fairecasoimeme/Zlinky_TIC/ZLinky/SDK_2_6_4_JN5189DK6/boards/jn5189dk6/demo_apps/hello_world/readme.txt

Overview
========
The Hello World demo application provides a sanity check for the new SDK build environments and board bring up. The Hello
World demo prints the "Hello World" string to the terminal using the SDK UART drivers. The purpose of this demo is to
show how to use the UART, and to provide a simple project for debugging and further development.

Toolchain supported
===================
- IAR embedded Workbench  8.50.6
- MCUXpresso  11.3.0

Hardware requirements
=====================
- Mini USB cable
- OM15076-3 Carrier Board
- JN518x Module plugged on the Carrier Board
- Personal Computer

Board settings
==============
No special settings are required.

Prepare the Demo
================
1.  Connect a mini USB cable between the PC host and the USB port (J15) on the board.
2.  Open a serial terminal with the following settings:
    - 115200 baud rate
    - 8 data bits
    - No parity
    - One stop bit
    - No flow control
3.  Download the program to the target board.
4.  Reset the SoC and run the project.

Running the demo
================
The following lines are printed to the serial terminal when the demo program is executed.
~~~~~~~~~~~~~~~~~~~~~~~~~~~~~~~~~~~~~~~~
hello world.
~~~~~~~~~~~~~~~~~~~~~~~~~~~~~~~~~~~~~~~~

Customization options
=====================
