fairecasoimeme/Zlinky_TIC/ZLinky/SDK_2_6_4_JN5189DK6/boards/jn5189dk6/demo_apps/led_blinky/readme.txt

Overview
========
The LED Blinky demo application provides a sanity check for the new SDK build environments and board bring up. The LED Blinky demo 
uses the systick interrupt to realize the function of timing delay. The example takes turns to shine the LED. The purpose of this 
demo is to provide a simple project for debugging and further development.

Toolchain supported
===================
- IAR embedded Workbench  8.50.6
- MCUXpresso  11.3.0

Hardware requirements
=====================
- Mini USB cable
- OM15076-3 Carrier Board
- OM15082-2 Board plugged on the Carrier Board
- JN518x Module plugged on the Carrier Board
- Personal Computer

Board settings
==============
No special settings are required.

Prepare the Demo
================
1.  Connect a mini USB cable between the PC host and the USB port (J15) on the board.
2.  Open a serial terminal with the following settings:
    - 115200 baud rate
    - 8 data bits
    - No parity
    - One stop bit
    - No flow control
3.  Plug the OM15082-2 Expansion Board onto the Carrier Board.
4.  Download the program to the target board.
5.  Either press the reset button on your board or launch the debugger in your IDE to begin running the demo.

Running the demo
================
When the demo program is executed, the LED DS3 will start flashing.

Customization options
=====================
