fairecasoimeme/Zlinky_TIC/ZLinky/SDK_2_6_4_JN5189DK6/boards/jn5189dk6/driver_examples/cic_irb/readme.txt

Overview
========

The IRB Example project is a demonstration program that uses the Infra-Red Blaster (IRB) peripheral software.
It performs a sequence of sending packets.

Toolchain supported
===================
- IAR embedded Workbench  8.50.6
- MCUXpresso  11.3.0

Hardware requirements
=====================
- Mini USB cable
- OM15076-3 Carrier Board
- JN518x Module plugged on the Carrier Board
- Personal Computer

Board settings
==============
No special settings are required.

Prepare the Demo
================
1.  Connect a mini USB cable between the PC host and the USB port (J15) on the board.
2.  Open a serial terminal with the following settings:
    - 115200 baud rate
    - 8 data bits
    - No parity
    - One stop bit
    - No flow control
3.  Download the program to the target board.
4.  Reset the SoC and run the project.

Running the demo
================
The log below shows example output of the IRB example in the terminal window:
~~~~~~~~~~~~~~~~~~~~~~~~~~~~~~~~~~~~~~~~
IR Blaster example
Sending 10 RC-5 packets...
Packet 1
Packet 2
Packet 3
Packet 4
Packet 5
Packet 6
Packet 7
Packet 8
Packet 9
Packet 10
Bye.
~~~~~~~~~~~~~~~~~~~~~~~~~~~~~~~~~~~~~~~~

Customization options
=====================
