fairecasoimeme/Zlinky_TIC/ZLinky/SDK_2_6_4_JN5189DK6/boards/jn5189dk6/driver_examples/flash/readme.txt

Overview
========
The Flash Example project is to demonstrate usage of the Flash driver.
In this example, we test the flash features: Initialization, erase and programming

Toolchain supported
===================
- IAR embedded Workbench  8.50.6
- MCUXpresso  11.3.0

Hardware requirements
=====================
- Mini USB cable
- OM15076-3 Carrier Board
- JN518x Module plugged on the Carrier Board
- Personal Computer

Board settings
==============
No special settings are required.

Prepare the Demo
================
1.  Connect a mini USB cable between the PC host and the USB port (J15) on the board.
2.  Open a serial terminal with the following settings:
    - 115200 baud rate
    - 8 data bits
    - No parity
    - One stop bit
    - No flow control
3.  Download the program to the target board.
4.  Either press the reset button on your board or launch the debugger in your IDE to begin running the demo.

Running the demo
================
The log below shows example output of the flash_demo driver example in the terminal window:
~~~~~~~~~~~~~~~~~~~~~~~~~~~~~~~~~~~
Internal Flash Test
Flash initialised
Flash erased
Programming 128 words
Flash programmed 128 words
512 bytes verified successfully via direct flash read
512 bytes verified successfully via API flash read
~~~~~~~~~~~~~~~~~~~~~~~~~~~~~~~~~~~

Customization options
=====================
