fairecasoimeme/Zlinky_TIC/ZLinky/SDK_2_6_4_JN5189DK6/boards/jn5189dk6/driver_examples/rtc/readme.txt

Overview
========
The RTC project is a simple demonstration program of the SDK RTC driver. It sets up the RTC
hardware block to trigger an alarm after a user specified time period. The test will set the current
date and time to a predefined value. The alarm will be set with reference to this predefined date
and time.

Toolchain supported
===================
- IAR embedded Workbench  8.50.6
- MCUXpresso  11.3.0

Hardware requirements
=====================
- Mini USB cable
- OM15076-3 Carrier Board
- JN518x Module plugged on the Carrier Board
- Personal Computer

Board settings
==============
No special settings are required.

Prepare the Demo
================
1.  Connect a mini USB cable between the PC host and the USB port (J15) on the board.
2.  Open a serial terminal with the following settings:
    - 115200 baud rate
    - 8 data bits
    - No parity
    - One stop bit
    - No flow control
3.  Download the program to the target board.
4.  Either press the reset button on your board or launch the debugger in your IDE to begin running the demo.

Running the demo
================
The log below shows example output of the RTC driver demo in the terminal window:
~~~~~~~~~~~~~~~~~~~~~~~~~~~~~~~~~~~
RTC example: set up time to wake up an alarm
Current datetime: 2014-12-25 19: 0: 0
Please input the number of second to wait for alarm
The second must be positive value
Alarm will occur at: 2014-12-25 19: 0:40

 Alarm occurs !!!! Current datetime: 2014-12-25 19: 0:41
Please input the number of second to wait for alarm
The second must be positive value

~~~~~~~~~~~~~~~~~~~~~~~~~~~~~~~~~~~

Customization options
=====================
