fairecasoimeme/Zlinky_TIC/ZLinky/SDK_2_6_4_JN5189DK6/boards/jn5189dk6/rtos_examples/freertos_event/readme.txt

Overview
========
This document explains the freertos_event example. It shows how task waits for an event (defined set
of bits in event group). This event can be set by any other process or interrupt in the system.

The example application creates three tasks. Two write tasks write_task_1 and write_task_2
continuously setting event bit 0 and bit 1.

Read_task is waiting for any event bit and printing actual state on console. Event bits are
automatically cleared after read task is entered.

Three possible states can occurre:
Both bits are set.z
Bit B0 is set.
Bit B1 is set.

Toolchain supported
===================
- IAR embedded Workbench  8.50.6
- MCUXpresso  11.3.0

Hardware requirements
=====================
- Mini USB cable
- OM15076-3 Carrier Board
- JN518x Module plugged on the Carrier Board
- Personal Computer

Board settings
==============
No special settings are required.

Prepare the Demo
================
1.  Connect a mini USB cable between the PC host and the USB port (J15) on the board.
2.  Open a serial terminal with the following settings:
    - 115200 baud rate
    - 8 data bits
    - No parity
    - One stop bit
    - No flow control
3.  Download the program to the target board.
4.  Reset the SoC and run the project.

Running the demo
================
After the board is flashed the Tera Term will start printing the state of event bits.

Example output:
Bit B1 is set.
Bit B0 is set.
Bit B1 is set.
Bit B0 is set.
Bit B1 is set

Customization options
=====================
