fairecasoimeme/Zlinky_TIC/ZLinky/SDK_2_6_4_JN5189DK6/boards/jn5189dk6/rtos_examples/freertos_generic/readme.txt

Overview
========

This document explains the freertos_generic example. It is based on code FreeRTOS documentation from
http://www.freertos.org/Hardware-independent-RTOS-example.html. It shows combination of several
tasks with queue, software timer, tick hook and semaphore.

The example application creates three tasks. The prvQueueSendTask periodically sending data to
xQueue queue. The prvQueueReceiveTask is waiting for incoming message and counting number of
received messages. Task prvEventSemaphoreTask is waiting for xEventSemaphore semaphore given from
vApplicationTickHook. Tick hook give semaphore every 500 ms.

Other hook types used for RTOS and resource statistics are also demonstrated in example:
* vApplicationIdleHook
* vApplicationStackOverflowHook
* vApplicationMallocFailedHook

Toolchain supported
===================
- IAR embedded Workbench  8.50.6
- MCUXpresso  11.3.0

Hardware requirements
=====================
- Mini USB cable
- OM15076-3 Carrier Board
- JN518x Module plugged on the Carrier Board
- Personal Computer

Board settings
==============
No special settings are required.

Prepare the Demo
================
1.  Connect a mini USB cable between the PC host and the USB port (J15) on the board.
2.  Open a serial terminal with the following settings:
    - 115200 baud rate
    - 8 data bits
    - No parity
    - One stop bit
    - No flow control
3.  Download the program to the target board.
4.  Reset the SoC and run the project.

Running the demo
================
After the board is flashed the Tera Term will start periodically printing the state of generic example.

Example output:
Event task is running.
Receive message counter: 1.
Receive message counter: 2.
Receive message counter: 3.
Receive message counter: 4.
Receive message counter: 5.
Receive message counter: 6.
Receive message counter: 7.
Receive message counter: 8.
Receive message counter: 9.
Receive message counter: 10.
Receive message counter: 11.
Receive message counter: 12.
Event task is running.
Receive message counter: 13.
Receive message counter: 14.
...

Customization options
=====================
