fairecasoimeme/Zlinky_TIC/ZLinky/SDK_2_6_4_JN5189DK6/boards/jn5189dk6/rtos_examples/freertos_hello/readme.txt

Overview
========
The Hello World project is a simple demonstration program that uses the SDK UART driver in
combination with FreeRTOS. The purpose of this demo is to show how to use the debug console and to
provide a simple project for debugging and further development.

The example application creates one task called hello_task. This task print "Hello world." message
via debug console utility and suspend itself.

Toolchain supported
===================
- IAR embedded Workbench  8.50.6
- MCUXpresso  11.3.0

Hardware requirements
=====================
- Mini USB cable
- OM15076-3 Carrier Board
- JN518x Module plugged on the Carrier Board
- Personal Computer

Board settings
==============
No special settings are required.

Prepare the Demo
================
1.  Connect a mini USB cable between the PC host and the USB port (J15) on the board.
2.  Open a serial terminal with the following settings:
    - 115200 baud rate
    - 8 data bits
    - No parity
    - One stop bit
    - No flow control
3.  Download the program to the target board.
4.  Reset the SoC and run the project.

Running the demo
================
After the board is flashed the Tera Term will print "Hello world" message on terminal.

Example output:
Hello world.

Customization options
=====================
