fairecasoimeme/Zlinky_TIC/ZLinky/SDK_2_6_4_JN5189DK6/boards/jn5189dk6/rtos_examples/freertos_queue/readme.txt

Overview
========

This document explains the freertos_queue example. This example introduce simple logging mechanism
based on message passing.

Example could be divided in two parts. First part is logger. It contain three tasks:
log_add().....Add new message into the log. Call xQueueSend function to pass new message into
              message queue.
log_init()....Initialize logger (create logging task and message queue log_queue).
log_task()....Task responsible for printing of log output.

Second part is application of this simple logging mechanism. Each of two tasks write_task_1 and
write_task_2 print 5 messages into log.

Toolchain supported
===================
- IAR embedded Workbench  8.50.6
- MCUXpresso  11.3.0

Hardware requirements
=====================
- Mini USB cable
- OM15076-3 Carrier Board
- JN518x Module plugged on the Carrier Board
- Personal Computer

Board settings
==============
No special settings are required.

Prepare the Demo
================
1.  Connect a mini USB cable between the PC host and the USB port (J15) on the board.
2.  Open a serial terminal with the following settings:
    - 115200 baud rate
    - 8 data bits
    - No parity
    - One stop bit
    - No flow control
3.  Download the program to the target board.
4.  Reset the SoC and run the project.

Running the demo
================
After the board is flashed the Tera Term will show debug console output.

Example output:
Log 0: Task1 Message 0
Log 1: Task2 Message 0
Log 2: Task1 Message 1
Log 3: Task2 Message 1
Log 4: Task1 Message 2
Log 5: Task2 Message 2
Log 6: Task1 Message 3
Log 7: Task2 Message 3
Log 8: Task1 Message 4
Log 9: Task2 Message 4

Customization options
=====================
