fairecasoimeme/Zlinky_TIC/ZLinky/SDK_2_6_4_JN5189DK6/boards/jn5189dk6/driver_examples/usart/hardware_flow_control/readme.txt

Overview
========
The usart_hardware_flow_control example project demonstrates the usage
of the hardware flow control function. This example sends data to itself(loopback),
and hardware flow control is enabled in the example. The CTS(clear-to-send)
pin is for transmiter to check if receiver is ready, if the CTS pin is asserted,
transmiter starts to send data. The RTS(request-to-send) pin is for receiver
to inform the transmiter if receiver is ready to receive data. So, please connect
RTS to CTS pin directly.

Toolchain supported
===================
- IAR embedded Workbench  8.50.6
- MCUXpresso  11.3.0

Hardware requirements
=====================
- Mini USB cable
- OM15076-3 Carrier Board
- JN518x Module plugged on the Carrier Board
- Personal Computer
- USB-TTL interface module

Board settings
==============
USART hardware flow control on one board.
The USART sends data to itself(loopback), and hardware flow control function is
enabled on this example. So please make sure the correct connection for example.
~~~~~~~~~~~~~~~~~~~~~~~~~~~~~~~~~~~~~~~~~~~~~~~~~~~~~~~~~~~~~~~~~~~~~~~~~~~~~~~~~~~~~~~~~
Pin Name    Board Location    connect to     Pin Name    Board Location
USART_TX    J3   Pin 10       ----------     USART_RX    J3   pin 9
USART_CTS   J3   Pin 14       ----------     USART_RTS   J3   Pin 13
~~~~~~~~~~~~~~~~~~~~~~~~~~~~~~~~~~~~~~~~~~~~~~~~~~~~~~~~~~~~~~~~~~~~~~~~~~~~~~~~~~~~~~~~~

Prepare the Demo
================
1.  Connect a mini USB cable between the PC host and the USB port (J15) on the board.
2.  Connect Dupont Lines between USB-TTL interface module and the board, the line connections are:
USB-TTL RXD connects to CN1-5, USB-TTL TXD connects to CN1-6.
3.  Open a serial terminal to USB-TTL port with the following settings:
    - 115200 baud rate
    - 8 data bits
    - No parity
    - One stop bit
    - No flow control
4.  Download the program to the target board.
5.  Reset the SoC and run the project.

Running the demo
================
The following lines are printed to the serial terminal when the demo program is executed.

~~~~~~~~~~~~~~~~~~~~~~~~~~~~~~~~~~~~~~~~
This is USART hardware flow control example on one board.
This example will send data to itself and will use hardware flow control to avoid the overflow.
Please make sure you make the correct line connection. Basically, the connection is:
      USART_TX    --     USART_RX
      USART_RTS   --     USART_CTS
Data matched! Transfer successfully.
~~~~~~~~~~~~~~~~~~~~~~~~~~~~~~~~~~~~~~~~
Customization options
=====================
