fairecasoimeme/Zlinky_TIC/ZLinky/SDK_2_6_4_JN5189DK6/boards/jn5189dk6/driver_examples/ctimer/simple_match_interrupt/readme.txt

Overview
========
The Simple Match Interrupt project is to demonstrate usage of the SDK CTimer driver with interrupt callback functions
In this example the upon match and IO pin connected to the LED is toggled and the timer is reset, so it would generate a square wave.
With an interrupt callback the match value is changed frequently in such a way that the frequency of the output square wave is increased gradually.

Toolchain supported
===================
- IAR embedded Workbench  8.50.6
- MCUXpresso  11.3.0

Hardware requirements
=====================
- Mini USB cable
- OM15076-3 Carrier Board
- JN518x Module plugged on the Carrier Board
- Personal Computer

Board settings
==============
No special settings are required.

Prepare the Demo
================
1.  Connect a mini USB cable between the PC host and the USB port (J15) on the board.
2.  Open a serial terminal with the following settings:
    - 115200 baud rate
    - 8 data bits
    - No parity
    - One stop bit
    - No flow control
3.  Download the program to the target board.
4.  Either press the reset button on your board or launch the debugger in your IDE to begin running the demo.

Running the demo
================
The log below shows example output of the CTimer simple match demo using interrupts in the terminal window:
~~~~~~~~~~~~~~~~~~~~~~~~~~~~~~~~~~~
CTimer match example to toggle the output.
This example uses interrupt to change the match period.
~~~~~~~~~~~~~~~~~~~~~~~~~~~~~~~~~~~

Customization options
=====================
