fairecasoimeme/Zlinky_TIC/ZLinky/SDK_2_6_4_JN5189DK6/boards/jn5189dk6/driver_examples/gpio/led_output/readme.txt

Overview
========
The GPIO Example project is a demonstration program that uses the KSDK software to manipulate the general-purpose
outputs. The example use LEDs and buttons to demonstrates GPIO API for port and pin manipulation (init, set,
clear, and toggle).

Toolchain supported
===================
- IAR embedded Workbench  8.50.6
- MCUXpresso  11.3.0

Hardware requirements
=====================
- Mini USB cable
- OM15076-3 Carrier Board
- JN518x Module plugged on the Carrier Board
- Personal Computer

Board settings
==============
No special settings are required.

Prepare the Demo
================
1.  Connect a mini USB cable between the PC host and the USB port (J15) on the board.
2.  Open a serial terminal with the following settings:
    - 115200 baud rate
    - 8 data bits
    - No parity
    - One stop bit
    - No flow control
3.  Download the program to the target board.
4.  Either press the reset button on your board or launch the debugger in your IDE to begin running the demo.

Running the demo
================
The following lines are printed to the serial terminal when the demo program is executed.
Depending on the BP1 button you press the value is changing.

~~~~~~~~~~~~~~~~~~~~~~~~~~~~~~~~~~~~~~~~
 GPIO Driver example

 The LED is taking turns to shine.

 Standard port read: 257ffb

 Masked port read: 250000

 Port state: 257ff9

 Port state: 217ff1

 Port state: 25fff9

 Port state: 217ff1
 ...
~~~~~~~~~~~~~~~~~~~~~~~~~~~~~~~~~~~~~~~~
When press BP1 on OM15076-3 Carrier Board, the LED DS3 will start flashing

Customization options
=====================
