fairecasoimeme/Zlinky_TIC/ZLinky/SDK_2_6_4_JN5189DK6/boards/jn5189dk6/driver_examples/i2c/dma_transfer/readme.txt

Overview
========
The i2c_dma example shows how to use I2C driver in DMA way:

In this example , one i2c instance used as I2C master and another i2c instance used as I2C slave .
1. I2C master send data to I2C slave with DMA . (I2C Slave using interrupt to receive the data)
2. I2C master read data from I2C slave with DMA . (I2C Slave using interrupt to send the data)

Toolchain supported
===================
- IAR embedded Workbench  8.50.6
- MCUXpresso  11.3.0

Hardware requirements
=====================
- Mini USB cable
- OM15076-3 Carrier Board
- JN518x Module plugged on the Carrier Board
- Personal Computer

Board settings
==============
To make i2c example work, connections needed to be as follows:

        I2C              connected to     I2C0
SCL     PIO_6(J3 pin13)        -->        PIO_10(J3 pin17)
SDA     PIO_7(J3 pin14)        -->        PIO_11(J3 pin18)

Prepare the Demo
================
1.  Connect a mini USB cable between the PC host and the USB port (J15) on the board.
2.  Open a serial terminal with the following settings:
   - 115200 baud rate
   - 8 data bits
   - No parity
   - One stop bit
   - No flow control
3. Download the program to the target board.
4. Either press the reset button on your board or launch the debugger in your IDE to begin running
   the demo.

Running the demo
================
The following message shows in the terminal if the example runs successfully.

~~~~~~~~~~~~~~~~~~~~~~~~~~~~
I2C example -- MasterDMA_SlaveInterrupt.
Master will send data :
0x 0  0x 1  0x 2  0x 3  0x 4  0x 5  0x 6  0x 7
0x 8  0x 9  0x a  0x b  0x c  0x d  0x e  0x f
0x10  0x11  0x12  0x13  0x14  0x15  0x16  0x17
0x18  0x19  0x1a  0x1b  0x1c  0x1d  0x1e  0x1f

Slave received data :
0x 0  0x 1  0x 2  0x 3  0x 4  0x 5  0x 6  0x 7
0x 8  0x 9  0x a  0x b  0x c  0x d  0x e  0x f
0x10  0x11  0x12  0x13  0x14  0x15  0x16  0x17
0x18  0x19  0x1a  0x1b  0x1c  0x1d  0x1e  0x1f

This time , slave will send data: :
0xff  0xfe  0xfd  0xfc  0xfb  0xfa  0xf9  0xf8
0xf7  0xf6  0xf5  0xf4  0xf3  0xf2  0xf1  0xf0
0xef  0xee  0xed  0xec  0xeb  0xea  0xe9  0xe8
0xe7  0xe6  0xe5  0xe4  0xe3  0xe2  0xe1  0xe0

Master received data :
0xff  0xfe  0xfd  0xfc  0xfb  0xfa  0xf9  0xf8
0xf7  0xf6  0xf5  0xf4  0xf3  0xf2  0xf1  0xf0
0xef  0xee  0xed  0xec  0xeb  0xea  0xe9  0xe8
0xe7  0xe6  0xe5  0xe4  0xe3  0xe2  0xe1  0xe0

End of I2C example .
~~~~~~~~~~~~~~~~~~~~~~~~~~~~

Customization options
=====================
