fairecasoimeme/Zlinky_TIC/ZLinky/SDK_2_6_4_JN5189DK6/boards/jn5189dk6/driver_examples/usart/interrupt_transfer/readme.txt

Overview
========
The usart_interrupt_transfer example shows how to use usart driver in interrupt way:

In this example, one usart instance connect to PC through usart, the board will
send back all characters that PC send to the board.

Note: The example echo every 8 characters, so input 8 characters every time.

Toolchain supported
===================
- MCUXpresso  11.3.0
- IAR embedded Workbench  8.50.6

Hardware requirements
=====================
- Mini USB cable
- OM15076-3 Carrier Board
- JN518x Module plugged on the Carrier Board
- Personal Computer

Board settings
==============
No special settings are required.

Prepare the Demo
================
1.  Connect a mini USB cable between the PC host and the USB port (J15) on the board.
2.  Open a serial terminal with the following settings:
    - 115200 baud rate
    - 8 data bits
    - No parity
    - One stop bit
    - No flow control
3.  Download the program to the target board.
4.  Reset the SoC and run the project.

Running the demo
================
The following lines are printed to the serial terminal when the demo program is executed.
~~~~~~~~~~~~~~~~~~~~~~~~~~~~~~~~~~~~~~~~
Usart interrupt example
Board receives 8 characters then sends them out
Now please input:
~~~~~~~~~~~~~~~~~~~~~~~~~~~~~~~~~~~~~~~~
When you input 8 characters, system will echo it by UART and them would be seen on the terminal.

Customization options
=====================
