fairecasoimeme/Zlinky_TIC/ZLinky/SDK_2_6_4_JN5189DK6/boards/jn5189dk6/wireless_examples/zigbee/zigbee_coordinator/readme.txt

Overview
========
This application represents the "Zigbee coordinator" of the Zigbee Stack Demo Applications.

Toolchain supported
===================
- MCUXpresso IDE

Hardware requirements
=====================
- Mini/micro USB cable
- DK6 board
- Personal Computer

Board settings
==============
No special board setting.

Prepare the Demo
================
1.  Connect a mini/micro USB cable between the PC host and the OpenSDA USB port on the board.
2.  Download the program to the target board.
3.  Press the reset button, then any other switch button on your board to begin running the demo.

Running the demo
================
