fairecasoimeme/Zlinky_TIC/Doc/Images/back_linky_triphase.jpg

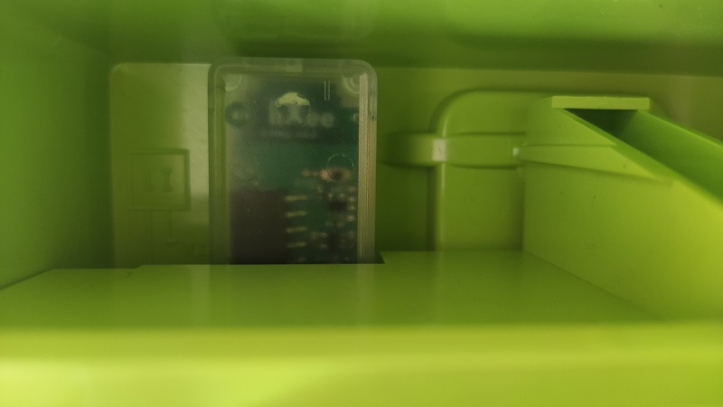
Doc/Images/back_linky_triphase.jpg
