fairecasoimeme/Zlinky_TIC/Doc/Images/front_linky_triphase.jpg

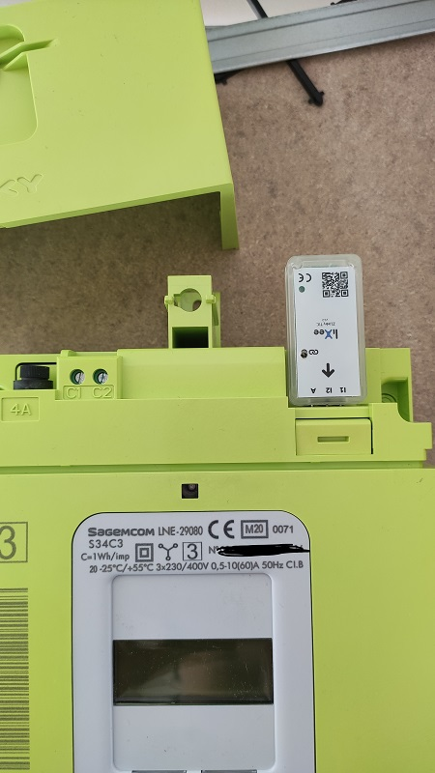
Doc/Images/front_linky_triphase.jpg
