fairecasoimeme/Zlinky_TIC/Doc/Images/manuel_LED_cycle_error.png

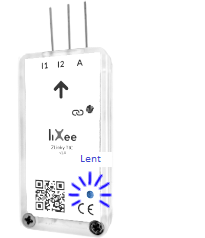
Doc/Images/manuel_LED_cycle_error.png
