fairecasoimeme/Zlinky_TIC/Doc/Images/manuel_LED_No_JOIN.png

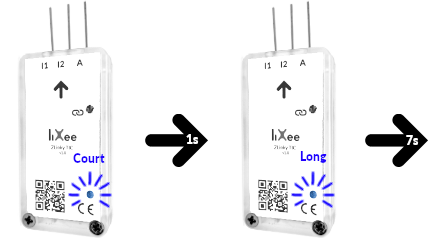
Doc/Images/manuel_LED_No_JOIN.png
