fairecasoimeme/Zlinky_TIC/Doc/Images/update_ZLinky_TIC_3.jpg

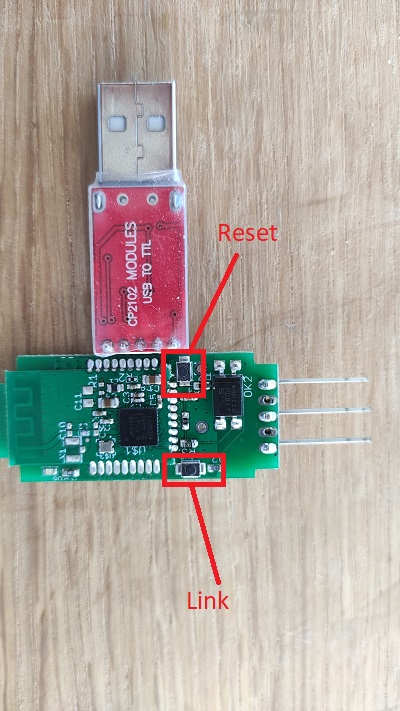
Doc/Images/update_ZLinky_TIC_3.jpg
