fairecasoimeme/Zlinky_TIC/Doc/Images/installation_ZLinky_TIC.png

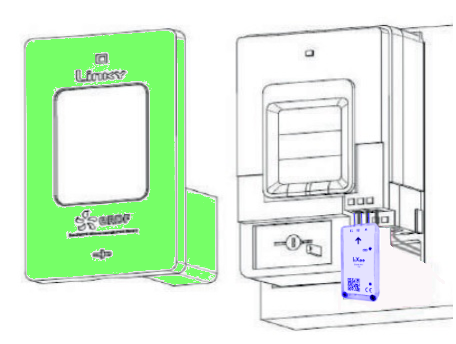
Doc/Images/installation_ZLinky_TIC.png
