fairecasoimeme/Zlinky_TIC/(threads)

Thread 13 (2021-09-28):

Cluster 0x0004 and 0x0005 reported

pipiche38, 2021-09-28:
Is there any particular reason why Group and Scene clusters are available ? ( At least they are reported via a EndPoint descriptor request )

fairecasoimeme, 2021-09-28:
No reason, I will filter and cancel this cluster

pipiche38, 2021-10-31:
Still reported on lateste firmware

fairecasoimeme, 2021-11-02:
Not on the new firmware in release section

Type: 0x8043 (Simple Descriptor Response)
  SQN: 0x88
  Status: 0x00
  Short Address: 0x0F7E
  Length: 22
  EndPoint: 0x01
  Profile ID: 0x0104 (ZigBee HA)
  Device ID: 0x0053 (Unknown)
  Input Cluster Count: 6
    Cluster 0:  Cluster ID: 0x0000 (General: Basic)
    Cluster 1:  Cluster ID: 0x0003 (General: Identify)
    Cluster 2:  Cluster ID: 0x0702 (Smart Energy: Metering)
    Cluster 3:  Cluster ID: 0x0B04 (Unknown)
    Cluster 4:  Cluster ID: 0x0B01 (Unknown)
    Cluster 5:  Cluster ID: 0xFF66 (Unknown)
  Output Cluster Count: 1
    Cluster 0:  Cluster ID: 0x0019 (General: OTA)

Closed 2021-11-02.

Thread 14 (2021-11-01):

ZLinky is not issuing a Device Annoucement after a Power Off/On

pipiche38, 2021-11-01:
As stated in the Title when power Off/On of the ZLinky there is no device annoucement !

fairecasoimeme, 2021-11-02:
This is normal on new firmware mode router because this function is only for device with zigbee 3.0.

[JN-UG-3114.pdf](https://www.google.com/url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)

Page 20

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

Normally ZLinky can't do a power off/on because it is alimented by general counter. Unlike devices, ZLinky should not be moved. If counter is down coordinator is down too. For me, rejoin on power off/on is not useful.

If really, there is a need, we have to implement on button push but I don't know if it's possible yet

pipiche38, 2021-11-02:
this deviate from the ZB3.0 devices I have seen so far like Legrand-Netatmo

fairecasoimeme, 2021-11-02:
To my knowledge they are the only ones who do. But why not. I wonder what is the use

pipiche38, 2021-11-02:
Up to now, ZLinky is the first router not issuing a Device Annoucement after a Power Off/On

fairecasoimeme, 2021-11-02:
however for tuya routers like the QS-Zigbee-C0, this is the case.

pipiche38, 2021-11-02:
I would not use Tuya as a reference. but as it is documented I have close the issue

fairecasoimeme, 2021-11-02:
unfortunately, we cannot say either that Legrand is uncompromising on the standard. the real question is to know what is the usefulness of this function.

to force a DEVICE ANNOUNCE with a REJOIN, we can use the leave function of the coordinator (E_SL_MSG_LEAVE_REQUEST)

pipiche38, 2021-11-02:
For me the feature is very simple, it will allow to know that the router has been out of the network a while, since we get a Device Annoucement when powered on.
As you stated it is expected that the ZLinky is always on. However during the test, if I'm recall correctly we have seen the ZLinky having Device Annoucement (when it was configured as a End Device )

Closed 2021-11-02.

Thread 16 (2021-11-04):

intégration à HA

chpego, 2021-11-04:
Bonjour,

Qu'avez-vous besoin pour effectuer l'intégration dans HA ?
Je possède la solution, avec une clé ConBee II , je vois bien le ZLinky_TIC dans la carte réseau des appareils zigbe, mais deconz n'arrive pas à l'appairer.

Je pense qu'il faudrait ajouter l'appareil dans la liste "supportés" https://github.com/dresden-elektronik/deconz-rest-plugin/wiki/Request-Device-Support , non ?

max5962, 2021-11-05:
Avec la Zigate, j'arrive à l'appareiller avec ZHA ( sur home assistant )  et j'ai ça comme sensor :

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

Pour être franc, je sais pas trop quoi en faire.
J'ai vu que ça se comportait comme un routeur d'après ZHA, donc même si pour le moment c'est pas fonctionnel ça fiabilise mon réseau :)

chpego, 2021-11-06:
Ouverture d'une demande de support ici https://github.com/dresden-elektronik/deconz-rest-plugin/issues/5459

capi92, 2021-11-06:
L’intégration au réseau zigbee ne fonctionne pas non plus sous zigbee2mqtt..

fairecasoimeme, 2021-11-06:
There is a guy who work on this: http://twitter.com/ralmn45.
@ralmn

ralmn, 2021-11-06:
Pour Zigbee2MQTT j'ai fait une 1ere version : https://gist.github.com/ralmn/02de46e193bf111062f15be07d3e9bd2 J'attends un peu avant de la proposer pour quelle soit intégré officiellement. Le temps d'y rajouter plus d'info si besoin.

I do a first version of zigbee2mqtt integration  : https://gist.github.com/ralmn/02de46e193bf111062f15be07d3e9bd2
I'm waiting before proposing it to be officially integrated. Time to add more info if needed.

Rodka08, 2021-11-21:
> Ouverture d'une demande de support ici [dresden-elektronik/deconz-rest-plugin#5459](https://github.com/dresden-elektronik/deconz-rest-plugin/issues/5459)

Bonsoir @chpego, je suis votre demande de support et je suis novice, je possède la même solution que vous et j’ai vu que vous avez réussi à modifier le general.xml mais je ne parvient pas à l’envoyer sur la clé Conbee 2 via le vnc deconz sur ha… ? Avez-vous une solution à me proposer ?

Je constate également que le firmware de la clé ne nous permet pas d’intégrer le zlinky dans ha si j’ai bien compris? 😅

En vous remerciant d’avance et en vous souhaitant une bonne soirée.

chpego, 2021-11-21:
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

Oui, j'ai pu intégrer le fichier general.xml.
En fait, j'ai créé le fichier et l'ai déposer dans le partage samba de HA. Ensuite, il suffit de se connecter en tant que root sous SSH , et de faire une copie du fichier entre le répertoire du partage samba et le répertoire où tourne le docker deconz (**/mnt/data/supervisor/addons/data/core_deconz**).

En l'état non, on ne peut pas l'intégrer dans la version de deconz, mais ça devrait venir, sinon j'invite @AdrienBigot à nous paratger les dernières informations ;)

AdrienBigot, 2021-11-21:
Salut,

J'ai reussi à intégrer dans HomeAssistant une certaine partie grace à l'utilisation des DDF. Mais pour cela il faut être dans une des dernières version de deCONZ.
Pour le moment on ne peut pas tout faire via les DDF et cette feature est en version beta donc elle se désactive à chaque redémarrage de deCONZ.
Je n'ai pour le moment par exemple pas pu intégrer le Cluster spécifique LiXee qui contient certains attributs comme : l'option tarifaire, les horaires HP/HC, l'avertissement de dépassement de puissance souscrite etc ....

Aussi, le binding fait via les DDF n'est pas généric car il y a plusieurs combinaisons possibles d'abonnements et type d'installation. Par exemple je suis sur un compteur monophasé avec un abonnement base (sans HP/HC) et une puissance de 6kVA.
Chez moi la récupération de la valeur de l'index compteur se fait via le cluster 0x0702 sur l'attribut 0x0000 mais pour une personne avec un abonnement Heure pleines /  heures creuses il faudra interroger les attributs 0x0100 et 0x0102.

Ce n'est qu'un exemple et à ce titre @Smanar m'a averti qu'il faudrait au final toucher au code plutôt que de passer par les DDF :

> And we will have a problem too, the device is easy to make it working, it s zigbee compliant. But according to the contract or the mode (historical/standard), bind and report will not be the same.
IDK if tis will be possible without touching the c++ code.

@ suivre ici : https://github.com/dresden-elektronik/deconz-rest-plugin/issues/5459

Voici une capture d'un test sur le dashboard Home Assistant.

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

chpego, 2021-12-22:
On progresse, je viens d'ajouter, via le travail d'@AdrienBigot , une partie des informations du compteur ... voir [ici](https://github.com/dresden-elektronik/deconz-rest-plugin/issues/5459#issuecomment-999224084)

AdrienBigot, 2021-12-22:
Par contre, il faut préciser que rien n'est magique pour le moment. Il faut modifier le fichier general.xml à la mano dans le container et ajouter le fichier DDF également soit en le deposant soit via l'interface GUI.
Pour le fichier general.xml il n'est question que de quelques jours le temps que la PR soit validée mais pour le fichier DDF il faudrait que les mainteneurs de l'intégration offrent la possibilité de déposer le fichier directement via l'interface de configuration de l'intégration deCONZ.
Etant donné qu'ils viennent de mettre à jour l'intégration avec la dernière version de deCONZ, je pense que c'est dans les cartons. Je vais voir si on peut ouvrir une feature request à ce sujet .

AdrienBigot, 2021-12-22:
Ha et bien voilà : https://github.com/home-assistant/addons/issues/2272

Il faudrait rajouter un petit :+1:  pour reveiller cette feature request s'il vous plaît :)

chpego, 2021-12-22:
C'est fait 👍

AdrienBigot, 2021-12-23:
BOn et bien ticket fermé car ce n'est pas une issue.
La feature request a été ouverte ici et nécessite un petit pouce :+1:    svp  :-D   : https://community.home-assistant.io/t/deconz-support-management-of-ddf-files-through-ha-config/370331

Merci

WatermelonFox, 2022-04-01:
Bonjour à tous,
Je suis carrément néophyte avec HA et deconz (conbee2), vous utilisez deconz dans un container docker (https://github.com/deconz-community/deconz-docker) ?
J'ai du mal à comprendre où faire les ajustements mano pour réussir à appairer ma ZLinky_TIC à deconz pour ensuite l'intégrer dans HA 😨
Una âme généreuse voudrait-elle bien donner de son temps pour expliquer comment jouer avec tout ça?

Smanar, 2022-04-01:
Ici tu as quelqu'un qui cherchait le repertoire ou installer le DDF avec HA https://github.com/dresden-elektronik/deconz-rest-plugin/issues/5459#issuecomment-1019496135

Par contre, pour le moment il y a plusieurs DDF, pour le mode standard/historique, normal ou HP/HC, production ou pas, triphasé ou pas

Un autre source d'infos https://forum.phoscon.de/t/lixee-zlinky-tic-ddf-file/1164

WatermelonFox, 2022-04-06:
J'ai installé le DDF dans mon dossier devices/generic et il semble bien être utilisé/reconnu par deCONZ car il est visible dans deCONZ en novnc cependant il n'est pas reconnu dans l'interface "phoscon app", j'ai tenté de le ré-appairer plusieurs fois et de redémarrer la clef, le conteneur, etc mais rien ne semble y faire, est-ce qu'il me manque quelque chose?
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

WatermelonFox, 2022-04-06:
Merci pour la réponse rapide encore une fois!
C'était visiblement déjà au bon endroit, j'ai enregistré depuis le noVNC et la date de modification de mon fichier a bien été rafraichi.
Je l'ai passé au status "Gold" comme indiqué puis ai effectué un "Hot reload" et là ça a bien changé mon node à un "Power 16"!
Merci pour ton assistance ❤️

Smanar, 2022-04-06:
De rien, et il y a un post pour cet appareil sur le forum de phoscon si tu t'ennuis ^^.
On est en retard sur les autres projets zigbee, la on va rajouter le compteur pour la production et on fignole le HP/HC.

mverove, 2022-04-20:
Bonjour,

Est-ce qu'il est possible d'uploader le fichier .ddf depuis l'interface VNC ? Sur Raspberry, il faut brancher un clavier et un écran pour accéder à la console... pas simple.

Autre question: ma version de deconz est la 6.12.0 dans mon instance HomeAssistant.
Est-ce que vous savez s'il prévu d'intégrer la reconnaissance "automatique" du zlinky dans une prochaine version de deconz ?

D'avance, merci !

Smanar, 2022-04-20:
Tu veux dire SSH ? De mon coté je n'utilise ni clavier, ni écran, que ce soit pour le SSH, le VNC ou le mode desktop.
Alors oui en theorie c'est possible, il y en a qui l'ont deja fait https://github.com/dresden-elektronik/deconz-rest-plugin/issues/5459#issuecomment-1019501674
Mais bizarrement les repertoires changent d'un utilisateur a l'autre et la je n'y connais rien en docker pour aider. Si tu sais comment creer/editer un fichier, pas de soucis pour toi.

>Est-ce que vous savez s'il prévu d'intégrer la reconnaissance "automatique" du zlinky dans une prochaine version de deconz ?

Mince j'ai encore oublié, je les met en PR de suite, mais par contre, il y en a plusieurs, du coup il sont desactivés et ce sera a toi d'activer celui dont tu as besoin, via le VNC (editeur) ou le SSH (editeur de texte), en fonction du contrat, du mode, ect ...

mverove, 2022-04-20:
J'ai accès en ssh à mon instance HA mais dans la version que j'ai (la seule à l'époque documentée pour rasp), on a accès directement au container, pas au système "hôte".
Je pense que c'est pour cette raison que plusieurs personnes ont des répertoires différents (s'ils accèdent à l'hôte, dans le volume monté par le container docker suivant où il est monté depuis l'hôte, etc...).

Il faudrait que je puisse, depuis le container, me connecter au système mais quand je fais un ssh vers l'IP de l'hôte depuis le container:
```
[core-ssh share]$ ssh homeassistant@172.30.32.1
homeassistant@172.30.32.1: Permission denied (publickey,keyboard-interactive).
[core-ssh share]$
```
> Mince j'ai encore oublié, je les met en PR de suite, mais par contre, il y en a plusieurs, du coup il sont desactivés et ce sera a toi d'activer celui dont tu as besoin, via le VNC (editeur) ou le SSH (editeur de texte), en fonction du contrat, du mode, ect ...

Pas de souci, je choisirai celui qui correspond à mon contrat. Au passage, je veux bien le lien vers ta PR. Merci !

Smanar, 2022-04-20:
Le PR https://github.com/dresden-elektronik/deconz-rest-plugin/pull/5969
Mais seul les 2 "base" sont fonctionnels nativement, pour le HP/HC il fonctionne aussi, mais la personne a utilisé une astuce qui va changer a la prochaine stable, l'avantage c'est que du coup pour le moment le support est natif sur HA.
Pour le triphasé/production on attend que HA incorpore la future stable de deconz pour les tests.

Désolé du hors sujet, mais si tu réussis a t'en sortir avec HA et le SSH, j'ai lancé une bouteille a la mer ici https://forum.phoscon.de/t/how-to-add-edit-a-ddf-on-ha-using-text-editor/1839

mverove, 2022-05-06:
Bonjour à tou.te.s,

Merci @Smanar , grâce à ton post et la réponse apportée, j'ai réussi à pousser le fichier DDF [zlinky_tic_historique_mono_base.json](https://github.com/dresden-elektronik/deconz-rest-plugin/pull/5969/files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) sur le host de mon instance HA (Raspberry).

Je peux voir mon Zlinky dans Deconz:
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
J'ai fait un clic droit pour faire un _edit DDF_:
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
Puis ouvert le fichier .json que je venais de pousser:
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
Je n'ai pas trouvé comment on enregistrer pour prise en compte.

Ensuite, j'ai redémarré mon mondule Deconz au travers de mon HA GUI mais je me retrouve toujours avec:
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

Est-que j'ai oublié quelque chose ?

Smanar, 2022-05-06:
Oui ^^. Les fichiers DDFs pour cet appareils sont desactivés pour le moment. Le status est en "Draft".
Il te faut passer le fichier DDF en "Gold", soit via l'editeur de DDF soit avec un simple editeur de texte

`"status": "Draft",` a passer en `"status": "Gold",`

En le passant en gold, quelque soit tes réglages il se sera obligatoirement choisit, donc deconz va la reconnaitre directement au prochain demarrage ou apres le "hot relaod".

Le nom du node va passer de 0xXXXX a quelque chose de plus concret, et si tu fais "edit DDF" tu vas revoir ton fichier.

Dans la barre de titre tu vas retrouver le chemin et le nom du fichier.

mverove, 2022-05-06:
Pas de souci !!
Merci pour ton retour ! En suivant ta procédure, ça fonctionne !!!

Nickel !! Merci beaucoup.

Pour info, après avoir redémarré le module:
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
Reconnu via Phoscon:
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
Mis en dashboard (faut que je l'améliore ;-)):
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
Encore merci !!!

StephanGR, 2022-05-22:
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

Aurais-tu la possibilité de me partager ton fichier de conf ?

Merci

AdrienBigot, 2022-06-10:
Salut,

Juste pour être sûr, quand tu dis que tu te connectes en SSH, c'est à quoi que tu te connectes ? A ton raspbery qui possèdes le dongle raspbee II ? A ton HomeAssitant ?

Une question peut être bête mais on sait jamais , le dossier .local est un dossier caché. Un simple 'ls' ne suffit pas tu fais bien un 'ls -a' ?

Ton problème est peut être aussi lié au fait que que tu ne cherches pas au bon endroit. Le dossier .local se trouve dans le home directory de l'utilisateur avec lequel tourne deconz.
Chez moi deconz tourne avec l'utilisateur pi, et non pas en root. Donc le chemin est :
```shell
pi@raspi-garage:~/.local/share/dresden-elektronik/deCONZ $ pwd
/home/pi/.local/share/dresden-elektronik/deCONZ`

Smanar, 2022-06-10:
Si tu es sous HA, ca peut t'aider https://forum.phoscon.de/t/how-to-add-edit-a-ddf-on-home-assistant-using-text-editor/1839

tatawi, 2022-06-10:
Je me connecte via le terminal web du module complémentaire ssh & terminal.
Je faisais bien un ls -a .
Par contre effectivement , je ne me connecte pas pour le coup avec le bon compte.

Je vais regarder ça.
Pour le moment en tout cas, zha a reconnu le zlinky après un redémarrage donc j'ai bien les éléments qui remontent.
Mes capteurs avec deconz et zlinky avec zha. Ça va sûrement devenir ma solution en attendant que ce soit intégré et reconnu par phoscon.

Merci pour l'aide

Téléchargez Outlook pour iOS<https://aka.ms/o0ukef>
________________________________
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

tatawi, 2022-06-11:
Bonjour,

Je me connecte à Home Assistant (avec root). A la connexion j'ai un message : "Welcome to the Home Assistant command line".

Comment peux-tu savoir avec quel utilisateur tourne deConz ? j'ai essayer de me connecter en ssh avec l'utilisateur pi également mais je ne connais pas le mot de passe pour me connecter.

AdrienBigot, 2022-06-11:
Ce que je t'expliquais pour le user deconz, c'était dans le cas où tu te connectais à ton raspberry en SSH.
Avec HA, deconz est dans un container docker la procédure pour y accéder se fait via le lien que ta donné @Smanar un peu plus haut.

tatawi, 2022-06-12:
Bonjour,

J'ai bien avancé, merci pour votre aide ! En faite je ne me connectais au bon élément, en me connectant sur le port 22222, je vois bien les bons éléments et j'ai pu créer mon fichier DDF (je n'ai pas trouvé d'éditeur de texte mais j'ai pu créer le fichier avec un printf et en collant le contenu du fichier).
J'ai chargé le fichié via deCONZ, fait un hot releaod et le nom a bien changé. Je vois également le fichier dans phoscon.

Mon capteur "alarm 39" n'est par contre pas remonté dans HA, je vais attendre un peu pour voir.

Est-ce que vous savez si on peut mettre à jour le firmware du zlinky via l'integration deConz ?

Smanar, 2022-06-12:
>mais j'ai pu créer le fichier avec un printf et en collant le contenu du fichier

Alors la, ca m’intéresse ta manip ^^, pour la rajouter sur le tuto, en general les gens font avec nano (pas forcement present) ou cat

>Mon capteur "alarm 39" n'est par contre pas remonté dans HA, je vais attendre un peu pour voir.

Oui si il est present dans l'API, il va remonter, surement un soucis de synchro

>Est-ce que vous savez si on peut mettre à jour le firmware du zlinky via l'integration deConz ?

Bonne question, d'apres la page d’accueil ca depend des versions, regardes si tu as le cluster OTA pour ton appareil dans deconz, (le deuxieme rond en haut a droite dans le node, ca va deplier la liste)
Si oui tu vas trouver ton bonheur dans Panel / OTAU update.

tatawi, 2022-06-13:
Merci pour les infos.
Pour creer le fichier DDF, j'ai juste créé un fichier vide
>touch zlinky.json
puis :
>printf 'CONTENU DU FICHIER'

Bianf76, 2023-04-21:
Hello à tous, je ressors de terre ce thread concernant le module. Je pense avoir effectué toutes les manips et maj du DDF (j'ai d'ailleurs testé plusieurs pour essayer de regler mon souci). Coté Deonz je pense être bon, le modul remonte bien :
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

Mais Coté HA, j'ai cette erreure dans le log:
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

Et pour tout vous dire, je seche. @mverove tu n'as pas rencontré ce souci ?

Smanar, 2023-04-21:
Ca se serait plutot un probleme coté HA.

Pour info, je sais pas quelle methode tu as utilisé mais il vaut mieux creer un nouveau DDF dans le dossier `/data/.local/share/dresden-elektronik/deCONZ/devices/` plutot que de bidouiller l install deconz.

Je vais demander au dev HA si il voit ce que c'est ou si tu peux direct faire une demande sur leur github

Bianf76, 2023-04-21:
Concernant la méthode, j'ai récupéré la config que tu as publié sur le forum deconz, copié dans un fichier renommer en .json. Copier ce fichier dans le container comme vu ci-dessous :
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
J'ai testé 2 DDF pour verifier.
PS : je suis néophyte, je découvre ;o). Pour la demande sur leur github, preneur des infos.

Bianf76, 2023-04-21:
Concernant la méthode, j'ai récupéré la config que tu as publié sur le forum deconz, copieé dans un fichier renommer en .json. Copier ce fichier dans le container comme vu ci-dessous :
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
J'ai testé 2 DDF pour verifier.
PS : je suis néophyte, je découvre ;o)

Smanar, 2023-04-22:
Alors le probleme viendrait que tu aurais un ZHAalarm mais sans le champs state/alarm.
Je pense qu'il y a un loupé sur le DDF.
HA fonctionne a partir de docker, et perso je ne peux pas t'aider la dessus non plus. Si tu n'utilises pas le docker de deconz mais le docker du plugin deconz venant de HA, tu as la longue methode ici https://forum.phoscon.de/t/how-to-add-edit-a-ddf-on-home-assistant-using-text-editor/1839
Et pour faire court le DDF est a mettre dans `/data/.local/share/dresden-elektronik/deCONZ/devices/` tu fais une copie de celui que tu veux dans ce dossier, et tu le passes en "Gold".

Bianf76, 2023-04-24:
Hello Smanar,
Merci pour ta réponse. Au final j'ai tout refait et réinstallé une version HA différente qui intègre ZHA. Au final c'est beaucoup plus simple.

AnnoyingTechnology, 2023-11-29:
Bonjour,

Merci pour le travail fait sur ce capteur.
J'ai ajouté le DDF à la main dans /opt/deconz/devices/lixee/, HA a trouvé 3 entities :
* Puissance instantanée en VA
* Consummation cumulée en kWh
* Une alerte que j'imagine être le dépasse de puissance souscrite d'après une autre issue.

**Est-il possible d'obtenir la puissance instantanée en Watt ?**
J'ai pas mal de puissance réactive, donc les VA sont faussés et je serais très intéressé d'avoir des W à la place ou en plus des VA.

Merci pour votre aide.

Smanar, 2023-11-29:
Je pense pas, je viens de vérifier https://github.com/fairecasoimeme/Zlinky_TIC et je ne vois que de la puissance apparente. Mais normallement par defaut le linky ne fait que la puissance apparente (contrairement aux anciens compteurs).

Par contre la différence ne devrait pas etre énorme, je dirais max 0.8, Je dis peut etre une connerie mais meme si tu vas payer la puissance active, on s'en fout un peu car ce qui va compter ici c'est le compteur d'energie, pas de puissance.

AnnoyingTechnology, 2023-11-29:
Merci du retour.
On est d'accord, économiquement je m'en fou.
Par contre pour regarder ce que je consomme, avoir une valeur quelque part entre x1.2 et x1.5 ne permet pas de se faire une idée.

J'essaie d'écrire un sensor virtuel qui utilise les kWh cumulé reporté pour faire une moyenne de puissance instantanée à la minute. Si j'y arrive ça fera le job modulo un petit délais d'une minute.

AnnoyingTechnology, 2023-11-30:
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

Regarder le VA qui oscille à 450W alors que la maison consomme 100W réel est vraiment trop loin du compte. J'ai fait un sensor qui utilise les kWh et leur évolution sur les 2 dernières minutes, ça fait le job.

jgirard78540, 2024-01-13:
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

Bonjour à tous,

ça fonctionne parfaitement pour moi mais en revanche à chaque redémarrage du module (coupure électrique ou mise à jour de home assistant) je dois refaire la manip.
Avez vous ce problème ?

Smanar, 2024-01-13:
Ha le soucis avec les DDF ? ou il te faut changer un status ?
C'est le fonctionnement de HA, c'est le principe des dockers. Il te faut utiliser un repertoire persistent https://forum.phoscon.de/t/how-to-add-edit-a-ddf-on-home-assistant-using-text-editor/1839

Avec ce systeme tu peux creer un DDF qui restera persistent, mais la manip est loin d'etre simple.

Et je suis même pas sur que deconz ne va pas prendre un DDF en "draft"  a la place de celui que tu vas mettre en "gold".

Smanar, 2024-01-13:
Pas besoin de le supprimer. Surtout si il n'est pas reconnu, sinon il sera juste mit a jour.
Il te faut mettre le DDF dont tu as besoin dans `/data/.local/share/dresden-elektronik/deCONZ/devices/` le passer en gold et redemarrer deconz.
Et re-inclure l'appareil si pas deja reconnu.

Thread 18 (2021-11-07):

Intégration zha

max5962, 2021-11-07:
Hello,

Plus un ticket de demande qu'un vrai bug. Mais c'est essentiel pour l'utilisation.
Qui s'occupe de l'intégration via ZHA de zlinky ?
Merci

fairecasoimeme, 2021-11-07:
Bonjour,
Pour le moment personne à ma connaissance, je n'ai pas eu le temps de vraiment regarder comment faire la requête auprès des dev ZHA.
J'imagine qu'il n'y a pas grand chose à faire mais peut-être que cela requiert un zha-quirks.
J'essaie de regarder dans la semaine ...

fairecasoimeme, 2021-11-08:
Bonjour,
Je pense que c'est plus sur ZHA qui faut faire la demande. Zigpy est capable de gérer l'appareil je pense. C'est plus l'intégration vers HA qui faut faire

pdecat, 2021-11-08:
Cela semble s'intégrer nativement dans ZHA:

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

Mais il y a comme un problème d'unité ou de virgule.

pdecat, 2021-11-08:
J'utilise effectivement une passerelle [zzh](https://electrolama.com/projects/zig-a-zig-ah/) avec [firmware Z-Stack](https://github.com/Koenkk/Z-Stack-firmware/tree/master/coordinator/Z-Stack_3.x.0/bin) supportée par [zigpy-znp](https://github.com/zigpy/zigpy-znp), et il s'agit d'une version de développement de Home Assistant mise à jour le 31 octobre.

MichaelBitard, 2021-11-11:
J'ai la même chose que @pdecat avec une zigate

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

J'imagine qu'il doit manquer quelques informations :)

Le fait que le module apparaisse comme "Router" semble indiquer qu'il faudra probablement un zha_quirks pour mieux le configurer non ?

max5962, 2021-11-11:
@MichaelBitard  tu es sous quel version de hass ?
vraiment étonné de ne pas voir les mêmes fonctionnalités :S j'espère pas une version casé du zlinky :/

MichaelBitard, 2021-11-11:
La dernière à jour normalement:
- core-2021.11.2
- supervisor-2021.10.8

Il est où le panel "informations zigbee" ?

max5962, 2021-11-11:
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
Just ici :)

MichaelBitard, 2021-11-11:
Ha ok, en anglais c'est zigbee device signature :)

```json
{
  "node_descriptor": "NodeDescriptor(logical_type=<LogicalType.Router: 1>, complex_descriptor_available=0, user_descriptor_available=0, reserved=0, aps_flags=0, frequency_band=<FrequencyBand.Freq2400MHz: 8>, mac_capability_flags=<MACCapabilityFlags.AllocateAddress|RxOnWhenIdle|MainsPowered|FullFunctionDevice: 142>, manufacturer_code=4151, maximum_buffer_size=127, maximum_incoming_transfer_size=100, server_mask=11264, maximum_outgoing_transfer_size=100, descriptor_capability_field=<DescriptorCapability.NONE: 0>, *allocate_address=True, *is_alternate_pan_coordinator=False, *is_coordinator=False, *is_end_device=False, *is_full_function_device=True, *is_mains_powered=True, *is_receiver_on_when_idle=True, *is_router=True, *is_security_capable=False)",
  "endpoints": {
    "1": {
      "profile_id": 260,
      "device_type": "0x0053",
      "in_clusters": [
        "0x0000",
        "0x0003",
        "0x0702",
        "0x0b01",
        "0x0b04",
        "0xff66"
      ],
      "out_clusters": [
        "0x0019"
      ]
    },
    "242": {
      "profile_id": 41440,
      "device_type": "0x0061",
      "in_clusters": [
        "0x0021"
      ],
      "out_clusters": [
        "0x0021"
      ]
    }
  },
  "manufacturer": "LiXee",
  "model": "ZLinky_TIC",
  "class": "zigpy.device.Device"
}

```

max5962, 2021-11-11:
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

La mise à jour a permit de remonter plus d'informations. (étonnant car il est noté nul part dans le changelog un upgrade de la lib zigpy )

Plus qu'à corriger l'unité/virgule et vérifier qu'il y ai bien une évolution des métriques :)

pdecat, 2021-11-11:
Pour info, j'ai ouvert une issue pour l'ajout du quirk : https://github.com/zigpy/zha-device-handlers/issues/1146

N0ciple, 2021-11-16:
J'ai creusé un peu la question pour faire un quirk.
Il y a quelques subtilités sur comment remonter les infos qui ne fonctionnent pas encore.
La puissance par exemple: avec Zlinky c'est remonté sur le endpoint 1, Cluster 0x0B04, attribut 0x050F.
Si l'on regarde dans gérer les clusters, c'est l'attribut `apparent_power`.
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
Hors, celui qui est remonté par ZHA comme sensor, c'est `active_power`.
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
Ces deux valeurs proviennent du même cluster (0xB04, "ElectricalMeasurement") et il semblerait que ZHA ne permette qu'un sensor par cluster : https://github.com/zigpy/zha-device-handlers/issues/605#issuecomment-753713044
L'info n'est pas super récente. Je ne sais pas si c'est encore le cas. Si ça l'est, je pense qu'il faut écrire un quirks qui prend la valeur de "apparent_power" et la renvoie pour "active_power".

Pour ce qui est du voltage, je crois que le mode historique ne renvoit pas cette info, c'est seulement le mode standard. @fairecasoimeme pourra surement confirmer. Ayant mon linky en mode historique je ne peux pas tester.

Les info de courrant fonctionnent bien.

L'index de consommation fonctionne correctement mais il faut explicitement demander la valeur dans le menu "gérer les clusters" pour que ce soit mis à jour, je ne sais pas bien pourquoi mais je ne suis pas le seul dans ce cas : https://github.com/fairecasoimeme/Zlinky_TIC/issues/19#issue-1048835803
Je ne sais pas trop bien pourquoi c'est comme ça, à creuser...

J'ai commencé à faire le quirk et pour l'instant j'en suis là :
 ```python
from zigpy.quirks import CustomDevice
from zigpy.types import basic
from zhaquirks import Bus, LocalDataCluster
from zigpy.profiles import zha

from zhaquirks.const import (

    DEVICE_TYPE,
    ENDPOINTS,
    INPUT_CLUSTERS,
    MODELS_INFO,
    OUTPUT_CLUSTERS,
    PROFILE_ID,
)

from zigpy.zcl.clusters.general import (
    Basic,
    GreenPowerProxy,
    Identify,
    Ota,
)
from zigpy.zcl.clusters.smartenergy import Metering
from zigpy.zcl.clusters.homeautomation import (
    ElectricalMeasurement,
    MeterIdentification

)

LIXEE = "LiXee"

class ZLinkyTIC(CustomDevice):
    """ZLinky_TIC from LiXee"""
    signature = {
        MODELS_INFO: [(LIXEE, "ZLinky_TIC")],
        ENDPOINTS:{
            1: {
                PROFILE_ID: zha.PROFILE_ID,
                DEVICE_TYPE: zha.DeviceType.METER_INTERFACE,
                INPUT_CLUSTERS: [
                    Basic.cluster_id,
                    Identify.cluster_id,
                    Metering.cluster_id,
                    MeterIdentification.cluster_id,
                    ElectricalMeasurement.cluster_id,
                    0xff66, # Manufacturer Specific
                ],
                OUTPUT_CLUSTERS : [
                    Ota.cluster_id
                ]

            },
            242: {
                PROFILE_ID: 41440,
                DEVICE_TYPE: 0x0061,
                INPUT_CLUSTERS: [
                    GreenPowerProxy.cluster_id
                ],
                OUTPUT_CLUSTERS: [
                    GreenPowerProxy.cluster_id
                ]
        
            }
        }
    }
    replacement= {}
```
Pour le endpoint 242, je n'ai rien trouvé dans zigpy pour le `PROFILE_ID` et `DEVICE_TYPE`, donc j'ai hardcodé les valeurs.

Il faut maintenant remplir le dictionnaire `replacement`. Il faudra probablement créer un cluster `ElectricalMeasurement` custom pour faire ce que je décrivais plus haut (renvoyer la valeur de `apparent_power` pour `active_power`, entre autres, mais je ne sais pas encore bien comment faire ça.

N0ciple, 2021-11-17:
Je crois que développer un quirk n'est pas ce qu'il faudrait faire (ou en tout cas pas la seule chose à faire).
Le problème vient du fait que ZHA n'a pas de sensor pour `apparent_power` mais en a un pour `active_power` (pour la partie power en tout cas). Visiblement c'est pas bien compliqué de rajouter un sensor pour un nouvel attribut. cf https://github.com/home-assistant/core/blob/5ae311b111cdd316de7b4e1af2410a757587bc9f/homeassistant/components/zha/sensor.py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 (et également les classes du dessous `ElectricalMeasurementRMSCurrent`, etc...)
 Il faut juste spécifier correctement les attributs du cluster. L'unité Volt-Ampères existe déjà dans Home Asisstant, ça ne devrait pas être bloquant.

Je crois que quelque chose comme ça devrait être suffisant :
```python
@MULTI_MATCH(channel_names=CHANNEL_ELECTRICAL_MEASUREMENT)
class ElectricalMeasurementApparentPower(ElectricalMeasurement, id_suffix="apparent_power"): # pas sûr pour le id_suffix
    """Apparent Power measurement."""

    SENSOR_ATTR = "apparent_power"
    _device_class = DEVICE_CLASS_POWER
    _unit = POWER_VOLT_AMPERE
    _div_mul_prefix = "ac_power"

    @property
    def should_poll(self) -> bool:
        """Poll indirectly by ElectricalMeasurementSensor."""
        return False
```

Cependant ça va bloquer. En effet, les devices de la classe `power` ne supportent (pas encore) les Volt-Ampères comme unité : https://github.com/home-assistant/core/issues/57236

On peut toujours dire qu'il s'agit de Watt en changeant `POWER_VOLT_AMPERE` par `POWER_WATT`. Puisqu'un Watt est homogène à une puissance et un Volt-Ampère aussi. Physiquement ce n'est pas faux mais c'est pas la bonne unité en pratique. (Pour les histoire d'homogénéité, voir [ici](https://fr.wikipedia.org/wiki/Homog%C3%A9n%C3%A9it%C3%A9_(physique)) spécifiquement la section Principes généraux d'homogénéité)

Je crois qu'il faudra quand même faire un quirk pour définir les `ac_power_multiplier` et `ac_power_divisor` (0X0604 et 0X0605 du cluster ElectricalMeasurement). Sinon le sensor va multiplier par `None` et on aura pas de valeur exploitable.

N0ciple, 2021-11-17:
Bonne nouvelle, il suffit "juste" de rajouter un nouveau sensor comme je le disais dans mon dernier post et ça fonctionne (enfin presque) :
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

J'ai testé en éditant le fichier `homeassistant/components/zha/sensor.py`. Dans une installation Docker il est situé dans `/usr/src/homeassistant`. Si vous faites la manip, attention à bien importer `POWER_VOLT_AMPERE` dans le `from homeassistant.const import ...`
Pas de problèmes avec l'unité en Volt-Ampères finalement. Il  reste cependant le problème de l'actualisation. Tout comme l'indexe de consommation, il faut explicitement demander via l'interface "gérer les clusters" la valeur du champ pour qu'il soit mis à jour.
Peut-être est-ce lié à cette isssue https://github.com/fairecasoimeme/Zlinky_TIC/issues/24 ?

N0ciple, 2021-11-17:
J'ai fait la PR qui est ici : https://github.com/home-assistant/core/pull/59857

pdecat, 2021-11-17:
> Il reste cependant le problème de l'actualisation. Tout comme l'indexe de consommation, il faut explicitement demander via l'interface "gérer les clusters" la valeur du champ pour qu'il soit mis à jour.

La réponse semble avoir été apportée dans la PR: https://github.com/home-assistant/core/pull/59857#discussion_r751705878

N0ciple, 2021-11-18:
> > Il reste cependant le problème de l'actualisation. Tout comme l'indexe de consommation, il faut explicitement demander via l'interface "gérer les clusters" la valeur du champ pour qu'il soit mis à jour.
>
> La réponse semble avoir été apportée dans la PR: [home-assistant/core#59857 (comment)](https://github.com/home-assistant/core/pull/59857#discussion_r751705878)

Oui effectivement je n'avais pas vu qu'il fallait rajouter l'attribut à cet endroit également !
Malheureusement ce n'était pas le seul soucis qui bloquait l'actualisation 😕. J'ai testé en faisant la correction en local et l'actualisation ne se fait toujours pas. Le problème ne vient peut-être pas de ZHA 🤔. Un autre indice qui va dans ce sens, c'est que l'indexe de consommation `est déjà intégré dans ZHA [ici](https://github.com/home-assistant/core/blob/6175f1b6f3f441e3d0708ba3b61dbfdc6ce7e86f/homeassistant/components/zha/sensor.py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) (et également la partie reporting [ici](https://github.com/home-assistant/core/blob/6175f1b6f3f441e3d0708ba3b61dbfdc6ce7e86f/homeassistant/components/zha/core/channels/smartenergy.py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)). L'actualisation fonctionne sur d'autres appareils Zigbee, mais pas pour le Zlinky_TIC.
Je corrigerai la PR en ajoutant la partie reporting et aussi les test qui sont manquants pour que la PR soit acceptée.
Il restera le quirk pour convertir les Wh en KWh pour l'indexe de consommation, mais ça, ça ne devrait pas être trop compliqué :crossed_fingers:

N0ciple, 2021-11-19:
La Pull Request sur ZHA est mergée 🥳 !
Ici le lien de la pull request pour le quirk : https://github.com/zigpy/zha-device-handlers/pull/1161
Le quirk sert juste à convertir les Wh en kWh pour pourvoir l'intégrer dans la partie Energie de home assistant.

Malheureusement, l'actualisation de l'indexe de consommation ne fonctionne pas. Cependant j'avais dit une bétise. J'ai une autre prise en zigbee qui rapport l'indexe et effectivement celui ci ne semple pas s'actualiser tout seul. Il doit falloir creuser du côté ZHA pour ça.

ralmn, 2021-11-19:
Non je suis obligé (comme pour pas mal de valeur) de lire la valeur périodiquement. Comme indiqué en #24 il faudra attendre une nouvelle version du firmware

max5962, 2021-11-19:
Hello,

Donc si je résume l'état des lieux :
- soucis d'unité : corrigé via un Quirk merci @N0ciple !
- soucis de valeur qui ne se met pas à jour (update à faire ou attendre la version du firmware qui corrige ça )
- soucis des autres sensors qui ne remontent pas : corrigé via le Quirk.

J'ai tout bon ? ;)

D'autres choses avant d'avoir d'avoir une intégration au petits ognons ?

N0ciple, 2021-11-19:
@max5962 C'est presque ça. Pour ce qui est du troisième point, ce n'est pas via un quirk mais via une modification directement dans l’intégration zha.

Pour info les sensors dispo dans zha (avant la PR) étaient rms_voltage, rms_current, active_power et current_summ_delivered (index de consommation). active_power n'est pas dispo sur ZLinky_TIC, c'est pour ça que j'ai rajouté le sensor apparent_power lui fonctionne. (Il y a une petite difference physique entre les deux, apparent_power, c'est la grandeur en Volt-Ampères que l'on peut voir sur son linky quand on appuie sur les bouttons et qui correspond à la puissance apparente soutirée).

Si on résume les sensors dispo, ça nous fait : voltage, courrant, puissance apparente et indexe de consommation. Ça me semlble être les sensors plus pertinent. A savoir: le voltage n'est disponnible que sur les Linky en mode standard, pas en mode historique.

Les autres sensors (comme au pif : l'option tarifaire et la puissance souscrite) ne sont pas rapportés dans ZHA. Pour les rajoutés il faudrait faire une autre modification. Et pour le coup, pas sûr que ça soit accepté puisque ça ne servirait que pour le Zlinky_TIC.

Voilà, j'espères que c'est plus clair :ok_hand:

pdecat, 2021-11-20:
@N0ciple `apparent_power` remonte parfaitement et se met à jour tout seul, merci !
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

pdecat, 2021-11-20:
La correction de l'unité Wh en kWh fonctionne aussi parfaitement et la mise à jour se fait toute seule également.

À noter, je vois ceci dans les logs :

```
2021-11-20 10:30:10 WARNING (Recorder) [homeassistant.components.sensor.recorder] sensor.lixee_zlinky_tic_electrical_measurement_apparent_power has unknown unit VA
2
```

max5962, 2021-11-20:
> * u ZLinky_TIC soit dispo (pour la partie actualisation automatique)

Une nouvelle version est disponible ou vous avez modifié votre instance locale ?

pdecat, 2021-11-20:
> Une nouvelle version est disponible ou vous avez modifié votre instance locale ?

Il s'agit d'un environnement de développement local.

N0ciple, 2021-11-21:
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
Oui effectivement, l'unité Volt-Ampère existe mais je crois qu'elle n'a pas été ajouté comme une unité de puissance, ce qui explique le warning. Mais ça n'empêche pas le bon fonctionnement je crois. La documentation ne donne que les Watts comme unité de puissance : https://developers.home-assistant.io/docs/core/entity/sensor/

@pdecat avec la modif du quirk en local, même l'index de conso en kWh est bien updaté automatiquement ? Pour ma part je croyais que c'était le cas mais en fait c'était juste mis à jour au redémarrage de HA ou en requêtant la valeur à la main.

seblang, 2021-11-26:
Bonjour
j'ai acheté un module ZLinky_TIC que j'ai recu recemment mais je n'arrive pas a avoir  la conso !
Il a été reconnu comme le votre dans le module zigbee de HA mais après je n'ai pas vraiment compris comment vous avez pu avoir la conso instantannée!
dsl je suis pas un psecialiste....une petite explication ou tuto serait cool
merci d'avance a vous

N0ciple, 2021-11-26:
Bonjour @seblang,

Toutes les personnes ici (moi y compris) qui ont des infos que vous n'avez pas ont modifié les fichiers en local à la main pour avoir de nouvelles fonctionnalités.

La bonne nouvelle c'est que nous avons fait en sorte que ces modifications soient intégrées dans home assistant. Cependant, depuis que ces modifications ont été intégrées dans le code de home assistant, il n'y a pas eu de mise à jour de publiées.

Si tout va bien, dans la prochaine version de home assistant (2021.12.0 j'imagine), la puissance apparente soutirée sera disponible. Il y a également un quirk qui permettra entre autre de faire la conversion Wh vers kWh pour l'indexe de consommation; Cependant, je ne suis pas sûr que ce quirk sera intégré dans la prochaine version de home assistant, il faudra peut-être attendre encore un peu.

Et pour finir, l'indexe de consommation ne se met pas à jour tout seul. Je crois que ça sera réglé dans le prochain firmware sur ZLinky_TIC. Mais là encore, il faudra attendre encore peu qu'il soit publié.

pdecat, 2021-11-28:
> @pdecat avec la modif du quirk en local, même l'index de conso en kWh est bien updaté automatiquement ? Pour ma part je croyais que c'était le cas mais en fait c'était juste mis à jour au redémarrage de HA ou en requêtant la valeur à la main.

La mise à jour automatique fonctionnait bien au début presque toute la journée du 20 novembre, puis ça s'est arrêté, et ça a re-fonctionné pendant ~4 heures le 21 et ~2 heures le 23 :
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

Le début de chacune de ces périodes semble correspondre aux redémarrages de mon instance HA.

seblang, 2021-11-28:
Hello merci pour ce retour et surtout pour le boulot que vous avez fait.

Possible de partager les modifications à faire manuellement (et ou) en attendant l. Éventuelle mise à jour de Ha et du quirk?

Autre question j'ai cru comprendre qu'il faut être que le linky soit en standard et non en historie.... Du coup faut demander à enedis le changement.

Bon dimanche à tous
Seb

ElieDeloumeau, 2021-12-09:
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

Même problème ici, ça vient du firmware ou de zha ?

seblang, 2021-12-11:
@N0ciple

La version 2021.12.0 vient de sortir pouvez vous me confirmer si la modification et le quirk y sont intégré.
Cordialement
Sébastien

N0ciple, 2021-12-12:
Bonjour @seblang,

Désolé de ne pas vous avoir répondu sur les modifications à faire, je pensais que la nouvelle version de home assistant arriverait bien plus tôt !

La version 2021.12.0 intègre bien le nouveau sensor pour la puissance apparente, et le quirk qui corrige l'unité de l'index de consommation (en tout cas pour ce qui est du tarif "base"). Ce dernier est maintenant bien en **k**Wh.

Le seul souci qui reste est le fait que l'index de consommation ne s'actualise pas tout seul. Il me semble que le problème est connu et qu'il faut attendre un nouveau firmware de @fairecasoimeme.

Pour info, le sensor `electrical_measurement` qui rapporte la puissance consommée en W n'est pas disponible bien que le sensor existe, il rapportera donc toujours `-32768`. Le compteur Linky ne donne pas cette information (puissance active) mais la puissance apparente (qui elle est maintenant disponible). Vous pouvez donc le désactiver dans l'interface 👌.

Le sensor `electrical_measurement_rms_voltage` devrait fonctionner si vous avez un Linky en mode standard. S'il est en mode historique, cette information n'est pas remontée (et ça affichera `65535` en continu. Mon Linky est en mode historique donc je n'ai pas pu tester. Si vous constatez un problème d'unités, n'hésitez pas à le signaler, on pourra toujours modifier le quirk pour corriger l'unité.

seblang, 2021-12-12:
TKT pas grave l'essentiel c'est que ca avance.
Je vais tester la semaine prochaine, encore une petite question sur ce que
le Zlinky récupère!
Des valeurs ci-dessous lesquel peut-on récupérer exactement?

Synthèse développeur
FonctionsCLUSTERAttribut
Standard : EAIT (Production) 0x0702 0x0001
Histo : PTEC 0x0702 0x0020
Histo :
- HCHC
- BASE
- EJPHN
- BBRHCJB
Standard :
- EASF01 0x0702 0x0100
Histo :
- HCHP
- EJPHPM
- BBRHPJB
Standard :
- EASF02 0x0702 0x0102
Histo :
- BBRHCJW
Standard :
- EASF03 0x0702 0x0104
Histo :
- BBRHPJW
Standard :
- EASF04 0x0702 0x0106
Histo :
- BBRHCJR
Standard :
- EASF05 0x0702 0x0108
Histo :
- BBRHPJR
Standard :
- EASF06 0x0702 0x010A
Standard : EASF07 0x0702 0x010C
Standard : EASF08 0x0702 0x010E
Standard : EASF09 0x0702 0x0110
Standard : EASF10 0x0702 0x0112
Standard : PRM 0x0702 0x0307
Histo :
- ADC0
Standard :
- ADSC 0x0702 0x0308
Standard: VTIC 0x0B01 0x000A
Histo :
- ISOUSC
Standard :
- PREF 0x0B01 0x000D
Standard: PCOUP 0x0B01 0x000E
Histo:
- IINST
- IINST1 (Triphasé)
Standard :
- IRMS1 0x0B04 0x0508
Histo:
- IINST2 (Triphasé)
Standard :
- IRMS2 (Triphasé) 0x0B04 0x0908
Histo:
- IINST3 (Triphasé)
Standard :
- IRMS3 (Triphasé) 0x0B04 0x0A08
Histo:
- IMAX
- IMAX1(Triphasé) 0x0B04 0x050A
Histo:
- IMAX2(Triphasé) 0x0B04 0x090A
Histo:
- IMAX3(Triphasé) 0x0B04 0x0A0A
Histo:
- PMAX(Triphasé)
Standard :
- SMAXN
- SMAXN1(Triphasé) 0x0B04 0x050D
Histo:
- PAPP
Standard :
- SINSTS
- SINSTS1(Triphasé) 0x0B04 0x050F
Standard : SINSTS2(Triphasé) 0x0B04 0x090F
Standard : SINSTS3(Triphasé) 0x0B04 0x0A0F
Standard : ERQ1 (Production) 0x0B04 0x0305
Standard : ERQ2 (Production) 0x0B04 0x050E
Standard : ERQ3 (Production) 0x0B04 0x090E
Standard : ERQ4 (Production) 0x0B04 0x0A0E
Standard : URMS1(Mono / Triphasé) 0x0B04 0x0505
Standard : URMS2(Triphasé) 0x0B04 0x0905
Standard : URMS3(Triphasé) 0x0B04 0x0A05
Standard : UMOY1(Mono / Triphasé) 0x0B04 0x0511
Standard : UMOY2(Triphasé) 0x0B04 0x0911
Standard : UMOY3(Triphasé) 0x0B04 0x0A11
Standard : CCASN 0x0B04 0x050B
Standard : CCASN-1 0x0B04 0x090B
Histo :
- OPTARIF
Standard :
- NGTF 0xFF66 0x0000
Histo : DEMAIN 0xFF66 0x0001
Histo : HHPHC 0xFF66 0x0002
Histo : PPOT 0xFF66 0x0003
Histo : PEJP 0xFF66 0x0004
Histo : ADPS 0xFF66 0x0005
Histo : ADIR1 (Triphasé) 0xFF66 0x0006
Histo : ADIR2 (Triphasé) 0xFF66 0x0007
Histo : ADIR3 (Triphasé) 0xFF66 0x0008
Standard : LTARF 0xFF66 0x0200
Standard : NTARF 0xFF66 0x0201
Standard : DATE 0xFF66 0x0202
Standard : EASD01 0xFF66 0x0203
Standard : EASD02 0xFF66 0x0204
Standard : EASD03 0xFF66 0x0205
Standard : EASD04 0xFF66 0x0206
Standard : SINSTI (Production) 0xFF66 0x0207
Standard : SMAXIN (Production) 0xFF66 0x0208
Standard : SMAXIN-1 (Production) 0xFF66 0x0209
Standard : CCAIN (Production) 0xFF66 0x0210
Standard : CCAIN-1 (Production) 0xFF66 0x0211
Standard :
- SMAXN-1 (Monophasé)
- SMAXN1-1 (Triphasé) 0xFF66 0x0212
Standard : SMAXN1-1 (Triphasé) 0xFF66 0x0212
Standard : SMAXN2-1 (Triphasé) 0xFF66 0x0213
Standard : SMAXN3-1 (Triphasé) 0xFF66 0x0214
Standard : MSG1 0xFF66 0x0215
Standard : MSG2 0xFF66 0x0216
Standard : STGE 0xFF66 0x0217
Standard : DPM1 0xFF66 0x0218
Standard : FPM1 0xFF66 0x0219
Standard : DPM2 0xFF66 0x0220
Standard : FPM2 0xFF66 0x0221
Standard : DPM3 0xFF66 0x0222
Standard : FPM3 0xFF66 0x0223
Standard : RELAIS 0xFF66 0x0224
Standard : NJOURF 0xFF66 0x0225
Standard : NJOURF+1 0xFF66 0x0226
Standard : PJOURF+1 0xFF66 0x0227
Standard : PPOINTE1 0xFF66 0x0228

Le dim. 12 déc. 2021 à 10:54, Robin Dupont ***@***.***> a
écrit :

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

seblang, 2021-12-20:
Bonjour

Est ce que les informations du cluster 0xFF66 sont remonté dans zha ?
Dans z2m ces informations ne
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

Thread 19 (2021-11-09):

Comment distinguer le mode standard du mode historique ?

pdecat, 2021-11-09:
Bonjour,

j'ai un doute sur le mode actuel de mon compteur Linky.

Existe t-il un cluster qui permet de déterminer cela à coup sûr ?

Le seul attribut que je vois se rafraîchir toutes les 10 à 15 secondes est `rms_current` (0x0508) sur le cluster `ElectricalMeasurement` (0x0b04):

Il semble correspondre directement à l'entité `electrical_measurement rms_current`:

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

L'attribut `current_summ_delivered` (id: 0x0000) du cluster `Metering` (0x0702) semble correspondre à l'entité `smartenergy_metering summation_delivered` qui ne bouge que lorsque je consulte la valeur explicitement via l'interface permettant d'interroger les clusters :

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

Les attributs correspondant à `electrical_measurement` et `electrical_measurement rms_voltage` ne bougent jamais :

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

Note: il n'y a que quatre entités importantes du point de vue de HA :

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

SilentT19, 2021-11-11:
Le seul moyen c'est d'appuyer sur le bouton du compteur jusqu'à arriver sur "MODE TIC"

SilentT19, 2021-11-11:
Après quand on lis : https://www.enedis.fr/media/2035/download page : 24-25/38

6.2.3.14.
Registre de statuts

État de la sortie télé-information
0 = mode historique
1 = mode standard
bits 17

fairecasoimeme, 2021-11-11:
Bonjour,
quel abonnement as-tu ? Base ou HCHP ou autres ?
le compteur renvoi un index en Wh. Pour avoir une consommation, il faut que le graphe soit en mode variation, c'est à dire faire une soustraction entre l'index recu et le dernier reçu
Fred

pdecat, 2021-11-11:
> quel abonnement as-tu ? Base ou HCHP ou autres ?

J'ai un abonnement de base.

fairecasoimeme, 2021-11-11:
Si tu interroges le cluster 0xFF66 attribut 0x0000, il te sort quoi ?

pdecat, 2021-11-11:
ZHA / Home Assistant ne me permet pas d'interroger ce cluster :

```
Nov 11 18:08:07 poulpy hass[1489]: 2021-11-11 18:08:07 DEBUG (MainThread) [homeassistant.components.zha.api] Read attribute for: cluster_id: [65382] cluster_type: [in] endpoint_id: [1] attribute: [0] manufacturer: [4151] response: [None] failure: [{0: <Status.UNSUPPORTED_ATTRIBUTE: 134>}],
```

Je vais tenter de développer le quirk.

pdecat, 2021-11-11:
J'ai ouvert une issue déjà: https://github.com/zigpy/zha-device-handlers/issues/1146

pdecat, 2021-11-20:
J'ai ouvert sur une PR sur le quirk implémenté par @N0ciple pour pouvoir interroger l'attribut 0x0000 du cluster 0xFF66 avec ZHA: https://github.com/zigpy/zha-device-handlers/pull/1165

Par contre, quand je l'interroge, j'ai une erreur:
```
Nov 20 13:07:22 myhost hass[1551]: 2021-11-20 13:07:22 DEBUG (MainThread) [zigpy_znp.api] Sending request: AF.DataRequestExt.Req(DstAddrModeAddress=AddrModeAddress(mode=<AddrMode.NWK: 2>, address=0xE837), DstEndpoint=1, DstPanId=0x0000, SrcEndpoint=1, ClusterId=65382, TSN=249, Options=<TransmitOptions.SUPPRESS_ROUTE_DISC_NETWORK|ACK_REQUEST: 48>, Radius=30, Data=b'\x04\x37\x10\xF9\x00\x00\x00')
Nov 20 13:07:22 myhost hass[1551]: 2021-11-20 13:07:22 DEBUG (MainThread) [zigpy_znp.api] Received command: AF.DataRequestExt.Rsp(Status=<Status.SUCCESS: 0>)
Nov 20 13:07:24 myhost hass[1551]: 2021-11-20 13:07:24 DEBUG (MainThread) [zigpy_znp.api] Received command: AF.IncomingMsg.Callback(GroupId=0x0000, ClusterId=1024, SrcAddr=0xF785, SrcEndpoint=1, DstEndpoint=1, WasBroadcast=<Bool.false: 0>, LQI=66, SecurityUse=<Bool.false: 0>, TimeStamp=3167755, TSN=0, Data=b'\x18\xB1\x0A\x00\x00\x21\x32\x59', MacSrcAddr=0x25B3, MsgResultRadius=28)
Nov 20 13:07:24 myhost hass[1551]: 2021-11-20 13:07:24 DEBUG (MainThread) [zigpy.zcl] [0xf785:1:0x0400] ZCL deserialize: <ZCLHeader frame_control=<FrameControl frame_type=GLOBAL_COMMAND manufacturer_specific=False is_reply=True disable_default_response=True> manufacturer=None tsn=177 command_id=Command.Report_Attributes>
Nov 20 13:07:24 myhost hass[1551]: 2021-11-20 13:07:24 DEBUG (MainThread) [zigpy.zcl] [0xf785:1:0x0400] ZCL request 0x000a: [[Attribute(attrid=0, value=<TypeValue type=uint16_t, value=22834>)]]
Nov 20 13:07:24 myhost hass[1551]: 2021-11-20 13:07:24 DEBUG (MainThread) [zigpy.zcl] [0xf785:1:0x0400] Attribute report received: measured_value=22834
Nov 20 13:07:24 myhost hass[1551]: 2021-11-20 13:07:24 DEBUG (MainThread) [zigpy_znp.api] Received command: AF.DataConfirm.Callback(Status=<Status.SUCCESS: 0>, Endpoint=1, TSN=249)
Nov 20 13:07:24 myhost hass[1551]: 2021-11-20 13:07:24 DEBUG (MainThread) [zigpy_znp.api] Received command: AF.IncomingMsg.Callback(GroupId=0x0000, ClusterId=65382, SrcAddr=0xE837, SrcEndpoint=1, DstEndpoint=1, WasBroadcast=<Bool.false: 0>, LQI=90, SecurityUse=<Bool.false: 0>, TimeStamp=3169625, TSN=0, Data=b'\x1C\x37\x10\xF9\x01\x00\x00\x86', MacSrcAddr=0x2FD0, MsgResultRadius=28)
Nov 20 13:07:24 myhost hass[1551]: 2021-11-20 13:07:24 DEBUG (MainThread) [zigpy.zcl] [0xe837:1:0xff66] ZCL deserialize: <ZCLHeader frame_control=<FrameControl frame_type=GLOBAL_COMMAND manufacturer_specific=True is_reply=True disable_default_response=True> manufacturer=4151 tsn=249 command_id=Command.Read_Attributes_rsp>
Nov 20 13:07:24 myhost hass[1551]: 2021-11-20 13:07:24 DEBUG (MainThread) [homeassistant.components.zha.api] Read attribute for: cluster_id: [65382] cluster_type: [in] endpoint_id: [1] attribute: [0] manufacturer: [4151] response: [None] failure: [{0: <Status.UNSUPPORTED_ATTRIBUTE: 134>}],
```

Je creuse...

pdecat, 2021-11-20:
> Le seul moyen c'est d'appuyer sur le bouton du compteur jusqu'à arriver sur "MODE TIC"

Je suis enfin allé vérifier, je suis en mode "historique". J'ai fait ma demande pour passer en mode "standard".

N0ciple, 2021-11-21:
Le quirk permet de requêter l'info via "gérer les clusters" mais malheureusement pas de faire un sensor, c'est bien ça ?

pdecat, 2021-12-31:
Je suis enfin passé en mode TIC Standard :tada:

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

Cela m'a nécessité plusieurs allez-retours entre le service client de mon fournisseur (EDF en l'occurrence) et celui d'Enedis à qui appartient le compteur Linky, alors voici la procédure à suivre pour y parvenir :

1. Contactez votre fournisseur d'énergie (EDF dans mon cas)
2. Demandez leur un changement de type `F185` _Modification du dispositif de comptage sans impact sur la formule tarifaire d'acheminement_ (c'est le service technique Enedis qui m'a fourni l'information)
3. Si votre fournisseur vous dit qu'il faut demander à Enedis, insistez. Enedis ne veut pas faire le changement si la demande ne vient pas du fournisseur. Il est possible que votre fournisseur vous dise que cela a un coût (~31€ dans mon cas mais je ne l'ai pas encore vu passé)
4. Une fois la demande faite par votre fournisseur à Enedis, vous pouvez contacter Enedis pour en avoir la confirmation.
5. Le changement a été effectif au bout d'une dizaine de jours je dirais (mon ZLinky_TIC perdant systématiquement la connexion au bout de quelques heures après insertion dans le port TIC, je ne suis pas allé vérifié tous les jours physiquement...)

ElieDeloumeau, 2022-01-03:
Chez Mint, voici la procédure qui a fonctionné pour moi :

1. Contactez Mint sur cette page https://www.mint-energie.com/Pages/Contact/contact.aspx en demandant de modifier le mode TIC de votre compteur en "Standard"
2. Attendez qu'ils ne répondent pas (2/3 jours) 🤦‍♂️
3. Tweetez "@mint_eco Bonjour, pouvez-vous traiter ma demande n°XXXXX SVP ?" et attendez qu'ils répondent (ils vont répondre, c'est mieux pour leur image)
4. Donnez votre référence client en DM à @mint_eco
5. Le changement sera effectif sous 24 heures

fairecasoimeme, 2022-02-04:
Fixed with v4

<html><body>
<!--StartFragment--><h3 dir="auto">Linky Mode ( From V4)</h3>
<h3 dir="auto"><a id="user-content-values" class="anchor" aria-hidden="true" href="https://github.com/fairecasoimeme/Zlinky_TIC#values"><svg class="octicon octicon-link" viewBox="0 0 16 16" version="1.1" width="16" height="16" aria-hidden="true"></svg></a></h3><h3 dir="auto">values</h3>

Cluster | Attribut | Value
-- | -- | --
0xFF66 | 0x0300 | 0 - Mode historique monophasé 1 - Mode standard monophasé  2 - Mode historique triphasé 3 - Mode standard triphasé 5 - Mode standard monophasé producteur 7 - Mode standard triphasé producteur

<h3 dir="auto"><a id="user-content-bit-values" class="anchor" aria-hidden="true" href="https://github.com/fairecasoimeme/Zlinky_TIC#bit-values"><svg class="octicon octicon-link" viewBox="0 0 16 16" version="1.1" width="16" height="16" aria-hidden="true"></svg></a></h3><h3 dir="auto">bit values</h3>
<p dir="auto">bit 0 - Mode historique / standard<br>
bit 1 - Triphasé / Monophasé<br>
bit 2 - Production / non production</p><!--EndFragment-->
</body>
</html>[](https://github.com/fairecasoimeme/Zlinky_TIC#values)[](https://github.com/fairecasoimeme/Zlinky_TIC#bit-values)Linky Mode ( From V4)
values
Cluster 	Attribut 	Value
0xFF66 	0x0300 	0 - Mode historique monophasé
1 - Mode standard monophasé
2 - Mode historique triphasé
3 - Mode standard triphasé
5 - Mode standard monophasé producteur
7 - Mode standard triphasé producteur
bit values

bit 0 - Mode historique / standard
bit 1 - Triphasé / Monophasé
bit 2 - Production / non production

Closed 2022-02-04.

Thread 20 (2021-11-11):

Cluster 0x0702 , Attribut 0x0000 - Data Type used in not standard

pipiche38, 2021-11-11:
Data Type used in 0x23 while it must be 0x25
![Uploading Screenshot 2021-11-11 at 21.51.52.png…]()

pipiche38, 2021-11-11:
ZLinky:

`ZiGate-V2: (ZiGate-V2) Decode8100 - idx: 32 Read Attribute Response: [342b:01] ClusterID: 0702 MsgSQN: 74, i_sqn: 40, AttributeID: 0000 Status: 00 Type: 23 Size: 0004 ClusterData: >00000000<`

Un Device autre ( Tuya Plug)
Decode8102 - Receiving a message from unknown device: [c0a1:01] ClusterID: 0702 AttributeID: 0000 Status: 00 Type: 25 Size: 0006 ClusterData: >000000000039<

fairecasoimeme, 2021-11-16:
Fixed for the future version

fairecasoimeme, 2022-01-04:
fixed on new v3 release

Closed 2022-01-04.

Thread 21 (2021-11-12):

CORRECTION IN DOCUMENTATION UMOY2 x2

djsyl, 2021-11-12:
UMOY2 | 0xB04 | 0x0911 | RP | Triphasé | Uint16 | 3 car | V | Tension moy. ph. 2 | 0
UMOY2 | 0xB04 | 0x0A11 | RP | Triphasé | Uint16 | 3 car | V | Tension moy. ph. 3

VS

UMOY2 | 0xB04 | 0x0911 | RP | Triphasé | Uint16 | 3 car | V | Tension moy. ph. 2 | 0
UMOY3 | 0xB04 | 0x0A11 | RP | Triphasé | Uint16 | 3 car | V | Tension moy. ph. 3

Have a fun

fairecasoimeme, 2021-11-13:
Thanks,
Fixed

Closed 2021-11-13.

Thread 31 (2021-12-11):

Zlinky clignote 7 fois et ne semble pas relever de données

nlhomme, 2021-12-11:
Bonjour,

J'ai reçu hier mon Zlinky.
A peine branché, il ne met à clignoter non pas 2 ou 4 fois comme indiqué dans la doc mais... 7/8 fois:
https://user-images.githubusercontent.com/9362475/145674006-50615484-9a8b-4505-8056-e2d147fb5871.mp4

Cela n'a pas empêché sa liaison avec Home Assistant (en version 2021.11.5 + ZiGate 3.1e):
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

Ceci dit je vois qu'aucune donnée n'a été relevée depuis la nuit dernière (mon relevé est en mode historique) et que quand je suis allé voir ce matin mon compteur Linky, j'ai constaté que la LED était complètement éteinte.

Du coup je ne comprends pas ce que je rate...
Il faut savoir que:
* Actuellement le relevé à la seconde de mon compteur est désactivé (seul le relevé horaire l'est).
* Sur le site d'Enedis, on ne peut qu'activer le relevé horaire, pas à la seconde, est-ce que je dois contacter mon fournisseur pour ça ?

nlhomme, 2021-12-11:
Pour compléter mon message précédent, j'ai cru comprendre au gré des issues que j'ai pu parcourir ces derniers jour que la mise à jour de décembre de Home Assistant allait améliorer significativement la prise en charge du Zlinky, est-ce bien cela?

N0ciple, 2021-12-12:
Bonjour @nlhomme

Avec home assistant 2021.12.0 vous aurez accès à la puissance apparente soutirée, et l'unité de l'indexe de consommation sera corrigé (avant on avait des Wh rapportés dans home assistant comme des kWh, ça ne sera plus le cas), mais il manque encore son actualisation automatique. Plus de détails dans mon message [ici](https://github.com/fairecasoimeme/Zlinky_TIC/issues/18#issuecomment-991866807).

Ce que vous décrivez s'apparente plus (du moins je crois) à des problèmes de connexions. Ça m'arrive également de retrouver mon ZLinky éteint, je dois le débrancher et rebrancher pour qu'il reparte. Dans les modifications que j'ai faite qui sont dans la version 2021.12.0 il n'y a rien qui touche à la connexion en soi.

nlhomme, 2021-12-13:
J'avoue à avoir du mal à comprendre, quand je débranche et rebranche le Zlinky je vois qu'il s'intègre très bien au maillage du réseau Zigbee, puis quelques heures plus tard il ne répond plus, je dois le débrancher et rebrancher pour que ça reparte.

Mais alors que veut dire les 7 clignotements qu'on voit dans la vidéo? J'ai eu ça quand je l'ai branché pour la première fois à peine sortie de l'enveloppe?

Et est-ce que je dois demander impérativement à mon fournisseur d'électricité ou Enedis d'activer le relevé de consommation à la seconde de mon compteur?

nlhomme, 2021-12-13:
Et non seulement il ne répond plus mais quand je retourne au compteur la led est totalement éteinte, comme dans cette issue
:https://github.com/fairecasoimeme/Zlinky_TIC/issues/26

fairecasoimeme, 2021-12-14:
Bonjour,
Les clignotements signifient qu'il n'arrive pas à décoder votre linky comme indiquer dans le README.
Pouvez-vous me contacter par mail pour échange standard ? contact[at]lixee.fr

nlhomme, 2021-12-14:
Bonjour,

J'ai également testé sur le compteur Linky d'un ami et j'obtiens le même résultat.
Je pense donc que l'échange est la meilleure chose à faire.

Merci, je vous contacte de suite.

L'homme

fairecasoimeme, 2021-12-15:
Bonjour,

Pouvez-vous retourner votre module à l'adresse suivante :

Frédéric DUBOIS
19 avenue du 8 Mai
66300 LLUPIA
FRANCE

Dès réception je procèderai à l'échange standard.

Cordialement,
Fred

Le 13.12.2021 19:00, Nicolas Lhomme a écrit :

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

Links:
------
[1] https://github.com/fairecasoimeme/Zlinky_TIC/issues/26
[2]
https://github.com/fairecasoimeme/Zlinky_TIC/issues/31#issuecomment-992730186
[3]
https://github.com/notifications/unsubscribe-auth/AFJZWNSMCQD55D3NWYS7AJLUQYYFPANCNFSM5J24LW7Q
[4]
https://apps.apple.com/app/apple-store/id1477376905?ct=notification-email&amp;mt=8&amp;pt=524675
[5]
https://play.google.com/store/apps/details?id=com.github.android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

nlhomme, 2021-12-15:
Bonjour,

Merci pour votre retour, je vous ai fait une réponse par mail à contact[at]lixee.fr.

Je propose qu'en parallèle de notre échange par mail de laisser cette issue ouverte le temps du changement de Zlinky pour confirmer que tout est rentré dans l'ordre.

Bonne journée

fairecasoimeme, 2021-12-15:
Bonjour,
Désolé mais je n'ai pas reçu de mail. Pouvez-vous renvoyer votre mail à contact@lixee.fr et/ou contact@zigate.fr

nlhomme, 2021-12-15:
Bonjour, je viens de vous renvoyer un mail aux deux adresses.

Si vous ne le recevez pas, je vous invite à contacter votre fournisseur de messagerie, je l'ai envoyé à partir d'une adresse icloud

Bonne fin de journée

nlhomme, 2021-12-15:
Au pire si vous n'avez toujours rien dans la soirée dites-le-moi, je vous renverrai le mail depuis un autre fournisseur de messagerie

nlhomme, 2022-01-15:
Bonjour,

Je viens d'installer le nouveau Zlinky.
La led est enfin fixe et s'intègre au réseau Zigbee, j'attends que les premières données arrivent pour clore définitivement l'issue

nlhomme, 2022-01-16:
Le nouveau Zlinky semble bien fonctionner correctement.

Il y a des problèmes de remontées de données mais je vois que c'est en traitement dans la #18.

Je me permets dans ce cas de clore l'issue, merci pour votre assistance!

Closed 2022-01-16.

Thread 32 (2021-12-14):

Detect Linky mode

vk496, 2021-12-14:
Hello,

Most of the attributes exposed by Zlinky allow us to detect which kind of configuration is currently active (if we have 0/MAX values in Production, we assume is not enabled). However, instead of trying to read multiple attributes in order to discard possibilities, it would be more comfortable to expose directly that values somewhere (maybe liXee cluster?)

vk496, 2022-01-04:
This can be deduced from STGE attribute, so there is no need to do it from the firmware. However, I'm not sure if is possible to deduce the phase (single or three) and if is producer too

fairecasoimeme, 2022-01-04:
Yep,
you can deduce the phase or producer mode with asked the right label index and if the value is 0, the mode is not OK

for example:
historique / triphase : --> PPOT
standard / triphase : --> SMAXN2
standard / producer:  --> SMAXIN

vk496, 2022-01-04:
Just checked. My current config is: standard and single phase (no producer):

PPOT: Never get a value
SMAXN2: Never get a value
SMAXIN: Never get a value

However, trying to read triphase label index of historique, I get a MAXint16 (65535). I don't see a clear way to deduce it, since a non readed value doesn't mean it doesn't exist (network delay for example)

vk496, 2022-01-10:
@fairecasoimeme any idea to how to detect the standard/historique?

I thought using `STGE` would be perfectly fine, but it seems that is only available in standard mode following the Enedis specification (even if it reports the mode????)

fairecasoimeme, 2022-01-10:
What is the final goal of this feature ?
if you get PPOT, you're in historic mode with 3 phases
if you get OPTARIF but not PPOT, you're in historic mode mono phase
if you get SMAXN2, you're in standard mode with 3 phases
if you get SMAXIN, you're in standard mode with product feature
if you get SMAXN but not SMAXN2, you're in standard mode with mono phase.

It's sure that is complicated.
If it's really important, I can add a new command in aim to give you the linky mode.

vk496, 2022-01-10:
My main problem to support Zlinky in Z2M is that I'm not reading the **labels** (PPOT, OPTARIF, etcl) but instead, clusters and attributes from a zigbee perspective.

That means, for example, a user in historique will have `OPTARIF`, but in standard he will have `NGTF`. Both come from the same place (`0xFF66/0x0000`) and in both cases they will always have a value.

For that reason I need to make sure that detecting the correct configuration of Linky works properly, since I will expose a set of labels based on that. If I expose just all of them without doing a filter, it cause a huge DB overload, since EVERY change of EVERY label is registered. Problems of that was already reported in Home Assistant

fairecasoimeme, 2022-01-10:
Fixed with next version

https://github.com/fairecasoimeme/Zlinky_TIC/blob/master/README.md#linky-mode--from-v4

fairecasoimeme, 2022-01-14:
I'll try to do this ASAP

Thread 33 (2021-12-14):

Firmware OTA

vk496, 2021-12-14:
Hello,

Since this repo already published a release with the OTA firmware, I would like to propose a homogeneous way to make future release (specially, the filename and the tag). That would allow us to implement effective OTA updates detection based on the current firmware of the zlinky and the last published in this repo.

Br,
Valentín

silversmarty, 2022-01-04:
Great idea ! I must admit I'm quite a noob and I have no idea in how to update my Zlinky_TIC to v3 that has just been released (despite the kind of tutorial that is mentionned in the readme, talking about ZiGate).
If any OTA feature can be added to this device, it would be awesome!

Thanks

fairecasoimeme, 2022-01-04:
The feature is available on ZLinky_TIC.
Please see with plugins to see how to proceed.

vk496, 2022-01-04:
Hello @fairecasoimeme

Currently I'm developing support of Zlinky in Z2M. I tried to use OTA and it seemed to worked correctly (FIleVersion in the firmware is reported as 3), but firmware version nor firmware date was updated. And the bug of Date is still present (https://github.com/fairecasoimeme/Zlinky_TIC/issues/38), so I assume that my zlinky still in the same status.

Could you verify that OTA issue is just on my side and not a firmware problem?

seblang, 2022-01-04:
@vk496
Thank you for the converter! it's working fine.
Can you explain us how to update the firmware by OTA?
I have the file ZLinky router v3.0.ota, but what should I do with it?
sorry it's new for me :-)

vk496, 2022-01-04:
In Z2M, you had to modify the code (URL of the index.json) and manually deploy a http server (I use python3 http.server) of the OTA repo of Z2M.

Anyway, I'm not sure if it worked properly, so I prefer to make sure is working before formally supporting OTA in the device.

seblang, 2022-01-05:
Ha somebordy done the update from Firmeware ?

what do you have in Z2M interface now?

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

fairecasoimeme, 2022-01-05:
Indeed, I think there is a problem. I see what is not ok.

vk496, 2022-01-06:
@fairecasoimeme I tried to wipe all firmware and put it in v1.0. Then I did a successful OTA update.

The device reports a `fileVersion` of 3, like in the OTA header file (so I'm not able to update anymore). But the rest of the device remains the same.

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

Flashing the firm manually over TTL, remains all exactly the same:

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

There is something wrong there

vk496, 2022-01-06:
When flashing manually, the last commits are working correctly, even if the device report old firmware version

fairecasoimeme, 2022-01-06:
After some tests, I think there is a problem with OTA and BIN files

fairecasoimeme, 2022-01-06:
Please reupload new Bin or OTA files and retest ?

vk496, 2022-01-06:
@fairecasoimeme I confirm that is working correctly. Z2M Frontend doesn't update the values, but a read report the last version (fileVersion 3, {"swBuildId":"4000-0003","dateCode":"20220104"}).

Just as reminder, Date is broken in this version: https://github.com/fairecasoimeme/Zlinky_TIC/issues/38#issuecomment-1006444101

Closed 2022-01-12.

Thread 34 (2021-12-20):

Need to power off/on LiXee_TIC to reset ADPS value after a consumption spike

AdrienBigot, 2021-12-20:
Hi,

By default ADPS (id 0x0005 in cluster 0xFF66) is set to 0 if we don't exceed the contrat limit value.
If we exceed the limit and then return to a normal situation, the ADPS value remains blocked at the last value above the limit.

Step to reproduce the problem :
1. I turn on many devices and ADPS value increase to 38A.
2. I turn off one device, the value change to 34A in a few seconds.
3. I turn off another device, the value change to 31A.
4. I turn off all unecessary devices, the value is stucked to the last 31A.
5. Unpluged and plug my Zlinky, my ADPS value is back to 0

It seems the zlinky_tic store this value in memory and never reset it when we return to a normal situation.

Adrien

fairecasoimeme, 2022-01-10:
sorry for delay.
ZLinky_TIC don't store any values. I think this is the linky which keep the last value.
So, I'll ask Enedis

fairecasoimeme, 2022-01-10:
Ok, I understand.
Indeed, ADPS is a command which appear only when there is an exceed value. In this case, the value is collected.
But when the power value is ok, ADPS doesn't exist anymore and the module don't update the value. I'll see how to change this.

fairecasoimeme, 2022-02-04:
fixed with v4

Closed 2022-02-04.

Thread 37 (2022-01-03):

Probleme d'appairage

bensaeba, 2022-01-03:
Bonjour à tous,

Je viens de faire l'acquisition de la Zlinky (depuis le temps que j'attendais un ERL me permettant de me connecter à ma TIC!! mon compteur étant en limite de propriété, il était assez compliqué de tirer un câble).
J'ai aussi reçu sous le sapin la zigateV2, la Zlinky est donc mon premier équipement zigbee (j'utilisais jusque-là le RFXcom).

Problème, je n'arrive pas à appairer le zlinky.
J'ai suivi les procédures décrites ici:
https://github.com/pipiche38/Domoticz-Zigate-Wiki/blob/master/fr-fr/Tuto_Appairage-objet.md
https://github.com/fairecasoimeme/Zlinky_TIC
https://bestofcpp.com/repo/fairecasoimeme-Zlinky_TIC

Je passe en mode appairage dans l'interface zigate  http://XXXXXX:9440/ (appairage permanent et avec l'assistant)
Quand je branche le zlinky la led bleue est allumée et fixe (pas de clignotement me disant qu'elle est en attente d'appairage - l'appareil clignote 2 fois toutes les 7 secondes). Est-ce normal?
J'ai quand même réinitialisé l'appareil (appuyer sur le bouton "link" pendant 10 secondes puis relâcher, la Led s'éteint puis se mettre à clignoter).

Étant donné que c'est la première fois que je fais un appairge sur zigate je me dis que je ne dois pas suivre la bonne procédure pour l'appairer, aussi quelle est la bonne méthode?
J'ai aussi envisagé la distance mais en testant sur un autre compteur proche quelques mètre j'arrive à la même conclusion…

ma config:
	• Raspeberry4
	• domoticz 2021.1
	• Plugin: 5.1.016
	• Firmware: 0320 (j'ai un message me disant qu'une mise à jour est disponible)

Est-ce qu'il vous faut d'autre information?

Bonne année à tous :)

Ben

fairecasoimeme, 2022-01-04:
problème en cours de traitement par mail

bensaeba, 2022-01-06:
Bonjour,

Sauf erreur de ma part je n'ai reçu aucun email.
Merci beaucoup

Ben

Closed 2022-01-04.

Thread 38 (2022-01-04):

Wrong Date type

vk496, 2022-01-04:
Hello,

The attribute date (0xFF66/0x0202) is a String limited to 10 chars for representing a custom Enedis date format (H**081225**_223518_)

However, the zlinky device only transmit 10 chars (H**081225**_223_). 3 chars are missing.

fairecasoimeme, 2022-01-04:
hello,
 fixed on new v3 release

vk496, 2022-01-06:
@fairecasoimeme in the v3 firmware the DATE is reported as weird number with nulls inside: 02\null061182025\null

fairecasoimeme, 2022-01-10:
fixed with next version

Closed 2022-01-04.

Thread 39 (2022-01-06):

Couleur du lendemain

chrisalex-dev, 2022-01-06:
bonjour,
j'ai ouvert sur vos conseil un incident chez Jeedom dont vous trouverez la réponse un peu lapidaire ci dessous :
https://github.com/fairecasoimeme/Zlinky_TIC/issues/36#issue-1092720411

fairecasoimeme, 2022-01-06:
Bonjour,
Apparemment, les tirets correspondent à une couleur du lendemain inconnue.
https://www.google.com/url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

La couleur du lendemain (donnée du groupe d’étiquette « DEMAIN ») est codée sur 4 caractères ASCII alphanumériques
selon la syntaxe suivante :
* « ---- » : couleur du lendemain non connue, (le caractère noté « - » correspond au caractère ASCII « tiret »),
* « BLEU » : le lendemain est jour BLEU,
* « BLAN » : le lendemain est jour BLANC,
* « ROUG » : le lendemain est jour ROUGE.

Il n'y a donc pas de dysfonctionnement du module. Pour le vérifier vous pouvez aussi connecter un module usb TTL en utilisant le connecteur de programmation RX et GND. Puis en ouvrant une console putty sur le port COM, vous pourrez observer ce que renvoi précisément le Linky. Mais si vous avez des tirets, c'est qu'il remonte la bonne valeur

chrisalex-dev, 2022-01-17:
bonjour,
vous aviez bien raison le module n'est pas en cause  car depuis la mise à jour du plug-in zigbee en 2022-01-11par Jeedom, la couleur du lendemain fonctionne bien désormais

HoM3r17, 2022-10-14:
>
Bonjour,
Utilises-tu le plugin officiel Jeedom ? Est-ce que cette donnée remonte a une intervalle particulière ?

Actuellement le Zlinky_Tic est installé depuis 12h et je n'ai aucune remontée dans les champs "Periode tarifaire en cours" et "Couleur du lendemain", tout le reste semble remonter normalement...

Closed 2022-01-06.

Thread 40 (2022-01-06):

Problem subscribe to attributes

vk496, 2022-01-06:
Hello,

When I try to subscribe to **UMOY1** (0x0B04/0x0511), I receive a error from the zigbee controller saying that is not reportable. Probable the same happens to **UMOY2** and **UMOY3**.

Also, when I try to subscribe to SINSTS (0xB04/0x050F) I get a SOFTWARE_FAILURE

fairecasoimeme, 2022-01-10:
fixed with next version for UMOY1, UMOY2, UMOY3

Could you tell me more with the SINSTS problem. Who give to you the SOFTWARE_FAILURE ?
What is the complete request ?

vk496, 2022-01-10:
the SOFTWARE_FAILURE that I receive is from Z2M (herdsman library). I will send you later the zigbee traces

vk496, 2022-01-11:
```
DI","daysNumberNextCalendar":1,"drawnVAMaxN1":3750,"linkquality":255,"message1":"PAS DE MESSAGE","message2":"","meterSerialNumber":"812061182025","powerThreshold":6,"rmsCurrent":2,"rmsVoltage":235,"siteId":"23276845056102","softwareRevision":2,"statusRegister":"003A0001","update":{"state":"idle"},"update_available":false}'
  zigbee-herdsman:deconz:frameParser DEVICE_STATE changed: 10101010 +5s
  zigbee-herdsman:deconz:driver networkstate: 2 apsDataConfirm: 0 apsDataIndication: 1 configChanged: 0 apsRequestFreeSlots: 1 +5s
  zigbee-herdsman:deconz:driver query aps data indication +4ms
  zigbee-herdsman:deconz:frameParser DEVICE_STATE changed: 10101010 +7ms
  zigbee-herdsman:deconz:driver networkstate: 2 apsDataConfirm: 0 apsDataIndication: 1 configChanged: 0 apsRequestFreeSlots: 1 +3ms
  zigbee-herdsman:deconz:driver DATA_INDICATION - sending read data request - SeqNr. 95 +3ms
  zigbee-herdsman:deconz:driver query aps data indication +1ms
  zigbee-herdsman:deconz:frameParser DATA_INDICATION RESPONSE - seqNr. 95 srcAddr: 0x6f21 destAddr: 0x0 profile id: 0x104 cluster id: 0xb04 lqi: 255 +7ms
  zigbee-herdsman:deconz:frameParser response payload: 24,142,10,5,5,33,236,0 +1ms
  zigbee-herdsman:controller:log Received 'zcl' data '{"frame":{"Header":{"frameControl":{"frameType":0,"manufacturerSpecific":false,"direction":1,"disableDefaultResponse":true,"reservedBits":0},"transactionSequenceNumber":142,"manufacturerCode":null,"commandIdentifier":10},"Payload":[{"attrId":1285,"dataType":33,"attrData":236}],"Command":{"ID":10,"name":"report","parameters":[{"name":"attrId","type":33},{"name":"dataType","type":32},{"name":"attrData","type":1000}]}},"address":28449,"endpoint":1,"linkquality":255,"groupID":null,"wasBroadcast":false,"destinationEndpoint":1}' +5s
Zigbee2MQTT:debug 2022-01-11 11:04:52: Received Zigbee message from 'zlinky', type 'attributeReport', cluster 'haElectricalMeasurement', data '{"rmsVoltage":236}' from endpoint 1 with groupID null
Zigbee2MQTT:info  2022-01-11 11:04:52: Configuring 'zlinky'
  zigbee-herdsman:controller:endpoint Bind zlinky/1 seMetering from '0x00212effff07a5cd/1' +5s
  zigbee-herdsman:deconz:driver networkstate: 2 apsDataConfirm: 0 apsDataIndication: 1 configChanged: 0 apsRequestFreeSlots: 1 +20ms
Zigbee2MQTT:info  2022-01-11 11:04:52: MQTT publish: topic 'zigbee2mqttDEV2/zlinky', payload '{"activeEnerfyOutD01":2519,"activeEnerfyOutD02":453,"activePower":456,"activePowerMax":1250,"activePowerPhB":804,"apparentPower":374,"availablePower":6,"averageRmsVoltageMeasPeriod":236,"currentDate":"02061182025","currentIndexTarif":1,"currentPrice":"SEMAINE","currentTarif":"SEM WE MERCREDI","daysNumberNextCalendar":1,"drawnVAMaxN1":3750,"linkquality":255,"message1":"PAS DE MESSAGE","message2":"","meterSerialNumber":"812061182025","powerThreshold":6,"rmsCurrent":2,"rmsVoltage":236,"siteId":"23276845056102","softwareRevision":2,"statusRegister":"003A0001","update":{"state":"idle"},"update_available":false}'
  zigbee-herdsman:deconz:driver DATA_REQUEST - destAddr: 0x6f21 EP:0 SeqNr. 97 request id: 28 +4ms
  zigbee-herdsman:deconz:driver DATA_INDICATION - sending read data request - SeqNr. 96 +0ms
  zigbee-herdsman:deconz:driver query aps data indication +1ms
  zigbee-herdsman:deconz:frameParser DATA_REQUEST RESPONSE - request id: 28 status: 0 +23ms
  zigbee-herdsman:deconz:driver networkstate: 2 apsDataConfirm: 0 apsDataIndication: 1 configChanged: 0 apsRequestFreeSlots: 1 +2ms
  zigbee-herdsman:deconz:driver DATA_INDICATION - sending read data request - SeqNr. 98 +2ms
  zigbee-herdsman:deconz:driver query aps data indication +1ms
  zigbee-herdsman:deconz:driver DATA_INDICATION - sending read data request - SeqNr. 99 +5ms
  zigbee-herdsman:deconz:frameParser DATA_INDICATION RESPONSE - seqNr. 96 srcAddr: 0x6f21 destAddr: 0x0 profile id: 0x104 cluster id: 0xff66 lqi: 255 +12ms
  zigbee-herdsman:deconz:frameParser response payload: 24,145,10,3,2,35,254,113,38,0 +0ms
  zigbee-herdsman:controller:log Received 'zcl' data '{"frame":{"Header":{"frameControl":{"frameType":0,"manufacturerSpecific":false,"direction":1,"disableDefaultResponse":true,"reservedBits":0},"transactionSequenceNumber":145,"manufacturerCode":null,"commandIdentifier":10},"Payload":[{"attrId":515,"dataType":35,"attrData":2519550}],"Command":{"ID":10,"name":"report","parameters":[{"name":"attrId","type":33},{"name":"dataType","type":32},{"name":"attrData","type":1000}]}},"address":28449,"endpoint":1,"linkquality":255,"groupID":null,"wasBroadcast":false,"destinationEndpoint":1}' +33ms
Zigbee2MQTT:debug 2022-01-11 11:04:52: Received Zigbee message from 'zlinky', type 'attributeReport', cluster 'liXeePrivate', data '{"activeEnerfyOutD01":2519550}' from endpoint 1 with groupID null
  zigbee-herdsman:deconz:driver networkstate: 2 apsDataConfirm: 0 apsDataIndication: 0 configChanged: 0 apsRequestFreeSlots: 1 +7ms
Zigbee2MQTT:info  2022-01-11 11:04:52: MQTT publish: topic 'zigbee2mqttDEV2/zlinky', payload '{"activeEnerfyOutD01":2519,"activeEnerfyOutD02":453,"activePower":456,"activePowerMax":1250,"activePowerPhB":804,"apparentPower":374,"availablePower":6,"averageRmsVoltageMeasPeriod":236,"currentDate":"02061182025","currentIndexTarif":1,"currentPrice":"SEMAINE","currentTarif":"SEM WE MERCREDI","daysNumberNextCalendar":1,"drawnVAMaxN1":3750,"linkquality":255,"message1":"PAS DE MESSAGE","message2":"","meterSerialNumber":"812061182025","powerThreshold":6,"rmsCurrent":2,"rmsVoltage":236,"siteId":"23276845056102","softwareRevision":2,"statusRegister":"003A0001","update":{"state":"idle"},"update_available":false}'
  zigbee-herdsman:deconz:frameParser DEVICE_STATE changed: 10100110 +9ms
  zigbee-herdsman:deconz:driver networkstate: 2 apsDataConfirm: 1 apsDataIndication: 0 configChanged: 0 apsRequestFreeSlots: 1 +5ms
  zigbee-herdsman:deconz:driver query aps data confirm +4ms
  zigbee-herdsman:deconz:frameParser DEVICE_STATE changed: 10101110 +8ms
  zigbee-herdsman:deconz:driver networkstate: 2 apsDataConfirm: 1 apsDataIndication: 1 configChanged: 0 apsRequestFreeSlots: 1 +4ms
  zigbee-herdsman:deconz:driver DATA_CONFIRM - sending data state request - SeqNr. 100 +2ms
  zigbee-herdsman:deconz:driver query aps data confirm +0ms
  zigbee-herdsman:deconz:frameParser DATA_CONFIRM RESPONSE - destAddr: 0x6f21 request id: 28 confirm status: 0 +4ms
  zigbee-herdsman:deconz:driver networkstate: 2 apsDataConfirm: 0 apsDataIndication: 1 configChanged: 0 apsRequestFreeSlots: 1 +2ms
  zigbee-herdsman:deconz:driver query aps data indication +0ms
  zigbee-herdsman:deconz:driver DATA_CONFIRM - sending data state request - SeqNr. 101 +3ms
  zigbee-herdsman:deconz:driver DATA_INDICATION - sending read data request - SeqNr. 102 +6ms
  zigbee-herdsman:deconz:frameParser DATA_INDICATION RESPONSE - seqNr. 102 srcAddr: 0x6f21 destAddr: 0x0 profile id: 0x0 cluster id: 0x8021 lqi: 255 +13ms
  zigbee-herdsman:deconz:frameParser response payload: 28,0 +0ms
  zigbee-herdsman:deconz:adapter resolve data request without a transSeq Nr. +5s
  zigbee-herdsman:deconz:driver networkstate: 2 apsDataConfirm: 0 apsDataIndication: 0 configChanged: 0 apsRequestFreeSlots: 1 +5ms
  zigbee-herdsman:deconz:adapter BIND RESPONSE - addr: 0x6f21 status: 0 +1ms
  zigbee-herdsman:controller:endpoint Bind zlinky/1 haMeterIdentification from '0x00212effff07a5cd/1' +64ms
  zigbee-herdsman:deconz:driver DATA_REQUEST - destAddr: 0x6f21 EP:0 SeqNr. 103 request id: 29 +10ms
  zigbee-herdsman:deconz:frameParser DATA_REQUEST RESPONSE - request id: 29 status: 0 +14ms
  zigbee-herdsman:deconz:driver networkstate: 2 apsDataConfirm: 0 apsDataIndication: 0 configChanged: 0 apsRequestFreeSlots: 1 +3ms
  zigbee-herdsman:deconz:frameParser DEVICE_STATE changed: 10100110 +13ms
  zigbee-herdsman:deconz:driver networkstate: 2 apsDataConfirm: 1 apsDataIndication: 0 configChanged: 0 apsRequestFreeSlots: 1 +13ms
  zigbee-herdsman:deconz:driver query aps data confirm +5ms
  zigbee-herdsman:deconz:driver DATA_CONFIRM - sending data state request - SeqNr. 104 +5ms
  zigbee-herdsman:deconz:frameParser DEVICE_STATE changed: 10101110 +12ms
  zigbee-herdsman:deconz:driver networkstate: 2 apsDataConfirm: 1 apsDataIndication: 1 configChanged: 0 apsRequestFreeSlots: 1 +2ms
  zigbee-herdsman:deconz:frameParser DATA_CONFIRM RESPONSE - destAddr: 0x6f21 request id: 29 confirm status: 0 +1ms
  zigbee-herdsman:deconz:driver networkstate: 2 apsDataConfirm: 0 apsDataIndication: 1 configChanged: 0 apsRequestFreeSlots: 1 +1ms
  zigbee-herdsman:deconz:driver query aps data indication +0ms
  zigbee-herdsman:deconz:driver DATA_INDICATION - sending read data request - SeqNr. 105 +2ms
  zigbee-herdsman:deconz:frameParser DATA_INDICATION RESPONSE - seqNr. 105 srcAddr: 0x6f21 destAddr: 0x0 profile id: 0x0 cluster id: 0x8021 lqi: 255 +4ms
  zigbee-herdsman:deconz:frameParser response payload: 29,0 +0ms
  zigbee-herdsman:deconz:adapter resolve data request without a transSeq Nr. +42ms
  zigbee-herdsman:deconz:driver networkstate: 2 apsDataConfirm: 0 apsDataIndication: 0 configChanged: 0 apsRequestFreeSlots: 1 +3ms
  zigbee-herdsman:deconz:adapter BIND RESPONSE - addr: 0x6f21 status: 0 +1ms
  zigbee-herdsman:controller:endpoint Bind zlinky/1 haElectricalMeasurement from 'zcontroller/1' +39ms
  zigbee-herdsman:deconz:driver DATA_REQUEST - destAddr: 0x6f21 EP:0 SeqNr. 106 request id: 30 +17ms
  zigbee-herdsman:deconz:frameParser DATA_REQUEST RESPONSE - request id: 30 status: 0 +20ms
  zigbee-herdsman:deconz:driver networkstate: 2 apsDataConfirm: 0 apsDataIndication: 0 configChanged: 0 apsRequestFreeSlots: 1 +2ms
  zigbee-herdsman:deconz:frameParser DEVICE_STATE changed: 10100110 +20ms
  zigbee-herdsman:deconz:driver networkstate: 2 apsDataConfirm: 1 apsDataIndication: 0 configChanged: 0 apsRequestFreeSlots: 1 +20ms
  zigbee-herdsman:deconz:driver query aps data confirm +2ms
  zigbee-herdsman:deconz:driver DATA_CONFIRM - sending data state request - SeqNr. 107 +5ms
  zigbee-herdsman:deconz:frameParser DEVICE_STATE changed: 10101110 +18ms
  zigbee-herdsman:deconz:driver networkstate: 2 apsDataConfirm: 1 apsDataIndication: 1 configChanged: 0 apsRequestFreeSlots: 1 +11ms
  zigbee-herdsman:deconz:frameParser DATA_CONFIRM RESPONSE - destAddr: 0x6f21 request id: 30 confirm status: 0 +1ms
  zigbee-herdsman:deconz:driver networkstate: 2 apsDataConfirm: 0 apsDataIndication: 1 configChanged: 0 apsRequestFreeSlots: 1 +1ms
  zigbee-herdsman:deconz:driver query aps data indication +1ms
  zigbee-herdsman:deconz:driver DATA_INDICATION - sending read data request - SeqNr. 108 +3ms
  zigbee-herdsman:deconz:frameParser DATA_INDICATION RESPONSE - seqNr. 108 srcAddr: 0x6f21 destAddr: 0x0 profile id: 0x0 cluster id: 0x8021 lqi: 255 +7ms
  zigbee-herdsman:deconz:frameParser response payload: 30,0 +1ms
  zigbee-herdsman:deconz:adapter resolve data request without a transSeq Nr. +66ms
  zigbee-herdsman:deconz:driver networkstate: 2 apsDataConfirm: 0 apsDataIndication: 0 configChanged: 0 apsRequestFreeSlots: 1 +4ms
  zigbee-herdsman:deconz:adapter BIND RESPONSE - addr: 0x6f21 status: 0 +1ms
  zigbee-herdsman:controller:endpoint Bind zlinky/1 liXeePrivate from '0x00212effff07a5cd/1' +71ms
  zigbee-herdsman:deconz:driver DATA_REQUEST - destAddr: 0x6f21 EP:0 SeqNr. 109 request id: 31 +10ms
  zigbee-herdsman:deconz:frameParser DATA_REQUEST RESPONSE - request id: 31 status: 0 +12ms
  zigbee-herdsman:deconz:driver networkstate: 2 apsDataConfirm: 0 apsDataIndication: 0 configChanged: 0 apsRequestFreeSlots: 1 +2ms
  zigbee-herdsman:deconz:frameParser DEVICE_STATE changed: 10100110 +19ms
  zigbee-herdsman:deconz:driver networkstate: 2 apsDataConfirm: 1 apsDataIndication: 0 configChanged: 0 apsRequestFreeSlots: 1 +19ms
  zigbee-herdsman:deconz:driver query aps data confirm +3ms
  zigbee-herdsman:deconz:driver DATA_CONFIRM - sending data state request - SeqNr. 110 +6ms
  zigbee-herdsman:deconz:frameParser DEVICE_STATE changed: 10101110 +20ms
  zigbee-herdsman:deconz:driver networkstate: 2 apsDataConfirm: 1 apsDataIndication: 1 configChanged: 0 apsRequestFreeSlots: 1 +11ms
  zigbee-herdsman:deconz:frameParser DATA_CONFIRM RESPONSE - destAddr: 0x6f21 request id: 31 confirm status: 0 +0ms
  zigbee-herdsman:deconz:driver networkstate: 2 apsDataConfirm: 0 apsDataIndication: 1 configChanged: 0 apsRequestFreeSlots: 1 +0ms
  zigbee-herdsman:deconz:driver query aps data indication +1ms
  zigbee-herdsman:deconz:driver DATA_INDICATION - sending read data request - SeqNr. 111 +3ms
  zigbee-herdsman:deconz:frameParser DATA_INDICATION RESPONSE - seqNr. 111 srcAddr: 0x6f21 destAddr: 0x0 profile id: 0x0 cluster id: 0x8021 lqi: 255 +6ms
  zigbee-herdsman:deconz:frameParser response payload: 31,0 +0ms
  zigbee-herdsman:deconz:adapter resolve data request without a transSeq Nr. +56ms
  zigbee-herdsman:deconz:driver networkstate: 2 apsDataConfirm: 0 apsDataIndication: 0 configChanged: 0 apsRequestFreeSlots: 1 +2ms
  zigbee-herdsman:deconz:adapter BIND RESPONSE - addr: 0x6f21 status: 0 +1ms
  zigbee-herdsman:controller:endpoint ConfigureReporting zlinky/1 seMetering([{"attribute":"currentSummDelivered","minimumReportInterval":0,"maximumReportInterval":3600,"reportableChange":1}], {"timeout":10000,"disableResponse":false,"disableRecovery":false,"disableDefaultResponse":true,"direction":0,"srcEndpoint":null,"reservedBits":0,"manufacturerCode":null,"transactionSequenceNumber":null,"writeUndiv":false}) +54ms
  zigbee-herdsman:deconz:adapter zclFrame.payload: +5ms
  zigbee-herdsman:deconz:adapter [
  zigbee-herdsman:deconz:adapter   {
  zigbee-herdsman:deconz:adapter     direction: 0,
  zigbee-herdsman:deconz:adapter     attrId: 0,
  zigbee-herdsman:deconz:adapter     dataType: 37,
  zigbee-herdsman:deconz:adapter     minRepIntval: 0,
  zigbee-herdsman:deconz:adapter     maxRepIntval: 3600,
  zigbee-herdsman:deconz:adapter     repChange: 1
  zigbee-herdsman:deconz:adapter   }
  zigbee-herdsman:deconz:adapter ] +1ms
  zigbee-herdsman:deconz:driver DATA_REQUEST - destAddr: 0x6f21 EP:1 SeqNr. 112 request id: 32 +8ms
  zigbee-herdsman:deconz:frameParser DATA_REQUEST RESPONSE - request id: 32 status: 0 +10ms
  zigbee-herdsman:deconz:driver networkstate: 2 apsDataConfirm: 0 apsDataIndication: 0 configChanged: 0 apsRequestFreeSlots: 1 +2ms
  zigbee-herdsman:deconz:frameParser DEVICE_STATE changed: 10100110 +11ms
  zigbee-herdsman:deconz:driver networkstate: 2 apsDataConfirm: 1 apsDataIndication: 0 configChanged: 0 apsRequestFreeSlots: 1 +11ms
  zigbee-herdsman:deconz:driver query aps data confirm +3ms
  zigbee-herdsman:deconz:driver DATA_CONFIRM - sending data state request - SeqNr. 113 +6ms
  zigbee-herdsman:deconz:frameParser DATA_CONFIRM RESPONSE - destAddr: 0x6f21 request id: 32 confirm status: 0 +11ms
  zigbee-herdsman:deconz:driver networkstate: 2 apsDataConfirm: 0 apsDataIndication: 0 configChanged: 0 apsRequestFreeSlots: 1 +2ms
  zigbee-herdsman:deconz:adapter sendZclFrameToEndpoint - message send with transSeq Nr.: 23 +25ms
  zigbee-herdsman:deconz:frameParser DEVICE_STATE changed: 10101010 +36ms
  zigbee-herdsman:deconz:driver networkstate: 2 apsDataConfirm: 0 apsDataIndication: 1 configChanged: 0 apsRequestFreeSlots: 1 +37ms
  zigbee-herdsman:deconz:driver query aps data indication +5ms
  zigbee-herdsman:deconz:driver DATA_INDICATION - sending read data request - SeqNr. 114 +2ms
  zigbee-herdsman:deconz:frameParser DATA_INDICATION RESPONSE - seqNr. 114 srcAddr: 0x6f21 destAddr: 0x0 profile id: 0x104 cluster id: 0x702 lqi: 255 +11ms
  zigbee-herdsman:deconz:frameParser response payload: 24,23,7,0 +0ms
  zigbee-herdsman:deconz:adapter resolve data request with transSeq Nr.: 23 +48ms
  zigbee-herdsman:controller:log Received 'zcl' data '{"frame":{"Header":{"frameControl":{"frameType":0,"manufacturerSpecific":false,"direction":1,"disableDefaultResponse":true,"reservedBits":0},"transactionSequenceNumber":23,"manufacturerCode":null,"commandIdentifier":7},"Payload":[{"status":0}],"Command":{"ID":7,"name":"configReportRsp","parameters":[{"name":"status","type":32},{"name":"direction","type":32,"conditions":[{"type":"minimumRemainingBufferBytes","value":3}]},{"name":"attrId","type":33,"conditions":[{"type":"minimumRemainingBufferBytes","value":2}]}]}},"address":28449,"endpoint":1,"linkquality":255,"groupID":null,"wasBroadcast":false,"destinationEndpoint":1}' +283ms
  zigbee-herdsman:deconz:driver networkstate: 2 apsDataConfirm: 0 apsDataIndication: 0 configChanged: 0 apsRequestFreeSlots: 1 +7ms
  zigbee-herdsman:deconz:adapter response received +4ms
  zigbee-herdsman:controller:endpoint ConfigureReporting zlinky/1 seMetering([{"attribute":"currentTier1SummDelivered","minimumReportInterval":0,"maximumReportInterval":3600,"reportableChange":1}], {"timeout":10000,"disableResponse":false,"disableRecovery":false,"disableDefaultResponse":true,"direction":0,"srcEndpoint":null,"reservedBits":0,"manufacturerCode":null,"transactionSequenceNumber":null,"writeUndiv":false}) +81ms
  zigbee-herdsman:deconz:adapter zclFrame.payload: +3ms
  zigbee-herdsman:deconz:adapter [
  zigbee-herdsman:deconz:adapter   {
  zigbee-herdsman:deconz:adapter     direction: 0,
  zigbee-herdsman:deconz:adapter     attrId: 256,
  zigbee-herdsman:deconz:adapter     dataType: 37,
  zigbee-herdsman:deconz:adapter     minRepIntval: 0,
  zigbee-herdsman:deconz:adapter     maxRepIntval: 3600,
  zigbee-herdsman:deconz:adapter     repChange: 1
  zigbee-herdsman:deconz:adapter   }
  zigbee-herdsman:deconz:adapter ] +1ms
  zigbee-herdsman:deconz:driver DATA_REQUEST - destAddr: 0x6f21 EP:1 SeqNr. 115 request id: 33 +5ms
  zigbee-herdsman:deconz:frameParser DATA_REQUEST RESPONSE - request id: 33 status: 0 +12ms
  zigbee-herdsman:deconz:driver networkstate: 2 apsDataConfirm: 0 apsDataIndication: 0 configChanged: 0 apsRequestFreeSlots: 1 +3ms
  zigbee-herdsman:deconz:frameParser DEVICE_STATE changed: 10100110 +9ms
  zigbee-herdsman:deconz:driver networkstate: 2 apsDataConfirm: 1 apsDataIndication: 0 configChanged: 0 apsRequestFreeSlots: 1 +9ms
  zigbee-herdsman:deconz:driver query aps data confirm +5ms
  zigbee-herdsman:deconz:driver DATA_CONFIRM - sending data state request - SeqNr. 116 +6ms
  zigbee-herdsman:deconz:frameParser DATA_CONFIRM RESPONSE - destAddr: 0x6f21 request id: 33 confirm status: 0 +13ms
  zigbee-herdsman:deconz:driver networkstate: 2 apsDataConfirm: 0 apsDataIndication: 0 configChanged: 0 apsRequestFreeSlots: 1 +2ms
  zigbee-herdsman:deconz:adapter sendZclFrameToEndpoint - message send with transSeq Nr.: 24 +26ms
  zigbee-herdsman:deconz:frameParser DEVICE_STATE changed: 10101010 +37ms
  zigbee-herdsman:deconz:driver networkstate: 2 apsDataConfirm: 0 apsDataIndication: 1 configChanged: 0 apsRequestFreeSlots: 1 +38ms
  zigbee-herdsman:deconz:driver query aps data indication +1ms
  zigbee-herdsman:deconz:driver DATA_INDICATION - sending read data request - SeqNr. 117 +6ms
  zigbee-herdsman:deconz:frameParser DATA_INDICATION RESPONSE - seqNr. 117 srcAddr: 0x6f21 destAddr: 0x0 profile id: 0x104 cluster id: 0x702 lqi: 255 +12ms
  zigbee-herdsman:deconz:frameParser response payload: 24,24,7,0 +0ms
  zigbee-herdsman:deconz:adapter resolve data request with transSeq Nr.: 24 +49ms
  zigbee-herdsman:controller:log Received 'zcl' data '{"frame":{"Header":{"frameControl":{"frameType":0,"manufacturerSpecific":false,"direction":1,"disableDefaultResponse":true,"reservedBits":0},"transactionSequenceNumber":24,"manufacturerCode":null,"commandIdentifier":7},"Payload":[{"status":0}],"Command":{"ID":7,"name":"configReportRsp","parameters":[{"name":"status","type":32},{"name":"direction","type":32,"conditions":[{"type":"minimumRemainingBufferBytes","value":3}]},{"name":"attrId","type":33,"conditions":[{"type":"minimumRemainingBufferBytes","value":2}]}]}},"address":28449,"endpoint":1,"linkquality":255,"groupID":null,"wasBroadcast":false,"destinationEndpoint":1}' +84ms
  zigbee-herdsman:deconz:driver networkstate: 2 apsDataConfirm: 0 apsDataIndication: 0 configChanged: 0 apsRequestFreeSlots: 1 +10ms
  zigbee-herdsman:deconz:adapter response received +7ms
  zigbee-herdsman:controller:endpoint ConfigureReporting zlinky/1 seMetering([{"attribute":"currentTier2SummDelivered","minimumReportInterval":0,"maximumReportInterval":3600,"reportableChange":1}], {"timeout":10000,"disableResponse":false,"disableRecovery":false,"disableDefaultResponse":true,"direction":0,"srcEndpoint":null,"reservedBits":0,"manufacturerCode":null,"transactionSequenceNumber":null,"writeUndiv":false}) +93ms
  zigbee-herdsman:deconz:adapter zclFrame.payload: +11ms
  zigbee-herdsman:deconz:adapter [
  zigbee-herdsman:deconz:adapter   {
  zigbee-herdsman:deconz:adapter     direction: 0,
  zigbee-herdsman:deconz:adapter     attrId: 258,
  zigbee-herdsman:deconz:adapter     dataType: 37,
  zigbee-herdsman:deconz:adapter     minRepIntval: 0,
  zigbee-herdsman:deconz:adapter     maxRepIntval: 3600,
  zigbee-herdsman:deconz:adapter     repChange: 1
  zigbee-herdsman:deconz:adapter   }
  zigbee-herdsman:deconz:adapter ] +0ms
  zigbee-herdsman:deconz:driver DATA_REQUEST - destAddr: 0x6f21 EP:1 SeqNr. 118 request id: 34 +16ms
  zigbee-herdsman:deconz:frameParser DATA_REQUEST RESPONSE - request id: 34 status: 0 +26ms
  zigbee-herdsman:deconz:driver networkstate: 2 apsDataConfirm: 0 apsDataIndication: 0 configChanged: 0 apsRequestFreeSlots: 1 +5ms
  zigbee-herdsman:deconz:frameParser DEVICE_STATE changed: 10100110 +9ms
  zigbee-herdsman:deconz:driver networkstate: 2 apsDataConfirm: 1 apsDataIndication: 0 configChanged: 0 apsRequestFreeSlots: 1 +8ms
  zigbee-herdsman:deconz:driver query aps data confirm +1ms
  zigbee-herdsman:deconz:driver DATA_CONFIRM - sending data state request - SeqNr. 119 +5ms
  zigbee-herdsman:deconz:frameParser DATA_CONFIRM RESPONSE - destAddr: 0x6f21 request id: 34 confirm status: 0 +8ms
  zigbee-herdsman:deconz:driver networkstate: 2 apsDataConfirm: 0 apsDataIndication: 0 configChanged: 0 apsRequestFreeSlots: 1 +2ms
  zigbee-herdsman:deconz:adapter sendZclFrameToEndpoint - message send with transSeq Nr.: 25 +24ms
  zigbee-herdsman:deconz:frameParser DEVICE_STATE changed: 10101010 +44ms
  zigbee-herdsman:deconz:driver networkstate: 2 apsDataConfirm: 0 apsDataIndication: 1 configChanged: 0 apsRequestFreeSlots: 1 +44ms
  zigbee-herdsman:deconz:driver query aps data indication +2ms
  zigbee-herdsman:deconz:driver DATA_INDICATION - sending read data request - SeqNr. 120 +6ms
  zigbee-herdsman:deconz:frameParser DATA_INDICATION RESPONSE - seqNr. 120 srcAddr: 0x6f21 destAddr: 0x0 profile id: 0x104 cluster id: 0x702 lqi: 255 +10ms
  zigbee-herdsman:deconz:frameParser response payload: 24,25,7,0 +0ms
  zigbee-herdsman:deconz:adapter resolve data request with transSeq Nr.: 25 +55ms
  zigbee-herdsman:controller:log Received 'zcl' data '{"frame":{"Header":{"frameControl":{"frameType":0,"manufacturerSpecific":false,"direction":1,"disableDefaultResponse":true,"reservedBits":0},"transactionSequenceNumber":25,"manufacturerCode":null,"commandIdentifier":7},"Payload":[{"status":0}],"Command":{"ID":7,"name":"configReportRsp","parameters":[{"name":"status","type":32},{"name":"direction","type":32,"conditions":[{"type":"minimumRemainingBufferBytes","value":3}]},{"name":"attrId","type":33,"conditions":[{"type":"minimumRemainingBufferBytes","value":2}]}]}},"address":28449,"endpoint":1,"linkquality":255,"groupID":null,"wasBroadcast":false,"destinationEndpoint":1}' +95ms
  zigbee-herdsman:deconz:driver networkstate: 2 apsDataConfirm: 0 apsDataIndication: 0 configChanged: 0 apsRequestFreeSlots: 1 +4ms
  zigbee-herdsman:deconz:adapter response received +2ms
  zigbee-herdsman:controller:endpoint ConfigureReporting zlinky/1 seMetering([{"attribute":"currentTier3SummDelivered","minimumReportInterval":0,"maximumReportInterval":3600,"reportableChange":1}], {"timeout":10000,"disableResponse":false,"disableRecovery":false,"disableDefaultResponse":true,"direction":0,"srcEndpoint":null,"reservedBits":0,"manufacturerCode":null,"transactionSequenceNumber":null,"writeUndiv":false}) +85ms
  zigbee-herdsman:deconz:adapter zclFrame.payload: +3ms
  zigbee-herdsman:deconz:adapter [
  zigbee-herdsman:deconz:adapter   {
  zigbee-herdsman:deconz:adapter     direction: 0,
  zigbee-herdsman:deconz:adapter     attrId: 260,
  zigbee-herdsman:deconz:adapter     dataType: 37,
  zigbee-herdsman:deconz:adapter     minRepIntval: 0,
  zigbee-herdsman:deconz:adapter     maxRepIntval: 3600,
  zigbee-herdsman:deconz:adapter     repChange: 1
  zigbee-herdsman:deconz:adapter   }
  zigbee-herdsman:deconz:adapter ] +0ms
  zigbee-herdsman:deconz:driver DATA_REQUEST - destAddr: 0x6f21 EP:1 SeqNr. 121 request id: 35 +5ms
  zigbee-herdsman:deconz:frameParser DATA_REQUEST RESPONSE - request id: 35 status: 0 +10ms
  zigbee-herdsman:deconz:driver networkstate: 2 apsDataConfirm: 0 apsDataIndication: 0 configChanged: 0 apsRequestFreeSlots: 1 +3ms
  zigbee-herdsman:deconz:frameParser DEVICE_STATE changed: 10100110 +9ms
  zigbee-herdsman:deconz:driver networkstate: 2 apsDataConfirm: 1 apsDataIndication: 0 configChanged: 0 apsRequestFreeSlots: 1 +9ms
  zigbee-herdsman:deconz:driver query aps data confirm +5ms
  zigbee-herdsman:deconz:driver DATA_CONFIRM - sending data state request - SeqNr. 122 +6ms
  zigbee-herdsman:deconz:frameParser DATA_CONFIRM RESPONSE - destAddr: 0x6f21 request id: 35 confirm status: 0 +13ms
  zigbee-herdsman:deconz:driver networkstate: 2 apsDataConfirm: 0 apsDataIndication: 0 configChanged: 0 apsRequestFreeSlots: 1 +2ms
  zigbee-herdsman:deconz:adapter sendZclFrameToEndpoint - message send with transSeq Nr.: 26 +27ms
  zigbee-herdsman:deconz:frameParser DEVICE_STATE changed: 10101010 +40ms
  zigbee-herdsman:deconz:driver networkstate: 2 apsDataConfirm: 0 apsDataIndication: 1 configChanged: 0 apsRequestFreeSlots: 1 +40ms
  zigbee-herdsman:deconz:driver query aps data indication +2ms
  zigbee-herdsman:deconz:driver DATA_INDICATION - sending read data request - SeqNr. 123 +3ms
  zigbee-herdsman:deconz:frameParser DATA_INDICATION RESPONSE - seqNr. 123 srcAddr: 0x6f21 destAddr: 0x0 profile id: 0x104 cluster id: 0x702 lqi: 255 +9ms
  zigbee-herdsman:deconz:frameParser response payload: 24,26,7,0 +0ms
  zigbee-herdsman:deconz:adapter resolve data request with transSeq Nr.: 26 +50ms
  zigbee-herdsman:controller:log Received 'zcl' data '{"frame":{"Header":{"frameControl":{"frameType":0,"manufacturerSpecific":false,"direction":1,"disableDefaultResponse":true,"reservedBits":0},"transactionSequenceNumber":26,"manufacturerCode":null,"commandIdentifier":7},"Payload":[{"status":0}],"Command":{"ID":7,"name":"configReportRsp","parameters":[{"name":"status","type":32},{"name":"direction","type":32,"conditions":[{"type":"minimumRemainingBufferBytes","value":3}]},{"name":"attrId","type":33,"conditions":[{"type":"minimumRemainingBufferBytes","value":2}]}]}},"address":28449,"endpoint":1,"linkquality":255,"groupID":null,"wasBroadcast":false,"destinationEndpoint":1}' +84ms
  zigbee-herdsman:deconz:driver networkstate: 2 apsDataConfirm: 0 apsDataIndication: 0 configChanged: 0 apsRequestFreeSlots: 1 +10ms
  zigbee-herdsman:deconz:adapter response received +7ms
  zigbee-herdsman:controller:endpoint ConfigureReporting zlinky/1 seMetering([{"attribute":"currentTier4SummDelivered","minimumReportInterval":0,"maximumReportInterval":3600,"reportableChange":1}], {"timeout":10000,"disableResponse":false,"disableRecovery":false,"disableDefaultResponse":true,"direction":0,"srcEndpoint":null,"reservedBits":0,"manufacturerCode":null,"transactionSequenceNumber":null,"writeUndiv":false}) +91ms
  zigbee-herdsman:deconz:adapter zclFrame.payload: +7ms
  zigbee-herdsman:deconz:adapter [
  zigbee-herdsman:deconz:adapter   {
  zigbee-herdsman:deconz:adapter     direction: 0,
  zigbee-herdsman:deconz:adapter     attrId: 262,
  zigbee-herdsman:deconz:adapter     dataType: 37,
  zigbee-herdsman:deconz:adapter     minRepIntval: 0,
  zigbee-herdsman:deconz:adapter     maxRepIntval: 3600,
  zigbee-herdsman:deconz:adapter     repChange: 1
  zigbee-herdsman:deconz:adapter   }
  zigbee-herdsman:deconz:adapter ] +0ms
  zigbee-herdsman:deconz:driver DATA_REQUEST - destAddr: 0x6f21 EP:1 SeqNr. 124 request id: 36 +11ms
  zigbee-herdsman:deconz:frameParser DATA_REQUEST RESPONSE - request id: 36 status: 0 +20ms
  zigbee-herdsman:deconz:driver networkstate: 2 apsDataConfirm: 0 apsDataIndication: 0 configChanged: 0 apsRequestFreeSlots: 1 +3ms
  zigbee-herdsman:deconz:frameParser DEVICE_STATE changed: 10100110 +11ms
  zigbee-herdsman:deconz:driver networkstate: 2 apsDataConfirm: 1 apsDataIndication: 0 configChanged: 0 apsRequestFreeSlots: 1 +11ms
  zigbee-herdsman:deconz:driver query aps data confirm +2ms
  zigbee-herdsman:deconz:driver DATA_CONFIRM - sending data state request - SeqNr. 125 +6ms
  zigbee-herdsman:deconz:frameParser DATA_CONFIRM RESPONSE - destAddr: 0x6f21 request id: 36 confirm status: 0 +10ms
  zigbee-herdsman:deconz:driver networkstate: 2 apsDataConfirm: 0 apsDataIndication: 0 configChanged: 0 apsRequestFreeSlots: 1 +2ms
  zigbee-herdsman:deconz:adapter sendZclFrameToEndpoint - message send with transSeq Nr.: 27 +25ms
  zigbee-herdsman:deconz:frameParser DEVICE_STATE changed: 10101010
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

Thread 41 (2022-01-09):

Partially working with Home Assistant

cedsib, 2022-01-09:
Hello,

I just installed my ZLinky_TIC to replace my Atome key.

When I look into HomeAssistant (ZHA, not mqtt), the value sensor.lixee_zlinky_tic_8585d205_electrical_measurement_apparent_power seems to work properly :

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

But :
-  I don't have HP/HC values,
- and the sensor for energy mesurement doesn't seem to send any value so my energy mesurement is flat.

What can I do to correct it ?

Thanks a lot !

ElieDeloumeau, 2022-01-10:
Hello, it's related to #18

Hedda, 2022-05-11:
FYI, there is also a related firmware issue causing issues for ZHA as discussed here -> https://github.com/fairecasoimeme/Zlinky_TIC/issues/46

There are more discussions on the ZHA side here (in English language only) -> https://github.com/zigpy/zha-device-handlers/issues/1146

Thread 42 (2022-01-12):

Arrêt de communication fréquente

seblang, 2022-01-12:
Bonjour,

Cela fait maintenant quelques temps que j'utilise le zlinky-tic et jusque là il marchait très bien.

Une utilisation avec z2m sous ha.

Seulement depuis une semaine il arrête d'émettre régulièrement. La led bleue reste fixe comme si tout allait bien avec le contrôleur mais celui ci ne reçoit plus d'informations et des interrogations dans la console dev retourne une erreur de non réponse.

Une déconnexion du module avec quelque minutes d'attente avant reconnexion resou le soucis mais pour une durée plus ou moins variable de renfonctionnement !

D'où vient le problème ?
Une solution ?

Crocmagnon, 2022-01-12:
J'ai également la même configuration et le même problème. J'attends avec impatience cette PR : https://github.com/Koenkk/zigbee-herdsman-converters/pull/3493

pdecat, 2022-01-14:
J'ai un problème similaire niveau commandes et attributs, mais ma LED s'éteint complètement par contre. :confused:

fairecasoimeme, 2022-01-20:
Pour le problème de coupures d'alimentation, nous avons avancé et une modification matérielle permet de limiter les problèmes.
contactez-moi par mail : contact[at]lixee.Fr

0r1g1ne, 2022-01-20:
Bonjour, j'ai le même problème. La led s'éteint, la communication s'interrompt. Je vous ai envoyé un mail à contact(at)lixee.fr. Merci d'avance.

guix77, 2022-01-22:
Comment faites-vous marcher le Z_Linky avec z2m sachant que la PR n'est pas mergée? Sauf si bien sûr vous utilisez la PR telle qu'elle.

Crocmagnon, 2022-01-23:
Je viens également d'avoir le problème de l'alimentation qui s'éteint. Je vous envoie un mail.

AdrienBigot, 2022-01-28:
Idem, de mon côté le module s'éteint régulièrement. Ca me rassure de voir que je ne suis pas le seul dans ce cas.

pdecat, 2022-02-04:
Les problèmes de communication sont résolus pour moi [avec la modification apportée par @fairecasoimeme à mon module ZLinky_TIC](https://github.com/fairecasoimeme/Zlinky_TIC/issues/48#issuecomment-1027767123).

Closed 2022-02-04.

Thread 44 (2022-01-14):

OTA seems not working

max5962, 2022-01-14:
Hello @fairecasoimeme ,

J'ai tenté une OTA via la commande :

service: zha.issue_zigbee_cluster_command
data:
  ieee: "XXXX"
  endpoint_id: 1
  cluster_type: out
  command_type: client
  cluster_id: 0x0019
  command: 0
  args:
    - 0
    - 100

Et j'ai depuis 1H ces logs :

```
2022-01-14 13:50:11 DEBUG (MainThread) [zigpy.zcl] [0xf9be:1:0x0019] OTA image version: 3, size: 239198. Update needed: True
2022-01-14 13:50:11 INFO (MainThread) [zigpy.zcl] [0xf9be:1:0x0019] Updating: LiXee ZLinky_TIC
2022-01-14 13:50:11 DEBUG (MainThread) [zigpy.zcl] [0xf9be:1:0x0019] ZCL deserialize: <ZCLHeader frame_control=<FrameControl frame_type=CLUSTER_COMMAND manufacturer_specific=False is_reply=False disable_default_response=False> manufacturer=None tsn=126 command_id=3>
2022-01-14 13:50:11 DEBUG (MainThread) [zigpy.zcl] [0xf9be:1:0x0019] ZCL request 0x0003: [0, 4151, 1, 3, 0, 48, None, None]
2022-01-14 13:50:11 DEBUG (MainThread) [zigpy.zcl] [0xf9be:1:0x0019] OTA image_block handler for 'LiXee ZLinky_TIC': field_control=0, manufacturer_id=4151, image_type=1, file_version=3, file_offset=0, max_data_size=48, request_node_addr=Noneblock_request_delay=None
2022-01-14 13:50:11 DEBUG (MainThread) [zigpy.zcl] [0xf9be:1:0x0019] OTA upgrade progress: 0.0
2022-01-14 13:50:11 DEBUG (MainThread) [zigpy.zcl] [0xf9be:1:0x0019] ZCL deserialize: <ZCLHeader frame_control=<FrameControl frame_type=CLUSTER_COMMAND manufacturer_specific=False is_reply=False disable_default_response=False> manufacturer=None tsn=127 command_id=3>
2022-01-14 13:50:11 DEBUG (MainThread) [zigpy.zcl] [0xf9be:1:0x0019] ZCL request 0x0003: [0, 4151, 1, 3, 40, 48, None, None]
2022-01-14 13:50:11 DEBUG (MainThread) [zigpy.zcl] [0xf9be:1:0x0019] OTA image_block handler for 'LiXee ZLinky_TIC': field_control=0, manufacturer_id=4151, image_type=1, file_version=3, file_offset=40, max_data_size=48, request_node_addr=Noneblock_request_delay=None
2022-01-14 13:50:11 DEBUG (MainThread) [zigpy.zcl] [0xf9be:1:0x0019] OTA upgrade progress: 0.0
```

Après deux heures, restarts, zlinky restart : non change
Encore et toujours ces mêmes lignes de logs :/
Une idée ?

pdecat, 2022-01-14:
Hello, le ZLinky répond toujours aux autres commandes et remonte ses attributs ?

Lors de ma première tentative, il avait progressé jusqu'à 3% puis a perdu la connexion (LED éteinte).

À ma seconde tentative après l'avoir débranché / rebranché, c'est passé (~30 minutes pour atteindre les 100%).

max5962, 2022-01-14:
Oui, cela fonctionne toujours :-)
D'ailleurs ma zigate est à 2 mètre  donc je pense que le LQI est au top ^^

max5962, 2022-01-14:
Yes ! J'ai mes valeurs qui remontent :)

J'ai tout essayé pour l'OTA :
 - redémarrer Hass
- redémarrer la zlinky (débrancher / rebrancher)
- supprimer / rejoindre le réseau ZigBee.
Je reste à 0.0 ....

J'ai téléchargé et mis dans le dossier comme conseillé par zigpy le fichier routeur V3.ota

max5962, 2022-01-17:
J'ai tenté la version 4 qui vient de sortir mais malheureusement pas mieux ...

``` 2022-01-17 14:34:10 DEBUG (MainThread) [zigpy.zcl] [0xf8e8:1:0x0019] ZCL request 0x0001: [0, 4151, 1, 1, None]
2022-01-17 14:34:10 DEBUG (MainThread) [zigpy.zcl] [0xf8e8:1:0x0019] OTA query_next_image handler for 'LiXee ZLinky_TIC': field_control=0, manufacture_id=4151, image_type=1, current_file_version=1, hardware_version=None
2022-01-17 14:34:10 DEBUG (MainThread) [zigpy.zcl] [0xf8e8:1:0x0019] OTA image version: 4, size: 239982. Update needed: True
2022-01-17 14:34:10 INFO (MainThread) [zigpy.zcl] [0xf8e8:1:0x0019] Updating: LiXee ZLinky_TIC
2022-01-17 14:34:10 ERROR (MainThread) [zigpy_zigate.api] Received unhandled response 0x8012
2022-01-17 14:34:10 ERROR (MainThread) [zigpy_zigate.api] Received unhandled response 0x8012
2022-01-17 14:34:10 ERROR (MainThread) [zigpy_zigate.api] Received unhandled response 0x8012
2022-01-17 14:34:10 DEBUG (MainThread) [zigpy.zcl] [0xf8e8:1:0x0019] ZCL deserialize: <ZCLHeader frame_control=<FrameControl frame_type=CLUSTER_COMMAND manufacturer_specific=False is_reply=False disable_default_response=False> manufacturer=None tsn=5 command_id=3>
2022-01-17 14:34:10 DEBUG (MainThread) [zigpy.zcl] [0xf8e8:1:0x0019] ZCL request 0x0003: [0, 4151, 1, 4, 0, 48, None, None]
2022-01-17 14:34:10 DEBUG (MainThread) [zigpy.zcl] [0xf8e8:1:0x0019] OTA image_block handler for 'LiXee ZLinky_TIC': field_control=0, manufacturer_id=4151, image_type=1, file_version=4, file_offset=0, max_data_size=48, request_node_addr=Noneblock_request_delay=None
2022-01-17 14:34:10 DEBUG (MainThread) [zigpy.zcl] [0xf8e8:1:0x0019] OTA upgrade progress: 0.0
2022-01-17 14:34:10 ERROR (MainThread) [zigpy_zigate.api] Received unhandled response 0x8012
2022-01-17 14:34:10 ERROR (MainThread) [zigpy_zigate.api] Received unhandled response 0x8012
2022-01-17 14:34:10 ERROR (MainThread) [zigpy_zigate.api] Received unhandled response 0x8012
2022-01-17 14:34:10 DEBUG (MainThread) [zigpy.zcl] [0xf8e8:1:0x0019] ZCL deserialize: <ZCLHeader frame_control=<FrameControl frame_type=CLUSTER_COMMAND manufacturer_specific=False is_reply=False disable_default_response=False> manufacturer=None tsn=6 command_id=3>
2022-01-17 14:34:10 DEBUG (MainThread) [zigpy.zcl] [0xf8e8:1:0x0019] ZCL request 0x0003: [0, 4151, 1, 4, 40, 48, None, None]
2022-01-17 14:34:10 DEBUG (MainThread) [zigpy.zcl] [0xf8e8:1:0x0019] OTA image_block handler for 'LiXee ZLinky_TIC': field_control=0, manufacturer_id=4151, image_type=1, file_version=4, file_offset=40, max_data_size=48, request_node_addr=Noneblock_request_delay=None
2022-01-17 14:34:10 DEBUG (MainThread) [zigpy.zcl] [0xf8e8:1:0x0019] OTA upgrade progress: 0.0
2022-01-17 14:34:10 ERROR (MainThread) [zigpy_zigate.api] Received unhandled response 0x8012
2022-01-17 14:34:10 ERROR (MainThread) [zigpy_zigate.api] Received unhandled response 0x8012
2022-01-17 14:34:11 ERROR (MainThread) [zigpy_zigate.api] Received unhandled response 0x8012
```

En tout cas, zigpy reconnait mon fichier, sait le lire car me dit clairement "je privilégie la V4 vs la V3", mais je sais pas pourquoi rien ne démarre :(

PS : je suis avec une zigate V1

max5962, 2022-01-17:
Bon j'en ai marre, je suis passé par un update manuel en physique  :
Après avoir lancé un "./DK6Programmer -s COM4 -P 115200 -Y -p .\ZLinky_router_v4.0.bin", j'ai eu ceci au bout de quelques secondes :

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

Malheureusement, après avoir TOUT remonté et rebranché :

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

Je sais plus quoi faire :(

fairecasoimeme, 2022-01-17:
Peux-tu re-télécharger le binaire ?
Peux tu interroger dans gérer les clusters, le cluster basic 0x0000 attribut 0x0001 et attribut 0x0006 ?

max5962, 2022-01-17:
Re-télecharger le binaire OTA :

```
 wget "https://github.com/fairecasoimeme/Zlinky_TIC/releases/download/v4.0/ZLinky_router_v4.0.ota"
--2022-01-17 20:08:57--  https://github.com/fairecasoimeme/Zlinky_TIC/releases/download/v4.0/ZLinky_router_v4.0.ota
Resolving github.com (github.com)... 140.82.121.4
Connecting to github.com (github.com)|140.82.121.4|:443... connected.
HTTP request sent, awaiting response... 302 Found
Location: https://objects.githubusercontent.com/github-production-release-asset-2e65be/406058893/f35de9c7-b77c-4c1a-a04f-5db932ee164a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 [following]
--2022-01-17 20:08:57--  https://objects.githubusercontent.com/github-production-release-asset-2e65be/406058893/f35de9c7-b77c-4c1a-a04f-5db932ee164a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
Resolving objects.githubusercontent.com (objects.githubusercontent.com)... 185.199.110.133, 185.199.111.133, 185.199.108.133, ...
Connecting to objects.githubusercontent.com (objects.githubusercontent.com)|185.199.110.133|:443... connected.
HTTP request sent, awaiting response... 200 OK
Length: 240046 (234K) [application/octet-stream]
Saving to: 'ZLinky_router_v4.0.ota'

ZLinky_router_v4.0.ota                               100%[===================================================================================================================>] 234.42K  --.-KB/s    in 0.04s

2022-01-17 20:08:58 (5.53 MB/s) - 'ZLinky_router_v4.0.ota' saved [240046/240046]

```

max5962, 2022-01-19:
@fairecasoimeme besoin de plus d'informations ?

kfran78, 2022-01-22:
existe il un tuto simple pour faire les MAJ via un PC, ou directement sur HA en OTA avec ZHA ?

kfran78, 2022-01-22:
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

Perso ayant reçu la clé aujourdhui et après Plug et config ZHA, le tout avec ma clé Conbee 2

J'ai mis dan smon fichier de config
zha:
  zigpy_config:
    ota:
      otau_directory: /config/zigpy_ota
      ikea_provider: false
      ledvance_provider: flase

#Pour le temps de la mise à jour
logger:
  default: info
  logs:
    homeassistant.components.zha: debug
    zigpy: debug

Créer le dossier /config/zigpy_ota et j'y ai mis le fichier V4.ota dedans.

J'ai re démarré, attendu 10mn au moins et sans rien lancé comme ligne de commande la mise à jour s'est faite toute seule :)

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

Constat dans les logs.

J'ai viré du fichier de config

logger:
  default: info
  logs:
    homeassistant.components.zha: debug
    zigpy: debug

et re démarré.

ça à l'air nickel

Peut être qua ta commande à doubler le processus et à fait bugger ...

cedsib, 2022-01-22:
Je confirme que ça a marché également :-)

Je colle le code ici avec la bonne indentation :

```
zha:
  zigpy_config:
    ota:
      ikea_provider: false                        # Auto update Trådfri devices
      ledvance_provider: false                    # Auto update LEDVANCE devices
      otau_directory: /config/zigpy_ota           # Utilize .ota files to update everything else
```

Par contre, question con : elle apporte quoi l'update. Il y a le changelog quelque part ?

max5962, 2022-01-22:
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

Je vais tenter en désactivant Ikea et ledvance mais j'ai un doute ^^

pdecat, 2022-01-22:
> Je vais tenter en désactivant Ikea et ledvance mais j'ai un doute ^^

J'ai les deux activés, ça ne vient pas de là...

pdecat, 2022-01-22:
As-tu tenté la réinitialisation en appuyant longtemps sur le bouton d'appairage ?

kfran78, 2022-01-23:
> 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
>
> Je vais tenter en désactivant Ikea et ledvance mais j'ai un doute ^^

As tu bien mis les lignes pour le debug dans le config yml comme j ai mis plus haut. A mettre le temps de la maj pour pouvoir suivre

pdecat, 2022-01-23:
@max5962 As-tu déjà vu l'OTA fonctionner pour d'autres appareils zigbee avec ta Zigate et ZHA ?

drlibre, 2022-01-23:
Pas de soucis pour flasher la v4.0 en OTA avec le firmware `.ota` dans un répertoire et la configuration ad-hoc dans le fichier de config Home Assistant (clé ConbeeII et intégration ZHA).
L'ajout des info de debug dans le log permet de suivre l'avancement de la mise à jour qui prend plusieurs minutes (compter une dizaine de minutes).

Suggestion d'amélioration pour la doc: indiquer le lien vers les firmware... ([Firmware](https://github.com/fairecasoimeme/Zlinky_TIC/releases))

max5962, 2022-01-23:
> @max5962 As-tu déjà vu l'OTA fonctionner pour d'autres appareils zigbee avec ta Zigate et ZHA ?

Je n'ai jamais fait attention à cela. Donc impossible à dire.
Peut être que le soucis viens de zigpy-zigate ?

max5962, 2022-01-23:
Ok

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

Yes of course :
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

Même si ça ne devrait pas influencer :)

fairecasoimeme, 2022-02-04:
works good on ZLinky firmware side

sebPomme, 2022-02-17:
@max5962 petite question, ton homeassistant est installé dans docker ?

max5962, 2022-02-17:
@sebPomme non plus maintenant. (DSM7 de Synology a coupé la maintenance des libraires USB non stockage)

sebPomme, 2022-02-17:
@max5962 ok merci

SylvainPer, 2022-02-18:
> @sebPomme non plus maintenant. (DSM7 de Synology a coupé la maintenance des libraires USB non stockage)

Il y a plusieurs solutions pour cela, j'utilise docker et indifféremment zigate/zzh (TI).
Il faut le driver qui correspond, par exemple, pour la zigate v2, il est présent, il suffit de le charger au startup (ftdio) : https://www.cachem.fr/synology-dsm-7-0-drivers-usb/

Pour la zigate v1, il faut du cp210x et pour les clés TI, ça fonctionne avec du ch341. Pour les ajouter : http://www.jadahl.com/

Closed 2022-02-04.

Thread 46 (2022-01-18):

Problem reading custom cluster 0xFF66

vk496, 2022-01-18:
Hello,

Some days ago my device stopped reading or reporting any attribute from custom cluster (`0xFF66`). I thought the problem come from the library where I was creating support for this device (Z2M, https://github.com/Koenkk/zigbee-herdsman-converters/pull/3493#issuecomment-1015546105) but the maintainer confirmed me that when I receive a `UNSUPPORTED_ATTRIBUTE`, it comes from the device itself. An example:

```Error: Read 0xfffffanfdadfadf/1 liXeePrivate(["currentTarif"], {"sendWhen":"immediate","timeout":10000,"disableResponse":false,"disableRecovery":false,"disableDefaultResponse":true,"direction":0,"srcEndpoint":null,"reservedBits":0,"manufacturerCode":4151,"transactionSequenceNumber":null,"writeUndiv":false}) failed (Status 'UNSUPPORTED_ATTRIBUTE')```

The firmware is v4. Already tried to reflash the device by serial.

Someone else have the same issue? Any way to debug what/why is happening?

Thanks in advance

drlibre, 2022-01-23:
Bonjour,
Problème aussi de lecture du cluster oxff66.
Utilisation du Zlinky avec ConbeeII et l'intégration ZHA.
Zlinky flashé en V4.0 via OTA (sans problème).
Pas d'accès au attributs du cluster oxff66 via "Gérer les Cluster".
Zlinky supprimé puis réappairé n'a pas résolu le problème...

kfran78, 2022-01-23:
On se parle de quelle entitée au final ? Suis aussi en V4 et même config hardware.

vk496, 2022-01-23:
@drlibre it was working to you before?

@kfran78 any attribute that come from `0xFF66` cluster

drlibre, 2022-01-23:
@vk496 No, it didn't work in V3.0. I've been told that it would in V4.0 but it seems not...

kfran78, 2022-01-24:
> @drlibre it was working to you before?
>
> @kfran78 any attribute that come from `0xFF66` cluster

Nope.

kikili, 2022-02-07:
I have the same issue with ZHA but only if I try to define the attributes in a quirk. If I don’t define those attributes then I can read them by issuing a read command directly. It means then I have to use zha.toolkit to get their value in HA as the list of attributes is not exposed

kikili, 2022-02-07:
I described my issue here, as I thought too it was an integration issue :

vk496, 2022-02-08:
In my case, it just happened from one day to other. I was not sure why it was not possible to read that attributes from 0xFF66 cluster.

At the beginning I thought it was something related with Z2M when I was developing the integration, but after @Koenkk confirmed me that this message comes from the device itself. So....

- I don't know why it happens
- Is not related with the platform used (@kikili confirm that in ZHA too)
- Is not clear how to reproduce it

However, @kikili you say that you are able to read them? what is the difference of setting up a quirk or not?

vk496, 2022-02-16:
@fairecasoimeme I found the problem for this.

https://github.com/Koenkk/zigbee2mqtt/issues/11431#issuecomment-1040450185

The device is not answering when the request is sent with `Manufacturer specific` flag in the ZCL header. I think Zigbee standard requires it for vendor specific clusters like 0xFF66.

Right now what I do in Z2M is forcing the requests without that header

kikili, 2022-02-16:
@vk496 Nice Job
@fairecasoimeme Will you release soon a new firmware correcting that issue or should we put that in quirks (for ZHA I mean as they already do the the job for MQTT)?

fairecasoimeme, 2022-02-17:
Hi, I have to verify and see the impact on all the plugins.
There is the same issue on ZHA ?
If you can fix with plugin, I think it's better for all plugins

kikili, 2022-02-17:
Well I’m pretty new with zha and not sure how I can override the fact it writes manufacturer specific flag in the quirk. Btw as it is supposed to be the spec. should it not be better to have it right at the source ?

Hedda, 2022-05-11:
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

FYI, this is still an issue for ZHA and according to the developers there it will need to be fixed by @fairecasoimeme in ZLinky_TIC firmware as per dicussions https://github.com/zigpy/zha-device-handlers/pull/1165 (which mention this as blocker) and https://github.com/zigpy/zha-device-handlers/issues/1146

Thread 48 (2022-01-19):

Utilisation d'une alimentation externe

pdecat, 2022-01-19:
Mon module ZLinky_TIC [arrêtant systématiquement de communiquer (et LED éteinte) au bout de quelques heures](https://github.com/fairecasoimeme/Zlinky_TIC/issues/42#issuecomment-1013297953) après avoir été branché, j'aimerais écarter la piste d'une alimentation trop faible due à la distance avec le reste de mon réseau Zigbee.

Est-il possible d'alimenter le module ZLinky_TIC avec une alimentation externe, au moins pour ces tests ?

PS: j'ai placé un routeur filaire (une [prise IKEA](https://zigbee.blakadder.com/Ikea_E1603.html)) juste au dessus du compteur et le ZLinky_TIC s'y connecte avec un LQI local de 255 entre les deux, mais cela ne change rien. Il essaie probablement de passer en direct pour obtenir un LQI total meilleur. La prise IKEA ne perd jamais la connexion elle.

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

fairecasoimeme, 2022-01-20:
Salut,
pour régler le problème des coupures systématiques, j'ai surement une solution matérielle. Peux-tu me contacter par mail ?
Fred

pdecat, 2022-02-02:
Hello @fairecasoimeme,

j'ai bien reçu le module ZLinky_TIC suite à ta modification, et je l'ai aussitôt branché. Pour le moment, tout est ok :crossed_fingers:

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

Le LQI semble plus élevé, peut-être dû à la nouvelle position dans laquelle j'ai mis l'antenne.

En quoi consistait la modification par curiosité ?

fairecasoimeme, 2022-02-02:
J'ai rajouté un condensateur et un superviseur de tension.

Fred

pdecat, 2022-02-02:
So far, so good. Merci :)

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

pdecat, 2022-02-04:
Je confirme que ça tout est ok désormais.

Closed 2022-02-04.

Thread 49 (2022-01-27):

Pairing problem

Baptiste-Leterrier, 2022-01-27:
Hello,

I have a problem adding the Zlinky to my Home Assistant

```
arch: aarch64
audio_input: null
audio_output: null
boot: true
image: ghcr.io/home-assistant/raspberrypi3-64-homeassistant
ip_address: 172.30.32.1
last_version: 2021.12.10
machine: raspberrypi3-64
port: 8123
ssl: false
update_available: true
version: 2021.12.9
version_latest: 2021.12.10
wait_boot: 600
watchdog: true
```

using ZHA (Zigbee Home Automation) and a zigate

I should mention that it worked on a previous version of HA OS and Zlinky firmware.

I recently upgraded the firmware to the last version (004) and flashed (reset) also.

I set ZHA in pairing mode and the zigate is 2m from the linky.

When I plug it the led blink a few time and then remain fix.

It is not found by ZHA. I then push on the pairing button for 10 second. The LED blinks like crazy for a few second then turn off, then on fixed. But still it is not detected. After that I cannot use the pairing button, it doesn't do anything until I physically unplug and plug back the Zlinky.

Did you have this issue before ?

Thanks

nlhomme, 2022-01-27:
Sounds like the hardware is faulty :(
@Baptiste-Leterrier and I upgraded our own zLinky in the same place with the same USB-TTL module (the red one).

Mine is working without any issue

Thread 51 (2022-02-08):

Zlinky neuf, clignote 8 fois, puis 9 fois, et recommence

T0ytoy, 2022-02-08:
Bonjour,

Je ne sais pas trop si une issue Github est le bon endroit pour poser la question, n'hésitez pas à me rediriger le cas échéant.
Ma Zlinky toute neuve se connecte sans soucis à Home Assistant, mais elle remonte toujours des valeurs aberrantes et qui ne changent jamais :

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

Connectée au compteur Linky, la ZLinky clignote 8 fois, puis quelques secondes fixe, puis 9 fois, puis fixe à nouveau et recommence. Si j'en crois la documentation, elle devrait soit clignoter 4 fois, soit être tout le temps allumer, donc je ne sais pas quoi en penser?

J'ai également tenté de la mettre à jour avec le firmware 4 : le flash se passe bien sur un rpi 3B+ avec la commande suivante :
`sudo ./DK6Programmer -s /dev/ttyUSB0 -P 115200 -Y -p ZLinky_router_v4.0.bin ZLinky_router_v4.0.bin`

mais l'affichage dans Home Assistant indique toujours une version 01... Y a-t-il un moyen de vérifier la version du firmware directement via l'utilitaire DK6Programmer par exemple ?
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

Est-ce un signe que l'appareil est défectueux, ou bien un problème de mon côté ? Pour info mon Linky est en mode historique, mais ça ne devrait pas poser de soucis.

EDIT : semble être semblable à l'issue #31 que je n'avais pas vu, je laisse mon issue ouverte et j'envoie en parralèle un mail à contact@lixee.fr, il est possible que ce soit un problème de matériel.

EDIT : un appel à l'attribue sw_build_id renvoie `4000-0004`, donc il semble que la maj du firmware se soit bien passé, au moins.

fairecasoimeme, 2022-02-09:
Bonjour,
Si le ZLinky_TIC ne cesse de clignoter c'est qu'il n'arrive pas à décoder les données du Linky.
Contactez-moi par mail pour un échange standard.
Fred

T0ytoy, 2022-02-09:
@fairecasoimeme mail envoyé hier soir à contact[AT]lixee.fr, merci d'avance ;)

fairecasoimeme, 2022-02-10:
Désolé mais je n'ai rien reçu. Essayez sur contact[at]zigate.fr

T0ytoy, 2022-02-10:
C'est renvoyé, merci ;)

fairecasoimeme, 2022-02-10:
cette fois-ci, bien reçu

T0ytoy, 2022-02-18:
Un A/R par la poste plus tard, le ZLinky fonctionne maintenant correctement et remonte des informations (testé sur 30 minutes pour le moment, sans soucis).
Merci !

dansch1973, 2022-03-13:
Bonjour,
J'ai le même problème. Mon Zlinky neuf, clignote 8 fois, puis 9 fois, et recommence
Cdt,

T0ytoy, 2022-03-13:
@dansch1973 problème réglé pour moi suite à un retour et réparation du zlinky. Il s'agissait à priori d'une diode mal soudée ou disfonctionnelle, je te recommande de contacter @fairecasoimeme ;)

Closed 2022-02-18.

Thread 52 (2022-02-11):

Flashing using CP2102 without 3,3V

capi92, 2022-02-11:
Bonjour,

Est-il possible de flasher en usb avec un CP2102 qui est 5V uniquement (i.e. pas de 3,3 V)?
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

Merci de votre aide.

Cdt

fairecasoimeme, 2022-02-11:
Non il faut du 3.3v pour flasher le ZLinky_TIC avec son port de prog

Closed 2022-02-11.

Thread 53 (2022-02-17):

Firmware version with USB TTL

sebPomme, 2022-02-17:
Salutations,
J'ai un soucis de version avec ma zigate et homeassistant.
Je suis passé de la version  v2, v3,et maintenant v4 [EDIT et v5 maintenant] (via USB TTL), mais Homeassitant indique : `Firmware: 0x00000001`.
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

Pourtant les cluster 0x0001 & 0x0006 m'indiquent que le firmware est bien à jour.
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

Une idée de comment arranger ça ?

Seb

pdecat, 2022-02-18:
Est-ce que ça aide de lancer une [recherche de mise à jour OTA](https://github.com/zigpy/zigpy/wiki/OTA-Device-Firmware-Updates#manually-initiating-ota-firmware-update) ?

```
service: zha.issue_zigbee_cluster_command
data:
  ieee: 00:00:00:00:00:00:00:00 # À mettre à jour
  endpoint_id: 1
  cluster_id: 25
  cluster_type: out
  command: 0
  command_type: client
  args:
    - 0
    - 100
```

sebPomme, 2022-02-18:
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

J'ai bien peur que mon installation ne me permette pas de faire de l'OTA pour le moment, j'ai déjà essayé mais les logs de progressions ne dépassent pas les 0.0% (je pense que le soucis provient du fait que mon installation soit dans docker, pure suppositions)

```
2022-02-17 19:18:23 DEBUG (SyncWorker_27) [zigpy.ota.provider] ImageKey(manufacturer_id=4151, image_type=1): /config/zigpy_ota/ZLinky_router_v5.0.ota, version: 5, hw_ver: (None, None), OTA string: OM15081-RTR-JN5189-0000000000000
2022-02-17 19:19:57 DEBUG (MainThread) [zigpy.zcl] [0x8361:1:0x0019] OTA query_next_image handler for 'LiXee ZLinky_TIC': field_control=0, manufacture_id=4151, image_type=1, current_file_version=1, hardware_version=None, model=ZLinky_TIC
2022-02-17 19:19:57 DEBUG (MainThread) [zigpy.zcl] [0x8361:1:0x0019] OTA image version: 5, size: 240478. Update needed: True
2022-02-17 19:19:57 DEBUG (MainThread) [zigpy.zcl] [0x8361:1:0x0019] OTA image_block handler for 'LiXee ZLinky_TIC': field_control=0, manufacturer_id=4151, image_type=1, file_version=5, file_offset=0, max_data_size=48, request_node_addr=Noneblock_request_delay=None
```

Donc je ne peux pas répondre à ta question

pdecat, 2022-02-18:
L'idée n'était pas de vraiment faire l'OTA via ce service, mais juste de lancer un check, et voir si ça rafraîchissait la valeur.

Mais dans la log, on voit qu'il y a bien un problème avec ce que retourne le ZLinky: `current_file_version=1`

sebPomme, 2022-02-18:
@pdecat autant pour moi. Les logs précédents date de quand mon zlinky était en v3.
J'ai fait le test et je peux confirmer qu'en v5 c'est toujours pareil:
```
2022-02-18 18:30:11 DEBUG (MainThread) [zigpy.zcl] [0x8361:1:0x0019] OTA query_next_image handler for 'LiXee ZLinky_TIC': field_control=0, manufacture_id=4151, image_type=1, current_file_version=1, hardware_version=None, model=ZLinky_TIC
2022-02-18 18:30:11 DEBUG (MainThread) [zigpy.zcl] [0x8361:1:0x0019] No OTA image is available
```

sdeluce, 2022-02-19:
Hola,
J'ai exactement le même problème, j'ai ouvert l'issue #50 sur le problème que je rencontre pour la mise à jour via le TTL quelque soit la version de firmware, en voyant cette issue, j'ai fait le test via l'OTA et j'ai exactement la même chose que @sebPomme.

```log
2022-02-19 15:37:28 DEBUG (MainThread) [zigpy.zcl] [0x4a33:1:0x0019] OTA query_next_image handler for 'LiXee ZLinky_TIC': field_control=0, manufacture_id=4151, image_type=1, current_file_version=1, hardware_version=None, model=ZLinky_TIC
[...]
2022-02-19 15:37:28 DEBUG (MainThread) [zigpy.zcl] [0x4a33:1:0x0019] OTA image version: 5, size: 240478. Update needed: True
2022-02-19 15:37:28 INFO (MainThread) [zigpy.zcl] [0x4a33:1:0x0019] Updating: LiXee ZLinky_TIC
[...]
2022-02-19 15:37:29 DEBUG (MainThread) [zigpy.zcl] [0x4a33:1:0x0019] OTA upgrade progress: 0.0
```

sebPomme, 2022-02-19:
@sdeluce j'aurais probablement du vérifier qu'une issue ne soit pas déjà ouverte, mes excuses. mes excuses pour ça.

En passant, petite aparté j'ai utilisé cette astuce https://github.com/fairecasoimeme/Zlinky_TIC/issues/18#issuecomment-1012368631 pour pouvoir mettre à jour la dernière information présente sur votre capture d'écran. Ça permet à d'indiquer à home-assistant d'aller questionner manuellement zlinky pour récupérer l'information (et ça permet de faire fonctionner les fonctionnalités `ENERGY` d'home-assistant).

---
Quelqu'un à des idées pour corriger le souci de version de firmware ?

sdeluce, 2022-03-15:
@sebPomme, merci pour l'astuce.
Pour le numéro de version, sur un autre module TIC commandé resemant, après mise à jour via OTA (car il n'y a pas de prise TTL sur ce dernier) le numéro de version affiché est bien celui de la version installée.

JeroLajHub, 2022-04-15:
Bonjour, je suis dans exactement la même situation avec un ZLinky de première génération acheté mi novembre 2021 et que j'ai initialisé seulement maintenant.

J'ai pu faire une mise à jour OTA directement en V5 avec TTL, après des tentatives par OTA infructueuses, et je suis maintenant dans la même situation que signalé dans cette conversation.

https://github.com/fairecasoimeme/Zlinky_TIC/issues/61#issue-1200434787

sebPomme, 2022-05-12:
Pour résumer.
Mise à jour via USB-TTL: fonctionnelle mais le numéro de version n'est pas mit à jour.
Mise à jour via OTA : Tout va bien

@fairecasoimeme il y a des chances pour que les deux firmware ne soient pas construit de la même façon ce qui expliquerait le problème ?

fairecasoimeme, 2022-05-13:
je vais faire des tests et je reviens vers vous

fairecasoimeme, 2022-05-13:
ma procédure :
J'ai flashé un ZLinky_tic en v4. Je l'ai appairé et demandé une requête au coordinateur pour récupérer la version (Cluster 0x0000 / propriété 0x0001). Il me retourne la valeur 4
J'ai ensuite téléchargé le firmware (v5 binaire) sur le github. J'ai flashé le firmware puis reappairé au coordinateur. J'ai relancé la requête pour récupérer la version et il me retourne bien 5

fairecasoimeme, 2022-05-13:
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
Je pense qu'il y a un problème de rafraichissement côté HA, si la requête pour demander la version fonctionne avec l'outil de cluster.

mospaeda, 2022-10-18:
Idem pour moi : Achat récent en version 9

ZLinky_TIC
par LiXee
Connecté via [Zigbee Coordinator]
Firmware: 0x00000001

From the cluster details it seems that it is different (in my case firmware 9 as I received last week)
reference from offcial doc : https://github.com/fairecasoimeme/Zlinky_TIC#clusters

Basic (Endpoint id: 1, Id: 0x0000, Type: in)
Valeur 9

sw_build_id (id: 0x4000)
4000-0009

date_code (id: 0x0006)
20220930

I don't know from where the value 0x00000001 is coming but it is probably not pointing to right register

sebPomme, 2023-05-10:
Je suis passé sous z2mqtt et je ne suis plus confronté au souci. Je ferme l'issue. Merci à tous

Closed 2023-05-10.

Thread 54 (2022-02-22):

unsupported device with Zigbee model 'ZLinky_TIC' and manufacturer name 'LiXee'

almostlunatic, 2022-02-22:
Hi,

Today, I received the long waited module for my Linky and pairing was successful. It appeared on Zigbee2MQTT (v.1.17.1-dev (zStack 12 20180815) (commit #084d6ba)) on my Domoticz v.2021.1 (build 14117) on an Intel NUC with Mint 20.3 as follows:

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

Clicking on it, no devices found:

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

On the Devices list with filtering, only one entry has appeared, and it's addition to the (I don't know why preseted) api_transort and includes the next info:

`{"dateCode": "20220117",
"description": "-", "friendly_name": "0x00158d0005d29a5e",
"hardwareVersion": 1, "ieeeAddr": "0x00158d0005d29a5e", "lastSeen":
1645537055443, "manufacturerID": 4151, "manufacturerName": "LiXee",
"model": "ZLinky_TIC\u0000", "modelID": "ZLinky_TIC\u0000",
"networkAddress": 47337, "powerSource": "Mains (single phase)",
"softwareBuildID": "4000-0004", "type": "Router", "vendor": "-"}`

When logging into Linux, the warnings for the Zegbee2MQTT are shown periodically:

`Zigbee2MQTT:warn  2022-02-22 14:42:49: Received message from unsupported device with Zigbee model 'ZLinky_TIC' and manufacturer name 'LiXee'`
`Zigbee2MQTT:warn  2022-02-22 14:42:49: Please see: https://www.zigbee2mqtt.io/how_tos/how_to_support_new_devices.html.`

All stacks are loaded successfully and are working:

`Zigbee2MQTT:info  2022-02-01 23:48:38: Logging to console and directory: '/opt/zigbee2mqtt/data/log/2022-02-01.23-48-31' filename: log.txt`
`Zigbee2MQTT:info  2022-02-01 23:48:39: Starting Zigbee2MQTT version 1.17.1-dev (commit #084d6ba)`
`Zigbee2MQTT:info  2022-02-01 23:48:39: Starting zigbee-herdsman (0.13.68)`
`Zigbee2MQTT:info  2022-02-01 23:48:45: zigbee-herdsman started`
`Zigbee2MQTT:info  2022-02-01 23:48:45: Coordinator firmware version: '{"meta":{"maintrel":3,"majorrel":2,"minorrel":6,"product":0,"revision":20180815,"transportrev":2},"type":"zStack12"}'`
`Zigbee2MQTT:info  2022-02-01 23:48:46: Currently 14 devices are joined:`

What could be a problem?

fairecasoimeme, 2022-02-22:
Hi,
Please see this :
https://gist.github.com/ralmn/02de46e193bf111062f15be07d3e9bd2

almostlunatic, 2022-02-22:
Thank you @fairecasoimeme !

I read from the first link:
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

Where could I get the file "lixee.js" and what shoul it continue?

almostlunatic, 2022-02-22:
Ok, but how about updating zigbee-herdsman to include your pull request? The mine is 0.13.68, the newest is 0.14.18.

antoinelibert, 2022-02-22:
ZLinky is supported natively by Z2M starting from version 1.23.x-DEV. Just upgrade Z2M to the latest 1.23.x series DEV version and you should have everything working right of the box.

almostlunatic, 2022-02-24:
Thank you vey much for your time and assistance!

What I did was
`git checkout HEAD -- npm-shrinkwrap.json`
`npm ci`

Among the results, I had many errors like:
`npm WARN EBADENGINE Unsupported engine {`
`npm WARN EBADENGINE   package: '@eslint/eslintrc@1.1.0',`
`npm WARN EBADENGINE   required: { node: '^12.22.0 || ^14.17.0 || >=16.0.0' },`
`npm WARN EBADENGINE   current: { node: 'v12.18.2', npm: '8.4.0' }`
`npm WARN EBADENGINE }`
`npm WARN EBADENGINE Unsupported engine {`
`npm WARN EBADENGINE   package: '@typescript-eslint/eslint-plugin@5.12.0',`
`npm WARN EBADENGINE   required: { node: '^12.22.0 || ^14.17.0 || >=16.0.0' },`
`npm WARN EBADENGINE   current: { node: 'v12.18.2', npm: '8.4.0' }`

And so 14 warnings. After it, I ran:
`nvm install 12.22.0`

Then I repeated `npn ci` and this time with no errors. So I decided to upgrade npm from 6.14.11 → 8.5.1:
`npm install -g npm`

And as result, I got no errors from ZLinky:

`Zigbee2MQTT:info  2022-02-24 20:57:37: MQTT publish: topic 'zigbee2mqtt/0x00158d0005d29a5e', payload '{"active_enerfy_out_d01":18870,"active_enerfy_out_d02":15257,"active_power":296,"active_power_max":1910,"active_power_ph_b":322,"apparent_power":278,"apparent_power_ph_b":65535,"available_power":9,"average_rms_voltage_meas_period":236,"current_date":"H220224205702","current_index_tarif":1,"current_price":"BASE","current_tarif":"BASE","current_tier10_summ_delivered":0,"current_tier3_summ_delivered":1941,"current_tier4_summ_delivered":2471,"current_tier5_summ_delivered":389,"current_tier6_summ_delivered":488,"current_tier7_summ_delivered":0,"current_tier8_summ_delivered":0,"current_tier9_summ_delivered":0,"drawn_v_a_max_n1":2010,"linkquality":42,"message1":"PAS DE MESSAGE","message2":"","meter_serial_number":"021775131322","power_threshold":9,"rms_current":1,"rms_current_ph_b":65535,"rms_current_ph_c":65535,"rms_voltage":235,"site_id":"24253690259961","software_revision":2,"status_register":"003A0001","update":{"state":"available"},"update_available":true}'
`

Now I don't have so many errors on Z2M output, only this one time after time:
`Zigbee2MQTT:error 2022-02-24 21:01:40: Failed to configure '0x00158d0005d29a5e', attempt 2 (Error: ConfigureReporting 0x00158d0005d29a5e/1 liXeePrivate([{"attribute":"activeEnerfyOutD01","minimumReportInterval":60,"maximumReportInterval":900,"reportableChange":100}], {"sendWhen":"immediate","timeout":10000,"disableResponse":false,"disableRecovery":false,"disableDefaultResponse":true,"direction":0,"srcEndpoint":null,"reservedBits":0,"manufacturerCode":null,"transactionSequenceNumber":null,"writeUndiv":false}) failed (Status 'SOFTWARE_FAILURE')
    at Endpoint.checkStatus (/opt/zigbee2mqtt/node_modules/zigbee-herdsman/src/controller/model/endpoint.ts:317:28)
    at Endpoint.configureReporting (/opt/zigbee2mqtt/node_modules/zigbee-herdsman/src/controller/model/endpoint.ts:694:22))`

I read from @fairecasoimeme links that it's necessary to replace poll interval in lixee.js from 120 to 60, was it wrong? There was 2 places to chenge it:
`const seconds = options && options.measurement_poll_interval ? options.measurement_poll_interval : 60;`

As a result, I have now one device appaired for the HW ZLinky_TIC:

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

But not any other attributes to be subscribed. What should I do next?

vk496, 2022-02-28:
Hello @almostlunatic

I'm the guy who spend my money and time to make a great support for this device (patching Z2M project, OTA, non-standard clusters of this device, etc). Currently all my changes are in DEV. I suggest you to wait for tomorrow and install the stable version 1.24.0

Your problem for SOFTWARE_FAILURE probably come from here: https://github.com/fairecasoimeme/Zlinky_TIC/issues/40

almostlunatic, 2022-02-28:
Thank you @vk496! I'm very grateful for your efforts, I hope that it will wotk out!

almostlunatic, 2022-03-04:
Hi @vk496,

I updated to v 1.24.0, but nothong has changed.

I still have only the Ling Quality on the devices list for ZLink_TIC:

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

And errors on Logs:

` 2022-03-04 15:25:42.037 Error: ZigbeeHW: 0x00158d0005d29a5e: can not process feature type "text"
2022-03-04 15:25:42.037 Error: ZigbeeHW: 0x00158d0005d29a5e: can not process feature type "text"
2022-03-04 15:25:42.037 Error: ZigbeeHW: 0x00158d0005d29a5e: can not process feature type "text"
2022-03-04 15:25:42.038 Error: ZigbeeHW: 0x00158d0005d29a5e: can not process numeric item "NTARF"
2022-03-04 15:25:42.038 Error: ZigbeeHW: 0x00158d0005d29a5e: can not process numeric item "VTIC"
2022-03-04 15:25:42.038 Error: ZigbeeHW: 0x00158d0005d29a5e: can not process feature type "text"
2022-03-04 15:25:42.038 Error: ZigbeeHW: 0x00158d0005d29a5e: can not process numeric item "EAST"
2022-03-04 15:25:42.038 Error: ZigbeeHW: 0x00158d0005d29a5e: can not process numeric item "EASF01"
2022-03-04 15:25:42.038 Error: ZigbeeHW: 0x00158d0005d29a5e: can not process numeric item "EASF02"
2022-03-04 15:25:42.038 Error: ZigbeeHW: 0x00158d0005d29a5e: can not process numeric item "EASF03"
2022-03-04 15:25:42.039 Error: ZigbeeHW: 0x00158d0005d29a5e: can not process numeric item "EASF04"
2022-03-04 15:25:42.040 Error: ZigbeeHW: 0x00158d0005d29a5e: can not process numeric item "EASF05"
2022-03-04 15:25:42.040 Error: ZigbeeHW: 0x00158d0005d29a5e: can not process numeric item "EASF06"
2022-03-04 15:25:42.040 Error: ZigbeeHW: 0x00158d0005d29a5e: can not process numeric item "EASF07"
2022-03-04 15:25:42.040 Error: ZigbeeHW: 0x00158d0005d29a5e: can not process numeric item "EASF08"
2022-03-04 15:25:42.040 Error: ZigbeeHW: 0x00158d0005d29a5e: can not process numeric item "EASF09"
2022-03-04 15:25:42.040 Error: ZigbeeHW: 0x00158d0005d29a5e: can not process numeric item "EASF10"
2022-03-04 15:25:42.040 Error: ZigbeeHW: 0x00158d0005d29a5e: can not process numeric item "EASD01"
2022-03-04 15:25:42.043 Error: ZigbeeHW: 0x00158d0005d29a5e: can not process numeric item "EASD02"
2022-03-04 15:25:42.043 Error: ZigbeeHW: 0x00158d0005d29a5e: can not process numeric item "EASD03"
2022-03-04 15:25:42.043 Error: ZigbeeHW: 0x00158d0005d29a5e: can not process numeric item "EASD04"
2022-03-04 15:25:42.044 Error: ZigbeeHW: 0x00158d0005d29a5e: can not process numeric item "IRMS1"
2022-03-04 15:25:42.044 Error: ZigbeeHW: 0x00158d0005d29a5e: can not process numeric item "URMS1"
2022-03-04 15:25:42.044 Error: ZigbeeHW: 0x00158d0005d29a5e: can not process numeric item "PREF"
2022-03-04 15:25:42.044 Error: ZigbeeHW: 0x00158d0005d29a5e: can not process feature type "text"
2022-03-04 15:25:42.044 Error: ZigbeeHW: 0x00158d0005d29a5e: can not process numeric item "PCOUP"
2022-03-04 15:25:42.044 Error: ZigbeeHW: 0x00158d0005d29a5e: can not process numeric item "CCASN"
2022-03-04 15:25:42.044 Error: ZigbeeHW: 0x00158d0005d29a5e: can not process numeric item "CCASN-1"
2022-03-04 15:25:42.044 Error: ZigbeeHW: 0x00158d0005d29a5e: can not process numeric item "UMOY1"
2022-03-04 15:25:42.044 Error: ZigbeeHW: 0x00158d0005d29a5e: can not process numeric item "SINSTS"
2022-03-04 15:25:42.044 Error: ZigbeeHW: 0x00158d0005d29a5e: can not process numeric item "SMAXN"
2022-03-04 15:25:42.045 Error: ZigbeeHW: 0x00158d0005d29a5e: can not process numeric item "SMAXN-1"
2022-03-04 15:25:42.045 Error: ZigbeeHW: 0x00158d0005d29a5e: can not process feature type "text"
2022-03-04 15:25:42.045 Error: ZigbeeHW: 0x00158d0005d29a5e: can not process feature type "text"
2022-03-04 15:25:42.048 Error: ZigbeeHW: 0x00158d0005d29a5e: can not process feature type "text"
2022-03-04 15:25:42.048 Error: ZigbeeHW: 0x00158d0005d29a5e: can not process numeric item "DPM1"
2022-03-04 15:25:42.048 Error: ZigbeeHW: 0x00158d0005d29a5e: can not process numeric item "FPM1"
2022-03-04 15:25:42.048 Error: ZigbeeHW: 0x00158d0005d29a5e: can not process numeric item "DPM2"
2022-03-04 15:25:42.048 Error: ZigbeeHW: 0x00158d0005d29a5e: can not process numeric item "FPM2"
2022-03-04 15:25:42.049 Error: ZigbeeHW: 0x00158d0005d29a5e: can not process numeric item "DPM3"
2022-03-04 15:25:42.049 Error: ZigbeeHW: 0x00158d0005d29a5e: can not process numeric item "FPM3"
2022-03-04 15:25:42.049 Error: ZigbeeHW: 0x00158d0005d29a5e: can not process numeric item "RELAIS"
2022-03-04 15:25:42.049 Error: ZigbeeHW: 0x00158d0005d29a5e: can not process numeric item "NJOURF"
2022-03-04 15:25:42.049 Error: ZigbeeHW: 0x00158d0005d29a5e: can not process numeric item "NJOURF+1"
2022-03-04 15:25:42.049 Error: ZigbeeHW: 0x00158d0005d29a5e: can not process feature type "text"
2022-03-04 15:25:42.049 Error: ZigbeeHW: 0x00158d0005d29a5e: can not process feature type "text" `

What shlud I do next?

vk496, 2022-03-04:
Did you removed the old external-converter?
Also, I suggest to manually set the device config (specific options) and restart Z2M to take effect, since auto detection is not fully implemented

almostlunatic, 2022-03-04:
I always restart Z2M after any change, but never manually set the device config... Can you, please, remember me, how to do it, and how to remove the old external-converter and having the new one? My head seems to blow up with everythin, because there are many other issues too to reslove...

vk496, 2022-03-04:
well, I don't know what exactly do you use, since I don't recognize that Z2M frontend. But basically, you had to undo https://github.com/fairecasoimeme/Zlinky_TIC/issues/54#issuecomment-1047929265

And set the specifc option in the tab near to other options like Binding, Reporting or Exposes

almostlunatic, 2022-03-04:
Ok, I stopped Z2M, renamed lixee.js to lixee.js.old, removed
`external_converters:`
`- converters/lixee.js`

from the configuration.yaml and restarted Z2M. But all is the same!

almostlunatic, 2022-03-04:
Zlincy TIC sends always correct data, but Z2M doesn't seem to recognize it.

`Zigbee2MQTT:info  2022-03-04 16:14:22: MQTT publish: topic 'zigbee2mqtt/0x00158d0005d29a5e', payload '{"active_enerfy_out_d01":18910,"active_enerfy_out_d02":15257,"active_power":164,"active_power_max":700,"active_power_ph_b":190,"apparent_power":221,"apparent_power_ph_b":65535,"available_power":9,"average_rms_voltage_meas_period":233,"current_date":"H220304161347","current_index_tarif":1,"current_price":"BASE","current_summ_delivered":34167,"current_tarif":"BASE","current_tier10_summ_delivered":0,"current_tier4_summ_delivered":2471,"current_tier5_summ_delivered":389,"current_tier6_summ_delivered":488,"current_tier7_summ_delivered":0,"current_tier8_summ_delivered":0,"current_tier9_summ_delivered":0,"drawn_v_a_max_n1":1580,"linkquality":44,"message1":"PAS DE MESSAGE","message2":"","meter_serial_number":"021775131322","power_threshold":9,"rms_current":1,"rms_current_ph_b":65535,"rms_current_ph_c":65535,"rms_voltage":234,"site_id":"24253690259961","software_revision":2,"status_register":"003A0001","update":{"state":"idle"},"update_available":false}'
`

vk496, 2022-03-04:
What I see there is a zlinky working correctly.... Maybe you just need to set your specific config

almostlunatic, 2022-03-04:
I don't know how to set the specific config :-(

antoinelibert, 2022-03-04:
I think there is some misunderstanding here. @almostlunatic seems to use Domoticz (not Home Assistant) with Z2M. While HomeAssistant+Z2M+ZLinky is fully compatible, I'm not sure it works with Domoticz+Z2M+ZLinky. My guess is that you need support for ZLinky for Domoticz too? You should ask on the Domoticz project.

antoinelibert, 2022-03-04:
Ok, I have looked around and it seems like Domoticz doesn't support ZLinky via Z2M yet. Someone else has the same issue: https://github.com/domoticz/domoticz/issues/5183.

almostlunatic, 2022-03-04:
Yes, thank you! That's cpuld be the problem, of course! There are some blogs that assure that ZLinky is supported for Domoticz with Zigate. I have one, so I will give it a try. And let you know. Thank you take my attention on it!

almostlunatic, 2022-03-07:
So, after installing ZiGate+, ZLinky started to add some properties to domoticz. Although, not everything and not very well, but still. So, thank you very much!

hergonoway, 2022-03-10:
Hello, currently using HomeAssistant+Z2M+ZLinky

On my Linky, contract is set to "HC SEM WE MERCR", TIC is set to "HISTORIQUE" and all infos on my Linky are split between HC and HP, for Semaine, Mercredi and WE. My contract is "Mes Jours Zen Plus" by EDF

but whatever  I choose in device config (specific options), I always end up with :
OPTARIF : BASE
PAPP : <the right value>
BASE : <which correspond to 'INDEX MID' on my Linky>
ISOUSC : 30 (<- instead of 6 on my Linky)

every other info like, HP Semaine, HC semaine, HP WE, HC WE, or any other split value from my linky doesn't show up anywhere whatever the device config I choose.

I've tried to avoid any 'auto' config my choosing "historique", "single_phase" and "false" (production), but the result is the same.

vk496, 2022-03-10:
Set your current TIC mode manually (mode,phase,production) in specific options and restart Z2M. I suppose you're looking for current_price, which tells you if you are in low or high prices. I don't remember if that attribute is available in historique (you could try setting up standard just for test purpose and see if you have that info, in which case the code should be fixed). If is not available, that means a limitation from the mode itself, and you need call/request your energy provider in order to switch mode to standard (you can't request it directly to Enedis via web)

hergonoway, 2022-03-10:
> Set your current TIC mode manually (mode,phase,production) in specific options and restart Z2M. I suppose you're looking for current_price, which tells you if you are in low or high prices. I don't remember if that attribute is available in historique (you could try setting up standard just for test purpose and see if you have that info, in which case the code should be fixed). If is not available, that means a limitation from the mode itself, and you need call/request your energy provider in order to switch mode to standard (you can't request it directly to Enedis via web)

already tried all the modes in auto or manually set on mode, phase and production, and ofc with a restart of Z2M each time -> same result.

I'm not looking for "current_price" especially, but I'd like to be able to monitor my consumption in HC/HP during the week, HC/HP on wednesday and HC/HP during the weeking. Currently I only have the sumup of everything...

changing TIC mode has to be request by  EDF to Enedis irrc and they would certainly charge me for it... but if I need to switch to Standard TIC in order to gather data from an "HC SEM WE MERCR" contrat, I'd do it.

any other thing to try before trying to change TIC mode? I'd like to be sure that nothing's wrong with my Lixee nor Z2M before doing that.

vk496, 2022-03-10:
Take in account that the tarif mode is just a filter to reduce useless attributes for your mode (if I'm in HC/HP, I don't care about colour days for example).

In your case, could you please setup all your config manually (without the tarif filter) and share some screenshot of what you have and what you miss exactly? Thnks

hergonoway, 2022-03-10:
> Take in account that the tarif mode is just a filter to reduce useless attributes for your mode (if I'm in HC/HP, I don't care about colour days for example).
>
> In your case, could you please setup all your config manually (without the tarif filter) and share some screenshot of what you have and what you miss exactly? Thnks

all in manual without tarif filter like :
linky_mode : historique
energy_phase : single_phase
production : false
tarif : auto

?

vk496, 2022-03-10:
Ok, what you're looking for is current_tierX values, which are 0 on your side. In your Linky screen you can see that values? Do you have them in the reportings section (subscription)? If you try to read them manually with the console tab, they still reports 0?

hergonoway, 2022-03-10:
> Ok, what you're looking for is current_tierX values, which are 0 on your side. In your Linky screen you can see that values? Do you have them in the reportings section (subscription)? If you try to read them manually with the console tab, they still reports 0?

**In your Linky screen you can see that values?**
--> yes , I've got the following screens :
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
(in that order after the contrat type "HC SEM WE MERCRE")

**Do you have them in the reportings section (subscription)?**
 --> no (never touched that section)
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

but if you meant if there're available, it seems to be the case for the cluster seMetering (I didn't add any, I've just made a screenshot)
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

**If you try to read them manually with the console tab, they still reports 0?**
--> not for current_tier**1**SummDelivered but yes from current_tier**2**SummDelivered to current_tier**10**SummDelivered :
`Read result of 'seMetering': {"currentTier1SummDelivered":[0,11960503],"currentTier2SummDelivered":[0,0],"currentTier3SummDelivered":[0,0],"currentTier4SummDelivered":[0,0],"currentTier5SummDelivered":[0,0]...`

From current_tier**11**SummDelivered up to current_tier**15**SummDelivered it returns:
`failed (Status 'UNSUPPORTED_ATTRIBUTE')`
same error goes for all current_tierXSumm**Received**. (Received not Delivered)

fairecasoimeme, 2022-03-11:
Hi,
You have to change to the standard mode. The Historic mode is not compatible with this kind of  subscription. Historic mode is an old mode and only BASE, HCHP et tarif bleu is compatible.

Fred

hergonoway, 2022-03-11:
> Hi, You have to change to the standard mode. The Historic mode is not compatible with this kind of subscription. Historic mode is an old mode and only BASE, HCHP et tarif bleu is compatible.
>
> Fred

thanks for the feedback, I'll ask to change TIC mode then. Maybe you could add this to the main page, it may help others with exotic subscription like me

Thread 58 (2022-03-19):

Problème de ré-appairage - finit par réussir - erreurs protocole

mdeweerd, 2022-03-19:
Je relate ma problématique d'appairage du ZLinky avec des éléments techniques .
Alors que j'étais en train de décrire ceci, l'appairage a miraculeusement réussi.

# Problématique d'appairage

Après une première association, une mise à jour et une suppression du ZLinky du réseau pour forcer un nouvel appairage, je ne parvenais plus à appairer.

Visiblement il assurait encore un rôle de Routeur (observé par sniffer), mais les tentatives d'appairage n'ont pas menés à une ré-intégration au niveau de ZHA, ou c'est zigpy qui contrôle un CC2531 avec un ZStack 3.0 de KKoenk.

Je n'ai pas ce genre de comportement avec d'autres objets qui ont subit le même traitement, mais pour ces objets je peux initier un appairage par appui d'un bouton quelconque, alors que le ZLinky n'en a pas.

Historique des opérations depuis la réception du ZLinky:

- Installation sur Linky - OK;
- Association dans HA - OK;
- "Scan device" avec zha-toolkit - semi-ok car pas de réponse à Discover Attributes, Discover Commands;
- Constat que la version était à 01 - expliquant éventuellement les valeurs impossibles : >65000V, -32000W, etc.
- Mise à jour par OTA - OK
- La version était confirmé à 05 avec une date_code en février, mais toujorus des valeurs impossibles.
- Enlèvmeent et remise du ZLinky dans le Linky pour provoquer un redémarrage - OK
- Lz ZLinky est à nouveau interrogéable, mais pas d'évolution au niveau des valeurs "extrêmes".
- Je constate bon nombre de requêtes Zigbee de type "Configure Reporting" où les réponses du ZLinky sont défavorables (la configuration n'est pas acceptée).
- Le "Scan device" avec zha-toolkit ne donne toujours pas la liste des attributs - semi-ok (pas d'erreurs, mais pas le détail des attributs);
- Je décide de tenter une commande "Factory Reset" (=cluster 0/commande 0).  Le ZLinky confirme la commande ("Success"), mais je ne constate aucun effet: le ZLinky est toujours dans le réseau et son comportement semble le même.
- Pour le réassocier, sous Homa Assistante je fais "Remove Device".  Le ZLinky disparrait de la liste des objets Zigbee associés.

La dernière information que j'ai dans la trace de HomeAssistant pour le ZLinky est (après le factory reset):

```
2022-03-19 00:51:55 DEBUG (MainThread) [custom_components.zha_toolkit.utils] registry_device DeviceEntry(area_id='cuisine', config_entries={'e876e09df16c5319d7a09650f914276c'}, configuration_url=None, connections={('zigbee', '00:15:8d:00:05:d2:99:ea')}, disabled_by=None, entry_type=None, id='e36d5820afc30475064d5abe45afaa6e', identifiers={('zha', '00:15:8d:00:05:d2:99:ea')}, manufacturer='LiXee', model='ZLinky_TIC', name_by_user=None, name='LiXee ZLinky_TIC', suggested_area=None, sw_version='0x00000005', hw_version=None, via_device_id='26851989eb8070e67ce5d95a26c6a241', is_new=False)
```

Dans les traces de mon sniffer j'ai bien une demande "Leave":
```
    ZigBee Security Header
        Security Control Field: 0x28, Key Id: Network Key, Extended Nonce
            ...0 1... = Key Id: Network Key (0x1)
            ..1. .... = Extended Nonce: True
        Frame Counter: 26168
        Extended Source: Jennic_00:05:d2:99:ea (00:15:8d:00:05:d2:99:ea)
        Key Sequence Number: 0
        Message Integrity Code: a15075a9
        [Key: XXXXX]
        [Key Label: 2]
    Command Frame: Leave
        Command Identifier: Leave (0x04)
        ..0. .... = Rejoin: False
        .0.. .... = Request: False
        0... .... = Remove Children: False
```

Et une confirmation:
```
ZigBee Application Support Layer Command
    Frame Control Field: Command (0x01)
        .... ..01 = Frame Type: Command (0x1)
        .... 00.. = Delivery Mode: Unicast (0x0)
        ..0. .... = Security: False
        .0.. .... = Acknowledgement Request: False
        0... .... = Extended Header: False
    Counter: 96
    Command Frame: Update Device
        Command Identifier: Update Device (0x06)
        Device Address: Jennic_00:05:d2:99:ea (00:15:8d:00:05:d2:99:ea)
        Device Address: 0x145d
        Device Status: Device left (0x02)
```

Juste après je vois une demande d'association, confirmée par le coordinateur

```
    Sequence Number: 131
    Destination PAN: 0x880a
    Destination: Jennic_00:05:d2:99:ea (00:15:8d:00:05:d2:99:ea)
    Extended Source: SiliconL_ff:fe:6d:7f:8a (bc:33:ac:ff:fe:6d:7f:8a)
    Command Identifier: Association Response (0x02)
    Association Response
        Short Address: 0x7546
        Association Status: 0x00 (Association Successful)
    Frame Check Sequence (TI CC24xx format): FCS OK
        RSSI: 20dB
        FCS Valid: True
        LQI Correlation Value: 107
```

Et c'est suivi par:
```
    ZigBee Security Header
        Security Control Field: 0x20, Key Id: Link Key, Extended Nonce
            ...0 0... = Key Id: Link Key (0x0)
            ..1. .... = Extended Nonce: True
        Frame Counter: 90580
        Extended Source: SiliconL_ff:fe:6d:7f:8a (bc:33:ac:ff:fe:6d:7f:8a)
        Message Integrity Code: 4c120659
        [Key: 5a6967426565416c6c69616e63653039]
        [Key Label: Std Trust Center link key]
    Command Frame: Update Device
        Command Identifier: Update Device (0x06)
        Device Address: Jennic_00:05:d2:99:ea (00:15:8d:00:05:d2:99:ea)
        Device Address: 0x7546
        Device Status: Standard security, unsecured join (0x01)
```

C'est le même type de paquet et la même addresse courte que j'observe se matin: "Update Device".
Je pense que le problème est là:
1. Le "Device Announement" est absent, c'est un élément important du processus d'appairage.
2. La clef standard est utilisé pour la commande "Update Device".

Lors de la première Association il y a bien eu un Device Announcement, et ce avec la clef dédié au réseau:
```
ZigBee Application Support Layer Data, Dst Endpt: 0, Src Endpt: 0
    Frame Control Field: Data (0x08)
        .... ..00 = Frame Type: Data (0x0)
        .... 10.. = Delivery Mode: Broadcast (0x2)
        ..0. .... = Security: False
        .0.. .... = Acknowledgement Request: False
        0... .... = Extended Header: False
    Destination Endpoint: 0
    Device Announcement (Cluster ID: 0x0013)
    Profile: ZigBee Device Profile (0x0000)
    Source Endpoint: 0
    Counter: 229
ZigBee Device Profile, Device Announcement, Nwk Addr: Jennic_00:05:d2:99:ea
    Sequence Number: 165
    Nwk Addr of Interest: 0x145d
    Extended Address: Jennic_00:05:d2:99:ea (00:15:8d:00:05:d2:99:ea)
    Capability Information: 0x8e
        .... ...0 = Alternate Coordinator: False
        .... ..1. = Full-Function Device: True
        .... .1.. = AC Power: True
        .... 1... = Rx On When Idle: True
        .0.. .... = Security Capability: False
        1... .... = Allocate Short Address: True
```

~Me voilà don très embêté pour utiliser ce poroduit.~

Alors que j'étais en train d'associer un autre appareil qqs heures plus tard, le Device Announcement s'est mystérieusement réalisé:
```
ZigBee Device Profile, Device Announcement, Nwk Addr: Jennic_00:05:d2:99:ea
    Sequence Number: 70
    Nwk Addr of Interest: 0x06a7
    Extended Address: Jennic_00:05:d2:99:ea (00:15:8d:00:05:d2:99:ea)
    Capability Information: 0x8e
        .... ...0 = Alternate Coordinator: False
        .... ..1. = Full-Function Device: True
        .... .1.. = AC Power: True
        .... 1... = Rx On When Idle: True
        .0.. .... = Security Capability: False
        1... .... = Allocate Short Address: True

```

lui même apparu après une "Association Request" suivi d'une "Association Response".

C'est pas l'idéal tout cela, mais au moins je ne suis pas bloqué.

J'imagine qu'à l'aide d'une trombone j'aurai pu forcer une réinitialisation à travers le trou le plus près des broches.

fairecasoimeme, 2022-03-21:
Bonjour,

Vous avez effectuer un leave avec l'option not rejoin ce qui explique que le module ne rejoigne pas le coordinateur.
Pour remettre à zéro le ZLinky_TIC il faut tout simplement appuyer 10 sec sur le bouton. l'appairage devient alors possible.

mdeweerd, 2022-03-21:
C'est peut-être une explication, mais ce n'est pas comme cela que le module devrait fontionner:
- Il n'a pas quitté le réseau;
- Il continuait à jouer son rôle de routeur;
- La clef secrete - au moins pour la commande update_device - est incorrect.

Closed 2022-03-21.

Thread 59 (2022-03-29):

Certaines valeurs ne remontent pas

batchmanfr, 2022-03-29:
Bonjour,

En mode Standard Triphasé, je constate que seules certaines valeurs remontent dans Home Assistant (via Z2M) :
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

Donc aucune info sur la consommation en kWh... et par conséquent pas de suivi de la consommation dans l'onglet Energie de Home Assistant donc, même si j'imagine qu'une bidouille dans le style de ce que propose @skanx pour sha doit être possible (https://github.com/fairecasoimeme/Zlinky_TIC/issues/18#issuecomment-1021186192)

En cherchant bien, j'ai réussi à trouver la consommation totale dans les attributs d'états des différentes entités (exemple ici pour l'entité IRMS1) :
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
Mais l'info n'est pas identifiée comme entité à part entière, et surtout, je n'ai aucun détail (je suis en HP/HC, je devrais donc avoir selon la doc EASF01 pour le compteur HP et EASF02 pour le compteur HC)

Une idée de ce qui bloque ? Un paramétrage de la Zlinky ou du module Zigbee2MQTT?

Merci !

fairecasoimeme, 2022-03-30:
Bonjour,
L'information EASF01 et EASF02 est nommé :
currentTier1SummDelivered et currentTier2SummDelivered dans Z2M

vous pouvez vérifier si ces valeurs existent dans votre fichier.

Dans tous les cas cela ne concerne pas le ZLinky mais plutôt le module Zigbee2MQTT

@vk496 une idée ?

vk496, 2022-03-30:
@batchmanfr could you check what is exposed in Z2M (not Home Assistant)?

Standard+Triphase should report EASFXX as attribute

vk496, 2022-03-30:
btw, did you forced the zlinky config acording to your linky and rebooted Z2M?

batchmanfr, 2022-03-30:
Thx @fairecasoimeme @vk496 for your answer.

I've forced the zlinky config his way :
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
Btw I've tried "auto" configuration and the values that show up in Z2M are the same.

This is what I see on the z2m logs :
`MQTT publish: topic 'zigbee2mqtt/ZLinky', payload '{"active_power_max":3599,"active_power_max_ph_b":4402,"active_power_max_ph_c":4162,"apparent_power":133,"apparent_power_ph_b":231,"apparent_power_ph_c":155,"average_rms_voltage_meas_period":235,"average_rms_voltage_meas_period_ph_c":234,"average_rms_voltage_measure_period_ph_b":235,"current_summ_delivered":48825.2,"current_tarif":"H PLEINE/CREUSE","drawn_v_a_max_n1":3465,"drawn_v_a_max_n1_p2":2017,"drawn_v_a_max_n1_p3":2979,"linkquality":90,"rms_current":1,"rms_current_ph_b":1,"rms_current_ph_c":1,"rms_voltage":236,"rms_voltage_ph_b":235,"rms_voltage_ph_c":233,"status_register":"003A4401","update":{"state":"idle"},"update_available":false}'`

So I've a `current_summ_delivered` value (that is not exposed in Z2M), but no EASFXX attribute :
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

batchmanfr, 2022-04-01:
Hi,
This issue have been resolved with Z2M version 1.25.0-1 released today.
Seems to be the @SilenT-FR pulls on zigbee-herdsman-converters repository that solved this :
https://github.com/Koenkk/zigbee-herdsman-converters/pull/3946
https://github.com/Koenkk/zigbee-herdsman-converters/pull/3950
https://github.com/Koenkk/zigbee-herdsman-converters/pull/3951

Thank you for your help.

A bientôt !
Florian

SilentT19, 2022-04-02:
your welcome

SilentT-FR, 2022-04-02:
your welcome

Closed 2022-04-01.

Thread 62 (2022-04-30):

consommation a 0VA

sheep300, 2022-04-30:
Bonjour,
Je suis sur un compteur Linky en historique (passage en standard demandé)
mon Zlinky est en version 4000-0005 sur un Z2MQTT.
je possède un petit panneau photovoltaïque de 300VA, ce matin ma consommation est tombé sur le compteur Linky a 0VA hors je me suis rendu compte que le Zlinky m'annonçait toujours 260VA soit la dernière mesure avant le passage a 0VA dans les log du Z2M : "apparent_power":260 apparait toujours dans la trame.
cela c'est reproduit a plusieurs reprise avec des 270VA 320VA toujours il reste sur la dernière valeur avant le 0VA
c'est comme si le 0 n'était pas une valeur pour le Zlinky
merci par avance

sheep300, 2022-04-30:
voila ce que j'ai dans les log j'ai l'impression que c'est contradictoire
```
Debug Received Zigbee message from 'zlinky', type 'attributeReport', cluster 'haElectricalMeasurement', data '{"apparentPower":0}' from endpoint 1 with groupID null

Debug Received Zigbee message from 'zlinky', type 'attributeReport', cluster 'haElectricalMeasurement', data '{"apparentPower":310}' from endpoint 1 with groupID null

Info MQTT publish: topic 'zigbee2mqtt/zlinky', payload '{"active_register_tier_delivered":"HC..","apparent_power":310,"available_power":30,"current_tarif":"HC..","current_tier1_summ_delivered":12501.313,"current_tier2_summ_delivered":12287.491,"device":{"applicationVersion":5,"dateCode":"20220217","friendlyName":"zlinky","hardwareVersion":1,"ieeeAddr":"0x00158d0005d2a090","manufacturerID":4151,"manufacturerName":"LiXee","model":"ZLinky_TIC","networkAddress":9143,"powerSource":"Mains (single phase)","softwareBuildID":"4000-0005","stackVersion":2,"type":"Router","zclVersion":3},"linkquality":255,"meter_serial_number":"811961759844","rms_current":1,"rms_current_max":90,"update":{"state":"idle"},"update_available":false}'
```

STaN33130, 2022-06-08:
Bonjour, exactement la même config, exactement le même problème, avez vous trouvé une solution ?

fairecasoimeme, 2022-07-12:
Je vais regarder mais c'est bizarre car je ne fais que renvoyer ce que le Linky envoie.

STaN33130, 2022-07-12:
Merci beaucoup. Je n’avais pas ce problème avant lorsque j’utilisais deconz. C’est depuis zigbee2mqtt

fairecasoimeme, 2022-07-12:
Du coup, je pense que c'est côté Z2M. je suis en train de regarder le code mais pas trouvé

fairecasoimeme, 2022-07-12:
Je confirme que le problème ne vient pas du ZLinky, je viens de faire le test en faisant varier la valeur de 0 à 12VA puis à nouveau 0. Le ZLinky envoie bien les bonnes valeurs.

une idée @vk496 ?

sheep300, 2022-07-15:
bonjour ne serais-ce pas les valeur negatives qui lui pose probleme ?
merci en tout cas pour vos retour

STaN33130, 2022-07-20:
Je pensais pareil. Personne n'a d'idées?

vk496, 2022-08-31:
Hi,

The problem is solved?

STaN33130, 2022-08-31:
Hi, yesterday not solved, something new in the code ? thank you for your help

STaN33130, 2022-08-31:
Hi thank you for your help. Update 006 Check but problem is the same. When PAPP=0 last value before 0 is available (and no update) on zlinky_tic

STaN33130, 2022-08-31:
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

![Uploading E6A3F511-DCCF-4F11-9A85-7FE3645DE57D.jpeg…]()

STaN33130, 2022-08-31:
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

STaN33130, 2022-08-31:
I think there is a divised by 0 or something like that no? Zlinky_tic seems to be blocked. Because there is another problem. When PAPP = 0, OPTARIF stay to his last value « HC… » whereas true value is now « HP… ». Thank you for your help

arenoux, 2022-09-22:
Hello !
J'ai exactement le même problème ici pour la meme config (Panneau Sunology :p )

Pas de solution pour l'instant, mais je vais essayer de creuser coté Zigbee2MQTT

HomeAssistant
Zigbee2MQTT
Zlinky firmware 4000-0006 (Je viens de voir qu'il y avait une nouvelle version.. A tester :))

STaN33130, 2022-09-22:
J’ai trouvé la solution…. Revenir à Zha. Dès que j’injecte jai bien zero de conso sur le linky.

arenoux, 2022-09-23:
Ca confirmerais que le soucis vienne de Zigbee2MQTT...
Ca m'embête de migrer rien que pour ca... Je vais continuer de creuser...

D'autant plus que j'ai egalement le soucis du Zlinky qui s'eteint... (J'ai pourtant bien le fameux condensateur...)

ddelpire, 2022-09-30:
Bonjour,
exactement le même problème et ça m'embête de revenir à ZHA car  ma clé zlinky ne voulait pas s'appairer.
J'ai du passer par Z2MQTT pour bénéficier de l'OTA et maintenant elle est en version 1.0.8.
Peut-être qu'en 1.0.8, elle voudra bien s'appairer mais clairement le problème vient d'une valeur négative que Z2MQTT ne sait pas gérer.

STaN33130, 2022-09-30:
Pour ceux qui peuvent passez sous Zha en attendant. La mise à jour de la valeur power apparent est faite toutes les 7 secondes

BrunoSpy, 2022-10-03:
Est-ce que le problème a été remonté à z2m ? J'ai pas très envie de migrer sur zha car tout le reste fonctionne bien et j'avais pas mal de souci avec zha.

ddelpire, 2022-10-03:
J'ai tenté de re-passer sur ZHA mais on perd l'OTA et mon télérupteur Legrand n'est plus détecté donc retour sur z2m.
J'ai vérifié sur le github de Z2M et quelqu'un a déjà soumi l'issue.
Une nouvelle version est sortie hier mais je ne sais pas si la correction a été prise en compte.

BrunoSpy, 2022-10-03:
Je suis passé à la dernière version (1.28.0) et pas d'amélioration.
Quelle est la référence de l'issue côté z2m ?

BrunoSpy, 2022-10-03:
Pour ceux qui veulent ajouter des informations : https://github.com/Koenkk/zigbee2mqtt/issues/13991

ddelpire, 2022-10-03:
J'ai ajouté aussi un commentaire.

ddelpire, 2022-10-09:
Salut j'ai eu une réponse aujourd'hui

Voici ce que j'ai constaté
@vk496 Problem of conversion number to string in lib/extension/receive.ts ?

const converters = data.device.definition.fromZigbee.filter((c) => {
const type = Array.isArray(c.type) ? c.type.includes(data.type) : c.type === data.type;
return c.cluster === data.cluster && type;
});

Réponse d'un contributeur
@[vk496](https://github.com/vk496)
Contributor
vk496 commented [11 hours ago](https://github.com/Koenkk/zigbee2mqtt/issues/13991#issuecomment-1272481110)

Hello,

Sorry, difficult days and I can't take a look rn.

The problem is with conversion of data types (or precision with floats) for sure, but not there. You should take a look in the lixee.js

Have a nice day :)
Valentín

----------------------------------------
Donc on en revient au problème que j'ai soulevé, le lixee ne sait pas envoyer une valeur négative ou à 0 dans les messages MQTT.

@fairecasoimeme une idée ?

fairecasoimeme, 2022-10-10:
Bonjour,
Je ne pense pas que le Linky envoie des valeurs négatives avec l'étiquette PAPP.  (Les données ne sont pas signées)
ZLinky n'a pas de lien direct avec MQTT, il envoie les valeurs brutes du Linky au coordinateur.
De ce que je comprends, c'est que Z2M ne traite pas (ou filtre ou n'enregistre pas) la valeur quand elle est à zéro.

BrunoSpy, 2022-10-10:
Je confirme que le problème est bien du côté de Z2M, lixee envoie bien la bonne valeur à 0 mais il y a un bug dans le convertisseur. Un patch a été proposé et doit encore être testé pour vérifier que cela règle le problème.

ddelpire, 2022-10-10:
Du côté de Z2M mais ce n'est pas Z2M c'est le convertisseur zigbee-herdsman-converters qui intérprête mal les données du fichier lixee.js
https://github.com/Koenkk/zigbee2mqtt/issues/13991#issuecomment-1272905514

ddelpire, 2022-10-10:
@BrunoSpy  je leur ai demandé comment conserver la persistence de la modification car quand on re-démarre le plugin Z2MQTT, le container est détruit et un nouveau démarre en perdant les modifications. A part faire un fork du prokjet et le tester, il n'y a que eux qui peuvent proposer la modif dans la branche dev pour que l'on puisse tester.

arenoux, 2022-10-11:
En effet, pour tester je pense qu'il faut :

**Methode 1:**
- Forker zigbee-herdsman-converters et faire la modif
- Forker Zigbee2MQTT et mettre a jour le dependance vers [zigbee-herdsman-converters  dans le package.json](https://github.com/Koenkk/zigbee2mqtt/blob/master/package.json#L64)
- Build l'image docker du Zigbee2MQTT forké

**Methode 2 :**
- Copier le lixee.js (vers lixee-test.js par exemple)
- Modifier lixee-test.js
- Utiliser la fonctionnalité de [External converters](https://www.zigbee2mqtt.io/guide/configuration/more-config-options.html#external-converters)  en ajoutant :
```
external_converters:
  - chemin/vers/lixee-test.js
```

ddelpire, 2022-10-11:
Ils m'ont préconisé la méthode 2 mais j'avais essayé ce week-end et le plugin ne démarrait plus. J'étais passé par le menu développement HA pour retrourver le dossier z2mqtt. J'avais déposé le lixee.js dedans et ajouté dans le fichier Yaml
external_converters:
  - chemin/vers/lixee-test.js

Mais ils embarquent déjà nativement le support du lixee donc du coup je me demande si ça ne rentre pas en conflit.

J'ai pensé à la méthode 1 mais comme tu dis je dois forker les 2 projets et reconstruire l'image et à la prochaine mise à jour, je dois tenir mon fork à jour.

Il faudrait déjà au moins valider ce qu'ils ont proposé pour que ce soit intégré dans la prochaine release du  zigbee-herdsman-converters.

arenoux, 2022-10-12:
Pour info @ddelpire.
J'ai pu utiliser la méthode que tu voulais utiliser initialement :p

- s'attacher au container : `docker exec -it container_number /bin/sh`
- vi sur le fichier lixee : `vi node_modules/zigbee-herdsman-converters/devices/lixee.js`
- modifier le fichier (Perso j'ai juste ajouté des logs pour le moment)
- enregistrer le fichier et sortir du container : `exit` :)
- restart le container avec docker-compose : `docker-compose restart zigbee2mqtt`

J'ai bien mes logs qui apparaissent donc je pense que tu peux faire ton test sans fork ni external converters :p
Mes fichiers sont bien conservés, probablement grace au docker-compose.yml avec la section "volumes"

```
  zigbee2mqtt:
    container_name: zigbee2mqtt
    restart: unless-stopped
    image: koenkk/zigbee2mqtt
    volumes:
      - /home/pi/zigbee2mqtt-data:/app/data
      - /run/udev:/run/udev:ro
    ports:
      - 8080:8080
    environment:
      - TZ=Europe/Berlin
    devices:
      - /dev/ttyACM0
```

ddelpire, 2022-10-12:
@arenoux c'est vrai que je n'ai pas pensé à le relancer par docker, je suis repassé par HA en relancant le plugin.
je n'ai pas eu le temps hier d'y regarder.
Et alors ça donne quoi ça corrige le bug ?
Merci !

arenoux, 2022-10-12:
Hello !
Bonne nouvelle ici !
Je viens de tester via mes logs en effet lixee.js ne renvoie pas les data quand la valeur est égale a 0 !
`if(0)` est évalué à "false" et donc en ne fait le traitement qui suit que pour les valeurs non nulles :(

J'ai pu faire le fix en local et valider que ca fonctionne correctement (Quel plaisir de voir arriver ce 0 dans Home Assistant !!)
Je vais m'occuper d'ouvrir un ticket dans le bon repo et je pousserais moi meme un fix, dans une Pull Request :)

Je ne sais pas à quel point l'équipe en charge de zigbee-herdsman-converters seront efficace dans le traitement de cette PR, mais il y a bon espoir que ce soucis soit corriger dans les jours a venir !!!!

ddelpire, 2022-10-12:
En fait je viens de comprendre toi tu utilises z2mqtt avec docker compose moi je l'ai mis en tant que plugin dans HA
Il faut que je vois si je peux ajouter un volume persistant dans la conf du plugin.
Bonne nouvelle !

arenoux, 2022-10-12:
C'est mergé côté zigbee-herdsnam-converter (dans le master). Donc la prochaine release de zigbee2mqtt devrait résoudre le soucis 😇😇😇😇

Pour les plus pressés vous pouvez build vous même l'image docker ou utiliser [Le bricolage suggéré plus haut ;)](https://github.com/fairecasoimeme/Zlinky_TIC/issues/62#issuecomment-1275851151)

BrunoSpy, 2022-11-02:
Nouvelle version de Z2M publiée, problème réglé : le ticket peut être fermé !

arenoux, 2023-09-06:
Je confirme :) Il faudrait fermer ce ticket :)

Closed 2023-09-06.

Thread 68 (2022-06-09):

Informations erronées ??

navycrow, 2022-06-09:
Bonjour,
J'utilise mon lixee avec avec l'intégration Z2MQTT. Et je viens basculer mon compteur en mode STANDARD.
J'ai plusieurs interrogations
La valeur URMS1 (tension efficace) m'affiche 65535 V ?! Cette valeur me parait erronée d'autant que selon le référencielle ENEDIS (Enedis-NOI-CPT_54E), cette valeur ne comporte que 3 caractères. Je pense qu'il y a un erreur de mappage. Qu'en pensez-vous ?
Concernant la valeur de courant efficace (IRMS1). Cette valeur est codé sur 3 caractères et sa valeur maxi ne devrait pas dépasser 90 A toujours selon le référentiel. J'en déduis que l'un des caractères concerne la décimale. Est-ce exacte et si oui comment l'afficher ?

Tof-le-Chauve, 2022-06-12:
Bonjour, j'ai commandé le module il y 15 jours et je l'ai reçu avec un firmware V1. Déjà c'est pas franchement sympa. Du coup, galère de la mise a jour. Bref... Je suis sur Home Assistant + ZHA sur une Conbee II et les valeurs remontées sont complètement farfelues et très (trop) binaires (32768 et 65535) ci-joint mon screenshot. Et pour couronner le tout, le module "Energie" de HA remonte les infos quand il a le temps :)
Avez-vous des explications a tout ça ?
Merci d'avance
Tof.

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

navycrow, 2022-06-13:
De mon côté j’ai finalement résolu mon souci en restaurant les paramètres par default de la clé et en relançant Z2MQTT. Depuis tout est ok.

Tolriq, 2022-06-13:
@navycrow tu as fait quoi comme reset pour repartir propre?

navycrow, 2022-06-13:
Après avoir demandé le basculement en mode STANDARD à mon fournisseur, mon compteur a commencé à recevoir de nouvelles infos le lendemain matin mais d'autres infos étaient erronés (comme toi).
J'ai d'abord, sous Zigbee2MQTT, cliquer sur le bouton RECONFIGURER
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

Comme ça n'a pas suffit. J'ai redémarré le module Z2M.
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

Depuis tout marche nickel !!

Tolriq, 2022-06-13:
Ha le petit bouton caché :) Ca m'a enfin virer une ligne de la partie reporting qui revenait meme en supprimant / rajoutant le device au réseau. Ca à même réparé la map.

On va voir si ca tient dans le temps, mais merci je pense que c'était le truc manquant.

Tolriq, 2022-06-14:
Bon bah non ca marche pas après qq heure ca stop.

Tof-le-Chauve, 2022-06-14:
Exactement la même... Ca fonctionne de temps en temps.

fairecasoimeme, 2022-06-14:
on est plus trop dans le thème de l'issue. Merci de basculer sur le bon sujet.

Closed 2022-06-14.

Thread 70 (2022-06-24):

Impossibilité d'appairer avec ZHA+ConbeeII

GizzGool, 2022-06-24:
Bonjour la communauté,

Je rencontre les mêmes galères d'appairage que certains mais même en suivant les réponses, rien !
Utilisation de ZHA avec ConbeeII, portée apparemment ok car dialogue avec la clé Lixee (achetée il y a 2 jours)  et voici un bout du log :

```
[0x565F](THS317-ET): Device seen - marking the device available and resetting counter
[0x565F](THS317-ET): Update device availability - device available: True - new availability: True - changed: False
[0xF1B7](TS011F): Device seen - marking the device available and resetting counter
[0xF1B7](TS011F): Update device availability - device available: True - new availability: True - changed: False
[0xDCC7:1:0x0b04]: async_update
[0xDCC7:1:0x0b04]: Reading attributes in chunks: ['active_power', 'rms_current', 'rms_voltage']
[0xDCC7:1:0x0b04] Sending request header: ZCLHeader(frame_control=FrameControl(frame_type=<FrameType.GLOBAL_COMMAND: 0>, is_manufacturer_specific=False, is_reply=0, disable_default_response=0, reserved=0, *is_cluster=False, *is_general=True), tsn=85, command_id=<GeneralCommand.Read_Attributes: 0>, *is_reply=False)
[0xDCC7:1:0x0b04] Sending request: Read_Attributes(attribute_ids=[1291, 1288, 1285])
[0xdcc7] Delivery error for seq # 0x55, on endpoint id 1 cluster 0x0b04: message send failure
[0xDCC7:1:0x0b04]: failed to get attributes '['active_power', 'rms_current', 'rms_voltage']' on 'electrical_measurement' cluster: [0xdcc7:1:0x0b04]: Message send failure
```

Le module est bien découvert mais apparemment erreur de remontée d'info à la fin et pas d'ajout à HA ?

L'appui de 10s ne fait jamais clignoter la led, elle s'éteint puis se rallume.
J'ai essayé le test d'appuyer moins d'une seconde dès qu'elle se rallume, mais là encore rien :(

Je suis sur un Linky en triphasé

Auriez-vous svp des idées ?

Merci d'avance.

GizzGool, 2022-07-28:
Bonjour,

Après aide du support, problème de réception, il faut vraiment être très très prêt d'un relais :-)

Merci.

Closed 2022-07-28.

Thread 71 (2022-06-27):

smartenergy_metering_summation_delivered rafraichi seulement au reboot de HA

azodev, 2022-06-27:
Bonjour,
Je rencontre un problème avec le zlinky, la valeur smartenergy_metering_summation_delivered, ne semble pas se rafraichir correctement, en effet elle ne se met à jour que lorsque je reboot HA ou débranche/rebranche le zlinky. le reste du temps seules les valeurs :
 - electrical_measurement_apparent_power
 - electrical_measurement rms_current
semblent évoluer dans le temps, même si parfois les valeurs semble complètement hors limites, ex : pendant la nuit un pic à 2200va et 9A alors que quasiment tout est coupé, la journée  5370 va et 23 A ... mais le reste du temps les valeurs semblent ok.

Mon installation : HA en docker (sur un Synology) avec Conbee 2 en ACM0, les autres capteurs (prises et capteurs de temp son ok, valeurs bien récupérées régulièrement).
L'intégration est ZHA, et j'ai pu faire la maj du firmware en OTA vers la version 5 , la conbee est aussi à jour (par windows).
Avez-vous une idée ?  Ai-je un autre moyen de tester en branchant la conbee sur windows avec un soft de debug ? dois-je le renvoyer en RMA? Y a t'il le moyen de forcer un demande dans ZHA?
ps : la valeur sur compteur électrique change bien elle.
Merci d'avance.

azodev, 2022-07-03:
pour palier au problème, j'ai forcé la récupration de la valeur grace à une automatisation avec zha_toolkit vers un nouveau sensor, en forcant l'intérogation du cluster 1794:0 la valeur de smartenergy_metering_summation_delivered se met aussi à jour.

gsemet, 2022-07-06:
J'ai le même problème. J'ai l'impression que c'est un bug de ZHA plus que de zlinky

azodev, 2022-07-06:
Bonjour,
il faut installer zha_toolkit depuis HACS
ensuite dans configuration.yaml
```
#ajouter la ligne
zha_toolkit:

#creer un sensor (template)
template:
  - sensor:
    - name: lixee_zlinky_tic_metering_custom
      unit_of_measurement: "Wh"
      device_class: energy
      state_class: total_increasing
      state: unavailable

#ajouter une automatisation
automation linky:
  - alias: Read ZLinky_TIC every minute
    description: ''
    trigger:
      - platform: time_pattern
        hours: '*'
        minutes: /1
        seconds: '0'
    condition: []
    action:
      - service: zha_toolkit.execute
        data:
          command: attr_read
          ieee: 00:15:8d:00:05:d2:a8:91
          cluster: 1794
          attribute: 0
          state_id: sensor.lixee_zlinky_tic_metering_custom
          allow_create: false
    mode: single
```
Je crois que j'ai rien oublié.
Ps : la solution n'est pas de moi, mais je ne retrouve pas la source.

Closed 2022-07-06.

Thread 72 (2022-07-03):

Valeurs inconsistantes en Mode Standard / Triphasé

zen2, 2022-07-03:
J'ai des valeurs inconsistantes remontées par zlinky via zigbee2mqtt:

```
{
    "active_enerfy_out_d01": 9696.091,
    "active_enerfy_out_d02": 12816.58,
    "active_power": 1310,
    "active_power_max": 1190,
    "active_power_max_ph_b": 3310,
    "active_power_max_ph_c": 2570,
    "active_power_ph_b": 1620,
    "apparent_power": 7904,
    "apparent_power_ph_b": 7911,
    "apparent_power_ph_c": 16550,
    "available_power": 12,
    "average_rms_voltage_meas_period": 234,
    "average_rms_voltage_meas_period_ph_c": 238,
    "average_rms_voltage_measure_period_ph_b": 238,
    "current_date": "E220702131414",
    "current_index_tarif": 2,
    "current_price": "HEURE PLEINE",
    "current_summ_delivered": 28745.389,
    "current_tarif": "H PLEINE/CREUSE",
    "current_tier1_summ_delivered": 12331.317,
    "current_tier2_summ_delivered": 16414.072,
    "drawn_v_a_max_n1": 1610,
    "drawn_v_a_max_n1_p2": 3140,
    "drawn_v_a_max_n1_p3": 2630,
    "last_seen": "2022-07-03T11:03:28+02:00",
    "linkquality": 171,
    "message1": "PAS DE MESSAGE",
    "message2": "",
    "meter_serial_number": "021976758997",
    "power_threshold": 12,
    "rms_current": 3,
    "rms_current_ph_b": 9,
    "rms_voltage": 235,
    "rms_voltage_ph_b": 240,
    "rms_voltage_ph_c": 239,
    "site_id": "25317944963012",
    "software_revision": 2,
    "status_register": "003A4401",
    "update": {
        "state": "idle"
    },
    "update_available": false
}
```

Tout semble correct sauf les valeurs suivantes;
```
    "apparent_power": 7904,
    "apparent_power_ph_b": 7911,
    "apparent_power_ph_c": 16550,
```

Alors que la consommation réelle est à ce moment de cet ordre:
P1: ~750/850 W
P2: ~30 W
P3: ~3 W

A noter:
- installation et appairage du zlinky avec compteur linky en mode historique
- upgrade du firmware via OTA vers version 4000-0005
- puis passage en standard du compteur linky via EDF/Enedis
- reinitialisation du zlinky
- effacement du device dans zigbee2mqtt
- réappairage, il s'est reconnecté tout de suite

Configuration zigbee2mqtt v. 1.25.2 [9b2a9210]
```
  friendly_name: zlinky
  linky_mode: standard
  energy_phase: three_phase
  production: 'false'
  kWh_precision: 3
  measurement_poll_interval: 20
  measurement_poll_chunk: 4
  tic_command_whitelist: ''
  debounce: 2
  homeassistant: {}
  optimistic: true
  tarif: Standard - Heure Pleine Heure Creuse
```

fairecasoimeme, 2022-07-05:
Bonjour,
Attention la puissance apparente est en VA et non pas W. La différence est le cos phi liés aux appareils.
Concernant les valeurs, le ZLinky ne fait que lire les données du Linky et les remonte sans traitement. Je viens de tester sur un compteur triphasé et de mon côté je n'ai pas de valeurs bizarres.

Pour en être sur (si c'est possible), il vous faut connecter un module usb ttl au zlinky et ouvrir une console pour valider les données.

TROM83, 2022-07-07:
Bonjour,
Je rencontre exactement le même problème de valeurs incohérentes sur la puissance apparente par phase avec la configuration suivante :

`0x00158d0005d299c0':
    friendly_name: '0x00158d0005d299c0'
    linky_mode: standard
    energy_phase: three_phase
    production: 'false'
    tarif: auto
    kWh_precision: 2
    measurement_poll_chunk: 1`

`{
    "active_enerfy_out_d01": 30063.93,
    "active_power": 1406,
    "active_power_max": 3440,
    "active_power_max_ph_b": 1800,
    "active_power_max_ph_c": 250,
    "active_power_ph_b": 1682,
    "apparent_power": 52118,
    "apparent_power_ph_b": 11901,
    "apparent_power_ph_c": 2229,
    "available_power": 15,
    "average_rms_voltage_meas_period": 233,
    "average_rms_voltage_meas_period_ph_c": 233,
    "average_rms_voltage_measure_period_ph_b": 234,
    "current_date": "E220707112720",
    "current_index_tarif": 1,
    "current_price": "BASE",
    "current_summ_delivered": 34524.16,
    "current_tarif": "BASE",
    "current_tier1_summ_delivered": 29455.26,
    "current_tier2_summ_delivered": 3686.02,
    "drawn_v_a_max_n1": 2340,
    "drawn_v_a_max_n1_p2": 2110,
    "drawn_v_a_max_n1_p3": 2450,
    "linkquality": 255,
    "message1": "PAS DE MESSAGE",
    "message2": "",
    "meter_serial_number": "021776032394",
    "power_threshold": 15,
    "rms_current": 7,
    "rms_current_max": 65535,
    "rms_current_ph_b": 3,
    "rms_current_ph_c": 1,
    "rms_voltage": 235,
    "rms_voltage_ph_b": 235,
    "rms_voltage_ph_c": 235,
    "site_id": "25305209770218",
    "software_revision": 2,
    "status_register": "003A0001",
    "update": {
        "state": "idle"
    },
    "update_available": false,
    "relais": null
}`

Zigbee2MQTT Current version: 1.26.0-1

fairecasoimeme, 2022-07-07:
@vk496 : est-il possible qu'il y ait un traitement sur ces valeurs côté zigbee2mqtt ?

"apparent_power"
"apparent_power_ph_b"
"apparent_power_ph_c"

zen2, 2022-08-19:
It seems that everything is working fine now...
By looking at my logs it seems that a new version of zigbee2mqtt (1.27.0) have make it works correctly.
I think a reconfiguration at zigbee level of zlinky device was necessary.

Closed 2022-08-19.

Thread 79 (2022-07-30):

Probleme d'appairage

squady, 2022-07-30:
Bonjour,
Je sais pas si je suis au bon endroit pour solliciter de l'aider, mais je tente quand même :/
Je suis sous home assistant et ZHA.
J'ai acheté un ZLinky et une Zigate Passerelle USB TTL Version 2 et il m'est impossible de pairer la ZLinky.
J'ai branché le ZLinky, la led s'allume et reste fixe, d’après la doc cela signifie que tout va bien.
Pour pairer je passe ZHA en mode inclusion, puis, sur le ZLinky, j’appuie sur le bouton pendant 10s, la led s’éteint puis se rallume fixe (normal).
J'ai beau attendre, recommencer la manipulation, le ZLinky n'est jamais detecté par ZHA.
Le module ZLinky se trouve à moins de 5m de la clé zigate.
J'ai tenté de pairer d'autres périphériques pour m'assurer que la clé zigate n’était pas en cause, et tout fonctionne bien, seul le zlinky reste invisible.
Que puis-je faire de plus ?

capi92, 2022-09-02:
pour suivre, J’ai le même pb avec zigbee2mqtt en passant pas une clé sonoff.

pvince83, 2022-09-07:
Meme chose chez moi!

Sn4kY, 2022-09-07:
Bonjour
exactement le même problème. je ne parviens pas à associer le Zlinky avec la clé USB ZiGate+

capi92, 2022-09-09:
J’ai un répéteur à moins de 1m et ça ne change rien…

fairecasoimeme, 2022-09-09:
Existe t-il des logs ? ou il n'y a absolument rien ? Pouvez-vous partager des photos sur l'installation ?

JulienFauconnier, 2022-09-09:
Même problème, mais aucun logs de disponibles car il n'y a tout simplement rien de vu dans Home Assistant (ZHA)

fairecasoimeme, 2022-09-12:
> Même problème, mais aucun logs de disponibles car il n'y a tout simplement rien de vu dans Home Assistant (ZHA)

A quelle distance ?

Selon l'environnement de chacun, il est possible aussi de tester la version avec  antenne externe permettant de limiter les interférences et augmenter la portée.

pvince83, 2022-09-12:
Bonne nouvelle, j'ai réussi a associer mon ZLinky !!!

Le problème était du au firmware de mon dongle SONOFF (j'avais mis un firmware custom pour avoir 20db en mode routeur) en remettant celui fourni par z2m j'ai réussi a l'associer mais j'ai du le placer a 10 cm.

Un fois associer j'ai pu remettre le dongle a l'intérieure de la maison (a environ a 4m du Zlinky)

Par contre malgré un LQI a plus de 100 il ne se rafraichit pas toutes les 7 secondes mais entre 10s et 5 min, pas terrible pour la conso instantanée mais ça permet d'alimenter correctement la vue énergie de home assistant.

Une chance de résoudre ce problème avec l'antenne?

plouf34, 2022-10-01:
Bonjour
Mon zlinky tout fraiChement installé (en extérieur près du linky), je me heurte à sa son connection à son router.
Comment appliquer un firmware non route sur HA et zigbee2mqtt?

RBXIII, 2022-10-10:
Meme problème pour moi (Zigbee2Mqtt + SONOFF Zigbee 3.0 USB Dongle Plus ZBDongle-P), j'ai finalement pu l'associer à mon coordinateur Zigbee en plaçant ce dernier à tout près du module lixee. Cela ne semble pas fonctioner via un des routeurs zigbee..

Thread 83 (2022-08-20):

Attribute 0xff66/0x0200 value seems strange

pipiche38, 2022-08-20:
The data received from the ZLinky on attribute 0xff66/0x200 is 10 bytes long with  not really ascii characters . Is that expected ?

ReadCluster ff66 - 5f21/01 Attribute: 0200 Type: 42 Size: 0010 Data: 0201002000010002020042000d

fairecasoimeme, 2022-08-30:
it's weird :
it's seems to be ok at home :
Type: 42 Size: 10 Data:  20 20 48 65 75 72 65 20 70 6C 65 69 6E 65 00 20 -->   Heure pleine

pipiche38, 2022-09-02:
Your are in the case where you are in Standard mode, but if you are in Historique mode,

fairecasoimeme, 2022-09-02:
with the "historique mode" :
10:21:10.069 <- 01 80 02 00 26 D9 00 01 04 FF 66 01 01 02 75 E5 02 00 00 18 08 01 00 02 00 42 10 00 00 00 00 00 00 00 00 00 00 00 00 00 00 00 00 30 03
Type: 42 Size: 10 Data: 00 00 00 00 00 00 00 00 00 00 00 00 00 00 00 00

pipiche38, 2022-09-02:
Je comprends pas l'approche consistant à mettre des NULL alors que c'est un type 42 donc la longueur devrait etre simplement de 0

fairecasoimeme, 2022-09-05:
L'approche est due au fait que dans le protocole ENEDIS en mode standard, l'étiquette LTARF contient 16 caractères de manière fixe. Donc j'ai créé une variable à taille fixe. (Sachant qu'en mode standard, l'étiquette LTARF est obligatoire)
Si tu es donc en mode historique, l'étiquette n'est du coup jamais analysé et reste null.
Mais on s'éloigne de ton problème. Dans quel contexte tu obtiens des caractères non null dans les données ?

Closed 2022-09-12.

Thread 85 (2022-08-30):

Limitiation of 20 Configuer Reporting  attributes

pipiche38, 2022-08-30:
In Standard Mono they are about 22 Attributes which can be reportable
In Standard Tri Prod they are about 39 attributes reportable

Can we have this limit set to 40, in order to accomodate the correct setup in reporting mode fo 39 attributes

fairecasoimeme, 2022-08-30:
I have already increase to 50 with the v6 version. It should be available soon

fairecasoimeme, 2022-08-30:
v6 reduces the role of router to 1 route, routes are initiated by routers and coordinators. it doesn't prevent the ZLinky from being used on multiple routes, it just reduces the fact that ZLinky will only register one route in its table.
do not confuse being routed with routing

pipiche38, 2022-09-12:
Which means that you don't allow the ZLinky to have several routes toward the coordinator. This is no sense, and against the zigbee mesh. In case the route break, the ZLinky is dead for a while and will consume a lot of energy to retreive a new route.

fairecasoimeme, 2022-09-12:
I use the same config than an end device for the network layer config. I don't know if you have some informations about this but I believe that end device don't receive route informations (including many to one route requests). This is the parent (routers ou coordinator) which manage routing path. An end device can only send packet to its parent. If an end device must send a broadcast or a unicast transmission to other devices in the network, it sends the message directly to its parent and the parent performs any necessary route or address discoveries to route the packet to the final destination.

You are comparing the energy used to send one paquet( to find a new accessible route) when there is a route break with a permanent routing trafic due to other devices ?

pipiche38, 2022-09-12:
Simply configure this device as an End Device if you don't want it to route and use the Pooling feature to handle commands.
Configuring a router which is not managing any Routing Table doesn't make sense

fairecasoimeme, 2022-09-12:
No because the linky acquisition, you can't use a sleepy device. This is not the only router type device which can't route.
And there will be a routing version.
And there is no link with the issue

Closed 2022-09-12.

Thread 87 (2022-09-01):

Led clignote de temps en temps.

WarC0zes, 2022-09-01:
Bonjour,
j'ai mis a jour vers le firmware 6 et je viens de remarquer que j'ai la led bleu clignote 3 a 5 fois de temps en temps ( 5-10 min) et reviens fixe. Avec le firmware 5 la led bleu rester fixe.
j'ai débrancher le Zlinky et rebrancher sur le linky. Ca change rien, les remontés d'infos fonctionnent et le signal est a 150lqi.
C'est une nouveauté du firmware 6 ou un bug du Zlinky?

Mon model a le condensateur ( acheter en avril) et est utiliser avec ZHA et un clef sonoff zigbee 3.0.

fairecasoimeme, 2022-09-01:
Quand la Led clignote, c'est que le ZLinky a eu une erreur dans le process de décodage du Linky (caractère perdu ou autre) à un moment donnée.
Ce n'est pas une nouveauté du firmware ni un bug.
Ceci peut-être dû à plusieurs choses.
- sollicitation spontanée trop importante entrainant un timeout dans l'acquisition
- Erreur transmission Linky (plutôt rare)
Dans tous les cas, ce n'est pas critique (pas de perte de données ou valeurs)

Cependant, si ça arrive très souvent, essayez de revenir au firmware v5 pour voir si ça se reproduit. Dans ce cas, il y a un biais inconnu à ce jour. Niveau firmware, il n'y a pas eu de modification sur l'acquisition du Linky.

WarC0zes, 2022-09-01:
Ok, je vais repasser sur le firmware v5 et voir.
Comme vous en parler, depuis le début que j'ai le Zlinky (en v5) je reçois des erreurs du genre:

```
2022-08-22 04:09:35.342 WARNING (MainThread) [homeassistant.helpers.entity] Update of sensor.lixee_zlinky_tic_cf99d205_electrical_measurement is taking over 10 seconds
2022-08-22 04:09:37.727 ERROR (MainThread) [homeassistant] Error doing job: Task exception was never retrieved
Traceback (most recent call last):
File "/usr/local/lib/python3.10/site-packages/zigpy_znp/api.py", line 984, in request
response = await response_future
asyncio.exceptions.CancelledError
During handling of the above exception, another exception occurred:
Traceback (most recent call last):
File "/usr/local/lib/python3.10/site-packages/zigpy_znp/api.py", line 1023, in request_callback_rsp
await self.request(request, **response_params)
File "/usr/local/lib/python3.10/site-packages/zigpy_znp/api.py", line 982, in request
async with async_timeout.timeout(self._znp_config[conf.CONF_SREQ_TIMEOUT]):
File "/usr/local/lib/python3.10/site-packages/async_timeout/__init__.py", line 129, in __aexit__
self._do_exit(exc_type)
File "/usr/local/lib/python3.10/site-packages/async_timeout/__init__.py", line 212, in _do_exit
raise asyncio.TimeoutError
asyncio.exceptions.TimeoutError
```
ou

```
2022-08-22 18:40:08.220 ERROR (MainThread) [homeassistant.components.automation.lecture_zlinky_tic_hc_hp_every_minute] Read ZLinky_TIC HC + HP every minute: Error executing script. Unexpected error for call_service at pos 2:
Traceback (most recent call last):
File "/usr/local/lib/python3.10/site-packages/zigpy_znp/zigbee/application.py", line 1046, in _send_request_raw
response = await asyncio.shield(
asyncio.exceptions.CancelledError
During handling of the above exception, another exception occurred:
Traceback (most recent call last):
File "/usr/src/homeassistant/homeassistant/helpers/script.py", line 447, in _async_step
await getattr(self, handler)()
File "/usr/src/homeassistant/homeassistant/helpers/script.py", line 680, in _async_call_service_step
await service_task
File "/usr/src/homeassistant/homeassistant/core.py", line 1713, in async_call
task.result()
File "/usr/src/homeassistant/homeassistant/core.py", line 1750, in _execute_service
await cast(Callable[[ServiceCall], Awaitable[None]], handler.job.target)(
File "/config/custom_components/zha_toolkit/__init__.py", line 697, in toolkit_service
raise handler_exception
File "/config/custom_components/zha_toolkit/__init__.py", line 661, in toolkit_service
await handler(
File "/config/custom_components/zha_toolkit/__init__.py", line 746, in command_handler_default
await default.default(
File "/config/custom_components/zha_toolkit/default.py", line 33, in default
await handler(app, listener, ieee, cmd, data, service, params, event_data)
File "/config/custom_components/zha_toolkit/zcl_attr.py", line 273, in attr_read
await attr_write(*args, **kwargs)
File "/config/custom_components/zha_toolkit/zcl_attr.py", line 315, in attr_write
result_read = await u.cluster_read_attributes(
File "/config/custom_components/zha_toolkit/utils.py", line 739, in cluster_read_attributes
return await cluster.read_attributes(attrs, manufacturer=manufacturer)
File "/usr/local/lib/python3.10/site-packages/zigpy/zcl/__init__.py", line 482, in read_attributes
result = await self.read_attributes_raw(to_read, manufacturer=manufacturer)
File "/usr/local/lib/python3.10/site-packages/zigpy/quirks/__init__.py", line 233, in read_attributes_raw
results = await super().read_attributes_raw(
File "/usr/local/lib/python3.10/site-packages/zigpy/device.py", line 291, in request
radio_result, msg = await self._application.request(
File "/usr/local/lib/python3.10/site-packages/zigpy_znp/zigbee/application.py", line 302, in request
return await self._send_request(
File "/usr/local/lib/python3.10/site-packages/zigpy_znp/zigbee/application.py", line 1161, in _send_request
response = await self._send_request_raw(
File "/usr/local/lib/python3.10/site-packages/zigpy_znp/zigbee/application.py", line 1043, in _send_request_raw
async with async_timeout.timeout(DATA_CONFIRM_TIMEOUT):
File "/usr/local/lib/python3.10/site-packages/async_timeout/__init__.py", line 129, in __aexit__
self._do_exit(exc_type)
File "/usr/local/lib/python3.10/site-packages/async_timeout/__init__.py", line 212, in _do_exit
raise asyncio.TimeoutError
asyncio.exceptions.TimeoutError
```

Des problèmes de timeout comme vous me dite. Je sais pas d'ou vient ce problème.

fairecasoimeme, 2022-09-01:
Avez-vous vu l'errata : https://github.com/fairecasoimeme/Zlinky_TIC#errata-hardware
êtes-vous concerné ?

WarC0zes, 2022-09-01:
Non, j'ai le condensateur.

fairecasoimeme, 2022-09-01:
> Excusez mon ignorence, mais comment remettre la v5 ? Ca va pas me bloquer si je suis en v6 ?

je pense que la mise à jour par OTA va poser problème vu que c'est du downgrade. Pouvez-vous effectuer la mise à jour en suivant : https://github.com/fairecasoimeme/Zlinky_TIC#mise-%C3%A0-jour-du-firmware-non-ota ?

fairecasoimeme, 2022-09-01:
Vous avez globalement combien de timeout par jour ?

WarC0zes, 2022-09-01:
C'est aléatoire de 3 a 8 par jours , si c'est pas plus.
Pour la maj non ota, ca va être un peu compliquer pour moi. c'est pas trop de mon niveau et j'ai pas de module USB TTL.

fairecasoimeme, 2022-09-01:
ok je vais voir pour générer un OTA permettant de downgrader et je le posterai ici dés que réaliser.

WarC0zes, 2022-09-01:
D'accord, merci beaucoup.

fairecasoimeme, 2022-09-01:
[ZLinky_GpProxy_Ota_OM15081_V5.zip](https://github.com/fairecasoimeme/Zlinky_TIC/files/9471487/ZLinky_GpProxy_Ota_OM15081_V5.zip)
Normalement, cette version devrait faire l'affaire

WarC0zes, 2022-09-01:
ok, je test le downgrade.

fairecasoimeme, 2022-09-01:
[ZLinky_router_v5.0_OTA_v7.zip](https://github.com/fairecasoimeme/Zlinky_TIC/files/9471506/ZLinky_router_v5.0_OTA_v7.zip)
cette version devrait être ok

WarC0zes, 2022-09-01:
ok, ouf.

WarC0zes, 2022-09-01:
C'est bon ca downgrade
```
2022-09-01 18:13:38.212 DEBUG (MainThread) [zigpy.zcl] [0xF1C9:1:0x0019] OTA upgrade progress: 1.7
```
je te tient au courant.

WarC0zes, 2022-09-01:
le downgrade en v5 est ok.
Depuis 1h la led n'a pas clignoté, elle reste fixe. Ca a l'air bon, mais je vais tester sur 24h voir.
merci beaucoup pour ton aide.

WarC0zes, 2022-09-02:
Bonjour,
la led bleu est rester fixe depuis le downgrade en v5. J'ai vu deux fois clignoté la led depuis le downgrade, rien d'alarmant a mon avis. Les infos remontent bien.
j'ai les erreurs dans les logs comme avant ( celle du post au dessus). Je vais activer le debug pour zigpy_znp pour en savoir un peu plus.

Encore merci pour tous.

Closed 2022-09-02.

Thread 89 (2022-09-02):

Ne capte plus depuis mise à jour

antibill51, 2022-09-02:
Bonjour. Depuis la mise à jour, aucune remonté d'informations.
Impossible de ré apairer également, pourtant d'autres périphériques placés à côté fonctionnent très bien.

J'utilise z2m, y'a t'il possibilité de faire un downgrade en ota ? Histoire d'être certain que le problème vienne de là.
En déplaçant provisoirement le coordinateur et en supprimant le routeur cc2531, je peux réapairer.

Merci

fairecasoimeme, 2022-09-02:
Bonjour,
Normalement aucun rapport mais vous pouvez utilisez le fichier qui est sur le lien suivant :
https://github.com/fairecasoimeme/Zlinky_TIC/issues/87#issuecomment-1234488515
tenez moi au courant.
Fred

ach-78, 2022-09-02:
Bonjour,
Soucis de remontée d'info intermittente depuis la v6. J'ai bien un condo, je n'ai ce soucis que depuis la montée en v6. Ça va ça vient, avec de longue périodes sans remontée (plusieurs heures) entrecoupées de périodes où j'ai mon sensor.
En ZHA et Clé Zigbee Sonoff 3.0.
Je suis en train de rollbacker en v5 (bien qu'avant d'avoir ces soucis j'étais en v1).

ach-78, 2022-09-02:
A noter : avec le fichier de downgrade en v5 qui se présente en pseudo "v7", une fois la Maj de downgrade réalisée, une nouvelle Maj firmware démarre aussitôt puisqu'il détecte une Maj v5 à v7 nécessaire...

J'ai donc du commenter la partie Maj OTA dans le .yaml puis redémarrer HA alors qu'une Maj était en cours de chargement. En espérant qu'il n'y a aucune conséquence à cette interruption.

WarC0zes, 2022-09-02:
@ach-78 j'ai eu le même soucis. J'ai eu peur de couper le downgrade, donc j'ai attendu la fin du 2eme downgrade et j'ai vite reboot au 100%.

tomj44300, 2022-09-03:
bonjour vous faites comment pour downgrade a zigbee2mqtt , inforlation figé depuis la maj de v5 a v6

ach-78, 2022-09-03:
Il faut faire comme un upgrade mais en utilisant la pseudo v7 (qui est en fait la v5) du lien donné plus haut. Attention l’upgrade va partir en boucle car détecté sans fin une v5 actuelle et une v7 proposée.

Depuis hier soir que j’ai viré la v6 tout semble revenu en ordre.

tomj44300, 2022-09-03:
j ai pas réussi a downgrade , je dois pas avoir compris la procédure https://github.com/Koenkk/zigbee2mqtt.io/blob/develop/docs/guide/usage/ota_updates.md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
par contre je doit avoir de la chance le lixee refonctionne après je ne sais cb de debranchage et suppression ajout

zen2, 2022-09-03:
je confirme aussi plus aucune remontée d'information après mise à jour OTA en v6.

L041S, 2022-09-03:
Pareil ici, depuis la V6 plus aucune remontée d’info  :(

L041S, 2022-09-04:
J’avoue n’avoir pas trop compris la procédure pour le downgrade, je n’ai jamais eu à faire cette manip.

git-greatguy, 2022-09-04:
idem ici, j'aimerais bien que l'on communique la procédure de mise a jour pour la pseudo v5.
J'ai tenté de procéder via z2m en poussant en local un fichier json avec la config et le fichier ota, retour : "c'est a jour".
idem en placant cette config sur un serveur web.

Quelque soit la configuration, pour ce device précis, il ne charge pas mon override et l'ota me répond qu'il n'y a pas de mise a jour disponible ?!?

 2022-09-04 16:13:07Received MQTT message on 'zigbee2mqtt/bridge/request/device/ota_update/check' with data ```
'{"id":"Lixee_zlinky","transaction":"pyt27-5"}'
Info 2022-09-04 16:13:07MQTT publish: topic 'zigbee2mqtt/bridge/log', payload '{"message":"Checking if update available for 'Lixee_zlinky'","meta":{"device":"Lixee_zlinky","status":"checking_if_available"},"type":"ota_update"}'
Debug 2022-09-04 16:13:10Received Zigbee message from 'Lixee_zlinky', type 'commandQueryNextImageRequest', cluster 'genOta', data '{"fieldControl":0,"fileVersion":6,"imageType":1,"manufacturerCode":4151}' from endpoint 1 with groupID 0
Debug 2022-09-04 16:13:10Got OTA request '{"fieldControl":0,"manufacturerCode":4151,"imageType":1,"fileVersion":6}'
Info 2022-09-04 16:13:11Using firmware file ZLinky_router_v6.0.ota
Debug 2022-09-04 16:13:11Is new image available for '0x00158d0005ce7980', current '{"fieldControl":0,"manufacturerCode":4151,"imageType":1,"fileVersion":6}', latest meta '{"fileVersion":6,"fileSize":243758,"url":"https://github.com/fairecasoimeme/Zlinky_TIC/releases/download/v6.0/ZLinky_router_v6.0.ota"}'
Info 2022-09-04 16:13:11MQTT publish: topic 'zigbee2mqtt/bridge/log', payload '{"message":"No update available for 'Lixee_zlinky'","meta":{"device":"Lixee_zlinky","status":"not_available"},"type":"ota_update"}'
Info 2022-09-04 16:13:11MQTT publish: topic 'zigbee2mqtt/bridge/response/device/ota_update/check', payload '{"data":{"id":"Lixee_zlinky","updateAvailable":false},"status":"ok","transaction":"pyt27-5"}'

```

Il doit y avoir une subtilité dans le process ota qui n'apparait qu'avec ce device dans mqtt.

Ex si je pousse le bouton "check for update" pour un autre appareil :

```
Debug 2022-09-04 16:18:44ZigbeeOTA: downloaded main index
Debug 2022-09-04 16:18:44ZigbeeOTA: Loading override index https://www.****.eu/index.json
```

On dirait que le device pousse sa propre url pour les mises a jour et ne permet pas d'être outrepassé. j'ai bon ?

git-greatguy, 2022-09-04:
je m'auto-répond en donnant une explication / une méthode potentiel pour downgrade le firmware.

Le système de distribution de l'ota pour le lixee zlinky est dit "propriétaire", il n'utilise pas le dépot "standard" de github pour la distribution de l'ota zibbee. Il faut donc surcharger le "converter" qui est livré avec zigbee2mqtt pour indiquer une mise à jour dite "ota.zigbeeOTA"

Les modifications a faire sont les suivantes :

1 - Recupérer le fichier /app/node_modules/zigbee-herdsman-converters/devices/lixee.js du container zigbee2mqtt

`docker cp addon_45df7312_zigbee2mqtt:/app/node_modules/zigbee-herdsman-converters/devices/lixee.js ./`

note : le nom du conteneur est peut-être a adapté a votre situation.

ensuite éditer le fichier et modifier le ligne suivante
`ota: ota.lixee,`
en
`ota: ota.zigbeeOTA,`

2 - Modifier le chemin des dépendances en début de fichier avec le chemin complet

`/app/node_modules/zigbee-herdsman-converters/lib/`
au lieu de
`../lib`

3 - Déposer le fichier modifié dans le répertoire /conf/zigbee2mqtt du container homeassistant

4 - Procéder à la création d'un fichier /conf/zigbee2mqtt/my_index.json avec le contenu suivant :
```
[
    {
        "manufacturerCode": 4151,
        "imageType": 1,
        "url": "ZLinky_router_v5.0.ota",
        "force": true
    }
]

```

5 - Déposer dans ce même répertoire, le fichier ZLinky_router_v5.0.ota

6 - Ajouter dans le fichier configuration.yaml de zigbee2mqtt la déclaration de votre fichier override
```
ota:
  zigbee_ota_override_index_location: my_index.json
```

7 - Redémarrer zigbee2mqtt et lancer le "check update".

Pour ma part l'update est en cours. il reste une vingtaine de minute. Je mettre a jour le post pour annoncer la réussite ou non  de l'opération.

git-greatguy, 2022-09-04:
Ca a fonctionné nickel !

`MQTT publish: topic 'zigbee2mqtt/bridge/response/device/ota_update/update', payload '{"data":{"from":{"date_code":"20220830","software_build_id":"4000-0006"},"id":"Lixee_zlinky","to":{"date_code":"20220217","software_build_id":"4000-0005"}},"status":"ok","transaction":"0httf-1"}'`

L041S, 2022-09-04:
Merci pour ton retour, je commence à y voir un peu plus clair !
De mon côté zigbee2mqtt n’est pas installé via l’addon home assistant mais via docker (étant donné que j’ai home assistant en image docker je n’ai pas le store).
J’ai donc adapté ta commande en tapant
`docker cp zigbee2mqtt:/app/node_modules/zigbee-herdsman-converters/devices/lixee.js ./`

J’ai donc bien le fichier mais une fois ce dernier modifié je ne sais pas où le mettre, j’ai bien un dossier zigbee2mqtt/data/ dans lequel j’ai mon configuration.yaml que j’ai pu éditer pour ajouter ota: ota.zigbeeOTA mais en collant le fichier lixee.js edité + l’ota ZLinky_router_v5.0.ota dans ce dossier, le check update me dit que tout est encore à jour. Je ne suis pas dans le bon répertoire ?

git-greatguy, 2022-09-04:
si tu as bien le fichier de config de z2m, tu as dans le bon repertoire.
As tu créé le fichier my_index.json avec la config pour lui indiquer l'ota a surcharger ?
as tu vérifier, une fois ton image docker redémarré, que tes modifs ont bien été conservé ? (assures toi d'etre dans un volume)

L041S, 2022-09-04:
Le my_index.json avec la config que tu as indiqué est ok, il se trouve dans ce même répertoire à côté de l’ota, le configuration.yaml de z2mqtt et le lixee.js  modifié. Au cas ou, la commande que j’utilise pour lancer le container zigbee2mqtt :
`docker run -d    --name zigbee2mqtt    --restart=always    --device=/dev/ttyUSB0    -p 8080:8080    -v /home/user/zigbee2mqtt/data:/app/data    -v /run/udev:/run/udev:ro    -e TZ=Europe/Paris    koenkk/zigbee2mqtt `

git-greatguy, 2022-09-04:
Il faut regarder le log de z2m pour voir ce qu'il fait quand tu lance le check ota. normalement si il prend bien en compte les fichiers, tu doit voir une mention à l'override du dépot main.
Tu peux aussi créer une faute de syntaxe dans le fichier lixee.js pour valider qu'il le charge bien. cela devrait générer une erreur au démarrage.

L041S, 2022-09-04:
Je viens de vérifier les logs, il ne prend tout simplement pas en compte mes modifs et continue de vérifier sur le github. Pourtant le fichier lixee.js est bien là à côté du configuration.yaml, je vais creuser ça demain… Merci pour tes réponses en tous cas !

`2022-09-05 01:08:27 Is new image available for 'XXXX', current '{"fieldControl":0,"manufacturerCode":4151,"imageType":1,"fileVersion":6}', latest meta '{"fileVersion":6,"fileSize":243758,"url":"https://github.com/fairecasoimeme/Zlinky_TIC/releases/download/v6.0/ZLinky_router_v6.0.ota"}'`

git-greatguy, 2022-09-04:
au tamps pour moi... j'ai oublié une ligne de config :
dans le fichier configuration.yaml de z2m il faut ajouter cette information de surcharge du lixee.js

```
external_converters:
  - lixee.js
```

Je vais updaté mon post précédent... désolé :O

L041S, 2022-09-04:
Victoire, la mise à jour s’effectue !!!
Merci beaucoup !🥳
Je n’ai plus qu’à le laisser terminer son update et ensuite je pourrais tout remettre comme avant au niveau du configuration.yaml ?

Par ailleurs j’ai lu sur les posts du dessus que certains restaient dans une mise à jour en boucle, il y a une manipulation spéciale à faire pour que cela n’arrive pas ?

git-greatguy, 2022-09-04:
il suffit de commenter les deux lignes de config dans le configuration.yaml de z2m pour supprimer le process de rollback forcé.
Pour ma part, depuis le rollback en v5, il me propose a nouveau d'upgrade en v5, a cause du "force : true" mais il ne boucle pas. Pour supprimer la proposition de mise a jour, il suffit de supprimer et réappairer le device. Il te proposera a nouveau la v6 du dépot officiel si tu fais un check update.

tomj44300, 2022-09-05:
apres avoir essayé de downgrade durant 2h car la v6 ne marchais pas , çà c'est débloqué je ne sais comment et marche nickel depuis 48h non stop, par contre j'ai l'impression que çà ne fait aucun poling çà m'envoie les données dès changement, maximum 10s avant maj auto le plus souvent 2/3s max
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

Patoche781, 2022-09-06:
Bonjour. J'ai le même souci depuis le passage de V5 en V6: plus de remontées + impossibilité de se connecter à z2m depuis car ('ai supprimé le device Zlixee de z2m dans l'espoir de le reconnecter.... Dès lors impossible de l'appairer ! Le voyant bleu s'éteint et se rallume en bleu fixe à chaque reset... Comment faire pour le downgrader en V5 puisque je n'ai plus de lien de communication device-z2m ?
Merci pour votre aide.

gael1980, 2022-09-06:
Bonjour,
J'ai réussi à faire tourné la V6 en

1. Supprimer lixee de z2m (option force)
2. éteindre HA
3. déconnecter ma clé combi2 30s (j'ai lu une fois dans un forum que de déconnecter la clé, forcer la ré init)
4. reconnecter la clé et re démarrer HA
5. refaire l'asso du lixee

Depuis, cela fonctionne en v6.
Le seul PB, est la réception qui est moins bonne, du au fait qu'il ne ce connecte que sur un seul routeur)

git-greatguy, 2022-09-06:
J'ai vu également que la v6 s'est vu sa connexion zigbee limitée en terme de node. le changelog fait référence a la consommation énergétique pour justifier ce changement.
Quel est le gain énergétique réel de cette modification ? Y'a t-il eu des cas ou le lixee charge plus que les 130mw de puissance dispo sur les bornes de la tic ?

fairecasoimeme, 2022-09-06:
Le ZLinky n'est pas censé se connecter sur un seul routeur mais ne gérer qu'une seule route. Il ne faut pas confondre la fonction de router avec être routé. Mais en aucun cas, le ZLinky ne peut appartenir qu'à une seule route. Le coordinateur ou les routeurs qui routent le ZLinky ne sont pas impactés...

De ce que j'ai vu de mes tests, le problème du firmware V6 n'a l'air d'impacter que Z2M. Au bout d'un moment, il n'y a plus de polling et je ne sais pas pourquoi. Concernant les reports, ça à l'air de passer.

Le fait de limiter la capacité de router d'autres devices permet de limiter le trafic radio passant par le ZLinky et donc économiser des transmissions/réceptions radios consommatrices d'énergie.

Cette version a été développée car certains clients, ayant par exemple des ampoules philips Hue (Très bavardes) connectées au ZLinky ou plutôt routaient par le ZLinky, ont des coupures liées à un manque d'énergie délivré par le Linky.

git-greatguy, 2022-09-06:
Une question, toujours sur le routage via le z-linky :
Ne peut-on pas gérer, via un paramètre, la possibilité d'activer ou désactiver la fonction de routage pour d'autres appareils ?

Personnellement, j'ai besoin qu'il route un contacteur de porte dans le sous sol. La v6 me faire perdre tout lien avec cet appareil et m'oblige a revoir la configuration de mon réseau, qui passerai sans doute par l'achat / la mise en place d'un nouveau routeur dans le sous sol !

Je comprend très bien maintenant l'origine de cette modification, et elle totalement fondé. Mais il ne faut pas perdre de vue que la fonction de routage peut aussi être un facteur important pour d'autres utilisateurs de la solution ;)

fairecasoimeme, 2022-09-06:
Pas de panique, je vais sortir une version avec routage, j'espère cette semaine ou semaine prochaine.

Patoche781, 2022-09-06:
Le Zlinky est UP!
 Opérations suivantes ont été faites : shutdown HA via Proxmox puis unplug device Sonoff USB Zigbee puis reboot HA . Suite au reboot -> reset Zlinky puis analyse des logs z2m -> payload sur device... Tiens tiens ! Restart z2m -> new device apparu: c'est lui en V6!  Remontées datas -> en cours . Reparamétrage des W précision, etc...   En attente remontées dans tableau "energie".

pdecat, 2022-09-06:
> De ce que j'ai vu de mes tests, le problème du firmware V6 n'a l'air d'impacter que Z2M.

Pour ma part, j'utilise Home Assistant avec ZHA (Zigpy ZNP) et j'ai également dû repasser de v6.0 en v5.0 car au bout de quelques heures après avoir été débranché/rebranché, mon ZLinky (modèle avec antenne et condensateur) clignotait fréquemment, perdait souvent la connectivité ZigBee, et ne répondait plus aux lectures d'attributs ou autres commandes. Aucun problème depuis le downgrade en v5.0 effectué dimanche matin.

Note : pour parvenir à déclencher l'OTA de downgrade, j'ai dû brancher mon ZLinky en USB avec un adaptateur TTL proche de mon coordinateur (mon compteur est à l'extérieur à ~20 mètres de la maison), et le réinitialiser. C'est la  première fois que ça me fait cela.

WarC0zes, 2022-09-07:
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

Ca me rassure, étant sous ZHA aussi j'ai eu les même soucis avec la v6 et du faire un downgrade en v5.

Parlendir, 2022-09-07:
N'est il pas possible de :
* pousser une nouvelle image estampillée v7 mais dont les données correspondent à la v5 pour que tout le monde puisse faire la màj ota facilement
* supprimer la v6 du dépôt contenant les mises à jour
* avoir une prochaine v8 correspondant à la correction de la v6

Cela simplifierait grandement la gestion de cette mise à jour qui est une régression pour les utilisateurs z2m.

pdecat, 2022-09-07:
> * pousser une nouvelle image estampillée v7 mais dont les données correspondent à la v5 pour que tout le monde puisse faire la màj ota facilement

C'est ce qui a été fait :
* https://github.com/fairecasoimeme/Zlinky_TIC/issues/89#issuecomment-1235530610
* https://github.com/fairecasoimeme/Zlinky_TIC/issues/87#issuecomment-1234488515

Parlendir, 2022-09-07:
>

> * pousser une nouvelle image estampillée v7 mais dont les données correspondent à la v5 pour que tout le monde puisse faire la màj ota facilement

Mon z2m (v1.27.2) ne voit pas de mise à jour pour le lixee. Donc ce n'est pas ce que j'ai évoqué : la mise à jour n'est pas le dépôt consulté par défaut par z2m, selon la procédure basique.
Pas de souci, j'attendrai la mise à jour de correction.
Merci au dév, c'est un super produit ! J'ai mis beaucoup trop de temps à découvrir son existence :)

pdecat, 2022-09-07:
La mise à jour pour z2m est là : https://github.com/Koenkk/zigbee-OTA/pull/156

ach-78, 2022-09-07:
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

Ce n'est pas ce qui a été fait, car une fois installé, ce firmware pseudo-v7 apparait comme une v5 en terme de version courante.
C'est comme ça que mon downgrade (ZHA) est parti en boucle : à peine terminé, il redétectait une Maj à faire de v5 en v7. Sauf à modifier le yaml et redémarrer HA, ça peut boucler comme ça indéfinniment.

Je suis d'accord avec Parlendir que ça diminuerait le risque de complication de sortir une v7 (identique en contenu qu'une v5) mais qui reste apparente "v7" une fois installée comme si c'était une vraie v7, le temps qu'il y ait une vraie v8 (qui serait une v6 fixée en fait).

pdecat, 2022-09-07:
Ok, j'avais mal compris ce qui était demandé. Pour ma part avec ZHA, je gère les fichiers dans le dossier `zigpy_ota` à la main donc j'ai juste eu à supprimer les fichiers une fois le downgrade terminé.

antoinelibert, 2022-09-08:
Bonjour,

Pour ma part, je tourne avec la V6 (devenue "expérimentale") depuis sa sortie et pas de problème particulier. J'ai quand même du reset le zlinky après la màj, ré-appairer avec z2m et reconfigurer). Habituellement j'avais un plantage du zlinky plus ou moins toutes les 1-2 semaines. Pour l'instant depuis sa màj, rien à signaler.

fairecasoimeme, 2022-09-09:
Bonjour,
Avant de mettre en release, est-ce possible pour ceux qui ont eu un problème de tester cette version de firmware qui je l'espère corrige les problèmes que vous avez eu.

[ZLinky_GpProxy_Ota_OM15081_V7.zip](https://github.com/fairecasoimeme/Zlinky_TIC/files/9536627/ZLinky_GpProxy_Ota_OM15081_V7.zip)

domoblog, 2022-09-10:
Bonjour a tous,
V6 fonctionnelle et stable sur z2m après les manipulations suivantes :

1- update vers 1.27.2
2- delete du Lixee
3- restart HA
4- nouvelle association du Lixee
5- reparametrage

Fait il y a 3 jours sans downgrade et plus de décrochage, ni de perte de mesure.

pdecat, 2022-09-10:
Bonjour @fairecasoimeme, upgrade fait à l'instant avec `ZLinky_GpProxy_Ota_OM15081_V7.ota`:

```
2022-09-10 10:56:42.851 DEBUG (MainThread) [zigpy.zcl] [0xB164:1:0x0019] OTA image_block handler for 'LiXee ZLinky_TIC': field_control=FieldControl.0, manufacturer_id=4151, image_type=1, file_version=7, file_offset=243726, max_data_size=48, request_node_addr=Noneblock_request_delay=None
2022-09-10 10:56:42.851 DEBUG (MainThread) [zigpy.zcl] [0xB164:1:0x0019] OTA upgrade progress: 100.0
2022-09-10 10:57:57.726 DEBUG (MainThread) [zigpy.zcl] [0xB164:1:0x0019] Decoded ZCL frame: Ota:upgrade_end(status=<Status.SUCCESS: 0>, manufacturer_code=4151, image_type=1, file_version=7)
2022-09-10 10:57:57.727 DEBUG (MainThread) [zigpy.zcl] [0xB164:1:0x0019] OTA upgrade_end handler for 'LiXee ZLinky_TIC': status=Status.SUCCESS, manufacturer_id=4151, image_type=1, file_version=7
```

Tests en cours...

pdecat, 2022-09-10:
J'ai eu quelques soucis suite à l'upgrade, le ZLinky_TIC ne captait plus comme avec la v6.0.
J'ai dû le rebrancher proche de mon coordinateur alimenté en USB TTL pour réussir à le réinitialiser, puis il s'est mis à répondre aux lecture d'attributs.
Je viens de le rebrancher sur mon compteur Linky et ça semble fonctionner à nouveau normalement.

ach-78, 2022-09-10:
J'ai mis la v7 hier soir, et de ce que je vois ce matin j'ai de nouveau une réception dégradée.

En v5 j'ai aussi régulièrement des "WARNING (MainThread) [homeassistant.helpers.entity] Update of sensor.compteur_linky_electricalmeasurement is taking over 10 seconds", plusieurs fois par jour.

Je doit donc être un peu limite en lien zigbee.
C'est juste que ce qui est plutôt ponctuel en v5 et ne m'empêche pas d'avoir des courbes qui tiennent la route s'aggrave visiblement en v7 où j'ai des graphiques avec une valeur non mise à jour pendant vraiment longtemps (j'ai vu des valeurs figées de plus de 2h plusieurs fois et ce matin cette nuit).

Je suis en ZHA, VM Synology, dongle Sonoff 3.0. HA avait été redémarré suite à la mise à jour v7 (pour enlever les logs DEBUG). Je continue d'observer pour voir s'il y a du changement.

WarC0zes, 2022-09-10:
@ach-78 Je suis comme toi, sous ZHA et dongle sonoff 3.0 et j'ai exactement la même erreur depuis que j'utilise le Zlinky. Je suis en v5, car la v6 fonctionnais pas. Mais sur les 2 versions j'ai eu ces erreurs et c'est 3-4 fois par jour.
```
2022-09-10 14:22:22.480 WARNING (MainThread) [homeassistant.helpers.entity] Update of sensor.lixee_zlinky_tic_electricalmeasurement is taking over 10 seconds
2022-09-10 14:22:27.496 ERROR (MainThread) [homeassistant] Error doing job: Task exception was never retrieved
Traceback (most recent call last):
File "/usr/local/lib/python3.10/site-packages/zigpy_znp/api.py", line 984, in request
response = await response_future
asyncio.exceptions.CancelledError
During handling of the above exception, another exception occurred:
Traceback (most recent call last):
File "/usr/local/lib/python3.10/site-packages/zigpy_znp/api.py", line 1023, in request_callback_rsp
await self.request(request, **response_params)
File "/usr/local/lib/python3.10/site-packages/zigpy_znp/api.py", line 982, in request
async with async_timeout.timeout(self._znp_config[conf.CONF_SREQ_TIMEOUT]):
File "/usr/local/lib/python3.10/site-packages/async_timeout/__init__.py", line 129, in __aexit__
self._do_exit(exc_type)
File "/usr/local/lib/python3.10/site-packages/async_timeout/__init__.py", line 212, in _do_exit
raise asyncio.TimeoutError
asyncio.exceptions.TimeoutError
```
A lire ton message, je vais pas tester la v7.

warlordattack, 2022-09-10:
hello,
du coup il y a une maj OTA prévue pour fixer tout ça ? le mien remonte tout le temps les mêmes valeurs figées
et de temps en temps il clignote 6 fois d'affilée : à quoi ça correspond ?

ach-78, 2022-09-11:
24h plus tard, c'est comme si j'étais revenu à mon taux d'erreurs de "croisière" (i.e équivalent à la v5). J'en ai quelques séries dans les logs mais pas de quoi être visible dans les courbes.
Difficile à comprendre, mais c'est mon constat avec le peu de recul que j'ai. Il semble se passer quelque chose après la Maj qui, potentiellement, rentre dans l'ordre tout seul...

fairecasoimeme, 2022-09-12:
Merci pour tous les retours. J'observe qu'il y a plusieurs sujets dans les retours. En ce qui concerne la mise à jour, J'ai l'impression que le ZLinky n'arrive pas à traiter tout le flux d'informations qu'elle se prend au départ.
Pour ceux qui ont des pertes de données régulières, dans un premier temps, je vous conseille de limiter les demandes d'informations au polling (limiter aux données qui vous intéressent) et de préférer l'utilisation des rapports (config report).
J'ai pu tester à de nombreuses reprises que HA enclenche énormément de read attribute que le ZLinky ne peut pas traiter car il coupe pour faire une acquisition Linky.

De mon côté je vais regarder si je peux optimiser et décaler l'acquisition Linky s'il y a une activité radio, ce qui permettrait de ne pas couper et stopper les timeout. Juste cette modif pourrait corriger tous les problèmes.

En entendant restez sur la V5 ou la version dans laquelle vous êtes. Je vous tiendrai au courant.

warlordattack, 2022-09-12:
finalement, j'ai juste supprimé et reassocié le Zlinky_TIC dans Z2M et j'ai de nouveau les données qui arrivent bien

ach-78, 2022-09-12:
Si quelqu'un a un lien à partager pour configurer le Zlinky de manière à limiter les attributs à remonter, je suis preneur. Je suis un gros noob de HA !

Etant en ZHA et un compteur en mode historique, je n'ai de toute façon que 3 sensor qui marchent (VA, Ampères et kWh compteur) donc j'imagine que je pourrais drastiquement alléger la charge du Zlinky...

Sinon sur les dernières 24h, je n'ai eu plus qu'un seul warning "taking over 10 seconds" donc y'a pas photo, quelque chose cloque après la maj mais semble rentrer dans l'ordre par la suite !

antoinelibert, 2022-09-18:
Bonjour,

Une vingtaine de jours plus tard après màj en v6, le zlinky vient de crash (une amélioration par rapport à ce que j'avais avant (au mieux 2 semaines entre chaque crash).

Firmware build date 20220830
Firmware version 4000-0006
Z2M 1.27.2
ConBee2 (0x26720700)
7 reportings configurés (1 minute de délais minimum par reporting, les logs me donnent ~2 messages / min)
Linky en STANDARD BASE / Pas de production / Simple phase

ipogs, 2022-09-18:
Bonjour,

Chez moi avec la v6, pas de crach, mais valeurs PAPP et IINST sont figées depuis la mise à jour

> HA + Z2M + Clé Zigbee Sonoff
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

WarC0zes, 2022-09-21:
Des retour sur la v7 avec ZHA ?

@fairecasoimeme les nouveautées de la v7 sont sympa surtout le "Add 2 config files. With or without childs routing function", car j'ai l'impression qu'avec des enfants connecter au zlinky c'est pire. Je testerai "without childs routing function" qui je suppose est "[ZLinky_router_v7.0_no_route.ota](https://github.com/fairecasoimeme/Zlinky_TIC/releases/download/v7.0/ZLinky_router_v7.0_no_route.ota)" en OTA ?

fairecasoimeme, 2022-09-21:
@WarC0zes oui dans ton cas, il vaut mieux utiliser "[ZLinky_router_v7.0_no_route.ota](https://github.com/fairecasoimeme/Zlinky_TIC/releases/download/v7.0/ZLinky_router_v7.0_no_route.ota)"

pdecat, 2022-09-21:
Bonjour @fairecasoimeme, est-ce que `ZLinky_GpProxy_Ota_OM15081_V7.ota` est exactement la même chose que https://github.com/fairecasoimeme/Zlinky_TIC/releases/download/v7.0/ZLinky_router_v7.0.ota ? Si ça n'est pas le cas, comment je fais pour l'OTA étant donné la version qui est la même ?

WarC0zes, 2022-09-21:
J'ai maj en v7 no route, ca a l'air stable ( plus stable que la v6 en tout cas). Je verrai dans 24h, je vous tient au courant.

fairecasoimeme, 2022-09-21:
@pdecat la nouvelle version n'est pas la même. Je t'ai envoyé un OTA qui simule une v8 pour que la mise à jour se déclenche
Merci des retours qui me permettront de la passer en release.

WarC0zes, 2022-09-22:
@fairecasoimeme La v7 no route a pas l'air plus stable que la v5. Quand j'ai maj en v7 no route j'avais 6 routeurs sur le réseau zigbee (ZHA), la led bleu a clignoté (lent) quelques fois sur 12h. Ce matin j'ai voulu tester d'ajouter une multiprise, donc je suis passé a 7 routeurs et le Zlinky clignote (lent) un peu plus que avec 6 routeurs (sur la v5 s'était pareille).

J'ai remarquer que sur la v7 no route le Zlynky avait moins de route que les autres routeurs.
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

1/ Pouvez vous limitez le nombre de route au Zlinky?
2/ Ou est-il possible de faire un firmware Zlinky enfant, qui communiquerais  qu'avec le coordinateur.

antibill51, 2022-09-22:
J'ai mis à jour hier sur la V7 Routeur, et tout a l'air d'aller depuis.

pdecat, 2022-09-22:
Aucun soucis de mon côté avec l'OTA [ZLinky_router_v7.0.ota](https://github.com/fairecasoimeme/Zlinky_TIC/releases/download/v7.0/ZLinky_router_v7.0.ota).

WarC0zes, 2022-09-22:
@pdecat @antibill51 vous avez combien de routeurs sur votre réseau zigbee avec le Zlinky ?

pdecat, 2022-09-22:
Quelques uns :
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

Thread 92 (2022-09-12):

0x0702/0x0110 is documented as RP how when Report Config we got an error

pipiche38, 2022-09-12:
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

fairecasoimeme, 2022-09-12:
I confirm that cluster 0x702 / 0x110 is in RP mode.
your trace is about read reporting config (0x122 command) not a setting of a report config (0x120 command)
This kind of error could arrive when setting a config report is not passed.

pipiche38, 2022-09-12:
Juste after a fresh reset of the ZLinky
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

pipiche38, 2022-09-12:
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

fairecasoimeme, 2022-09-12:
After a reset or a flash erase ?

pipiche38, 2022-09-12:
A reset

fairecasoimeme, 2022-09-12:
No a reset is a reboot with a clear of RAM memory and registry . If you want to clear cfg binding table, pairing and other flash memory, it's a factory reset. So what did you do ?

Closed 2022-09-12.

Thread 93 (2022-09-12):

Reporting Configuration of 0x0b04/0x050b.... result in Software Failure !

pipiche38, 2022-09-12:
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

fairecasoimeme, 2022-09-12:
This error message can occur if the config report table is full.
You can verify with a usb-ttl module connected to 115200 baud. when you use the reset button, the device reboot with the config report table

pipiche38, 2022-09-12:
How can Config Report table be full just after a RESET ? How can we clean it ?

- The ZLinky has been reset

        "ConfigureReporting": {
                "0702": {
                        "Attributes": {
                                "0100": { "DataType": "25", "MinInterval": "0046", "MaxInterval": "0E10", "TimeOut": "0000", "Change": "000000000005" },
                                "0102": { "DataType": "25", "MinInterval": "0046", "MaxInterval": "0E10", "TimeOut": "0000", "Change": "000000000005" },
                                "0104": { "DataType": "25", "MinInterval": "0046", "MaxInterval": "0E10", "TimeOut": "0000", "Change": "000000000005" },
                                "0106": { "DataType": "25", "MinInterval": "0046", "MaxInterval": "0E10", "TimeOut": "0000", "Change": "000000000005" },
                                "0108": { "DataType": "25", "MinInterval": "0046", "MaxInterval": "0E10", "TimeOut": "0000", "Change": "000000000005" },
                                "010a": { "DataType": "25", "MinInterval": "0046", "MaxInterval": "0E10", "TimeOut": "0000", "Change": "000000000005" },
                                "010c": { "DataType": "25", "MinInterval": "0046", "MaxInterval": "0E10", "TimeOut": "0000", "Change": "000000000005" },
                                "010e": { "DataType": "25", "MinInterval": "0046", "MaxInterval": "0E10", "TimeOut": "0000", "Change": "000000000005" },
                                "0110": { "DataType": "25", "MinInterval": "0046", "MaxInterval": "0E10", "TimeOut": "0000", "Change": "000000000005" },
                                "0112": { "DataType": "25", "MinInterval": "0046", "MaxInterval": "0E10", "TimeOut": "0000", "Change": "000000000005" }
                        }
                },
                "0b04": {
                        "Attributes": {
                                "0508": { "DataType": "21", "MinInterval": "000A", "MaxInterval": "0E10", "TimeOut": "0000", "Change": "0001" },
                                "050b": { "DataType": "29", "MinInterval": "000A", "MaxInterval": "0E10", "TimeOut": "0000", "Change": "0001" },
                                "050d": { "DataType": "29", "MinInterval": "000A", "MaxInterval": "0E10", "TimeOut": "0000", "Change": "0001" },
                                "050f": { "DataType": "21", "MinInterval": "000A", "MaxInterval": "0E10", "TimeOut": "0000", "Change": "0001" },
                                "090b": { "DataType": "29", "MinInterval": "000A", "MaxInterval": "0E10", "TimeOut": "0000", "Change": "0001" }
                        }
                },
                "ff66": {
                        "Attributes": {
                                "0203": { "DataType": "23", "MinInterval": "000A", "MaxInterval": "fffe", "TimeOut": "0000", "Change": "00000001" },
                                "0204": { "DataType": "23", "MinInterval": "000A", "MaxInterval": "fffe", "TimeOut": "0000", "Change": "00000001" },
                                "0205": { "DataType": "23", "MinInterval": "000A", "MaxInterval": "fffe", "TimeOut": "0000", "Change": "00000001" },
                                "0206": { "DataType": "23", "MinInterval": "000A", "MaxInterval": "fffe", "TimeOut": "0000", "Change": "00000001" },
                                "0210": { "DataType": "29", "MinInterval": "000A", "MaxInterval": "fffe", "TimeOut": "0000", "Change": "0001" }
                        }
                }
        },

fairecasoimeme, 2022-09-12:
Please share your debug console to see the config report table.

To clear all the table you have to do a factory reset --> press 10 sec to the link button.

Closed 2022-09-12.

Thread 102 (2022-10-01):

"Linky acquisition time" ?

mdeweerd, 2022-10-01:
"Linky acquisition time (From V7)
Now you can modify the time to do a Linky acquisition."

Can you clarify what this means?  Why not use the min/max reporting intervals ?  What if the reporting interval is set to minimum reporting 1 second (and low W)?

mdeweerd, 2022-10-03:
@pipiche38  Thank you

@fairecasoimeme
> A Linky send (across serial connection) all datas in a continuous flow. ZLinky do a capture regulary (It can't do all the time).

I am a bit surprised, is it not possible to capture the ZLinky data using some DMA functionnality of the uC?

The uC specification clearly mentions USART as a source of DMA requests:
https://www.nxp.com/docs/en/nxp/data-sheets/JN5189.pdf#page=31

I am not familiar with this CPU, but the following links suggest it seems to be provided for: https://mcuxpresso.nxp.com/api_doc/dev/329/group__usart__dma__driver.html

I guess that the DMA could be filling a ring buffer that could be analysed right when it stopped being filled since a given time (possibly using the IDLE interrupt) indicating the ERL communication is done for that second.

I did not check the code to see how it is done now.

mdeweerd, 2024-01-15:
Stale Issue, closed by the author ;-).

Closed 2024-01-15.

Thread 104 (2022-10-03):

Ne recoit plus grand chose d'actuel

gromo69, 2022-10-03:
Hello
Depuis les mises a jour OTA 0006-0007-0008-0009 je ne reçois plus grand chose à jour comme valeur !
En effet seul TIC_current_date semble updater toutes les minutes
Dans les logs Zigbee2MQTT je vois cela toute les 60sec. : "zlinky config: standard, three_phase, true, ENGIE ELEC WE"
zha core 2022.9.1 Z2M 1.28.0-1

restart zha ou Z2M n'y change rien, idem pour reconfigurer le LiXee...

Je ne sais pas comment revenir en arrière OTA sur le firmware 0005 par exemple

Merci de votre aide

Thierry

fairecasoimeme, 2022-10-03:
Bonjour,
Pour tester si le ZLinky répond, vous pouvez aller dans l'onglet console dev et faire une requête manuelle :
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
Certains utilisateurs ont ce type de problème mais je ne sais pas d'où cela provient

antoinelibert, 2022-10-03:
Bonjour,

Après une mise à jour, il faut penser à le reset : supprimer de Z2M en forçant le unpair, reset le zlinky (10 secs sur le bouton) puis pair de nouveau . J'ai rarement eu un comportement normal sans faire un reset après une màj.

gromo69, 2022-10-04:
OK merci à tous... en effet supprimé, resetté, ré-appairé puis renommé.. c'est bon j'ai un update complet des valeurs... :-)

Closed 2022-10-04.

Thread 105 (2022-10-03):

optimiser le circuit de détection des trames TIC

christopheVia, 2022-10-03:
Le compteur Linky comporte deux modes de fonctionnements, historique et standard. Les données sont envoyées entre les contacts I1 et I2 à travers une modulation en amplitude sur une porteuse de 50kHz. En mode historique, le débit de données est de 2400bauds mais il monte à 9600bauds en standard. Sur ce dernier mode, la différence de fréquence entre les données et la porteuse n'est plus si grande que cela et cela peut parfois engendrer des mauvaises détections.
Dans la pluspart des montages que l'on trouve sur le net, la démodulation est confiée à un optocoupleur. Mais tous les optocoupleurs ont des dispersions importantes de leur caractéristiques et en particulier les capacités parasites qui sont liées à la bande passante du circuit. Si on n'a pas de chance, l'optocoupleur XXX va mal fonctionner chez soi alors que le même circuit fonctionne sans problème chez son voisin. En se basant sur ce constat, je propose le schéma suivant (dessiné et simulé sous LTspice) :
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

Je me suis imposé le cahier des charge suivant :
- faire au plus simple = pas de détection AM synchrone
- le moins cher possible = composants standards et facilement trouvables
- consommation minimale tirée de l'alimentation 3,3V du module Zigbee
- Ne pas confier la démodulation AM à l'optocoupleur

Le circuit commence entre les noeuds I1-I2. Le reste à gauche tente de modéliser le signal qui sort du Linky (amplitude 12V ici mais c'est 25V à vide).

Détection d'enveloppe à diode :
Le pont à diode D2-D3-D4-D5 commence par faire un redressement double alternance du signal pour faire un x2 à la fréquence de la porteuse. Des diodes Schottky sont indispensable ici pour éviter de perdre trop d'amplitude due à la tension de seuil. Cette partie est indispensable au bon fonctionnement de la démodulation parce qu'elle diminue l'amplitude des ondulations présentes sur le signal d'enveloppe. Cette détection d'enveloppe est opérée par C1 en parallèle avec une résistance constituée par la résistance dynamique de la LED de l'optocoupleur et R5. La constante de temps de ce circuit RC est choisie pour couper la porteuse tout en laissant passer le débit binaire de 9600bps. La détection d'enveloppe (=l e signal binaire qui nous intéresse) est faite avant l'optocoupleur. La LED de l'optocoupleur mesure et envoie un courant qui est l'image du signal numérique. Les résidus de porteuse ne nous embetteront pas.
La LED de l'optocoupleur n'est pas utilisée pour faire la détection d'enveloppe, ça ne va pas assez vite (trop de capacité parasite).

Mise en forme des signaux :
Les optocoupleurs classiques comme le PC817 ne sont pas très rapides lorsqu'ils sont utilisés comme suggéré dans leur datasheet. Ils le sont beaucoup plus lorsque ils sont utilisés dans la configuration du schéma ci-dessus. Une grande bande passante est appréciable ici, même si la démodulation n'est pas confiée à l'optocoupleur parce que l'on cherche malgré tout à ce qu'il commute rapidement. L'émetteur du photo-transistor attaque la base de Q1. Pour Q1, un bipolaire est choisi, et surtout pas un MOS, parce que la faible impédance d'entrée permet de maintenir assez bas le temp de transition de l'état ON vers OFF du photo-transistor. La résistance R4 est aussi indispensable pour limiter le stockage de charges dans la base. Q1 inverse également le signal numérique : les 1 logiques sont transmis par l'état bas dans le signal modulé et il faut retourner tout ça à la fin.

(oublier R8 qui n'est là que pour éviter à LTspice de planter)

Voici quelques captures d'écran issus de la simulation avec une porteuse à 12V
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
Le signal issu du redresseur double alternance pour la détection d'enveloppe est en rouge. La porteuse est déjà bien atténuée. Le courant capté par la LED de l'optocoupleur est en bleu marine.
Le signal bleu clair est le signal de sortie. Plus aucun résidu de porteuse n'est perceptible.
L'ensemble tire 500µA sur le rail d'alimentation 3,3V (en rose, coruant négatif parce que convention géné).
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
idem mais avec une porteuse réglée à 25V. Jje ne sais pas vraiment ce que le Linky sort réellement. La doc Enedis n'est pas d'une clarté époustouflante.

Enfin, je suggère de remplacer les BAV21 ( @fairecasoimeme j'ai bon pour la ref ?) par des diodes Schottky 1A car la tension de seuil tombe à 0,3 - 0,35V au lieu de 0,7V dans le cas de diodes silicum classiques. Lorsque l'alim doit fournir trop de courant, la tension issue du générateur entre les contacts A et I1 chute. Tout s'arrête lorsque la tension appliquée à l'entrée du régulateur n'est pas suffisante pour le faire fonctionner. Avec des diodes Schottky la limite en puissance est repoussée un petit peu plus haut.

fairecasoimeme, 2022-10-04:
Merci beaucoup pour la contribution et l'analyse.
`En mode historique, le débit de données est de 2400bauds` Attention, la vitesse est de **1200bauds** me semble t-il.

Je vais, du coup, tester ton schéma en réel pour pouvoir faire des tests avec les différents Linky que j'ai et voir la différence avec le schéma originel.

Pour les BAV21W, oui c'est la bonne réf mais à l'origine je les avais choisi car Enedis demandais que le module soit 230V compliant (pas pour que ça fonctionne à cette tension mais que ça ne dégrade pas) mais dans la discussion avec eux ça n'était pas applicable au ZLinky (le module empêche le branchement d'autres équipements par erreur) et je me suis arrêté là puis je ne suis pas revenu en arrière sur la réf.

Du coup, ce point me semble important et je vais repasser sur des Schottky à faible chute de tension.

Malgré tout, je n'ai quasi jamais eu de retour sur un problème de décodage du Linky. La majorité des problèmes sont sur le blocage du ZLinky lié à des problèmes de tensions:
- soit une grosse chute qui a été corrigé en grande partie par le condensateur (voir [errata](https://github.com/fairecasoimeme/Zlinky_TIC#errata-hardware))
- soit une baisse de tension progressive sans tomber à zéro qui met l'oscillateur en PLS que je corrige normalement avec un superviseur de tension BD48L26G-TL

Enfin, Enedis a reconnu à travers les remontées clients que certains Linky ne respecte pas le tableau :
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

Certains utilisateurs ont :
- Tension à vide : 2.97 V
- Tension quelques secondes après branchement (connexion Zigbee rétablie) : 1.87-1.90 V

La mesure est prise entre A et i1, du coup, les diodes + les régulateurs, le micro démarre normalement à partir de 1.9V. Difficile de faire quelque chose avec ça. Avec le superviseur à 2.6V, au moins ça permet de ne pas démarrer plutôt que d'avoir un système bancal. Peut-être qu'un buck boost peut faire l'affaire ... mais pas magique non plus.

Je vous tiendrai au courant sur ce fil de mes tests avec ces modifications.

Merci encore pour la contribution

christopheVia, 2022-10-04:
Je corrige pour 1200bauds. Si ça marche pour 9600, ça marchera pour 1200. Dans tes expérimentations, il faudra peut être retoucher R6 et R2, voire ne mettre qu'une seule résistance avant le pont de diode. Il ne faut pas dépasser 0,6mA dans la LED de l'optocoupleur.
J'ai cru comprendre aussi que l'impédance d'entrée ne doit pas dépasser 2kohm ? mais la Doc Enedis n'est pas clair et je ne suis pas sûr que ce soit critique.

Pour ce qui est des BAV21, j'ai pensé que c'était pour ça que tu avais choisi des 250V, par contre, ce que je comprends de la doc Linky c'est que la table 1 donne les caractéristiques de leur sortie. Mais ce n'est pas très clair. En outre, je ne vois pas pourquoi un module autonome sans aucun contact avec l'extérieur devrait tenir des surtensions de 250V.

L'idée du superviseur d'alim est bonne, il faut la garder parce qu'elle permet de ré-initialiser proprement le module. Par contre, pour les Linky qui ne présentent qu'1,9V en charge, c'est compliqué. Il existe bien des convertisseurs DC-DC SEPIC low-power mais la difficulté va être de trouver un ref capable de fonctionner avec une très basse tension d'entrée et qui en même temps soit capable de gérer des tensions d'entrée de 16V. Il y a le LT1613 ou le LT1703 mais ils n'acceptent pas plus de 10 à 12V d'entrée. Chez TI, je ne vois pas de circuit adapté.

fairecasoimeme, 2022-10-04:
> Mais ce n'est pas très clair. En outre, je ne vois pas pourquoi un module autonome sans aucun contact avec l'extérieur devrait tenir des surtensions de 250V.

 En fait, Enedis pensaient a des ERL avec des connecteurs accessibles et pensant à des utilisateurs qui branchent du 220V par erreur.

Et oui pas facile de trouver des reguls qui gèrent bien à la fois des tensions faibles et des tensions à 16V tout en étant performant.

> Est-ce qu'il ne faudrait pas qu'ENEDIS considère les linky qui ne délivrent que 3V comme défectueux ? Les utilisateurs dans ce cas demandent à le faire changer. Clairement, on ne peut pas faire grand chose en auto-alimenté avec des Linky comme ça.

Je leur ai posé la question pour les clients dans ce cas et pour le moment, il n'existe pas de procédure pour changer un Linky avec la TIC défectueuse. Rien n'est prévu. On devrait en parler encore à la prochaine réunion avec eux. Ils sont très à l'écoute mais étant une grande "institution" ça ne bouge pas trop vite.

Tolriq, 2022-10-04:
Surement une question bête vu que j'y connais rien, mais pour ceux qui ont les Linky pourris (probablement mon cas) il n'y a pas moyen de créer un petit module d'alimentation externe à insérer entre les 2?

christopheVia, 2022-10-04:
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

Par contre, pour les Linky "normaux", un régulateur SEPIC peut aussi être une bonne idée. En améliorant le rendement global de l'alimentation, tu pourrais peut être éviter d'avoir à maintenir deux codes informatiques sans et avec le mode routeur.

fairecasoimeme, 2022-10-04:
@christopheVia il est évident que si j'arrive à améliorer la partie alimentation, il n'y aurait plus qu'un mode.

@Tolriq oui, il y a moyen d'alimenter le zlinky sans passer par l'autoalimentation du Linky. Tu peux suivre ce schéma et prendre que le 3.3v et GND https://github.com/fairecasoimeme/Zlinky_TIC#mise-%C3%A0-jour-du-firmware-non-ota

fairecasoimeme, 2022-10-10:
Bonjour,
J'ai commencé par faire le changement des diodes par des Schottky (B5819W-TP). Malheureusement, ce changement ne change rien sur la tension.
J'ai fait des tests sur la LED pour baisser la conso. La version du circuit actuelle fait que la LED n'est pas sur une broche PWM compatible. Mais j'ai utilisé un timer (simulant un peu le PWM). Du coup, j'ai réussi, avec cette méthode, à gagner 0.3V. C'est pas un miracle mais ça peut aider. Sur la nouvelle version, ce sera piloter par un vrai PWM. Je vous tiendrai au courant des avancements.

christopheVia, 2022-10-12:
@fairecasoimeme
En cherchant pour une autre appli au boulot, je suis tombé sur le TPS560430. Il s'agit d'un régulateur DC-DC buck en boitier SOT23-6, pas cher, simple à régler, rendement excellent qui pourrait sérieusement accroitre le courant disponible pour le module zigbee.
Une alim 15V donnée pour 120mW peut délivrer 8mA max. en continu à la charge (en considérant que la tension ne bouge pas jusqu'à la limite en courant). Abaissée à 3,3V avec un régulateur linéaire, on pourra éventuellement se rapprocher de ces 8mA sur la ligne 3,3V si la conso interne du régulateur n'est pas trop élevée. La même alim cablée sur un régulateur buck pour descendre à 3,3V va pouvoir délivrer jusqu'à 32mA en sortie, en considérant un rendement de 90%. ça change tout, non ?

christopheVia, 2022-11-04:
Je viens de voir dans le wiki les photos de la clé en version "antenne intégrée". Je dispose pour ma part de la version à antenne déportée.

Petite remarque pour @fairecasoimeme, toujours dans l'idée de proposer des pistes d'amélioration du produit :
L'antenne zigzag du module radio se trouve au dessus du PCB du Zlinky. Même si aucun plan de masse ne s'y trouve pour éviter les problèmes de rayonnement, il se peut que la seule présence d'un PCB à cet endroit ait pour effet de décaler la fréquence de résonance de l'antenne, dégradant par là même la portée de la radio.
En général, une ouverture est pratiquée sous l'antenne pour éviter d'augmenter la capacité parasite de l'élément rayonnant sous l'effet de la constante diélectrique de l'époxy FR4 plus élevée que celle de l'air (entre 4 et 5, vs 1 pour l'air). Cette [doc](https://www.infineon.com/dgdl/Infineon-AN91445_Antenna_Design_and_RF_Layout_Guidelines-ApplicationNotes-v09_00-EN.pdf) explique pas mal de choses sur ces antennes.

Thread 108 (2022-10-07):

Mise à jour de l'index (smart energy consumption)

Kiyozz, 2022-10-07:
Hello,

J'utilise le ZLinky TIC sur Home Assistant via ZHA.

Je rapporte un problème : l'index Linky ne se met pas à jour (home assistant ou l'interval d'update est large ?)

Il peut se mettre à jour parfois quand je redémarre Home Assistant

stadros83, 2022-10-08:
J'ai le même soucis :)
Par contre la consommation instantanée fonctionne bien.

Kiyozz, 2022-10-08:
Ma consommation dans la page Énergie est complètement fausse également

fairecasoimeme, 2022-10-10:
Bonjour,
Malheureusement, il n'y a pas encore de compatibilité native avec ZHA. Il faut suivre ce tuto pour paramétrer et faire remonter les données que l'on souhaite gérer.  https://forum.hacf.fr/t/zlinky-tic-ou-connecter-simplement-linky-en-zigbee/7112/154?u=max

stadros83, 2022-10-10:
Merci pour le retour.
Est-ce qu'une compatibilité avec ZHA est prévue ?
Si j'en crois ce qui est écrit ici il y a des correctifs à apporter au firmware : https://github.com/home-assistant/core/issues/78984
Après je n'y connais rien :(

Kiyozz, 2022-10-10:
C'est quand même bien dommage de se faire livrer un module non mis à jour à sa dernière version

stadros83, 2022-10-10:
J'ai pu faire la mise à jour OTA en version 5 via Home Assistant donc pas de problème là-dessus pour moi.
Par contre ça ne corrige pas le problème de remontée d'information (pour l'instant).
J'ai vu qu'il y avait de nouveaux firmware mais en mode pre release.

fairecasoimeme, 2022-10-10:
> C'est quand même bien dommage de se faire livrer un module non mis à jour à sa dernière version

Le module est livré dans sa dernière version officiel au moment de sa livraison ...

fairecasoimeme, 2022-10-10:
Je pense que c'est la remontée de la version qui n'est pas ok. Essayez de supprimer puis réappairer. La version 01 n'a pas été produite depuis Février 2022.

stadros83, 2022-10-10:
Désolé si j'insiste mais est-il prévu de corriger les "erreurs" dans le firmware pour que celui-ci soit compatible avec ZHA (et le standard Zigbee)  ?

https://github.com/home-assistant/core/issues/78984

fairecasoimeme, 2022-10-10:
> Désolé si j'insiste mais est-il prévu de corriger les "erreurs" dans le firmware pour que celui-ci soit compatible avec ZHA (et le standard Zigbee) ?
>
> [home-assistant/core#78984](https://github.com/home-assistant/core/issues/78984)

Oui ça été corrigé côté firmware. https://github.com/home-assistant/core/issues/78984#issuecomment-1264272508

stadros83, 2022-10-10:
Ah cool merci.
On peut l'installer sans "craindre de soucis" ?
Ou mieux vaut-il attendre encore (je ne suis pas pressé).

Kiyozz, 2022-10-10:
J'ai migré sur Z2MQTT, ça marche x100 mieux. Je dispose maintenant de beaucoup plus d'informations.

Hedda, 2022-10-17:
> Oh cool thank you. Can we install it without "fear of worries"? Or is it better to wait some more (I'm in no hurry).

Assuming that you have already updated the [ZLinky_TIC Router v9.0 firmware pre-release image](https://github.com/fairecasoimeme/Zlinky_TIC/releases) on your Zlinky TIC then you will still need to wait for next ZHA Device Handlers (zha-quirks) package to get released and bumped in Home Assistant core, see:

https://github.com/home-assistant/core/issues/78984

stadros83, 2022-11-03:
J'ai fait les deux dernières mises à jour, v10 et v11.
Aucune ne fonctionne convenablement avec ZHA.
Même l'affichage des watts instantané n'a fonctionné que quelques heures, maintenant le Zlinky ne renvoit plus rien ...

piitaya, 2022-11-26:
J'ai commencé l'intégration des différentes consommation (heures creuses/pleines) dans ZHA : https://github.com/home-assistant/core/pull/82602

Par contre je ne comprend pas trop pourquoi les valeurs des consommations ne sont pas mises à jour automatiquement. Je dois aller dans les attributs des clusters et faire "lire". Quelqu'un aurait une idée ? 😅

WarC0zes, 2022-11-27:
@piitaya
Content de voir des développeurs francais qui s'occupe du Zlinky sous ZHA. Car depuis ca sortie ( 1 ans ) c'est du bricolage sous ZHA pour récupérer les infos  HP et HC.

Thread 110 (2022-10-09):

Firmware no_router OTA

bemble, 2022-10-09:
Bonjour,

J'aimerai mettre le firmware no_router sur le zlinky (j'ai plus de 60 devices zigbee et je pense que mon zlinky est victime de son succès sur mon réseau) mais je n'ai que l'update OTA dispo.

Je suis sous zigbee2mqtt. J'ai essayé de mettre une location custom :
```yaml
  ota:
    zigbee_ota_override_index_location: custom_index.json
```

Et mon fichier custom_index.json :
```json
[
    {
        "manufacturerCode": 4151,
        "imageType": 1,
        "url": "ZLinky_router_v9.0_no_route.ota",
        "force": true
    }
]
```

Sauf qu'on ne me propose pas la MAJ, j'ai toujours 0.9 standard. Comment faire ?

antoinelibert, 2022-10-09:
Il faut suivre cette procédure : https://github.com/fairecasoimeme/Zlinky_TIC/issues/89#issuecomment-1236422701

(Le converter lixee doit être remplacé par un custom qui spécifie une autre manière de faire l'OTA)

bemble, 2022-10-10:
Merci j’étais passé à côté.

Closed 2022-10-10.

Thread 111 (2022-10-09):

ZLinky not working / no report attributes

pipiche38, 2022-10-09:
Because I detected that the ZLinky was sending its repoort to a router and not the coordinator 0x0000, I decided to redo the bind. And systématically as I already mentioned here the bind restult in Table full message, and when trying to unbind the response is entry do not exist

See the unbind command screenshot
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

And then  the bind command

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

pipiche38, 2022-10-09:
Here is a frame where the ZLinky 0xef8c sending apparent power to a Router !!!
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

fairecasoimeme, 2022-10-10:
This function has been tested and re tested and re re tested and it's work perfectly.
As you can see in your trace, you tried to unbind an unknow bind.

As I can see with the report to a router, I think you binded (and config reported) with a router and you tried to unbind with the coordinator mac. (which doesn't exist)

As I already said in https://github.com/fairecasoimeme/Zlinky_TIC/issues/93#issuecomment-1243816164 you can verify with debug console. plug your usb TTL module to the Zlinky and use putty with 115200baud. When you reset (reboot) you can get report table and bind table

here is an ZLinky bind table example :
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

pipiche38, 2022-10-10:
Your function tested and re-tested and work perfectly but in your lab .
As your assumption, you are totaly wrong because the reporting works and suddenly stop working, and it is just by putting the sniffer I was able to see the ZLinky sending reports to a router .

It is up to you to give this level of support and do no trust people reporting issues.

fairecasoimeme, 2022-10-10:
Copy here your debug console ...

In your side, trust the function which is well-tested and don't draw any quickly conclusions.

pipiche38, 2022-10-12:
here is the binding tables which show the correct bindings between the ZLinky and the coordinator
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

fairecasoimeme, 2022-10-12:
This is not that I asked ....
I repeat : plug your usb TTL module to the Zlinky and use putty with 115200 bauds. Push the ZLinky reset button (reboot) and copy/paste the report and bind table.

pipiche38, 2022-10-12:
at least what I'm showing is the binding exists in the bidding table, and the unbind/bin function doesn't work.
I do not have access to the ZLinky, so I cannot do more

Closed 2022-10-10.

Thread 112 (2022-10-14):

Puissance Apparente Totale non retournée

arenoux, 2022-10-14:
Bonjour,
Je possède un lixee et un linky en mode triphasé.

Dans Zigbee2MQTT, je recupere bien les "Puissance appararente immediates delivrées" sur mes 3 phases
| Commande TIC ?  | attribut          |Groupe de fonctionnalités |Titre Compteur|
| :--------------- |:---------------:|:-----|:-----|
| SINSTS1  |   apparentPower        |  haElectricalMeasurement | PUIS APP SOUTIR 1 |
| SINSTS2  | apparentPowerPhB             |   haElectricalMeasurement | PUIS APP SOUTIR 2 |
| SINSTS3  | apparentPowerPhC          |    haElectricalMeasurement | PUIS APP SOUTIR 3 |

Il me semble qu'il existe un attribut totalApparentPower qui permettrait d'avoir la somme de ces 3 attributs (d'ailleurs mon compteur me l'affiche)

| Commande TIC ?  | attribut          |Groupe de fonctionnalités |Titre Compteur|
| :--------------- |:---------------:|:-----|:-----|
| ????  |   totalApparentPower        |  haElectricalMeasurement | PUIS APP SOUTIR |

**Comportement observé** :

Lorsque je tente d'ajouter cet attribut dans les rapport de mon Lixee sur Zigbee2MQTT, j'obtiens l'erreur suivante :

> Request 'zigbee2mqtt/bridge/request/device/configure_reporting' failed with error:
'ConfigureReporting 0x00158d0005d2a634/1 haElectricalMeasurement([{"attribute":"totalApparentPower","minimumReportInterval":60,"maximumReportInterval":"900","reportableChange":0}], {"sendWhen":"immediate","timeout":10000,"disableResponse":false,"disableRecovery":false,"disableDefaultResponse":true,"direction":0,"srcEndpoint":null,"reservedBits":0,"manufacturerCode":null,"transactionSequenceNumber":null,"writeUndiv":false}) failed (Status 'UNSUPPORTED_ATTRIBUTE')'

**Comportement attendu** :
On devrait pouvoir ajouter cet attribut et obtenir la valeur correpondante

fairecasoimeme, 2022-10-17:
Bonjour,
En effet, Il manque l'information de la puissance apparente totale.
l'étiquette SINSTS est gérée de la même manière que SINTS1 (même cluster / attribut) car je pensais que c'était juste l'équivalent du compteur monophasé mais pour le triphasé l'étiquette semble correspondre au total.

Je vais donc mettre à jour le firmware pour gérer SINSTS indépendamment pour récupérer la puissance apparente total.

D'ailleurs même situation pour SMAXS et SMAXS1. à vérifier.

Dès que ce sera OK, je vous tiendrai au courant.

arenoux, 2022-10-17:
Super !
Je confirme que c'est pareil pour la puissance MAX du coté de mon compteur :)

TROM83, 2022-10-31:
Bonjour,

Pour ce même problème, je viens de passer sur le firmware 10. Mais je n'ai toujours pas de valeur SINSTS qui gère la puissance apparente totale.
Pour l'instant, j'ai créé un sensor qui est la somme de SINSTS1, SINSTS2 et SINSTS3 pour géréer cette valeur.
Je suis sous HA avec Zigbee2MQTT.

Merci pour le travail réalisé sur le ZLinky

Tonylolo, 2023-05-08:
Bonjour

D'ailleurs est-ce la puissance apparente ou active qui est facturée ?
Car les 2 sont retournées par le linky.

Merci

arenoux, 2023-08-12:
Je confirme que c'est ok du coté du firmware

| Commande TIC ?  | attribut          |Groupe de fonctionnalités |Titre Compteur|
| :--------------- |:---------------:|:-----|:-----|
| SINSTS   |   totalApparentPower        |  haElectricalMeasurement | PUIS APP SOUTIR |
| SINSTS1  |   apparentPower        |  haElectricalMeasurement | PUIS APP SOUTIR 1 |
| SINSTS2  | apparentPowerPhB             |   haElectricalMeasurement | PUIS APP SOUTIR 2 |
| SINSTS3  | apparentPowerPhC          |    haElectricalMeasurement | PUIS APP SOUTIR 3 |

Reste plus qu'a mettre a jour https://github.com/Koenkk/zigbee-herdsman-converters/blob/master/src/devices/lixee.js pour avoir les valeurs correctement retournées dans mon ZIgbee2MQTT/Home Assistant :)
Je vais essayer de leur proposer une pull request

SilentT-FR, 2023-08-12:
@arenoux  https://github.com/Koenkk/zigbee-herdsman-converters/compare/master...SilentT-FR:zigbee-herdsman-converters:FIX-112 ?

SilentT-FR, 2023-08-12:
ah oui ta presque tout refait :D

arenoux, 2023-08-12:
@SilentT-FR , j'ai proposé une version un peu différente de la tienne pour conserver leur "logique" avec les phases...
Phase 1: xxx
Phase 2: xxxPhB
Phase 3: xxxPhC

https://github.com/Koenkk/zigbee-herdsman-converters/pull/6070/commits/d77964e946d7b25432390275e193a4eb3aab9049

En réalité je préfère ton approche, mais si on veut être cohérent, il faudrait reprendre tous leurs noms de data pour les triphasées...

SilentT-FR, 2023-08-12:
c'est vrais que l'approche permet de bien avoir le nommage de toute les phase
mais cela demande de rename apparent_power donc certainement perte de data

SilentT-FR, 2023-08-12:
Mais dans la logique il faudrait que ce soit fait sur tout attribut a triphase
active_power_max par exemple

SilentT-FR, 2023-08-12:
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

Tres bonne question, comme les valeur EASD0X qui pour moi ne me concerne pas

arenoux, 2023-08-12:
> Mais dans la logique il faudrait que ce soit fait sur tout attribut a triphase active_power_max par exemple

Oui :) Il faudrait le rajouter mais pour l'instant j'ai pas pu tester cette data.
Je n'utilise que ApparentPower chez moi...

Closed 2023-08-12.

Thread 114 (2022-10-18):

PAPP et IINST ne remontent plus depuis MAJ 5.0 -> 9.0 no_route

bemble, 2022-10-18:
Bonjour,

J'avais des soucis de zLinky surchargé, du coup je suis passé sur la version 0.9 no_route du firmware. Cependant depuis cette migration, les valeurs de PAPP et IINST ne remontent plus :
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

Sur les graphs c'est vonstant car c'est la dernière donnée envoyée qui est utilisée, je n'en ai pas reçu depuis la MAJ 0.9 no_route. J'ai rehardé sur mon compteur, le PAPP est bien rempli. J'essaie de rollback sur d'autres versions du firmware (0.9 standard voir 0.5), mais échoue à chaque fois.

A noter que j'ai également ceci qui remonte dans mes logs zigbee2mqtt :
```
Zigbee2MQTT:error 2022-10-18 14:06:01: Failed to configure 'ZLinky', attempt 2 (Error: Bind 0x00158d0005d2a16e/1 seMetering from '0x00212effff073f6f/1' failed (waiting for response TIMEOUT)
    at DeconzAdapter.bind (/app/node_modules/zigbee-herdsman/src/adapter/deconz/adapter/deconzAdapter.ts:768:19)
    at Endpoint.bind (/app/node_modules/zigbee-herdsman/src/controller/model/endpoint.ts:567:13)
    at Object.bind (/app/node_modules/zigbee-herdsman-converters/lib/reporting.js:40:9)
    at Object.configure (/app/dist/util/externally-loaded.js:605:9)
    at Configure.configure (/app/lib/extension/configure.ts:115:13))
```

Une idée ?

fairecasoimeme, 2022-10-19:
Bonjour,
le message d'erreur correspond à un problème de portée. (Timeout sur la réponse)
Avez-vous essayé de faire sortir le ZLinky du réseau puis réappairer ?

pipiche38, 2022-10-19:
https://github.com/fairecasoimeme/Zlinky_TIC/issues/65#issuecomment-1267362376

bemble, 2022-10-20:
Curieux, parce que d'autres données remontent pourtant :
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

Enfin, j'ai essayé de sortir de zlinky du réseau et réappairer, mais impossible, je pense avoir un problème avec mon zlinky, j'ai peur de l'avoir brické en tentant de remettre le firmware v5 :
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

bemble, 2022-10-28:
Après reflashage complet via usb avec reset mémoire , tout est rentré dans l’ordre.

Closed 2022-10-28.

Thread 115 (2022-10-19):

Firmware verso

mospaeda, 2022-10-19:
Hello
In addition, the firmware seems reported wrong in the display

ZLinky_TIC
par LiXee
Connecté via [Zigbee Coordinator]
Firmware: 0x00000001

BUT From the cluster details it seems that it is different (in my case firmware 9 as I received last week)
reference from offcial doc : https://github.com/fairecasoimeme/Zlinky_TIC#clusters

Basic (Endpoint id: 1, Id: 0x0000, Type: in)
Valeur 9

sw_build_id (id: 0x4000)
4000-0009

date_code (id: 0x0006)
20220930

I don't know from where the value 0x00000001 is coming but it is probably not pointing to right register

mospaeda, 2022-10-21:
For record
I received the LiXee ZLinky_TIC already with the firmware 9 installed
I didn't update the received Zlinky by OTA to version 9

Basic -Endpoint id: 1, Id: 0x0000 - Value is 9
Basic - sw_build_id (id: 0x4000) - Value is 4000-0009
Basic - date_code (id: 0x0006) - Value is 20220930.

For some reason, the OTA - current_file_version is reported as 1

Question to @fairecasoimeme
- is OTA current file version set to 1 , if no OTA was done or should it be 9 (or any other number) ?
- is firmware version in Basic or in OTA ?
- do I need to reload version 9 by OTA?

fairecasoimeme, 2022-10-21:
I didn't know that on ZHA the firmware version was related to the OTA cluster
For me the version firmware is in Basic not in OTA
I'll see to update also the version in OTA cluster

mospaeda, 2022-10-21:
Thanks
I will check /confirm with codyhackw which cluster is used
This is related to https://github.com/zigpy/zha-device-handlers/issues/1844

nerthazrim, 2023-04-05:
Hi,

Same thing here with a Zlinky received with firmware 4000-0013.
Should I write the attribute "OTA current_file_version" to 13? Is it mandatory to be able to update OTA when the next firmware is available?

Thanks!

nerthazrim, 2023-04-16:
Hi @fairecasoimeme, hope you won't mind the ping. Just making sure you've seen the questions, please  :)

Thread 116 (2022-10-20):

Increase default reporting frequency for LiXee ZLinky_TIC Smartenergysummation

MayeulC, 2022-10-20:
Default reporting frequency is very slow. It's possible to increase it via ZHA Toolkit though:

Dev tools -> Service -> yaml mode

```yaml
service: zha_toolkit.conf_report
data:
  ieee: sensor.lixee_zlinky_tic_electricalmeasurement
  cluster: 1794
  attribute: 0
  max_interval: 200
  reportable_change: 1
  min_interval: 40
```

This asks an arbitrary min reporting period of 40s, max of 200s, and min change of 1Wh. It would be nice to have it by default in the FW.

(_Originally posted in https://github.com/fairecasoimeme/Zlinky_TIC/issues/18#issuecomment-1285215566_)

The difference is pretty clear:

fairecasoimeme, 2022-10-20:
There aren't no default reporting in ZLinky at the begining. That is the coordinator accros a plugin/box which send config report to the ZLinky.

I think for this value It's ZHA which send a default config report with a low frequency

MayeulC, 2022-10-20:
Thank you for clarifying. It would probably be a good idea to set one; that's not an issue I've had with any other device, including connected plugs, etc.

On the other hand, it's OK to leave it like that, as long as it's documented, IMO.
It's quite hard to find good documentation on how to use the ZLinky (with zha). It might be worth opening this github repo's wiki, hosting a wiki somewhere else, or making a github pages-based website.

Ozaroth, 2022-10-27:
Hi,

It doesn't work for me, any idea why ?

my log:

`event_data {'zha_toolkit_version': 'v0.8.20', 'zigpy_version': '0.51.3', 'zigpy_rf_version': '0.34.2', 'ieee_org': 'sensor.lixee_zlinky_smartenergysummation', 'ieee': '00:15:8d:00:05:00:6f:fe', 'command': 'conf_report', 'command_data': None, 'start_time': '2022-10-27T20:29:42.613552+00:00', 'errors': [], 'params': {'cluster_id': 1794, 'attr_id': 0, 'min_interval': 40, 'max_interval': 59, 'reportable_change': 1, 'dir': 0, 'tries': 1, 'expect_reply': True, 'args': [], 'read_before_write': True, 'read_after_write': True}, 'success': False, 'result_conf': Configure_Reporting_rsp(status_records=[ConfigureReportingResponseRecord(status=<Status.INVALID_VALUE: 135>, direction=<ReportingDirection.SendReports: 0>, attrid=0)])}`

Thanks !

MayeulC, 2022-10-28:
@Ozaroth did you change some options? I see "expect_reply", "read_before_write", "max_interval" among others, that I didn't specify when doing this.

Ozaroth, 2022-10-28:
@MayeulC only the max_interval.

service: zha_toolkit.conf_report
data:
   ieee: 00:15:8d:00:05:00:6f:fe
  cluster: 1794
  attribute: 0
  max_interval: 59
  reportable_change: 1
  min_interval: 40
  event_done: zha_done

and the result :

`event_type: zha_done
data:
  zha_toolkit_version: v0.8.20
  zigpy_version: 0.51.3
  zigpy_rf_version: 0.34.2
  ieee_org:
    - 254
    - 111
    - 0
    - 5
    - 0
    - 141
    - 21
    - 0
  ieee: 00:15:8d:00:05:00:6f:fe
  command: conf_report
  command_data: null
  start_time: "2022-10-28T15:15:27.528736+00:00"
  errors: []
  params:
    cluster_id: 1794
    attr_id: 0
    min_interval: 40
    max_interval: 59
    reportable_change: 1
    dir: 0
    tries: 1
    expect_reply: true
    args: []
    event_done: zha_done
    read_before_write: true
    read_after_write: true
  success: false
  result_conf:
    - - status: 135
        direction: 0
        attrid: 0
origin: LOCAL
time_fired: "2022-10-28T15:15:28.354774+00:00"
context:
  id: 01GGFJK3Z263W44HA9TM772QDY
  parent_id: null
  user_id: null
`

fairecasoimeme, 2022-10-28:
Hi, max_interval must be greater than 60 for reporting
`#define MAX_REPORT_INTERVAL       0x3d`

Ozaroth, 2022-10-28:
Thank you @fairecasoimeme it's working !

bachy, 2022-11-26:
Hi,
I'm trying to increase the active_power report frequence like you did (for now reporting every 30min, unusable)

the conf_report seems to works, but active_power does not come more frequently
```yaml
service: zha_toolkit.conf_report
data:
  ieee: 00:15:8d:00:05:ce:77:e0
  cluster: 2820
  attribute: 1291
  min_interval: 10
  max_interval: 61
  reportable_change: 1
  event_done: zha_done
```

```log
DEBUG (MainThread) [custom_components.zha_toolkit] event_data {
'zha_toolkit_version': 'v0.8.26',
'zigpy_version': '0.51.5',
'zigpy_rf_version': '0.19.0',
'ieee_org': 00:15:8d:00:05:ce:77:e0,
'ieee': '00:15:8d:00:05:ce:77:e0',
'command': 'conf_report',
'command_data': None,
'start_time': '2022-11-26T16:32:41.630726+00:00',
'errors': [],
'params': {
  'cluster_id': 2820,
  'attr_id': 1291,
  'min_interval': 10,
  'max_interval': 61,
  'reportable_change': 1,
  'dir': 0,
  'tries': 1,
  'expect_reply': True,
  'args': [],
  'event_done': 'zha_done',
  'read_before_write': True,
  'read_after_write': True
},
'success': True,
'result_conf': Configure_Reporting_rsp(status_records=[ConfigureReportingResponseRecord(status=<Status.SUCCESS: 0>)])}

```

```yaml
service: zha_toolkit.conf_report_read
data:
  ieee: 00:15:8d:00:05:ce:77:e0
  cluster: 2820
  attribute: 1291
```

```
DEBUG (MainThread) [custom_components.zha_toolkit] event_data {
'zha_toolkit_version': 'v0.8.26',
'zigpy_version': '0.51.5',
'zigpy_rf_version': '0.19.0',
'ieee_org': 00:15:8d:00:05:ce:77:e0,
'ieee': '00:15:8d:00:05:ce:77:e0',
'command': 'conf_report_read',
'command_data': None,
'start_time': '2022-11-26T16:36:26.184368+00:00',
'errors': [],
'params': {
  'cluster_id': 2820,
  'attr_id': 1291,
  'dir': 0, 'tries': 1,
  'expect_reply': True,
  'args': [],
  'read_before_write': True,
  'read_after_write': True
},
'success': True,
'result_conf': [
 {
  'cluster': 'Electrical Measurement',
  'cluster_id': '0x0B04',
  'ep': 1,
  'attr_id': '0x050B',
  'direction': <ReportingDirection.SendReports: 0>,
  'status': <Status.SUCCESS: 0>,
  'type': '0x29',
  'min_interval': (10,),
  'max_interval': (61,),
  'attr': 'active_power'}
]}

any idea ?

misterbenj34, 2023-01-03:
Thanks @MayeulC , you're a life saver !
My ZLinky was working fine yesterday, but stopped reporting the "Summation Delivered" suddenly. Only the Apparent Power was reported every 40 seconds.
I used your trick with ZHA toolkit, and it restored the values

I had to migrate to ZHA yesterday, because my integration in deCONZ was also failing after 1 day..

nerthazrim, 2023-04-28:
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

Hi @bachy, did you find an answer to your questions, by any chance?
I'm trying to do the same: increase the recording frequency of active_power by ZHA. Any help/guide would be appreciated :)

Thanks in advance

bachy, 2023-04-29:
Hi @nerthazrim

No i never get to make it work.
I gave up on zlinky-tic.
I swictched to zigbee2mqtt, and now instead of zlinky i'm using multiple custom ptvo + pzem device which are working smoothly

MayeulC, 2023-04-29:
That cluster (2820/1291 aka b04/50b) sounds a bit weird:
> Point n de la courbe de charge active soutirée

And it's only available in standard mode. Are you sure it's the right one? I suggest you try to read a clister from the UI on the device page to confirm it returns a value, and the right one, before configuring the reporting period.

Maybe you are looking for `IINST | 0x0B04 | 0x0508` and you just mistyped/misread 8 as B?, Or `PAPP | 0x0B04 | 0x050F`?

Of course, another option is to differentiate the energy, as E=P*t  -> P=E/t (dE/dt, the derivative, is more technically correct). E in joules (=1 W.s), t in seconds, P in watts.

nerthazrim, 2023-04-30:
> Thank you @fairecasoimeme it's working !

Hi @Ozaroth, would you mind sharing the conf snippet you're using, please? :)

Ozaroth, 2023-04-30:
Hi @nerthazrim you want my conf for active_power ?
If yes my config for active_power is the same as you and not working for me too, the value is reported every 30 minutes.
but for current_summ_delivered it's working perfectly.

nerthazrim, 2023-05-02:
> Hi @nerthazrim you want my conf for active_power ? If yes my config for active_power is the same as you and not working for me too, the value is reported every 30 minutes. but for current_summ_delivered it's working perfectly.
Damn it :(
I thought you managed to find how to increase the frequency :(

I'll open a ticket with in the ZHA project. I guess that's the way to go.

nerthazrim, 2023-05-02:
Well, actually, quick one for you @fairecasoimeme: we can read here (on a similar issue)
https://github.com/home-assistant/core/issues/88166#issuecomment-1434857328

> We don't pull date from the device, the device push data upon changes, we don't control the update rate.

Would it be possible that the ZLinky does not advertise properly a change in the "active_power" value to ZHA? Which then does not record a new value?

MayeulC, 2023-05-03:
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

The device pushes updates, but the coordinator can configure how often, which is what `conf_report` does. You can specify a minimum time in between updates, as well as a maximum time, and a change after which an update should be sent, for each property (though I think there is a maximum, perhaps about 10, properties that can be reported this way, probably dependent on the device.

iamdabe, 2024-12-03:
This is still an outstanding issue I feel. I've just setup my zlinky and was disappointed at the 30min refresh rate of **sensor.lixee_zlinky_tic_power**  which makes it unusable for me. It's strange when **sensor.lixee_zlinky_tic_apparent_power** is updated near-real time but it reports in VA and without a power factor it's also useless for calculating the real time watts.

For now (as I have sent back my ecojoko) I have setup a template trigger sensor which takes the **lixee_zlinky_tic_summation_delivered** and calculates the watts based on the time differential as it gives me something usable for now as it's a TEMPO RED day today and the children are due home soon!

The template sensor code:

`#LiXee ZLinky derived current power consumption
  - trigger:
    - platform: state
      entity_id: sensor.lixee_zlinky_tic_summation_delivered
    sensor:
      - name: "LiXee ZLinky Current Power Consumption"
        unique_id: "lixee_zlinky_current_power_consumption"
        device_class: power
        unit_of_measurement: W
        state_class: measurement
        state: >
          {% set prev_value = trigger.from_state.state | float(0) %}
          {% set curr_value = trigger.to_state.state | float(0) %}
          {% set prev_time = as_datetime(trigger.from_state.last_changed) %}
          {% set curr_time = as_datetime(trigger.to_state.last_changed) %}
  
          {% if prev_time and curr_time and curr_value > prev_value %}
            {% set time_diff = (curr_time - prev_time).total_seconds() %}
            {% set energy_diff = curr_value - prev_value %}
            {% if time_diff > 0 %}
              {% set result = ((energy_diff * 3600) / time_diff) * 1000 %}
              {{ result | round(0) }}       
            {% else %}
              0
            {% endif %}
          {% else %}
            0
          {% endif %}
        availability: >
          {{ trigger.from_state is not none and
             trigger.to_state is not none and
             trigger.to_state.state | is_number and
             trigger.from_state.state | is_number }}
`

nerthazrim, 2024-12-03:
My understanding was that it was the Linky that was updating the value no more than once every 30min, not a Zlinky's limitation.
Did I get this wrong?

iamdabe, 2024-12-03:
If that is the case then this is bizarre as ecojoko provides the value in watts and quite accurate it was. they must have no more info than ZLinky?

fairecasoimeme, 2024-12-04:
Ecojoko have 2 solutions :
* with Linky sensor. only apparent power (VA) from Linky and active power (W) calculated from ecojoko
* with circuit breaker sensor. Approximative active power (W)

The Linky provides only apparent power (VA)

benriou, 2025-03-18:
Hello

I'm surprised of your concerns, because my linky with lixee tic reports an increment for *every* single watt consumed.

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

Cannot you deduct the consumed power from this metric ?

iamdabe, 2025-03-18:
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

Yes, this is exactly what I did in the end (see my template sensor code above). It's proven to be pretty accurate over the last couple of months so I am happy!

Hopefully it helps others who come across this thread researching the same problem. Just takes a little manual work but that's ok!

Thread 117 (2022-10-20):

Reported CCASN doesn't change for 15 minutes

renaiku, 2022-10-20:
Hello,

Firmware V9 no router

Using Home Assitant + Zigbee2mqtt with the following configuration:
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
The measurement_poll_chunk is "0" by default not "1", I never changed it.

The used converter has:
```
    {cluster: clustersDef._0x0B04, att: 'activePower', reportable: true, onlyProducer: false, linkyPhase: linkyPhaseDef.all, linkyMode: linkyModeDef.standard, exposes: exposes.numeric('CCASN', ea.STATE).withUnit('W').withProperty('active_power').withDescription('Current point of the active load curve drawn')},
```

I get the following values in the logger every 60-61 seconds:
```
2022-10-20 12:54:14 Received Zigbee message from 'Linky', type 'attributeReport', cluster 'haElectricalMeasurement', data '{"activePower":384}' from endpoint 1 with groupID 0
2022-10-20 12:55:16 Received Zigbee message from 'Linky', type 'attributeReport', cluster 'haElectricalMeasurement', data '{"activePower":384}' from endpoint 1 with groupID 0
2022-10-20 12:56:17 Received Zigbee message from 'Linky', type 'attributeReport', cluster 'haElectricalMeasurement', data '{"activePower":384}' from endpoint 1 with groupID 0

...

2022-10-20 13:04:26 Received Zigbee message from 'Linky', type 'attributeReport', cluster 'haElectricalMeasurement', data '{"activePower":532}' from endpoint 1 with groupID 0
```
But the reported value is not changing. CCASN only changes every 15 minutes:
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

The CCASN value is updated only every 15 minutes. I'm looking to get my live consumption at least every minutes (I think zlinky is capable every 10s ?). Am I having a wrong configuration ? Or is it a converter issue ?

CladStriffe, 2022-10-26:
Same here, but it doesn’t seem to be a ZLinky limitation. Instead it seems to be an average value only provided every 15min by the Linky terminal.
you should instead have a look at SINSTS to have a value in almost real-time. It is the apparent power in VA, so the real power used in your house as seen by the provider.

renaiku, 2022-10-28:
@CladStriffe J'ai jeté un oeuil à la documentation du linky dans le pdf de ENEDIS, y'a rien qui indique que CCASN est une valeur changeante toute les 15 minutes. Donc tant qu'on a pas mesuré, je me méfie ^^ !

Si SINSTS est en temps réel mais en VA, comment je le convertis en puissance active en W ?

CladStriffe, 2022-10-28:
> @CladStriffe J'ai jeté un oeuil à la documentation du linky dans le pdf de ENEDIS, y'a rien qui indique que CCASN est une valeur changeante toute les 15 minutes. Donc tant qu'on a pas mesuré, je me méfie ^^ !

Tu as raison, ils ne parlent pas de 15 minutes.
Mais CCASN s'appelle dans la doc Enedis : "Point n de la courbe de charge active soutirée".
Et la définition par Enedis de la courbe de charge : "Ensemble de valeurs **moyennes** horodatées de la puissance active ou réactive injectée ou soutirée, sur des périodes d’intégration consécutives et de même durée."
C'est donc bien une valeur moyenne sur une durée qui peut (si j'ai bien compris) a priori varier selon le paramétrage demandé au Linky par un fournisseur, mais d'au moins 10 minutes.

Une puissance c'est une tension (V) multipliée par un courant (A). Donc en terme d'unité, VA c'est équivalent à W.
Pour un usage domestique, la puissance apparente est à quelques % près égale à la puissance active.

renaiku, 2022-10-28:
> Et la définition par Enedis de la courbe de charge : "Ensemble de valeurs moyennes horodatées de la puissance active ou réactive injectée ou soutirée, sur des périodes d’intégration consécutives et de même durée."

Punaise bien vu !

Ok top merci ben je vais switcher sur SINSTS !

Closed 2022-10-29.

Thread 118 (2022-10-22):

Lixee installation firmware no route

lendormi054, 2022-10-22:
Subissant régulièrement des déconnexion de mon lixee, je voudrais essayer avec la version no_route. Mais je n'ai aucune idée de comment faire!!

Je suis sous home assistant et lixee est intégré via mqtt.
Un pti tuto de noob serait le bienvenue ;-)

lecourtb, 2022-10-22:
See https://forum.hacf.fr/t/zha-ota-update-firmware/9693/4

lendormi054, 2022-10-22:
@lecourtb
Je peux utiliser
`zha:
  zigpy_config:
    ota:
      otau_directory: /config/zigpy_ota`
alors que mon appareil est sous z2m ????

MayeulC, 2022-10-24:
@lendormi054 non, il faut que tu suives la procédure ici: https://www.zigbee2mqtt.io/guide/usage/ota_updates.html#local-ota-index-and-firmware-files

Tu crées un fichier json index local pour les ota:

```json
[
    {
        "url": "fichier.ota"
    }
]
```

Et tu indiques sa localisation dans le fichier de configuration.yaml:

```yaml
ota:
    zigbee_ota_override_index_location: my_index.json
```
(tous les chemins sont relatifs au dossier de `configuration.yaml`)

Enfin, il faut [envoyer une commande pour lancer l'OTA](https://www.zigbee2mqtt.io/guide/usage/ota_updates.html#update-to-latest-firmware). Chemin: `zigbee2mqtt/bridge/request/device/ota_update/update` donnée: `{"id": "deviceID"}` avec la MAC ou le nom de l'appareil.

Bonne chance (je n'utilise pas z2m, j'ai juste essayé d'expliciter un peu plus la documentation dont j'ai fourni les liens).

lendormi054, 2022-10-25:
@MayeulC
La localisation du ficher dans configuration.yaml (qui est celui dans le répertoire zigbee2mqtt, c'est bon. Le ficher my_index.json, ca semble bon.
Je coince pour la suite. Pas de Maj trouvée et je ne sais pas ou verifier si tout est bon....
Mais ca progresse.... enfin je crois :-)

Tolriq, 2022-10-25:
Y'a un trick :)

https://github.com/fairecasoimeme/Zlinky_TIC/issues/89#issuecomment-1236422701

Par default ca utilise pas la conf mais un fichier a part, faut bien suivre le commentaire ^^

lendormi054, 2022-10-25:
@Tolriq
Les étapes 3-4-5-6 du post https://github.com/fairecasoimeme/Zlinky_TIC/issues/89#issuecomment-1236422701, je vois comment faire.
En revanche l'étape 1 me pose probleme. J ai pas de commande docker (du moins dans le terminal...)

Tolriq, 2022-10-25:
Tu peut prendre le fichier directement à la source :
https://github.com/Koenkk/zigbee-herdsman-converters/blob/master/devices/lixee.js

lendormi054, 2022-10-25:
@Tolriq
Etape 1 ok. (merci pour le lien du fichier lixee.js)

Etape 2 : probleme :

`[16:52:44] INFO: Preparing to start...
[16:52:45] INFO: Socat not enabled
[16:52:47] INFO: Starting Zigbee2MQTT...
node:internal/modules/cjs/loader:936
  throw err;
  ^
Error: Cannot find module '../converters/fromZigbee'
Require stack:
- /app/dist/util/utils.js
- /app/dist/util/settings.js
- /app/index.js
    at Function.Module._resolveFilename (node:internal/modules/cjs/loader:933:15)
    at Function.Module._load (node:internal/modules/cjs/loader:778:27)
    at Module.require (node:internal/modules/cjs/loader:1005:19)
    at require (node:internal/modules/cjs/helpers:102:18)
    at /app/dist/util/externally-loaded.js:8:12
    at Script.runInContext (node:vm:139:12)
    at Script.runInNewContext (node:vm:144:17)
    at Object.runInNewContext (node:vm:298:38)
    at loadModuleFromText (/app/lib/util/utils.ts:148:8)
    at loadModuleFromFile (/app/lib/util/utils.ts:155:12)`

lendormi054, 2022-10-25:
Alors, avec ton fichier, j ai reussi à relancer z2m (j ai juste modifié le firmware (je veux  ZLinky_router_v9.0_no_route et pas le v5).

Il me dit qu'il y a une MAJ !!!! (sans etre certain que ce soit la bonne, mais "update in progress".
Et....
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

Peut etre que c'est du au fait que ce soit la meme version ?

MayeulC, 2022-10-25:
@lendormi054 tu as mis `"force": true` dans le json?

Merci @Tolriq pour les précisions (et au passage merci pour Yatse, que j'ai énormément utilisé en ~2009-2012 :P)

Tolriq, 2022-10-25:
Faut tester Symfonium alors ;)

lendormi054, 2022-10-25:
@MayeulC Oui oui, il y a l'option.
La question est bete mais dans le ficher my_index.json, il faut les [] ou juste les {}
J ai mis [{...}] pour info

MayeulC, 2022-10-26:
@lendormi054 il faut les deux, c'est une liste `[...]` de valeurs `{...}` qui peuvent correspondre à différents fabricants, etc. Je suis désolé, je ne vois pas mieux, ce serait peut-être intéressant de s'intéresser aux logs, et/ou de poser la question à la communauté z2m.

@Tolriq ok, lol, je testerai, merci (mais la musique ce n'est pas trop mon truc, même si tu as Finamp et Gelli en concurrents sur F-Droid pour Jellyfin). Enfin je ferai tester plutôt, je suis 100% FLOSS :P

Tolriq, 2022-10-26:
C'est pas le bon endroit pour en parler mais c'est pas vraiment des concurrents, ils sont open source et joue de la musique après on joue pas vraiment dans la même catégorie. Mais vu que c'est une app récente, si elle te plait je suis pas contre un petit commentaire Play Store.

lendormi054, 2022-10-26:
@MayeulC C'est déjà très bien. Je suis parti de rien ne marche à la mise à jour manuelle est disponible. Faudrait que j'essaye avec un firmware superieur mais ca ce sera pour un autre sujet. Merci à tous pour le coup de main et de m'avoir permit de progresser :-)

lendormi054, 2022-10-26:
L'installation manuelle du firmware lixee est disponible sous z2m

Closed 2022-10-26.

Thread 119 (2022-10-22):

Error zha_toolkit attr_read since firmware v9.0 installed with no route

lecourtb, 2022-10-22:
Hello, since installation of firmware v9.0, I got timeout errors when invoking attr_read on device.
The attributes are well read, but there is timeout errors on the request.

`2022-10-22 12:01:25.388 ERROR (MainThread) [homeassistant.core] Error executing service: <ServiceCall zha_toolkit.execute (c:01GFYKBGMVH88ZJXKFZSXSS8FH): command=attr_read, ieee=00:15:8d:00:06:a4:01:1b, cluster=2820, attribute=2568, state_id=sensor.zlinky_tic_metering_AP3, allow_create=False>`

Any idea ?

lecourtb, 2022-10-23:
Ok, I updated HA 2022.8.5 and all work well as before

Closed 2022-10-23.

Thread 122 (2022-10-27):

some sensors are lost since v10 update

Albirew, 2022-10-27:
It looks like update to v10 (Firmware: 0x0000000a) made me loose a whole lot of sensors:
- LiXee ZLinky_TIC Electricalmeasurement (-32 768 W)
- LiXee ZLinky_TIC Electricalmeasurementapparentpower (65 535 VA)
- LiXee ZLinky_TIC Electricalmeasurementpowerfactor (unknown)
- lixee_zlinky_tic_infos_PTEC
- and more...

among these, what I use the most are Electricalmeasurementapparentpower and PTEC
PTEC automation is the following:
```yml
  - service: zha_toolkit.execute
    data:
      command: attr_read
      ieee: REDACTED
      cluster: 1794
      attribute: 32
      state_id: sensor.lixee_zlinky_tic_infos_PTEC
```
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

bdien, 2022-10-27:
Same issue with V10, SINSTS 65535 and SMAXN -32768.

Using zigbee2mqtt 1.28.0, was working before OTA.
Tried to remove the ZLinky and rejoin, without any improvement.

nbufnoir, 2022-10-28:
Same here,  SINSTS at 65535 and not updating since I went to v10

CladStriffe, 2022-10-28:
This issue has already been raised (see #89 )
According to the developer, in V10 the way SINSTS and other values are managed has changed to cover both single-phase and tri-phase. This requires an update of zigbee2mqtt (no date provided).

bdien, 2022-10-28:
I've modified the file from zigbee2mqtt (Latest rev 5011671) to make SINSTS and SMAXN work (SMAXN-1 is more difficult, being a ZLinky special attibute).
https://gist.github.com/bdien/260fea4b4f82295a2613f85184ee332f

To use it, put the content as `lixee.js`, next to `configuration.yaml`.
And add the following lines to `configuration.yaml`:
~~~
external_converters:
  - lixee.js
~~~

Only tested with the standard mode, single phase, zigbee2mqtt 1.28.0.

fairecasoimeme, 2022-10-28:
I'll try to fix this issue with a new firmware version, to be compatible with plugins.

pipiche38, 2022-10-29:
same issue of Domoticz

navycrow, 2022-10-30:
same issue. :(

fairecasoimeme, 2022-10-31:
You can try the new version to fix it
https://github.com/fairecasoimeme/Zlinky_TIC/releases/tag/v11.0

CladStriffe, 2022-10-31:
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

Same here

fairecasoimeme, 2022-10-31:
Sorry I'm just reupload

CladStriffe, 2022-10-31:
Hello, thank you for the update.
However I cannot update to v11 using OTA in Z2m.
I have an error "image type mismatch".
It is maybe related to the fact that z2m is trying to use the router_limited version, even if it should use the regular one (I never manually updated the ZLinky to use a no-router version).
Am I missing something ?

bdien, 2022-10-31:
Managed to update to 4000-0011 with Z2M, SINSTS and SMAXN are working (SMAXN-1 seems too low (410VA), will check tomorrow).

For Z2M update, there is indeed an issue, Z2M will select the first .ota file from the release. I "fixed" it by modifying the file `node_modules/zigbee-herdsman-converters/lib/ota/lixee.js` in my docker image within the following section:
~~~js

    // Find the most recent OTA file available
    for (const e of releasesLIST.sort((a, b) => a.published_at - a.published_at)) {
        if (e.assets) {
            const targetObj = e.assets
                .find((a) => a.name.endsWith('router_v11.ota')); // <-- Patched here (Ugly)
            if (targetObj && targetObj.browser_download_url) {
                firmURL = targetObj;
                break;
            }
        }
    }
~~~

fairecasoimeme, 2022-10-31:
I'll try to rename to put the "legacy" first

plouf34, 2022-11-01:
Hello
Is it possible to upgrade from v10 router OTA to v11 limited OTA via zigbee2mqtt OTA update?

Albirew, 2022-11-01:
Thanks, I got back almost all semsors
What still doesn't work are:
- those that never worked in first place (Electricalmeasurement and Electricalmeasurementpowerfactor)
- the one I'd like it to work (PTEC witch shows current tariff, if someone with sensor knowledge can help)

Albirew, 2022-11-01:
Ah, i switched from "historic" to "standard" recently, but kept the HP/HC tariff.
How do you keep watch of currently applied tariff in standard mode then?

Albirew, 2022-11-01:
Thanks for pointing me to the right direction: cluster ff66 attr 200.
I edited automation like this to keep track of history:
```yml
  - service: zha_toolkit.execute
    data:
      command: attr_read
      ieee: REDACTED
      cluster: 65382
      attribute: 512
      state_id: sensor.lixee_zlinky_tic_infos_PTEC
```

I will close this issue since all the sensors i use are back.
The 2 remaining sensors were not working from the start so i don't miss them (^_^; )

renaiku, 2022-11-10:
> I've modified the file from zigbee2mqtt (Latest rev 5011671) to make SINSTS and SMAXN work (SMAXN-1 is more difficult, being a ZLinky special attibute). https://gist.github.com/bdien/260fea4b4f82295a2613f85184ee332f

@bdien is it PRed in z2m ?
In zlinky OTA V11 & z2m 1.28.2, my SINSTS is stuck at 438VA.

bdien, 2022-11-10:
> @bdien is it PRed in z2m ? In zlinky OTA V11 & z2m 1.28.2, my SINSTS is stuck at 438VA.

Not PRed as it is working on my side (Z2M 1.28.2 without any modification, ZLinky 4000-0011 (V11), Standard Mode)

Thread 124 (2022-10-29):

Demande feature: RE - Pairing automatique

renaiku, 2022-10-29:
Bonjour,

J'ai un cas particulier à vous soumettre.

Entre mon coordinateur et mon zlinky_tic il y a une cage d'ascenseur.
l'attribut linkquality est en général de mauvais (60) à plutot bon (+200).
Cela m'arrive en firmware "no route" 0.9 (cela m'arrivait aussi en firmware normal en 0.5), je me retrouve avec parfois le zlinky_tic qui est en "hors ligne" ou "time out" sur z2m.

Il suffit re pair le device avec z2m pour que tout revienne dans l'ordre.

Est il possible de rajouter la fonctionnalitée suivante: avec un ping (ou autre), le zlinkty_tic detecte que le coordinateur ne lui répond plus, et qu'il passe automatiquement en mode pairing ?

CladStriffe, 2022-10-29:
Quand tu vas sur le zlinky pour relancer l'appairage dans ces cas là, est-ce que la led bleue est allumée ?
Avec le mien je n'ai qu'un linkquality d'environ 30 et je n'ai jamais eu de déconnexion, enfin que je sache.

Donc il faudrait d'abord identifier si c'est bien un soucis de connexion, ou bien d'alimentation du Zlinky par le Linky (ce qu'est en train d'analyser le développeur, car ça a l'air variable selon le fabricant du Linky)

renaiku, 2022-10-29:
J'en ai profité pour passer le pollingbde zéro (par défaut dans z2m) à 10, et l'interval de 10s à 60s.

Si j'ai encore des soucis, je ferais bien attention à la couleur de la led et à la méthodologie.

renaiku, 2022-10-30:
@CladStriffe Je suis apssé en V10 hier dans la matinée (donc je suppose que même si j'étais en no route, je suis deretour sur le firware de base).

Le zlinky s'est déconnecté peux après mais j'ai pas eu le temps d'aller le reboot avant maintenant.

**La LED bleue est bien allumée**, donc ca n'a pas l'air d'être un problème d'alimentation.

renaiku, 2022-11-10:
Je suis passé en v11.

Ce matin encore le zlinky est déconnecté du réseau zigbee. Je mets z2m en mode appairage, je vais voir le device. La led est bleue, elle ne clignote pas. Je reste appuyé sur le bouton 10seconde. L'appareil se re appaire bien. Jusqu'à la prochaine fois.

renaiku, 2022-11-10:
Le zlinky s'est encore déconnecté. La led était bleue.

Je l'ai débranché du compteur et rebranché (sans activer le pairing de z2m) et le zlinky s'est instantanément remis en ligne dans z2m.

Le linky est un modèle Sagemcom

CladStriffe, 2022-11-10:
Il faudrait un retour du développeur alors.
De toute façon, chez moi même si je débranche et rebranche le zlinky je n'ai pas besoin d'appairer de nouveau, Z2M le reconnaît.
Par ailleurs, passer le zlinky en appairage automatique comme tu suggères ne résoudrait pas vraiment ton problème, car il faut aussi relancer l'appairage dans Z2M.

CladStriffe, 2022-11-10:
Je viens de voir la question [129](https://github.com/fairecasoimeme/Zlinky_TIC/issues/129)
Est-ce que ton Zlinky se connecte directement à ta clé Zigbee ? Ou est-ce qu'il se connecte à un appareil relai qui pourrait se déconnecter parfois ?

renaiku, 2022-11-10:
Pour le moment il a l'air connecté à la Philips hue la plus proche de lui, et elle ne passe jamais offline.
Je pourrais essayer de réappairer uniquement sur le coordinateur.

Les valeurs ne changent plus depuis que je suis passé en V11, je reçois plus rien dans les logs de z2m sur le zlinky. La led est bleue solide.

Dès que j'ai un peu de temps j'essaye de le débrancher quelques heures, et je repair direct sur le coordinateur.

fairecasoimeme, 2022-11-15:
En effet, après une mise à jour sur Z2M, je ne sais pas pourquoi encore, mais il faut supprimer et re appairer quand les données ne remontent plus.

Thread 130 (2022-11-10):

Plus de remontées de valeurs et erreurs deconz suite au passage vers la V11 en OTA

maxime-hallard, 2022-11-10:
Bonjour,

Je viens de recevoir la clé zlinky.

Environnement:

HA - Z2M - Deconz Conbee2

Après l'avoir branché et appairé, j'ai commencé à recevoir des valeurs.
J'ai fait la mise à jour proposée en OTA, le process semble s'être déroulé correctement.

Suite à cette maj, les valeurs remontées sont figées, et des redémarrages successifs (Zlinky, Z2M, Conbee 2, HA, Raspberry) n'ont rien changé.
Je suis sur les dernières versions pour tous les composants, j'ai pu constater dans les payloads reçus que current_summ_delivered ne s'incrémente plus.

J'a cette erreur qui remontent dans les logs de Z2M lors de ce qui semble être une configuration du reporting pour "seMetering":

Debug 2022-11-10 14:09:58Received MQTT message on 'zigbee2mqtt/bridge/request/device/configure_reporting' with data '{"attribute":"currentSummDelivered","cluster":"seMetering","id":"zlinky/1","maximum_report_interval":900,"minimum_report_interval":60,"reportable_change":100,"transaction":"c30p6-1"}'

Error 2022-11-10 14:09:59Request 'zigbee2mqtt/bridge/request/device/configure_reporting' failed with error: 'Bind 0x00158d0005be9a8a/1 seMetering from '0x00212effff081e75/1' failed (Error: status: 140)'
Debug 2022-11-10 14:09:59Error: Bind 0x00158d0005be9a8a/1 seMetering from '0x00212effff081e75/1' failed (Error: status: 140) at DeconzAdapter.bind (/app/node_modules/zigbee-herdsman/src/adapter/deconz/adapter/deconzAdapter.ts:768:19) at Endpoint.bind (/app/node_modules/zigbee-herdsman/src/controller/model/endpoint.ts:567:13) at Bridge.deviceConfigureReporting (/app/lib/extension/bridge.ts:444:9) at Bridge.onMQTTMessage (/app/lib/extension/bridge.ts:123:34)

Info 2022-11-10 14:09:59MQTT publish: topic 'zigbee2mqtt/bridge/response/device/configure_reporting', payload '{"data":{},"error":"Bind 0x00158d0005be9a8a/1 seMetering from '0x00212effff081e75/1' failed (Error: status: 140)","status":"error","transaction":"c30p6-1"}'

J'ai regardé un peu ce que pouvait vouloir dire ce code erreur 140 remonté par Deconz mais je n'ai rien remonté de probant.

Avez-vous une idée de ce qui peut causer cette erreur, et comment y remédier?

Merci :)

maxime-hallard, 2022-11-10:
J'ai tenté un réappairage, cela a suffit, mes données remontent à nouveau

Closed 2022-11-10.

Thread 132 (2022-11-13):

Production PV

chryss44, 2022-11-13:
Bonjour,
Je suis l'heureux possesseur d'un ZLinky_TIC et je suis en mode production avec un CRAE mais je n'ai aucune info qui remonte.
J'utilise Zigbee2MQTT et j'ai fait le paramètrage pour être en mode Standard afin de voir remonter la production mais la valeurs EAIT reste à zéro alors que j'ai quelque-chose comme 1700Kwh sur le compteur en injecté.
Pareil, j'ai aussi un Wifinfo et ca m'a permis de constater que lorsque je produit et injecte tout en couvrant ma consommation, le wifinfo affiche bien 0 en consommation (ce qui est normal car je ne consomme rien) mais que côté TIC il ne descend pas à zéro mais reste à la dernière valeur (bizarre).
Donc quand j'ai 500W d'instantané, j'ai bien le TIC et le Wifinfo qui remonte la valeur et dès que le soleil donne, le Wifinfo tombe à 0 alors que le TIC reste bloqué sur la dernière valeur à 500. Du coup quand le soleil se cache et que j'ai par exemple un instantané qui remonte a 750W, le Wifinfo remonte bien de 0 à 750W alors que le TIC passe de 500W à 750W.
C'est un pli peu embêtant et pas très fiable du coup, est-ce que ca vient de mon paramètrage ?
En image Linky -->Wifinfo et Linky 2 -->TIC
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
Pour le paramétrage du TIC
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
Merci pour vos lumières

fairecasoimeme, 2022-11-15:
Pour voir si vous etes bien en mode production, il faut récupérer la valeur STGE ? cluster 0xff66 attribut 0x217 ?
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

chryss44, 2022-11-15:
J'ai ça :
2022-11-15 21:05:14Read result of 'liXeePrivate': {"statusRegister":{"type":"Buffer","data":[48,48,68,65,52,49,48,49]}}
Mais franchement, je sais pas lire les données.

chryss44, 2022-11-16:
Semble t'il oui
Date du firmware : 20221031
Version du firmware : 4000-0011

fairecasoimeme, 2022-11-16:
Je parlais de la version de Z2M, pas du firmware du zlinky.

chryss44, 2022-11-16:
Ah oui, pardon, lecture en diagonal....
La version de Z2M est [1.28.0](https://github.com/Koenkk/zigbee2mqtt/releases/tag/1.28.0) commit: [03ba647d].

fairecasoimeme, 2022-11-17:
il faut passer semble-t-il sur la dernière : [1.28.2](https://github.com/Koenkk/zigbee2mqtt/releases/tag/1.28.2)

c'est corrigé depuis la 1.28.1 : https://github.com/Koenkk/zigbee2mqtt/issues/13991

chryss44, 2022-11-19:
Salut, passage en 1.28.2 et je récupère bien 0 quand la production est en route.
Par contre, surprise hier soir, il a fallut que je débranche et rebranche le module car la led était éteinte et il ne répondait n'y n'envoyait rien. C'est reparti mais à surveiller.
Merci en tout cas, c'est nickel

fairecasoimeme, 2022-11-21:
Bonjour, lorsque vous n'avez plus de remontée, pouvez-vous faire une requête sous Z2M comme sur le screenshot :

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

chryss44, 2022-11-21:
The result
`Error 2022-11-21 20:43:34Publish 'set' 'read' to '0x00158d0005ce77f1' failed: 'Error: Read 0x00158d0005ce77f1/1 genBasic(["zclVersion"], {"sendWhen":"immediate","timeout":10000,"disableResponse":false,"disableRecovery":false,"disableDefaultResponse":true,"direction":0,"srcEndpoint":null,"reservedBits":0,"manufacturerCode":null,"transactionSequenceNumber":null,"writeUndiv":false}) failed (no response received)'`

technarf, 2022-11-21:
Alors de mon côté le résultat est très similaire, seul le motif du failed semble différent chez moi (le test est fait alors que le Zlinky est injoignable) :
`Error 2022-11-21 21:02:05Publish 'set' 'read' to 'Zlinky' failed: 'Error: Read 0x00158d0005ce76c6/1 genBasic(["zclVersion"], {"sendWhen":"immediate","timeout":10000,"disableResponse":false,"disableRecovery":false,"disableDefaultResponse":true,"direction":0,"srcEndpoint":null,"reservedBits":0,"manufacturerCode":null,"transactionSequenceNumber":null,"writeUndiv":false}) failed (Data request failed with error: 'MAC no ack' (233))'`

chryss44, 2022-11-21:
Après débranchement et re branchement, voila le retour
`Info 2022-11-21 21:08:07Read result of 'genBasic': {"zclVersion":3}`

fairecasoimeme, 2022-11-24:
Étrange, pouvez-vous passer sur la version 12 ?

chryss44, 2022-11-25:
Bonjour, depuis le passage en version 12, plus rien, j'ai ré appairé le TIC mais rien, il n'y a plus rien qui remonte.
C'est décidément très compliqué, que souhaitez-vous que je fasse, qu'est ce qui peut vous aider a diagnostiquer le problème ?

fairecasoimeme, 2022-11-25:
Bonjour,
C'est un problème qui apparait souvent sur Z2M et que je ne maitrise pas. La plupart du temps après une mise à jour du ZLinky sur Z2M, il faut supprimer avec le forçage de la suppression, puis re-appairer. vous pouvez aussi relancer la configuration.
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

Vous pouvez aussi tenter de relancer Z2M.

antoinelibert, 2022-11-25:
Bonjour,

Je confirme que le passage en V12 a nécessité de nouveau un reset complet du ZLinky comme indiqué au dessus. Bizarrement, certaines mise à jour nécessite un reset, et d'autre, pas du tout....

chryss44, 2022-11-25:
Désolé, mais ca ne marche pas chez moi, j'ai bien la trace d'appairage mais après plus rien `Accepting joining not in blocklist device '0x00158d0005ce77f1'`

antoinelibert, 2022-11-26:
Essayer de débrancher/rebrancher si ça coince juste après l'apparaillage (notamment si Z2M indique "unknown device").

chryss44, 2022-11-26:
J'ai tout essayé, le supprimer et le ré appairer, le débrancher et le rebrancher, rien n'y fait, il n'y a que 'appairage qui fonctionne et après plus rien. je consolide le log et je vous l'envoie mais c'est pas réussite. Il y a moyen de faire un retour arrière en V11.

WarC0zes, 2022-11-27:
> Bonjour,
>
> Je confirme que le passage en V12 a nécessité de nouveau un reset complet du ZLinky comme indiqué au dessus. Bizarrement, certaines mise à jour nécessite un reset, et d'autre, pas du tout....

Je confirme, même sous ZHA. Suivant les maj de firmware; il faut supprimer et ré-appairer le Zlinky pour que ca fonctionne bien. Ce que j'ai fait au passage de la v12.

chryss44, 2022-11-27:
Bonjour,,

Voci le log à partir du moment ou j'ai supprimé de Z2M, fait un reset du PIC puis une fois appairé débrancher puis rebrancher pour voir si il y avait un changement.
Je n'ai plus de message en provenance du TIC derrière la dernière ligne de log.
`info  2022-11-26 18:00:16: Removing device '0x00158d0005ce77f1' (block: false, force: true)
info  2022-11-26 18:00:16: MQTT publish: topic 'zigbee2mqtt/0x00158d0005ce77f1', payload ''
info  2022-11-26 18:00:16: Successfully removed device '0x00158d0005ce77f1' (block: false, force: true)
info  2022-11-26 18:00:16: MQTT publish: topic 'zigbee2mqtt/bridge/response/device/remove', payload '{"data":{"block":false,"force":true,"id":"0x00158d0005ce77f1"},"status":"ok","transaction":"6jd7g-9"}'
info  2022-11-26 18:00:35: Accepting joining not in blocklist device '0x00158d0005ce77f1'
info  2022-11-26 18:00:35: Device '0x00158d0005ce77f1' joined
info  2022-11-26 18:00:35: MQTT publish: topic 'zigbee2mqtt/bridge/event', payload '{"data":{"friendly_name":"0x00158d0005ce77f1","ieee_address":"0x00158d0005ce77f1"},"type":"device_joined"}'
info  2022-11-26 18:00:35: MQTT publish: topic 'zigbee2mqtt/bridge/log', payload '{"message":{"friendly_name":"0x00158d0005ce77f1"},"type":"device_connected"}'
info  2022-11-26 18:00:35: Starting interview of '0x00158d0005ce77f1'
info  2022-11-26 18:00:35: MQTT publish: topic 'zigbee2mqtt/bridge/event', payload '{"data":{"friendly_name":"0x00158d0005ce77f1","ieee_address":"0x00158d0005ce77f1","status":"started"},"type":"device_interview"}'
info  2022-11-26 18:00:35: MQTT publish: topic 'zigbee2mqtt/bridge/log', payload '{"message":"interview_started","meta":{"friendly_name":"0x00158d0005ce77f1"},"type":"pairing"}'
info  2022-11-26 18:00:35: Successfully interviewed '0x00158d0005ce77f1', device has successfully been paired
info  2022-11-26 18:00:35: Device '0x00158d0005ce77f1' is supported, identified as: LiXee Lixee ZLinky (ZLinky_TIC)
info  2022-11-26 18:00:36: MQTT publish: topic 'zigbee2mqtt/bridge/event', payload '{"data":{"definition":{"description":"Lixee ZLinky","exposes":[{"access":1,"description":"Serial Number","name":"ADCO","property":"meter_serial_number","type":"text"},{"access":1,"description":"Tarif option","name":"OPTARIF","property":"current_tarif","type":"text"},{"access":1,"description":"Subscribed intensity level","name":"ISOUSC","property":"available_power","type":"numeric","unit":"A"},{"access":1,"description":"BBRHCJB index","name":"BBRHCJB","property":"current_tier1_summ_delivered","type":"numeric","unit":"kWh"},{"access":1,"description":"BBRHPJB index","name":"BBRHPJB","property":"current_tier2_summ_delivered","type":"numeric","unit":"kWh"},{"access":1,"description":"BBRHCJW index","name":"BBRHCJW","property":"current_tier3_summ_delivered","type":"numeric","unit":"kWh"},{"access":1,"description":"BBRHPJW index","name":"BBRHPJW","property":"current_tier4_summ_delivered","type":"numeric","unit":"kWh"},{"access":1,"description":"BBRHCJR index","name":"BBRHCJR","property":"current_tier5_summ_delivered","type":"numeric","unit":"kWh"},{"access":1,"description":"BBRHPJR index","name":"BBRHPJR","property":"current_tier6_summ_delivered","type":"numeric","unit":"kWh"},{"access":1,"description":"RMS current","name":"IINST","property":"rms_current","type":"numeric","unit":"A"},{"access":1,"description":"RMS current peak","name":"IMAX","property":"rms_current_max","type":"numeric","unit":"A"},{"access":1,"description":"Apparent power","name":"PAPP","property":"apparent_power","type":"numeric","unit":"VA"},{"access":1,"description":"Current pricing period","name":"PTEC","property":"active_register_tier_delivered","type":"text"},{"access":1,"description":"Tomorrow color","name":"DEMAIN","property":"tomorrow_color","type":"text"},{"access":1,"description":"Schedule HPHC","name":"HHPHC","property":"schedule_h_p_h_c","type":"numeric"},{"access":1,"description":"Subscribed Power Exceeded Warning","name":"ADPS","property":"warn_d_p_s","type":"numeric","unit":"A"},{"access":1,"description":"Link quality (signal strength)","name":"linkquality","property":"linkquality","type":"numeric","unit":"lqi","value_max":255,"value_min":0}],"model":"ZLinky_TIC","options":[{"access":2,"description":"This device does not support reporting electric measurements so it is polled instead. The default poll interval is 60 seconds, set to -1 to disable.","name":"measurement_poll_interval","property":"measurement_poll_interval","type":"numeric","value_min":-1},{"access":2,"description":"Counter with TIC in mode standard or historique. May require restart (default: auto)","name":"linky_mode","property":"linky_mode","type":"enum","values":["auto","historique","standard"]},{"access":2,"description":"Power with single or three phase. May require restart (default: auto)","name":"energy_phase","property":"energy_phase","type":"enum","values":["auto","single_phase","three_phase"]},{"access":2,"description":"If you produce energy back to the grid (works ONLY when linky_mode: standard, default: auto)","name":"production","property":"production","type":"enum","values":["auto","true","false"]},{"access":2,"description":"Overrides the automatic current tarif. This option will exclude unnecesary attributes. Open a issue to support more of them. Default: auto","name":"tarif","property":"tarif","type":"enum","values":["Historique - BASE","Historique - HCHP","Historique - EJP","Historique - BBR","Standard - Sem WE Mercredi","Standard - BASE","Standard - Heure Pleine Heure Creuse","auto"]},{"access":2,"description":"Number of digits after decimal point for kWh, takes into effect on next report of device.","name":"kWh_precision","property":"kWh_precision","type":"numeric","value_max":3,"value_min":0},{"access":2,"description":"During the poll, request multiple exposes to the Zlinky at once for reducing Zigbee network overload. Too much request at once could exceed device limit. Requieres Z2M restart. Default: 1","name":"measurement_poll_chunk","property":"measurement_poll_chunk","type":"numeric","value_min":1},{"access":2,"description":"List of TIC commands to be exposed (separated by comma). Reconfigure device after change. Default: all","name":"tic_command_whitelist","property":"tic_command_whitelist","type":"text"}],"supports_ota":true,"vendor":"LiXee"},"friendly_name":"0x00158d0005ce77f1","ieee_address":"0x00158d0005ce77f1","status":"successful","supported":true},"type":"device_interview"}'
info  2022-11-26 18:00:36: MQTT publish: topic 'zigbee2mqtt/bridge/log', payload '{"message":"interview_successful","meta":{"description":"Lixee ZLinky","friendly_name":"0x00158d0005ce77f1","model":"ZLinky_TIC","supported":true,"vendor":"LiXee"},"type":"pairing"}'
debug 2022-11-26 18:01:50: Received MQTT message on 'zigbee2mqtt/bridge/request/device/options' with data '{"id":"0x00158d0005ce77f1","options":{"linky_mode":"auto"},"transaction":"6jd7g-10"}'
info  2022-11-26 18:01:50: Changed config for device 0x00158d0005ce77f1
info  2022-11-26 18:01:51: MQTT publish: topic 'zigbee2mqtt/bridge/response/device/options', payload '{"data":{"from":{},"id":"0x00158d0005ce77f1","to":{"linky_mode":"auto"}},"status":"ok","transaction":"6jd7g-10"}'
debug 2022-11-26 18:01:51: Received MQTT message on 'zigbee2mqtt/bridge/request/device/options' with data '{"id":"0x00158d0005ce77f1","options":{"linky_mode":"standard"},"transaction":"6jd7g-11"}'
info  2022-11-26 18:01:51: Changed config for device 0x00158d0005ce77f1
info  2022-11-26 18:01:52: MQTT publish: topic 'zigbee2mqtt/bridge/response/device/options', payload '{"data":{"from":{"linky_mode":"auto"},"id":"0x00158d0005ce77f1","to":{"linky_mode":"standard"}},"status":"ok","transaction":"6jd7g-11"}'
debug 2022-11-26 18:01:53: Received MQTT message on 'zigbee2mqtt/bridge/request/device/options' with data '{"id":"0x00158d0005ce77f1","options":{"energy_phase":"single_phase"},"transaction":"6jd7g-12"}'
info  2022-11-26 18:01:53: Changed config for device 0x00158d0005ce77f1
info  2022-11-26 18:01:54: MQTT publish: topic 'zigbee2mqtt/bridge/response/device/options', payload '{"data":{"from":{"linky_mode":"standard"},"id":"0x00158d0005ce77f1","to":{"energy_phase":"single_phase","linky_mode":"standard"}},"status":"ok","transaction":"6jd7g-12"}'
debug 2022-11-26 18:01:54: Received MQTT message on 'zigbee2mqtt/bridge/request/device/options' with data '{"id":"0x00158d0005ce77f1","options":{"production":"true"},"transaction":"6jd7g-13"}'
info  2022-11-26 18:01:54: Changed config for device 0x00158d0005ce77f1
info  2022-11-26 18:01:55: MQTT publish: topic 'zigbee2mqtt/bridge/response/device/options', payload '{"data":{"from":{"energy_phase":"single_phase","linky_mode":"standard"},"id":"0x00158d0005ce77f1","to":{"energy_phase":"single_phase","linky_mode":"standard","production":"true"}},"status":"ok","transaction":"6jd7g-13"}'`

chryss44, 2022-11-27:
Bon alors, sans vraiment le vouloir, le problème est résolu (pour le moment) car j'ai redémarrer Z2M pour justement forcer l'OTA du TIC en V11 avec un fichier index, mais du coup pas besoin car d'un coup ca s'est mis a discuter....pas bien compris mais je vais surveiller.
Donc si je comprends, il faut supprimer puis ré appairer le TIC mais aussi redémarrer Z2M pour que ca reparte....faire gaffe on est pas loin de Microsoft et du redémarrer pour la prise en comte :-) .

chryss44, 2023-01-03:
Bonjour,
Me concernant, à part le fait que ca cause beaucoup, c'est bon, je récupère bien ma production.
Merci

fairecasoimeme, 2023-01-12:
bonjour, tu as la réponse ici : https://github.com/fairecasoimeme/Zlinky_TIC/issues/78#issuecomment-1221533698

MichaelBitard, 2024-07-14:
Bonjour, j'ai un souci similaire, production photovoltaïque avec EDF-OA (contrat actif depuis plus d'un an, j'ai la remontée sur le compteur linky, tout ça tout ça) mais j'ai toujours 0 sur EAIT (avec Zigbee2MQTT).

J'ai tenté ce que vous aviez mis là https://github.com/fairecasoimeme/Zlinky_TIC/issues/132#issuecomment-1314981246 et j'ai comme résultat `2024-07-14 19:01:15Read result of 'liXeePrivate': {"statusRegister":{"type":"Buffer","data":[0,0,0,0,0,0,0,0]}}`, étrange non ?

Si je tente d'exécuter la commande 0x217 sur le cluster 0xff66 j'ai une erreur me disant que LixeePrivate ne supporte pas la commande.

Tout fonctionne, sauf la remontée de la production ( j'ai bien configuré le linky en mode standard, single phase et production à true )

Thread 137 (2022-11-23):

MAJ v12 Limited OTA impossible par ZHA.

WarC0zes, 2022-11-23:
Bonjour @fairecasoimeme,
j'ai voulu mettre a jour le nouveau firmware v12 limited par OTA. Comme d'habitude je modifie mon configuration.yaml en ajoutant:
```
zha:
  zigpy_config:
    ota:
      otau_directory: /config/zigpy_ota
      ikea_provider: false
      ledvance_provider: false

logger:
  default: info
  logs:
    homeassistant.components.zha: debug
    zigpy: debug
```
Dans mon dossier /config/zigpy_ota/ j'ai le fichier ZLinky_router_v12_limited.ota

Je reboot, mais le démarrage de la mise a jour ce lance pas.
```
2022-11-23 07:58:04.140 DEBUG (MainThread) [homeassistant.components.zha.core.device] [0xD98B](ZLinky_TIC): Device seen - marking the device available and resetting counter
2022-11-23 07:58:04.141 DEBUG (MainThread) [homeassistant.components.zha.core.device] [0xD98B](ZLinky_TIC): Update device availability - device available: True - new availability: True - changed: False
```

En théorie je peut mettre a jour par OTA comme je suis en firmware v11 Limited.
Es ce que d'autre utilisateur de ZHA on le même problème ou j'ai mal fait quelque chose ?

fairecasoimeme, 2022-11-23:
Les requêtes OTA se font toutes les 2-4 heures. Pour déclencher rapidement la mise à jour, il faut débrancher et rebrancher l'appareil.
Fred

WarC0zes, 2022-11-23:
D'accord, je ferais ca. merci du tuyau.

WarC0zes, 2022-11-24:
Bonjour Fred,
La mise a jour c'est faite sans problème en débranchant et rebranchant le Zlinky, ca c'est lancer directe.
Je vais tester plusieurs jour, mais ca l'air bien plus stable chez moi.
Je te ferais un retour.

Merci encore Fred.

Closed 2022-11-24.

Thread 138 (2022-11-23):

OTA toujours disponible après flash v12_limited

DamGranger, 2022-11-23:
Bonjour,
J'ai flashé avec un module CP2102 le firmware v12_limited (j'essaie de voir si j'aurai moins de déconnexion, car là il arrête de répondre toutes les 24h ce qui est frustrant). Je n'ai pas encore de retour d'expérience sur ce firmware à part celle-ci.
Je constate que Z2M continue de me proposer un update OTA pour le device. Si je clique dessus, je vois qu'il essaie d'installer la version router et fail avec un "Bad image format". Y a-t-il une manipulation à faire quelque part pour indiquer le type de firmware à utiliser dans Z2M afin que lors de la prochaine MAJ je ne sois pas obligé de la faire manuellement ?

DamGranger, 2022-11-24:
Bonjour, je ne pense pas qu'il s'agisse d'un problème d'alimentation pour plusieurs raisons :

- Je vous avais déjà renvoyé le module (fin décembre 2021) et vous l'aviez modifié, je crois avec un superviseur de tension (et une tropicalisation car il est situé dans une montée d'escalier ouverte il peut donc y faire froid), ça avait résolu les soucis de déconnexion d'ailleurs, il est étrange que ceux-ci réapparaissent.
- Le module est bien alimenté quand je vais voir dans le Linky (la LED clignote)
- la console dév me donne pour le moment un voltage correct et je vois peu de variation et, quand bien même, avec le superviseur il devrait en principe redémarrer :
```
Info 2022-11-24 00:39:16Read result of 'genPowerCfg': {"mainsVoltage":3304}
Info 2022-11-24 00:52:55Read result of 'genPowerCfg': {"mainsVoltage":3307}
Info 2022-11-24 00:57:06Read result of 'genPowerCfg': {"mainsVoltage":3305}
Info 2022-11-24 01:03:14Read result of 'genPowerCfg': {"mainsVoltage":3307}
```

J'ai donc pensé à une saturation du module liée à mon réseau Zigbee (82 devices, dont 9 routeurs) ou un problème de distance.

Les routes ont l'air plutôt stables cela dit sachant que "PC COU R" se situe à l'étage en-dessous du ZLinky_TIC soit à environ 3-4m, après il y a environ 16-18m entre ces deux devices et la maison contenant l'ensemble du réseau mais pas grand chose pour mettre un routeur dans cet espace malheureusement. "PC CHA F" étant le second plus proche puisque situé sous une fenêtre de la maison à même hauteur que le ZLinky_TIC et à proximité du coordinateur (Sonoff Zigbee Dongle-P).
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

Pour l'instant avec le firmware limited, il est trop tôt pour dire s'il sera plus stable mais j'ai quand même pas mal de trous dans les remontées... peut-être des redémarrage liés à des chutes de tension TIC, je pense que je vais donc reflashé en firmware normal, pour à nouveau bénéficier de l'OTA, on verra ce que ça donne.

Je suis de très près ma consommation en ce moment car j'ai une PAC qui doit être installée dans les jour qui viennent et je cherche à savoir si un délesteur sera nécessaire ou pas (puisque Enedis refuse de dépasser 12kVA en monophasé).

fairecasoimeme, 2022-11-24:
Bonjour,
En effet, vu les données remontées, ce n'est probablement pas un souci d'énergie fournie par le Linky. Avec les détails que vous me fournissait, il est possible qu'avec la version limitée, il y est des soucis de portée et du coup, des trous dans les remontées. (D'après le schéma, le ZLinky passe uniquement par PC CHA F et PC COU R Pour atteindre le coordinateur (les chemins avec 2 LQI x/x)).
Dans votre cas, je pense qu'il est préférable d'être sur la version "Legacy",

DamGranger, 2022-11-24:
C'est parti pour reflash en legacy alors, je vais essayer de suivre si le problème de déconnexion se reproduit et voir si je peux contrôler régulièrement les voltages.

plouf34, 2022-11-25:
Bonjour,
Vous faites comment pour passer et repasser d'un firmware limited<>router sans USB TTL, le tout tournant sous Zigbee2mqtt HA?

DamGranger, 2022-11-26:
> Bonjour, Vous faites comment pour passer et repasser d'un firmware limited<>router sans USB TTL, le tout tournant sous Zigbee2mqtt HA?

Bonjour, je le fais avec un module USB to TTL CP2102.

Sinon mon problème de connectivité ne s'est pas amélioré avec le firmware legacy. Je n'ai qu'une route pour le module.
Le routeur en question a un LQI de 3 vers le coordinateur et donc je n'ai que des routes à 3 ou 4 sauts de viables. Clairement il va falloir que je trouve une astuce pour étirer mon mesh vers cette zone.

Dans tous les cas, je marque cette issue solved puisque ça ne relève pas d'un problème avec le module, ni le firmware.

Closed 2022-11-26.

Thread 139 (2022-11-23):

Couleur du lendemain non disponible (Z2M sur HA)

BBESINET, 2022-11-23:
Bonjour.

J'ai ouvert une issue là: [https://github.com/Koenkk/zigbee2mqtt/issues/14481](url) car j'ai le champ "couleur du lendemain" qui ne change jamais de la valeur "----".

J'ai ouvert une issue dans Z2M car j'ai l'impression que le problème est dans Z2M plus que dans le Zlinky, mais j'ai tout de même le doute.

Des possesseurs de tarif tempo sur d'autres plateformes que la mienne (HomeAssistant OS et Zlinky intégré par Zigbee2MQTT v1.28.2-1) arrivent ils à avoir la couleur du lendemain?

Si oui cela signifie bien que le problème se trouve au niveau du décodage de l'info fait par Z2M...

Je fais mes mises à jour de firmware régulièrement donc a priori pas de soucis de ce coté là..

Bien cordialement.

BBESINET

fairecasoimeme, 2022-11-23:
Bonjour,
la couleur du lendemain, en mode historique, sous l'étiquette DEMAIN est disponible uniquement s'il y a une annonce de la part d'Enedis. S'il y a "----" c'est qu'il n'y a pas d'annonce de changement de couleur pour le lendemain.

Pour avoir plus d'infos comme la couleur du jour et celle du lendemain, il faut passer en mode standard et faire un contrôle du registre des statuts.

vous pouvez retrouver ces informations en cherchant le document sur Internet: Enedis-NOI-CPT_54E.pdf

Fred

BBESINET, 2022-11-23:
Bonjour Fred.

Merci pour les précisions.
Pour ma part je suis en mode historique, Et je retrouve bien ce que je savais de la téléinfo.

Concernant Zlinky:
- J'ai bien (et ce depuis l'installation du Zlinky) la PTEC qui s'affiche tout a fait correctement dans Home assistant.
` « HCJB » => Heures Creuses Jours Bleus,
 « HCJW » => Heures Creuses Jours Blancs (White),
 « HCJR » => Heures Creuses Jours Rouges,
 « HPJB » => Heures Pleines Jours Bleus,
 « HPJW » => Heures Pleines Jours Blancs (White),
 « HPJR » => Heures Pleines Jours Rouges.`

- Je m'attendais a avoir tous les soirs entre 20h et 6h la couleur du lendemain qui s'affiche. Mais la valeur reste à "----" tous les jours depuis l'installation du Zlinky il y a presque un mois. Le petit boitier "CPL" avec des diodes, ainsi que le Linky me remontent pourtant bien l'info que demain sera "BLEU" tous les soirs (Nous n'avons pas encore eu de jour blanc ni rouges depuis l'installation du Zlinky). Je m'attendais donc à avoir "----" entre 6h et 20h (couleur du lendemain inconnue avant 20h environ), puis "BLEU", BLAN" ou "ROUG" entre 20h et 6h en fonction de la couleur du lendemain.

Avec Zlinky, la valeur ne changerai que s'il y a un changement de tarif ?
Donc étant actuellement en jour bleu, on n'aurait une valeur à 20h que si celle ci est "BLAN" ou "ROUG" ?

D'avance merci pour ces précisions.

Bernard

BBESINET, 2022-11-23:
Par acquis de conscience je suis allé vérifier sur le compteur et en effet DEMAIN est indiqué ---- !

Il faudra vérifier si cela bascule au prochain jour blanc ou rouge...

Il n'y a peut être pas de soucis en fait...

fairecasoimeme, 2022-11-24:
Je ne pense pas qu'il y ait un souci, le ZLinky ne fait que retranscrire ce que le Linky donne comme info. (même si on est pas à l'abri d'un PB de décodage mais je ne pense pas)

BBESINET, 2022-11-24:
Merci du support.

Concernant le mode, je suis un peu coincé en mode historique car j'utilise par ailleurs depuis plus de 15 ans un boitier delta dore connecté à la TIC qui fait du délestage et la gestion des chauffages (fil pilotes) et du cumulus, y compris en fonction du tarif TEMPO.
Vu l'âge de mon boitier antérieur au LINKY, ça m'étonnerai qu'il continue à marcher avec une TIC en mode standard...

Au passage le ZLINKY en parallèle de ce boitier sur la Téléinfo se comporte comme un charme...

Plus de news lors du prochain passage en jour blanc ou rouge (l'hiver arrive, ça ne devrait pas être long...)

fairecasoimeme, 2022-11-24:
Oui l'ancien boitier ne saura pas décoder le mode standard. Je crois que l'on peut mettre en parallèle jusqu'à 5 appareils sur la TIC.

BBESINET, 2022-11-28:
Bon c'est confirmé. Aujourd'hui la couleur du lendemain est bien BLAN...

Cette info remonte bien via Zlinky dans zigbee2mqtt. Pas de soucis. c'est juste l'info ENEDIS qui n'est pas dispo tous les jours, mais seulement lors des changement de couleur...

Je ferme l'issue. Merci à tous pour le support !

BBESINET, 2022-12-02:
Je corrige un peu pour ceux qui viendraient avec la même question...

Apres un passage de plusieurs jour Blancs successifs, le comportement semble être le suivant (à confirmer pour les jours rouges...) :

Couleur du lendemain bleue       => zlinky renvoie "----" entre 22h et 6h
Couleur du lendemain blanche   => zlinky renvoie "BLAN" entre 22h et 6h
Couleur du lendemain rouge      => zlinky renvoie "ROUG" entre 22h et 6h
Couleur du lendemain inconnue => zlinky renvoie "----" entre 6h et 22h

BBESINET, 2022-12-09:
Suite au premier jour rouge hier... Je confirme le comportement du Linky ( et du Zlinky) suivant:
Couleur du lendemain bleue => zlinky renvoie "----" entre 22h et 6h
Couleur du lendemain blanche => zlinky renvoie "BLAN" entre 22h et 6h
Couleur du lendemain rouge => zlinky renvoie "ROUG" entre 22h et 6h
Couleur du lendemain inconnue => zlinky renvoie "----" entre 6h et 22h

Closed 2022-11-28.

Thread 140 (2022-11-23):

Cluster Power Configuration ajouté en v12.0 non déclaré ?

pdecat, 2022-11-23:
Bonjour @fairecasoimeme,

j'ai ouvert une PR https://github.com/zigpy/zha-device-handlers/pull/1962 pour ajouter le support du nouveau cluster Power Configuration ajouté en v12.0 dans Home Assistant / ZHA.

Et j'ai été surpris de constater que ce cluster n'est apparemment pas déclaré par le ZLinky_TIC : https://github.com/zigpy/zha-device-handlers/pull/1962/commits/f05d54651776347c28aa480495648c56ee7be2a4

C'est volontaire ?

WarC0zes, 2022-11-24:
Bonjour  @pdecat,
je viens de faire la maj en v12 limited et je vois bien le cluster dans la gestion du Zlinky.
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

fairecasoimeme, 2022-11-24:
> Et j'ai été surpris de constater que ce cluster n'est apparemment pas déclaré par le ZLinky_TIC : [zigpy/zha-device-handlers@f05d546](https://github.com/zigpy/zha-device-handlers/commit/f05d54651776347c28aa480495648c56ee7be2a4)
>
> C'est volontaire ?

Non, le cluster est normalement "discoverable"

pdecat, 2022-11-24:
Hmm, j'ai eu des soucis également lors du passage de v11 à v12 en OTA, et j'ai dû ré-appairer également, mais je n'ai pas supprimé côté ZHA pour ne pas perdre l'historique. C'est peut-être à de ça.

pdecat, 2022-11-24:
> Bonjour @pdecat, je viens de faire la maj en v12 limited et je vois bien le cluster dans la gestion du Zlinky. 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
>
> Par contre j'ai supprimer le Zlinky et je les réappairer après la maj en v12.

Du coup, le quirk qui permet de requéter le cluster _manufacturer specific_ ne s'applique plus à ton ZLinky semble-t-il.

WarC0zes, 2022-11-24:
@pdecat  c'est exacte j'avais même pas remarquer, sa utilise plus le quirk.
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

pdecat, 2022-11-24:
Oui, car la signature change dans ton cas mais pas le mien 🤔

pdecat, 2022-11-24:
C'est bien un problème de cache côté ZHA.

pdecat, 2022-11-24:
@WarC0zes tu peux aussi voir si le quirk s'applique directement sur le device :

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

WarC0zes, 2022-11-24:
@pdecat
je savais mais comme sa utilise plus de quirk, je voulais te montrer mon tableau flex ou on voit les quirks utiliser ou pas.
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

Closed 2022-11-24.

Thread 142 (2022-11-25):

Power Cluster and Configure reporting

pipiche38, 2022-11-25:
It looks like v12 is bringing an additional cluster 0x0001 with 3 values reported. Could you please provide if those can be configure reported or not, as I didn't see them in the documentation

fairecasoimeme, 2022-11-25:
You can find this infos here : https://github.com/fairecasoimeme/Zlinky_TIC#powerconfiguration-cluster-0x0001----from-v12

RO= READ only - RP= Reportable - RW = Read/Write

pipiche38, 2022-11-25:
So 0x0001/0x0001 is not reportable , and is then requesting the host to poll the value, in addition ,  I do not see the Alarm Cluster is that something you plan to do ? As I don't understand the purpose of the ThreshodMin/Max without an alarm cluster. which then would be preventing the fact to poll such value

And from the Zigbee standard

```
The alarm settings in this table require the Alarms cluster to be implemented on the same device - see De-
pendencies```

Closed 2022-11-25.

Thread 144 (2022-11-29):

Zlinky Lixee OTA 4000-0012 + zigbee2mqtt : problème

maxime1992, 2022-11-29:
Bonjour, je reprends le post qui se trouve [ici](https://forum.hacf.fr/t/zlinky-lixee-ota-4000-0012-zigbee2mqtt-probleme/17783) pour parler d'un probleme sur la derniere mise a jour OTA.

J'ai suivi les conseils du post de supprimer dans z2m le zlinky, puis de le pair a nouveau sauf que je finis avec cette erreur:

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

Quelqu'un aurait t-il une idee? Merci

maxime1992, 2022-11-29:
[Resolu](https://forum.hacf.fr/t/zlinky-lixee-ota-4000-0012-zigbee2mqtt-probleme/17783/10?u=max)

Closed 2022-11-29.

Thread 146 (2022-12-01):

constant fast blinking after OTA

toxic0berliner, 2022-12-01:
Hello, not sure if french or english is better ==> je peux redemander en français si besoin

A few days ago I upgraded my lixee ZLinky TIC with the OTA upgrade that Z2M proposed to me (v12). After that, it stopped reporting the kWh I consumed, I played a little with the reporting option, pushed the precision to 3, the min report value to 0.000001, report intervals to 60 seconds... It seemed not to work, so I wanted to downgrade to v11.
I updated my z2m config file :
<details><summary>configuration.yaml</summary>

```
homeassistant: true
mqtt:
  server: mqtt://core-mosquitto:1883
  user: addons
  password: XXX
serial:
  port: >-
    /dev/serial/by-id/usb-ITEAD_SONOFF_Zigbee_3.0_USB_Dongle_Plus_V2_20220816084617-if00
  adapter: ezsp
frontend:
  port: 8099
advanced:
  homeassistant_legacy_entity_attributes: false
  legacy_api: false
  legacy_availability_payload: false
  log_level: debug
  log_syslog:
    app_name: Zigbee2MQTT
    eol: /n
    host: localhost
    localhost: localhost
    path: /dev/log
    pid: process.pid
    port: 123
    protocol: tcp4
    type: '5424'
  last_seen: ISO_8601
  pan_id: 18277
  channel: 15
  network_key:
    - X
    - X
    - X
    - X
    - X
    - X
    - X
    - X
    - X
    - X
    - X
    - X
    - X
    - X
    - X
    - X
device_options:
  legacy: false
availability:
  active:
    timeout: 4
  passive:
    timeout: 1500
ota:
  zigbee_ota_override_index_location: index-custom-ota.json
devices:
  <some devices>
groups:
  <some groups>

```
</details>

Added the `/config/zigbee2mqtt/index-custom-ota.json` file :
<details><summary>/config/zigbee2mqtt/index-custom-ota.json</summary>

```
[
    {
        "fileVersion": 12,
        "fileSize": 245710,
        "manufacturerCode": 4151,
        "imageType": 1,
        "sha512": "5d7e0a20141b78b85b4b046e623bc2bba24b28563464fe70227e79d0acdd5c0bde2adbd9d2557bd6cdfef2036d964c35c9e1746a8f1356af3325dd96f7a80e56",
        "url": "https://github.com/fairecasoimeme/Zlinky_TIC/releases/download/v12.0/ZLinky_router_v12.ota"
    },
    {
        "fileVersion": 11,
        "fileSize": 244142,
        "manufacturerCode": 4151,
        "imageType": 1,
        "sha512": "d7996ef7495b7c98cf6adb49530db29f3210c0e097f938da433f13e5b13446e72f0ece2205b126ee8525a900f1fa0e574fdf4aff07a9013945ea216d83fafc0d",
        "url": "https://github.com/fairecasoimeme/Zlinky_TIC/releases/download/v11.0/ZLinky_router_v11.ota",
        "force": true
    }
]

```
</details>

Rebooted, clicked the search OTA update button, and I believe it's at that time that the Lixee went offline. I tried a few things then, always recieving an error that the lixee was offline or timed out to any command. I then went down in the garage and saw the lixee was blinking very fast.

I tries a lot of things since then :
- unplug/replug the lixee
- push and hold the pair button
- forcibly removed the device from z2M
- all of the above, while haveing pairing enabled in z2m
- plug the lixee into linky while pressing the button in the front (top)
- plug the lixee into linky while pressing the button in the back (bottom) (the led stayed "off", I think it was listening for debug port... I unplugged and repluged it started blinking fast again)
Pushing the pair button stops the blinking for a bit, but as soon as released it starts blinking fast again.

Seems the lixee is "dead". I have ordered this https://www.amazon.fr/gp/product/B00LODGRV8/ref=ppx_yo_dt_b_asin_title_o00_s00?ie=UTF8&psc=1
It should arrive on monday and I hope it will let me flash a fresh v10 or v11 firmware and solve my issue...

But if you have some other way meanwhile to "reset" and get it working, that would be nice !

fairecasoimeme, 2022-12-01:
Hi,
If the ZLinky is blinking fast, It's because the device is left the network and it is in pairing mode. With Z2M, after an update, you have to left the network, reboot Z2M and re pair the zlinky.

Fred

toxic0berliner, 2022-12-01:
wow, you are correct, sorry for the hassle !
Turns out enabling paring on all devices was a bad idea. Enabling it only on the nearby router worked better but interview failed, I had to enable paring on the coordinator, that was far, so it failed a few times but now it seems ok.
I do believe the network will heal itself and lixee will soon have it's messages relayed by the router nearby and possibly other devices in my garage, let's see.
Closing this then

Thanks a lot Fred !

Closed 2022-12-01.

Thread 147 (2022-12-02):

Plus aucune remontée avec la V12.

neotwix, 2022-12-02:
Bonjour,
Depuis que j'ai fait l'OTA vers la v12. je n'ai plus aucune remonté qui ce fait entre le module et Z2MqTT.
Mon champs base reste bloqué a sa derniere valeur et ne bouge plus depuis.
J'ai redemarrer un peu tout le monde (Home Assistant et Z2MQTT) le module (enlevé remis du Linly.
mais rien n'y fait je n'ai plus de remontée.

rhcpdu13, 2022-12-02:
Bonjour,
Je me joins à toi, j'ai eu le même problème, voir pire. J'ai tenté tout ce que tu as dit, mais en plus :
Suppression forcée sur z2mqtt, tentative de ré appairage, mais il me sort tout le temps en non supporté.
J'ai tenté aussi un reset du lixee (en mode appairage, appuyer pendant 10 sec sur le bouton...) rien n'y fait. Dans les logs j'ai uniquement ça : Failed to interview '0x00158d0005d2a937', device has not successfully been paired

@neotwix as tu pu t'en sortir ?

ellmout, 2022-12-02:
Bonjour,
Idem même problème depuis hier, mais après passage en v11, dans Z2m j'ai le message d'erreur suivant :

`Zigbee2MQTT:error 2022-12-02 22:05:39: Failed to configure 'Zlinky', attempt 1 (Error: Bind 0x00158d0005d284c1/1 seMetering from '0x00212effff075e84/1' failed (waiting for response TIMEOUT)
    at DeconzAdapter.bind (/app/node_modules/zigbee-herdsman/src/adapter/deconz/adapter/deconzAdapter.ts:768:19)
    at Endpoint.bind (/app/node_modules/zigbee-herdsman/src/controller/model/endpoint.ts:567:13)
    at Object.bind (/app/node_modules/zigbee-herdsman-converters/lib/reporting.js:40:9)
    at Object.configure (/app/node_modules/zigbee-herdsman-converters/devices/lixee.js:598:9)
    at Configure.configure (/app/lib/extension/configure.ts:115:13)
    at Configure.start (/app/lib/extension/configure.ts:68:13)
    at Controller.callExtensions (/app/lib/controller.ts:316:17)
    at Controller.start (/app/lib/controller.ts:153:9)
    at start (/app/index.js:107:5))`

Si je vais au compteur, que je débranche et rebranche le module, il recommunique mais juste un fois et plus de nouvelle.

WarC0zes, 2022-12-02:
Bonjour, quand vous flasher en v12 supprimer et ré-appairer le Zlinky. Je vais dire mieux quand vous flasher une mise a jour, vaut mieux supprimer et ré-appairer le Zlinky. J'ai eu le même soucis en v12 Limited sous ZHA et tout fonctionne au top ( je dirais que même plusieurs personnes ont eu ce soucis).
Penser aussi a la distance entre la clef zigbee et le Zlinky ca joue beau, rapprocher le de la clef pour l'appairer.

https://forum.hacf.fr/t/zlinky-lixee-ota-4000-0012-zigbee2mqtt-probleme/17783

chryss44, 2022-12-03:
Bonjour, je confirme les galère de la V11 à la V12, il m'a fallut faire plusieurs suppressions dans Z2M et plusieurs débranchements retranchements sans compter un redémarrage de Z2M.
Tout est reparti mais c'était effectivement un peu lourd.

klemsgithub, 2022-12-03:
Bonjour,
Idem, je suis passé de la V5 à la V12 la semaine dernière et j'ai perdu la remontée de certaines infos. J'ai du forcer la suppression dans zigbee2mqtt puis ré-appairer (avec difficulté, au bout de 4 ou 5 essais) pour un retour à la normal. Depuis ce matin j'ai de nouveau perdu la connexion (j'ai le lixee depuis plusieurs mois et je n'avais jamais eu un pépin jusque ici...). Je verrai demain pour tenter de ré-appairer (il commence à faire nuit, le compteur est à 10m de la maison). J'ai l'impression que la qualité du signal est moins bonne qu'avant (et je ne peux pas déplacer mon serveur qui se trouve physiquement dans une baie 19" dans la maison, je passe par un prise philips hue branchée au plus proche du linky dans la maison pour faire relais...) Est-il envisageable que le firmware joue sur la qualité du signal ?  ou alors c'est juste une coïncidence lié a la météo un peu fraîche?

vingerha, 2022-12-04:
J'avais plusieurs soucis moi même V11>V12, reappairage Z2M très difficile et j'avais rallongé entre Linky et Zlinly pour retourner au normal...mon compteur est dehors, à 8m d'un repeteur zigbee.

DamGranger, 2022-12-04:
Quand vous avez le problème, vous n'avez plus rien qui remonte ou c'est comme dans #145 ?

neotwix, 2022-12-05:
Rien de rien.
J'ai suivi votre manip. (remove de Z2MQTT et reset du module) ca amarché

pabaillon, 2022-12-09:
Plus de remonté depuis cette nuit également en V11 et Z4D..

klemsgithub, 2022-12-09:
Pour en revenir à la déconnexion que j'évoquais en début de semaine, je n'ai rien eu besoin de faire pour que ça remarche.
En effet j'ai maintenant des coupures de temps en temps qui durent de quelques minutes à 30/40 minutes puis ça revient tout seul. Encore une fois j'ignore si il y a un lien avec le firmware V12 :/.

rhcpdu13, 2022-12-09:
Hello,
Je confirme que, j'ai pu tout refaire fonctionner correctement, et faire un appairage sans problème en déplaçant le serveur à proximité du linky. Depuis, aucun problème, même après rebascule du serveur à son emplacement. Je sais que j'ai aussi un bon maillage autour.. ça peut expliquer aussi les problèmes que vous avez.. en tout cas plus de soucis pour ma part en v12 :)

ER503, 2022-12-12:
Bonjour,

J'ai aussi des problèmes depuis le passage en V12, effectué il y a deux jours.
Mon ZLinky est hors ligne depuis que j'ai fait cette mise-à-jour.

J'ai beau essayer de le supprimer de Z2M et de tenter un réappairage, il apparait toujours comme "Non supporté", et je ne sais plus quoi faire...

fairecasoimeme, 2022-12-13:
il faut aussi redémarrer Z2M

bdherouville, 2022-12-20:
Bonjour,

j'ai galéré à réappairer après l'upgrade. Mon modèle est celui avec antenne externe. J'ai remplacé l'antenne fournie par une antenne 2.4GHz plus grande et tout est rentré dans l'ordre. Mais j'ai mis du temps.

trollix, 2022-12-20:
Moi, après plusieurs semaines sans problèmes. après un passage à la V12, ça déconnecte toutes les 24h... Grrrrr

ericsche, 2022-12-29:
Pareil depuis le passage en v12 j'ai bcp de soucis de déconnections que je n'avais pas avant v10.

na-ji, 2023-01-06:
Salut !
Même problème de mon côté, il arrive souvent que le Zlinky_TIC s'arrête de mettre à jour les valeurs. Aucune erreur côté zigbee2mqtt, c'est comme si l'appareil renvoyait constamment les mêmes valeurs figées. La seule solution que j'ai trouvée pour l'instant, c'est débrancher et rebrancher l'appareil du compteur Linky. C'est assez gênant, vu que ça fausse toutes les stats dans HA.
Est-il possible de downgrade le firmware?

Bazarov42, 2023-01-06:
Je n'arrive même plus à le connecter à z2m, il n'est plus reconnu...

billOu46, 2023-01-12:
Hello, même souci pour moi. J'ai pas fait attention lors de la maj 12, et je me rends compte que j'ai plus de stats depuis plusieurs jours.
Débrancher/rebrancher le Zlinky a pas suffit.
Supprimer du réseau et réappairer.
En effet, il a été capricieux au réappairage. Il a fallu que j'insiste.
J'attends que les infos soient a nouveau visible dans les stats, mais il a bien pris en compte l'index actuel depuis son réappairage, donc ça devrait le faire.

Serait-il possible de pouvoir faire des maj sans pour autant nécessiter de réappairer le Zlinky ?

bdherouville, 2023-01-12:
J'étais dans une configuration très contraignante avec un linky loin du premier routeur de mon installation, je ne parle même pas du coordinateur.
La première chose que j'ai faite est d'updater le Zlink_TIC à côté du coordinateur en l'alimentant avec du 5V entre A et L2.
Ensuite j'avais la version avec antenne externe. J'ai mis une antenne 2.4GHz plus grande, récupérée sur un ancien routeur wifi (en 2.4GHz aussi)
Enfin, j'ai mis en extérieur un module pour contôler une prise de courant. Ce module fait routeur donc il améliore la connectivité avec le coordinateur.
[module](https://fr.aliexpress.com/item/1005003637851837.html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)

fairecasoimeme, 2023-01-12:
> Serait-il possible de pouvoir faire des maj sans pour autant nécessiter de réappairer le Zlinky ?

@billOu46  Malheureusement, le redémarrage n'est pas dû au ZLinky mais de comment il est géré sur Z2M. Je ne sais pas pourquoi, quand il y a mise à jour, Z2M envoie pleins de requêtes au ZLinky sans arrêt et met le système sous l'eau.

fairecasoimeme, 2023-01-12:
Bin si, sauf que cela nécessite souvent un redémarrage de Z2M après la mise à jour.

WarC0zes, 2023-01-12:
Bonjour,
je suis passé de ZHA a Z2M et aucun soucis d'apparaige du Zlinky avec la v12 Limited.
@fairecasoimeme depuis la sortie de la v12,  j'ai augmenter mon réseau a 35 appareils (contre 17 a la sortie de la v12) et mon Zlinky est super stable ( plus de timeout ) 👍
pour moi c'est le gold firmware :)

vingerha, 2023-01-12:
C'est clair qu'il y a probablement tant des gens qui n'ont rien de soucis... ceux qui l'ont sont dans le forum ou ici sur github. C'est juste intéressant que pour ceux qui ont les soucis c'est presque pareil: soucis d'appairer. Chez moi j; en suis presque sûre qu'il y a un lien avec Z2M car avec chaque appairage Zlinky, mqtt devient 'fou'

Bazarov42, 2023-01-12:
Depuis que je l'ai supprimer pour essayer de l'apareiller de nouveau, je ne le vois plus du tout, même tout à côté...

ylemoigne, 2023-01-13:
Je n'ai pas de soucis pour appareiller, jamais. Le dongle zigbee est a 3m du zlinky. Par contre, j'ai le soucis HASS(ZHA) choppe des données au démarrage, puis plus rien ne bouge.

Dites moi comment je peux aider a résoudre ce soucis d'update (fourniture de log, manip, test, etc).

fairecasoimeme, 2023-01-13:
> Je n'ai pas de soucis pour appareiller, jamais. Le dongle zigbee est a 3m du zlinky. Par contre, j'ai le soucis HASS(ZHA) choppe des données au démarrage, puis plus rien ne bouge. (firmware V12 limited)
>
> Dites moi comment je peux aider a résoudre ce soucis d'update (fourniture de log, manip, test, etc).

Pour ZHA, il y a eu une mise à jour récente de HA qui devrait régler le problème. https://www.home-assistant.io/blog/2023/01/04/release-20231/#release-202312---january-8

https://github.com/home-assistant/core/pull/85355

Pofilo, 2023-01-15:
Bonjour,
Je suis passé hier de la V11 à la V12 (depuis Z2M 1.29.2).
Ce matin, je m'aperçois que je n'ai plus de valeur, BASE n'est plus incrémenté.
J'ai réussi à priori à corriger le problème avec cette manip:
+ _(Rebrancher le ZLinky sur le compteur Linky -> à priori, ça n'a rien fait)_
+ Suppression du ZLinky dans Z2M (cf capture)
+ Appui 10 secondes sur le bouton reset du ZLinky
+ Arrêt de Z2M
+ Remise des anciens paramètres (reset par la suppression dans Z2M) (voir + bas mes paramètres en question)
+ Redémarrage de Z2M
+ Et voilà!

```
'0xyyyyyyyyyyyyyyyy':
    friendly_name: Linky
    measurement_poll_interval: 360
    linky_mode: historique
    energy_phase: single_phase
    production: 'false'
    kWh_precision: 3
    measurement_poll_chunk: 1
    legacy: false
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

    optimistic: true
```

Si chacun ayant eu ce problème peut décrire sa procédure de fix, peut-être qu'on découvrira qqchose :)

KipK, 2023-01-16:
J'ai voulu tester la v12, j'étais en V9 depuis Septembre,
Autant je n'avais aucun soiucis avec la V9 en mode no routeur ( sur Deconz/Conbee ) , autant avec la v12,j'ai essuyé 3 deconnections en 4 jours avec obligation de debrancher/rebrancher le module.

Repassage en v9 ( no router )  et tout refonctionne correct.
Je n'ai pas encore testé de flasher le firmware no route v12 , il faut que je retrouve mon FTDI avant .

ylemoigne, 2023-01-16:
> Pour ZHA, il y a eu une mise à jour récente de HA qui devrait régler le problème. https://www.home-assistant.io/blog/2023/01/04/release-20231/#release-202312---january-8
>
> [home-assistant/core#85355](https://github.com/home-assistant/core/pull/85355)

Toujours pas. J'ai fais maj HASS, supprimé le zlinky des devices, reboot hass, reset 10s zlinky, réassocié, reboot hass.

Home Assistant 2023.1.4
Supervisor 2022.12.1
Operating System 9.4
Interface utilisateur : 20230110.0 - latest

J'ai un abonnement Base.

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

Pas d'autre config particulière.

A noter, si j'interroge manuellement la valeur la, elle se met bien a jour :
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

Comme pour mon message précédent : Dites moi comment je peux aider a résoudre ce soucis d'update (fourniture de log, manip, test, etc).

WarC0zes, 2023-01-16:
@ylemoigne
c'est toujours pas fixer ce problème, la dernière maj de ZHA change rien.
le PR pour fix, faut patienter encore https://github.com/home-assistant/core/pull/82602

ylemoigne, 2023-01-30:
@WarC0zes j'ai du mal a suivre pour le coup dans quel version ce sera disponible.

WarC0zes, 2023-01-31:
> @WarC0zes j'ai du mal a suivre pour le coup dans quel version ce sera disponible.

C'est dispo dans la version core 2023.2.0 qui sort demain (01/02/2023) ou maintenant dans la beta.

pipiche38, 2023-02-10:
je pense que si vous avez un coordinateur autre qu'une Zigate, il y a une grande probabilité de perte du ZLinky lors d'une mise-à-jour de ZHA et notamment des couches zigpy

ylemoigne, 2023-02-12:
De mon coté c'est bon depuis la 2023.2.0 comme l'avait annoncé @WarC0zes (que je remercie pour le suivi ❤️ )

Bazarov42, 2023-02-12:
C'est tombé en marche tout seul et la c'est  de nouveau pété ^^
Pas l'impression que ça soit une perte de connexion le Zlinky est toujours reconnu et présent mais les remontées d'info sont sporadiques

fairecasoimeme, 2023-02-13:
si les remontées sont sporadiques, c'est surement qu'il y a des pertes de trames. Avez-vous des logs ? quel est le LQI ?

fairecasoimeme, 2023-02-13:
Pouvez-vous générer une carte du réseau avec les LQI ?

Bazarov42, 2023-02-13:
C'est de nouveau en rade.
Le schéma a été plus long à faire que d'habitude
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

au niveau des logs le zlinky à disparu, j'ai essayé de le reconfigurer voici ce que disent les logs ;

`error 2023-02-13 14:59:40Failed to configure 'Linky', attempt 1 (Error: Bind 0x00158d0005d2a8ad/1 seMetering from '0x00212effff07f7e2/1' failed (waiting for response TIMEOUT) at DeconzAdapter.bind (/app/node_modules/zigbee-herdsman/src/adapter/deconz/adapter/deconzAdapter.ts:768:19) at Endpoint.bind (/app/node_modules/zigbee-herdsman/src/controller/model/endpoint.ts:567:13) at Object.bind (/app/node_modules/zigbee-herdsman-converters/lib/reporting.js:40:9) at Object.configure (/app/node_modules/zigbee-herdsman-converters/devices/lixee.js:598:9) at Configure.configure (/app/lib/extension/configure.ts:117:13) at Configure.onMQTTMessage (/app/lib/extension/configure.ts:55:21))
info 2023-02-13 14:59:40MQTT publish: topic 'zigbee2mqtt/bridge/response/device/configure', payload '{"data":{"id":"Linky"},"error":"Failed to configure (Bind 0x00158d0005d2a8ad/1 seMetering from '0x00212effff07f7e2/1' failed (waiting for response TIMEOUT))","status":"error","transaction":"kuval-7"}'`

fairecasoimeme, 2023-02-13:
Les logs montrent que le coordinateur ne reçoit pas la réponse du Bind (timeout). Sur le schéma, on voit que le lien entre le ZLinky et le routeur a une qualité (LQI) de 1.

Bazarov42, 2023-02-13:
J'ai refais un schéma alors que je n'ai toujours pas de remontée en temps réelle

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

j'ai une machine qui tourne, ça devrait pas être à 2 A  ^^

ericsche, 2023-02-14:
Oui je pense que le maillage est un peu faible.
D'expérience 3 lien c'est quand même mieux.
Pour ma part je n'ai pas de lien direct mais le linky a 5 voisins.

Envoyé à partir de Outlook pour Android<https://aka.ms/AAb9ysg>
________________________________
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

Bazarov42, 2023-02-14:
Je suis trop loin pour qu'il se connecte au coordinateur en direct, c'est pour ça que j'ai pris un petit routeur : https://www.amazon.fr/gp/product/B08438TKYG/ref=ppx_yo_dt_b_search_asin_title?ie=UTF8&psc=1

Je n'ai pas d'autres appareils sur lequel le Zlinky peut se connecter.
Si je ne mets pas se routeur/répéteur la l’interrupteur de la cuisine se connecte directement au coordinateur sans problème mais le Zlinky n'y arrive pas.

WarC0zes, 2023-02-15:
Faut rajouter d'autre routeur, avec le lqi a 65 ( vu l'ancien Screenshot a 1, ca doit yoyo le lqi ), je pense que c'est pas assez pour qu'il soit stable.

ericsche, 2023-02-15:
Prends plutôt des prises qu'un répéteur au moins cela t'apporte une fonction domotique plutôt que de brancher un élément juste pour faire routeur.
Perso j'ai cela

Envoyé à partir de Outlook pour Android<https://aka.ms/AAb9ysg>
________________________________
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

ericsche, 2023-02-15:
Perso j'ai deux trois  https://amzn.eu/d/gOo6jf4
Comme cela tu peux piloter une prise et mesurer la conso.
Marche très bien derrière mon sèche linge 😊

Envoyé à partir de Outlook pour Android<https://aka.ms/AAb9ysg>
________________________________
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

vingerha, 2023-02-15:
J'ai mon linky et donc zlinky à l'extérieur et ajouté un prise extérieur Lidl qui maintenant couvre aussi mon gazpar

ericsche, 2023-02-16:
Pour info même soucis avec la v13 et zigbee2mqtt j'ai  lancé la maj il y a 24h et depuis plus rien 😒 je suis bon pour un reset je pense. C'est dommage car on perd l'historique à chaque fois.

ericsche, 2023-02-22:
Merci Arjan !

Au final en lisant des blog l'autre soir j'ai trouvé une option 3 qui est d'utiliser un helper de type utility métier : https://www.home-assistant.io/integrations/utility_meter/
Du coups si tu change de fournisseur ou tu dois reset le zlinky tu ne perds pas l'historique.

Du coups je vais tester cela 😊

Envoyé à partir de Outlook pour Android<https://aka.ms/AAb9ysg>
________________________________
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

vingerha, 2023-02-23:
Ç'est comme option 1, une sensor à côté

mycanaletto, 2023-02-26:
Comment expliquer que depuis cette MAJ on perde le le contact, sinon par le code de cette mise à jour puisqu'aucune autre modification n'a eu lieu et que tout fonctionnait à merveille depuis plus d'un an ?

Y a t'il possibilité de repasser sur une vieille version ?

fairecasoimeme, 2023-02-26:
> Comment expliquer que depuis cette MAJ on perde le le contact, sinon par le code de cette mise à jour puisqu'aucune autre modification n'a eu lieu et que tout fonctionnait à merveille depuis plus d'un an ?
>
> Y a t'il possibilité de repasser sur une vieille version ?

Ça n'a rien à voir avec le firmware mais avec le processus de mise à jour OTA. Il arrive souvent qu'après une mise à jour OTA, selon le coordinateur ou le plugin, il faut RAZ le ZLinky et refaire un appairage.

Pour faire un downgrade, il faut un module USB TTL et suivre la procédure de mise à jour Non OTA : https://github.com/fairecasoimeme/Zlinky_TIC#non-ota

Bazarov42, 2023-03-07:
>

J'ai trouvé une utilité à mettre une prise zigbee et en effet ça fonctionne beaucoup mieux. (merci du coup de main)
Par contre je n'arrive plus à mettre les relevés dans le tableau énergie ^^

KipK, 2023-03-07:
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

Pour le downgrade vous pouvez aussi éditer le numéro de version dans le fichier OTA avec le client Deconz ( onglet Otau ) et mettre une version supérieure. l'OTA va se faire, et le firmware installé aura qd meme la bonne version après installation. Du coup bien penser à virer le fichier ensuite ou ça va refaire la mise à jours en boucle ( vu qu'il verra une version supérieure )

Bazarov42, 2023-03-07:
> J'ai trouvé une utilité à mettre une prise zigbee et en effet ça fonctionne beaucoup mieux. (merci du coup de main) Par contre je n'arrive plus à mettre les relevés dans le tableau énergie ^^

J'ai parlé trop vite, ça a fonctionné un temps et la c'est re-denouveau hs, je n'arrive même plus à l'appairer.
Je vais attendre des fois ça revient tout seul

cynnfx, 2023-07-30:
Hello first and thank for all work accomplished. idk if this is the right place but you guys seems to have a lixee version with antenna. I'm with the 1.4 version without antenna and even a connector for it. If somekind of hero can send a picture of the pcb and the antenna connection it would be wonderful 👍 i actually try as you probably guess to add an antenna. Thanks everyone!

Thread 152 (2022-12-15):

Abonnement Zen

su2626, 2022-12-15:
Bonjour à tous,

J'ai quelques problèmes depuis mon changement de fournisseur. Je suis passé chez EDF sur une offre Zen HC Weekend + Lundi et depuis je ne parviens pas à récupérer les bonnes valeurs sur mon Lixee.

Je suis sur Zigbee2mqtt. Voici la conf du lixee :

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

Voici les données que j'obtiens :
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

Le journal :
MQTT publish: topic 'zigbee2mqtt/Linky', payload '{"active_enerfy_out_d01":0,"active_enerfy_out_d02":0,"active_power":-32768,"active_power_max":-32768,"active_power_ph_b":-32768,"active_register_tier_delivered":"TH..","apparent_power":190,"available_power":45,"average_rms_voltage_meas_period":0,"current_date":"","current_index_tarif":0,"current_price":"","current_summ_delivered":19133.943,"current_tarif":"BASE","current_tier1_summ_delivered":19133.943,"current_tier2_summ_delivered":0,"current_tier3_summ_delivered":0,"current_tier4_summ_delivered":0,"current_tier5_summ_delivered":0,"current_tier6_summ_delivered":0,"drawn_v_a_max_n1":0,"linkquality":126,"message1":"","message2":"","meter_serial_number":"022061736895","power_threshold":null,"relais":0,"rms_current":0,"rms_current_max":90,"rms_voltage":65535,"schedule_h_p_h_c":0,"site_id":"","software_revision":null,"start_notice_e_j_p":0,"status_register":"","tomorrow_color":"","update":{"installed_version":"4000-0012","state":"idle"},"update_available":false}'

Si quelqu'un a des pistes ? :/

fairecasoimeme, 2022-12-15:
Votre linky est en BASE pas en Zen HC Weekend + Lundi

su2626, 2022-12-15:
Pourtant sur le Linky je vois bien "HC Semaine", "HP Semaine", "HC WE", "HP WE", "HC Lundi" et "HP Lundi".

Je dois me tourner vers EDF du coup?

su2626, 2022-12-15:
Très bien, je vais donc les contacter et je ferai un retour ici au besoin.

Merci pour votre réactivité en tout cas.

J'en profite juste pour une seconde question, va-t-on disposer du choix "Standard - Sem WE Lundi" et "Standard - Sem WE Vendredi" à l'avenir ?

fairecasoimeme, 2022-12-15:
> J'en profite juste pour une seconde question, va-t-on disposer du choix "Standard - Sem WE Lundi" et "Standard - Sem WE Vendredi" à l'avenir ?

je ne sais pas, il faut poser la question aux développeurs du plugin

SilentT-FR, 2023-07-20:
@su2626 il existe depuis 3 mois maintenant
https://github.com/Koenkk/zigbee-herdsman-converters/blame/master/src/devices/lixee.js#L323

fairecasoimeme, 2023-07-20:
merci pour le retour, je clôture.

Closed 2023-07-20.

Thread 153 (2022-12-16):

Presque pas de métriques

kimizz59, 2022-12-16:
Bonjour,

J'ai connecté un ZLinky_TIC à mon HA via Z2M mais je n'ai jamais réussi à avoir des informations intéressantes.

Version du firmware : 4000-0012
Zigbee2MQTT version: 1.28.4-1
Mode linky : Standard (j'étais en histo et suis passé en standard en espérant un changement, hélas non)

J'ai uniquement ce genre d'info
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

Je n'ai que ce genre de log actuellement :
`Zigbee2MQTT:info  2022-12-16 23:18:39: MQTT publish: topic 'zigbee2mqtt/Lixee', payload '{"active_enerfy_out_d01":0,"active_power":-32768,"active_power_max":-32768,"active_power_ph_b":-32768,"active_register_tier_delivered":"","apparent_power":65535,"available_power":null,"average_rms_voltage_meas_period":0,"current_date":"","current_index_tarif":0,"current_price":"","current_summ_delivered":0,"current_tarif":"BASE","current_tier1_summ_delivered":0,"current_tier2_summ_delivered":0,"drawn_v_a_max_n1":0,"linkquality":164,"message1":"","message2":"","meter_serial_number":"","power_threshold":null,"relais":0,"rms_current":65535,"rms_current_max":65535,"rms_voltage":65535,"site_id":"","software_revision":null,"status_register":"","update":{"installed_version":"4000-0012","state":null},"update_available":null,"warn_d_p_s":0}'`

J'ai tenté de passer les paramètres spécifique en manuels, j'ai tenté de delete le lixee pour le réappairé à multiple reprises mais je n'ai jamais plus que ça.

Ma clé Zigbee est à 3m de mon linky, je ne pense pas que cela soit un problème de distance.

Assez nouveau sur HA et Z2M, je ne vois pas trop quoi tester de plus et où je pourrais choper des infos intéressantes pour résoudre mon souci.

josephpage, 2022-12-17:
Avez-vous essayé de jouer avec les différents paramètres de l'onglet "Paramètres (spécifiques)" dans Zigbee2Mqtt ? Si j'étais dans votre situation c'est ce que je ferais.

Mais c'est vrai que le fait que même le Serial Number ne remonte pas est très mauvais signe.
Si vous ne trouvez pas de solution avec différents réglages et après plusieurs ré-appairage, il vous reste à demander de l'aide au fabricant : https://lixee.fr/nous-contacter

kimizz59, 2022-12-17:
Yes j'ai essayé un peu de jouer un peu avec les options.
Je ne maitrise pas les métrique "poll" en revanche, avec quelles valeurs je pourrait faire des essais à ce niveau là ?
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

Si avec ça je n'arrive toujours rien, je vais contacter le fabricant directement dans ce cas.

CladStriffe, 2022-12-18:
Bonjour,

Deja on voit une bizarrerie : les valeurs dans l'onglet "expose" sont celles du mode historique.
Essayez dans l'onglet "paramètres spécifiques" de mettre le mode à "standard".
Puis single phase et false si vous n'avez qu'une phase et pas de production.

CladStriffe, 2022-12-18:
Les valeurs dans "expose" sont celles du mode historique.
C'est toujours ça que vous avez même après avoir changé manuellement dans paramètres spécifiques sur "standard" ?

kimizz59, 2022-12-18:
Yes, ma config est celle sur le screen juste au dessus. J'ai également testé en production "false".
J'ai vérifié, je suis bien en mode standard sur la TIC chez Total, elle était en histo au début, lors de mes premières mises en place.
Je pense qu'un réappairage suffit lors d'un changement de mode de TIC (je ne compte même plus le nombre de réappairages que j'ai fait) mais je vais vérifier s'il n'y a pas de manipulation particulières dans ce genre de cas.

Il est possible qu'au début j'ai vu une maj disponible et l'ai lancé. Après pas mal de recherche je vois que cela pourrait poser des soucis (je ne sais pas si c'est la cause du miens).

Mardi je testerais cette procédure (je n'ai pas un accès physique constant à mon installation)
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
source : https://www.domo-blog.fr/test-lixee-teleinformation-zigbee-avec-home-assistant-jeedom/

r0m1CH, 2023-03-10:
Bonjour,
J'ai un souci similaire il me semble.
Je suis passé en standard récemment (y'a un ou deux jours) et depuis je n'ai plus les valeurs "standards"
UMOY1, URMS1... mais j'ai pleins d'autres trucs.

J'ai tenté de réappareiller, de redémarrer Z2M... rien n'y fait.

Je suis en tempo mais je sais pas ce qu'il me manque.

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

Une idée ?

r0m1CH, 2023-03-10:
Bon je viens de relancer Z2M après avoir forcé les paramètres Standard + 1 phase + pas de production.
J'ai des infos en plus mais pas les bonnes:

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

Je sais vraiment pas ce que je fais de mal.

fairecasoimeme, 2023-03-13:
Quel est le LQI du ZLinky ?

r0m1CH, 2023-03-13:
Il oscille entre 127 et 180.

fairecasoimeme, 2023-03-13:
Pouvez-vous générer un schéma réseau et partager ?

r0m1CH, 2023-03-13:
C'est un peu brouillon mais ça donne ça:
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

r0m1CH, 2023-03-16:
Une idée de ce qui me manque ?

r0m1CH, 2023-03-16:
Bon je crois que j’ai trouvé mon souci.

Mon Linky était repassé en mode historique sans raison particulière (peut être le changement de provider)
Il a fallu donc rebasculer en mode standard puis:

Reconfiguration de la clé Lixee dans Zigbee2Mqtt
Redémarrage de Zigbee2Mqtt
Forcer le mode standard dans la conf Zigbee2Mqtt (le mode auto n’a semble-t-il pas fonctionné)
Redémarrage de Zigbee2Mqtt
Au bout de 4/5 minutes après le rédémarrage j’ai retrouvé mes valeurs habituelles (Tension, intensité…).

Je pense qu’il est possible de reconfigurer la clé + changer le mode standard en une action mais je vous décris ce que j’ai fait si jamais ça peut en aider un.

Bon courage !

kimizz59, 2024-11-14:
Je vois que cette issue est toujours open
De mon côté j'avais fait les MAJ OTA (je ne sais pas si c'est lié)
J'ai fait des tests avec le propriétaire du dongle, celui-ci a été changé et cela fonctionne maintenant correctement.
Je ne lance plus les MAJ OTA depuis, je ne sais pas si c'était lié

Closed 2024-11-14.

Thread 157 (2022-12-30):

ZLinky not answering to a Node Descriptor request

pipiche38, 2022-12-30:
in the here attached sniff, I have tried several time nto req a Node Descriptor, but didn't get a single response

ZLinky nwkid : 0x2a7e
Transaction Key: b0a07a5cb2f25e59f271cbedfa13a4f5

[ZLINKY-not-answering-node-descriptor.pcapng.zip](https://github.com/fairecasoimeme/Zlinky_TIC/files/10323950/ZLINKY-not-answering-node-descriptor.pcapng.zip)

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

pipiche38, 2022-12-30:
Wrong Ep used

Closed 2022-12-30.

Thread 165 (2023-01-18):

Stabilité Zlinky Lixee - Multiples appairages et pertes de signal.

HpNoTiQ56, 2023-01-18:
Bonjour,
J'utilise le Zlinky chez moi depuis le début de la semaine sur une VM linux avec Zigbee2MQTT. Je récupère ensuite les infos sur HA avec Z2M Proxy.

1er appairage réussi du premier coup. Après la première nuit, plus de connexion et perte de l'historique.
Désappairage et réappairage au bout de plus de 10 essais, cela a marché 36h et reperte des signaux depuis midi 👍
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
Ce soir, nouvel tentatives de désappairage/réappairage plus d'une dizaine de fois et un dernier interview qui fonctionne mais qui n'a duré que quelques secondes.
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

Dois-je renvoyer mon module à votre avis?

Ma configuration :
- Linky dans la rue dans coffret.
- Clé conbee II sur VM Debian + Z2M sur Freebox Delta (mes autres périphériques Zigbee fonctionnent sans coupure). à 7m du compteur.

J'ai pu faire la mise à jour OTA vers la version 12 avant hier.

fairecasoimeme, 2023-01-19:
Dans un premier temps, il faut regarder le LQI de l'appareil. Avez-vous la version avec antenne externe ? Cela ressemble à un problème de portée.
Ensuite sur Z2M, il semble qu'après une mise à jour, il faut redémarrer Z2M et réappairer l'appareil.

HpNoTiQ56, 2023-01-19:
Le LQI était entre 190 et 255 quand cela marchait. En fonction des appairages, j'ai entre 50 et 190 mais je n'arrive pas à stabiliser la connection.
J'ai la version sans antenne. J'ai bien déjà fait toutes les manips sur Z2M.
Est-il possible de faire un hard reset pour réinitialiser les paramètres du module?

fairecasoimeme, 2023-01-19:
Bizarre cette chute de LQI, la mise à jour n'intervient pas du tout sur ce point. un LQI entre190 et 255, c'est quand l'appareil zigbee est collé à la passerelle ou un routeur...N'y a-t-il pas eu des modifs du réseau zigbee ?

le hard reset se fait lorsque l'on appuie 10 sec sur le bouton Link.

tex0l, 2023-01-20:
J'ai un comportement similaire après màj OTA de 4000-0011 vers 4000-0012 avec ZHA (je n'avais jamais eu de souci de ce type avant, et cela fait plusieurs mois que je l'ai):
- toutes les valeurs ont freezé d'un coup quelque temps après la màj OTA;
- la connexion était hachée (càd que les graphs affichent la valeur freezée par intermittence — je n'ai plus les graphiques puisque j'ai supprimé le Zlkiny et que je l'ai ajouté à nouveau);
- j'ai tenté de reconfigurer l'appareil via ZHA, ça n'a pas fonctionné et a présenté des erreurs;
- j'ai physiquement débranché le zlinky, attendu 10s, je l'ai rebranché;
- j'ai retenté de reconfigurer l'appareil via ZHA, ça a fonctionné;
- 4-5h après ça s'est retrouvé dans le même état qu'après la màj OTA à nouveau;
- j'ai débranché et rebranché sans attendre puis tenté de reconfigurer, ça n'a pas fonctionné;
- j'ai supprimé le ZLinky du réseau, je l'ai débranché, je l'ai rebranché sans attendre, j'ai appuyé sur le bouton de reset pendant 10s (ça a bien éteint la lumière bleue puis l'a rallumée), la procédure d'installation a freezé en plein milieu;
- je l'ai débranche, attendu 10s, rebranché, appuyé sur le bouton reset 10s et l'ai ajouté au réseau, cela fonctionne et tient depuis 9h30 ce matin (soit il y a 3h).

J'ai un réseau avec beaucoup d'appareils, donc je vais tenter de passer au firmware limited, mais je n'ai pas module USB-TTL, j'en ai commandé un.

HpNoTiQ56, 2023-01-20:
Pour ma part, j'ai tout essayé : ma passerelle étant une conbee II fraichement acheté, je la renvoie au profit d'une Sonoff avec antenne.
J'essaierais aussi avec une rallonge et la box à quelques cm !

HpNoTiQ56, 2023-01-21:
Nouvelle tentative hier soir après une deconnection du module de plus de 24h!
Appairage instantané et LQI entre 255 & 180. J'espère que ca va perdurer!
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

fredleger, 2023-01-21:
idem impossible de l'appairer après la mise à jour en 4000-0012 sur zigbee2mqtt. Tout marchait bien avant la mise à jour.
Je met une lampe philips hue avec une rallonge a 10 cm du compteur pile en face porte ouverte. La lampe a un très bon LQI et pas moyen de voir la clé lixee.

tex0l, 2023-02-02:
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

Je n'ai plus eu de souci d'appairage depuis la dernière opération décrite dans ce post, je n'ai pas changé le firmware vers le no-router.

KipK, 2023-03-01:
Module neuf ici, j'en ai pris un deuxieme pour être sûr.
Sous firmware v13 Limited, le module se deconnecte tout seul après plusieurs heures comme avec le modle précédent ( qui fonctionne parfaitement en firmware v9 )
La Led bleu reste allumée en permanence quand je retrouve le module deconnecté.
 il ne revient pas sur le réseau une fois dans cet état , sauf après un power cycle.

fairecasoimeme, 2023-03-01:
Si tu as le module USB TTL, peux tu passer en version "legacy" (mise à jour non-OTA) sur le dernier module ? (Normalement la mise à jour est plus simple car il n'y a pas de PAD mais des trous). J'avais repéré chez un autre utilisateur un problème de routage qui bloque les envois / réception

KipK, 2023-03-01:
il me semble avoir eu le meme soucis avant en firmware normal sur la V12 et V13, puis avoir reswitché en V9 no router.
Je viens de switcher sur la V10 pour voir je vais monter de version par étape voir quand ca cloche.
Quand je regarde sous Deconz le graph, je vois pleins d'appareils qui affichent quand même une route possible par le module, en mode Limited.
En fait idéalement il faudrait un firmware pour que l'appareil soit reconnu comme vrai end point et non routeur ( même limité ) . Quitte a simuler une batterie en envoyant la tension 3.3v vu que ca à l'air dans les specs.

fairecasoimeme, 2023-03-03:
Étrange que vous ayez le même problème avec la V13 legacy. En mode limited, normalement, il y a 1-2 routes possibles.
J'ai déjà fait énormément de tests en mode ZED et ce n'est pas du tout concluant ou adapté au besoin.
Si vous pouvez mettre un ordinateur à portée du Linky, je peux vous proposer une version du ZLinky de test qui permettra de capturer ce qui se passe et mieux comprendre ce qui bloque chez vous.

KipK, 2023-03-03:
Depuis le passage en v10 plus de deconnection pour l'instant ( avec la 13 je recevait qd meme des messages de jeedom qui m'indiquait la deco / reco du module. En general quand ca commencait comme ça dans les heures qui suivent il était out.
Pas encore essayé la 11.
Contrairement au soucis que j'avais eu au tout debut avec le module qui finissait avec la LED etteinte, maintenant quand il est injoignable, la led reste allumée pour info mais constante, sans aucune modulation rapide comme quand ca fonctionne. C'est peut être un nouveau problème.

Je veux bien le firmware mais je peux le flasher OTA ? Je peux editer les n: de versions des fichiers ota facilement depuis le client Deconz, ce qui me permet de downgrader.

fairecasoimeme, 2023-03-03:
Quand je parlais de la V13 c'est la version legacy que vous devez faire non OTA.
Pour la version que je vous propose c'est une version hardware avec un module USB TTL.

KipK, 2023-03-03:
Oui j'ai bien compris, mais je vais éviter là car je n'ai qu'un module et si il se passe quelque chose au flashage je vais me retrouver sans délestage. Et vu le froid en ce moment. :)
Je vais peut être pouvoir récupérer un deuxième ce qui me permettra de tester ça correctement.
pour le module TTL , ça va être compliqué en l'état de l'installation. Mon Compteur est dans une pièce sans prise electrique, difficile de laisser meme un raspberry pi branché en permanence.
Mais j'ai une batterie qui me permet de le faire tourner une dizaine d'heures, ca ppourrait être suffisant.

fairecasoimeme, 2023-03-03:
Pourtant, je pense sincèrement que votre problème peut provenir de la version "limited". J'ai eu un cas similaire au votre où le blocage provenait de là. Pour votre confort, je peux vous envoyer un autre ZLinky avec le firmware V13 legacy. Une fois vos tests effectués, vous me renvoyer l'autre.
Pour cela envoyer moi plutôt un mail : contact[at]lixee.fr

KipK, 2023-03-03:
J'ai déjà testé avec le firmware normal sur le module précédent. C'est comme ça d'ailleurs que je l'ai probablement flingué en voulant mettre le limited pour tester.

Mais c'est gentil de proposer je peux retester avec un autre module oui.
En attendant je continue mon test de remontée de version tout les 3j si ca tiens.
Je suis à la l'aise avec les procédures de flash mais vu l'expérience précédente et les conséquences quand j'ai plus la teleinfo ( chauffage electrique et chargeur VE 32A ) , je préfère pas tenter :)

KipK, 2023-03-10:
Alors plutôt bonne nouvelle, j'ai continué ma remontée en version ( toujours en limited ), et finalement sur la 13 sans soucis deplus plus de 48h ce qui n'était pas arrivé jusque là avec cette version.

Depuis j'ai changé quelques trucs sur le ddf de deconz, réappairé complètement ( d'ailleurs le passage de v11 à v12ou13  oblige un rappairage complet sinon beaucoup de soucis j'en ai fais les frais, ce n'était pas le cas sur les autres montées en version. ) , viré des propriétés dont je me servais pas. On va voir comment ça tiens.

 @fairecasoimeme , j'ai une idée pour simplifier le passage de limited vers normal et vis versa.

Il faudrait 2 images spéciales qui permettrait de faire la transition:
- de Limited vers Normal:  une image en image_type 2 avec une version à 0, packagée ota comme un n: de version qui sera toujours plus elevé que les versions à venir , mais qui une fois installée demandera en ota une image_type 1.
Il ne suffira qu'à refaire une ota avec l'image type 1 souhaitée.

-de normal vers limited: image_type 1, version compilé sur 0, version dans le package ota sur 65534, demande en ota image_type 2.

Avec ces 2 images ça permettrait de switcher d'un type à l'autre sans avoir à flassher ttl.

Bazarov42, 2023-03-14:
J'ai aussi des pertes et ré-appairage "sauvage", ça doit faire 2-3 semaines que je n'arrivais pas à appairer et la en revenant de la balade du chien, pouf c'est revenu ^^

J'ai ajouté une prise zigbee à côté pour améliorer le lien comme mon répéteur n'a pas l'air de plaire au Zlinky
La prise et le répéteur son à la même distance du Zlinky il doit y avoir 20 cm de différence.

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

Bazarov42, 2023-03-20:
Pour ma part, tout refonctionne et ça a l'air de tenir, j'ai eu quelques décrochage et à force de redémarrer le module, redémarrer le système c'est revenu

antoinelibert, 2023-03-20:
De mon côté (et pour la première fois), je suis en V12 depuis sa sortie (nov 22) et je n'ai eu aucune coupure depuis. Maintenant, j'hésite à mettre à jour ... 😅

HpNoTiQ56, 2023-03-22:
Première coupure depuis mon dernier post : freeze jusqu'à débranchement/rebranchement sur le compteur !

Thread 166 (2023-01-19):

ZLinky ne s'allume pas [résolu par remplacement]

bosr, 2023-01-19:
Bonjour,

J'ai reçu mon ZLinky la semaine dernière, et je l'ai branché ce matin pour la première fois : la led ne s'allume pas, et il ne veut pas s'appairer. J'ai tenté aussi de le réinitialiser. Que puis-je faire d'autre ?

J'ai également envoyé cette info avec mon num de commande sur contact@....fr

Merci !

bosr, 2023-01-19:
Merci pour les échanges par mail. Pour l'instant, le problème semble dû à l'alimentation de mon Linky (Sagem) : la tension à vide est de 1 Vrms au lieu de 13 Vrms.

Je mettrai à jour quand j'aurai plus d'infos.

fsegouin, 2023-01-24:
@bosr J'ai le meme soucis, as-tu trouve l'origine du probleme ? Merci !

bosr, 2023-01-24:
Salut, le problème n'est pas encore résolu. Voilà où j'en suis :

- J'ai contacté Enedis, qui m'a demandé de contacter mon fournisseur (EDF) pour faire activer le mode standard : c'est la demande F185 (note ça car EDF n'a pas l'habitude de faire cette demande et j'ai dû faire une petite partie de ping-pong avec eux et Enedis).
- EDF a effectué la demande auprès d'Enedis, et Enedis s'est exécuté dès le lendemain à distance.
- Le tableau de mon compteur linky indique bien désormais "Mode standard TIC", mais comme prédit par @fairecasoimeme (via mail), ça n'a rien changé à la tension d'alim entre I1 et A
- J'ai recontacté Enedis pour indiquer le problème, et rebelote, ils m'ont indiqué devoir passer par EDF pour faire une demande F920 afin de dépêcher un technicien à mon domicile.
- Je me suis exécuté, et je sais qu'Enedis a bien reçu cette demande, et j'attends l'appel de leur tech pour prendre rdv.

Pour l'instant, je dirais que les conseillers Enedis et EDF sont sympas, mais c'est un peu galère car ils n'ont pas l'habitude de la demande de passage en mode standard (rarissime) et le problème d'alim est également très rare.

Voilà pour l'instant !

bosr, 2023-01-24:
Je note tout cela ici afin d'aider ceux qui auraient un pb similaire, et à terme permettre d'améliorer la section dépannage de la doc. Et pour que ce soit bien clair, à ce stade, je n'ai aucune raison de penser que le ZLinky soit en cause. Je vais modifier le titre d'ailleurs.

bosr, 2023-02-17:
Bonjour,

Enedis a changé mon compteur la semaine dernière, mais le ZLinky ne s'allumait toujours pas, donc @fairecasoimeme a procédé à un échange. Le nouveau ZLinky, reçu hier, fonctionne très bien.

Pour info, c'est un peu la honte, mais bon, j'avais mesuré la tension RMS entre I1 et A avec un multimètre, et évidemment ça ne peut pas retourner une mesure correcte étant donné que la fréquence de la porteuse de ce signal (50 kHz) est bien supérieure à la bande passante du multimètre. Donc, évitez de perdre du temps avec cette mesure naïve, et procédez à un échange. Cela évitera aussi de faire perdre du temps à Énedis ;)

Bonne continuation !

Closed 2023-02-17.

Thread 173 (2023-02-04):

Incohérence lixee_zlinky_tic_tier_1_summation_delivered : données qui ont diminué

luke7101, 2023-02-04:
Bonjour, en observant l'entité `sensor.lixee_zlinky_tic_tier_1_summation_delivered` introduite avec la nouvelle version 2023.2 de Home Assistant je me suis rendu compte de l'incohérence suivante dans l'historique.
Etant donné que je copie le contenu dans un sensor dont la classe est "total_increasing" j'ai eu l'erreur suivante dans les logs :
`WARNING (Recorder) [homeassistant.components.sensor.recorder] Entity sensor.lixee_zlinky_tic_metering_hc from integration template has state class total_increasing, but its state is not strictly increasing. Triggered by state 14705117 (14705.127) with last_updated set to 2023-02-03T23:55:08.303052+00:00. Please create a bug report at https://github.com/home-assistant/core/issues?q=is%3Aopen+is%3Aissue+label%3A%22integration%3A+template%22`

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

fairecasoimeme, 2023-02-06:
Difficile de dire d'où ça peut venir mais côté ZLinky, il n'y a aucun traitement d'effectué sur les données du Linky. Peut-être regarder s'il n'y a pas un arrondi qui est fait mais très probablement côté HA

luke7101, 2024-01-22:
Oui en effet c'était bien un capteur qui effectuait un calcul arrondi, merci.

Closed 2024-01-22.

Thread 174 (2023-02-05):

HomeAssistant - base de données remplie à cause d'extra_states_attributes

helepeut, 2023-02-05:
Bonjour,

Je vous écris car j'ai actuellement un soucis en cours de résolution avec bdraco, qui travaille sur la partie MariaDB de HomeAssistant.
Depuis quelques temps, j'ai d'énormes lenteurs dans la purge des données d'historique.

En regardant de plus prêt, il semblerait qu'il y ait un soucis avec la quantité de données remontées par le ZLinky_TIC (possiblement en mode PRODUCTION).

bdraco me demande de contacter le développeur de l'intégration - je ne sais pas si c'est à vous que je dois m'adresser, de ce fait j'ai aussi laissé un message à l'équipe Zigbee2MQTT que j'utilise pour remonter les données du ZLinky_TIC. En espérant que cela puisse faire avancer la science !

Le message de bdraco  est le suivant :

_Please send a note to the dev that develops that integration

https://developers.home-assistant.io/docs/core/entity#generic-properties

DANGER
Entities that generate a significant amount of state changes can quickly increase the size of the database when the extra_state_attributes also change frequently. Minimize the number of extra_state_attributes for these entities by removing non-critical attributes or creating additional sensor entities._

Le thread concernant le problème en question : https://github.com/home-assistant/core/issues/87352
La discussion ouverte avec Z2M : https://github.com/Koenkk/zigbee2mqtt/discussions/16549

fairecasoimeme, 2023-02-06:
@vk496 did you see this issue. What do you think ?

vk496, 2023-02-06:
yes, this is a well-known issue. That's why I created a kind of "filters" to not expose attributes that doesn't make sense with your current tarif. My advice for this issue:

- Select the proper linky_mode, phase, production in Z2M
- Select a tarif or which attributes you want with tic_command_whitelist (extra options Z2M)
- Adjust the minimum time for notifications for zlinky in Z2M
- Restart Z2M to take effect

The first two points can be replaced with disabling the entities from Home Assistant (I would personally do both, just in case)

helepeut, 2023-02-06:
Thanks !
This is more or less what I did early January when I saw the quantity of messages and attributes that were surfacing. So I decided to just keep the 2 attributes I wanted for my Production Linky (using the whitelist). But the database was already filled with these data, and I can't purge it in reasonable time.
Bdraco used this database to update the db optimizer (I guess for a next release), and he just pointed me this warning in order to send it back to you.
It might be worth adding this warning in the documentation ?

ellmout, 2023-07-12:
Hello @BrunoSpy,
In Z2M, in Settings, Home Assistant Integration, disable "Home Assistant legacy entity attributes".
When enable :
```
  # Optional: Home Assistant legacy entity attributes, (default: shown below), when enabled:
  # Zigbee2MQTT will send additional states as attributes with each entity. For example,
  # A temperature & humidity sensor will have 2 entities for the temperature and
  # humidity, with this setting enabled both entities will also have
  # an temperature and humidity attribute.
```

BrunoSpy, 2023-07-12:
Thank you. That was well hidden :)

Thread 175 (2023-02-07):

Aucune Remontée suite à l'achat d'un Zlinky

mattzeer, 2023-02-07:
Hello Suite à l'achat d'un Zlkiny, je n'ai aucune informations de la consommation qui remontent

J'ai mis à jour le firmware vers la dernière version (4000-0012)
Mon linky est en TIC Standard (ce qui a été changé dans les paramètres du zlinky)

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

Y a t-il un réglage qui me manque ou quelque chose que j'ai mal configuré ?

fairecasoimeme, 2023-02-07:
Bonjour,

Il y a des informations qui ont été remontées, du coup, il faut verifier les logs pour voir s'il y a des timeouts ou s'il manque des demande d'informations. Le LQI est assez faible donc à vérifier

mattzeer, 2023-02-10:
Hello,

Voici le genre de log que j'ai lié au zlinky en  DEBUG
[zlinky.log](https://github.com/fairecasoimeme/Zlinky_TIC/files/10706446/zlinky.log)

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

nerthazrim, 2023-03-24:
Bonjour @mattzeer, as-tu trouvé la source de ton problème ?

J'ai réussi à appairer mon Zlinky_TIC tout neuf avec mon install Home Assistant + Zigbee2MQTT sur RPI3 mais j'ai un rendu similaire au tiens dans les données remontées par le Zlinky.

Etonnamment j'ai bien EASF01 de populée.
Par contre, impossible d'avoir autre chose que 0 kWh sur EASD01, qui devrait contenir ma conso instantanée, si j'ai bien suivi ?

A noter que je suis en Standard BASE, monophasé sans production

Iwhite67, 2023-06-02:
Hello, j'ai le meme style de probleme sous jeedom

`4959|[2023-06-02 22:41:46][DEBUG] : http://127.0.0.1:8089/device/attributes type : POST
4960|[2023-06-02 22:41:46][DEBUG] : {"ieee":"00:15:8d:00:05:d2:a9:0a","endpoint":1,"cluster":1794,"cluster_type":"in","attributes":[0,256,258,260,262,264,266],"allowCache":0}
4961|[2023-06-02 22:41:50][INFO] : [Maison][LiXee.ZLinky_TIC 00:15:8d:00:05:d2:a9:0a] Erreur lors de la requete : http://127.0.0.1:8089/device/attributes(POST), data : {"ieee":"00:15:8d:00:05:d2:a9:0a","endpoint":1,"cluster":1794,"cluster_type":"in","attributes":[0,256,258,260,262,264,266],"allowCache":0} erreur : {"state":"error","result":"[0x54d8:1:0x0702]: Message send failure","code":0}
4962|[2023-06-02 22:41:50][DEBUG] : http://127.0.0.1:8089/device/attributes type : POST
4963|[2023-06-02 22:41:50][DEBUG] : {"ieee":"00:15:8d:00:05:d2:a9:0a","endpoint":1,"cluster":1794,"cluster_type":"in","attributes":[32],"allowCache":0}
4964|[2023-06-02 22:41:55][INFO] : [Maison][LiXee.ZLinky_TIC 00:15:8d:00:05:d2:a9:0a] Erreur lors de la requete : http://127.0.0.1:8089/device/attributes(POST), data : {"ieee":"00:15:8d:00:05:d2:a9:0a","endpoint":1,"cluster":1794,"cluster_type":"in","attributes":[32],"allowCache":0} erreur : {"state":"error","result":"[0x54d8:1:0x0702]: Message send failure","code":0}
4965|[2023-06-02 22:41:55][DEBUG] : http://127.0.0.1:8089/device/attributes type : POST
4966|[2023-06-02 22:41:55][DEBUG] : {"ieee":"00:15:8d:00:05:d2:a9:0a","endpoint":1,"cluster":2820,"cluster_type":"in","attributes":[1288,2312,2568,1290,2314,2570,1293],"allowCache":0}
4967|[2023-06-02 22:41:59][INFO] : [Maison][LiXee.ZLinky_TIC 00:15:8d:00:05:d2:a9:0a] Erreur lors de la requete : http://127.0.0.1:8089/device/attributes(POST), data : {"ieee":"00:15:8d:00:05:d2:a9:0a","endpoint":1,"cluster":2820,"cluster_type":"in","attributes":[1288,2312,2568,1290,2314,2570,1293],"allowCache":0} erreur : {"state":"error","result":"[0x54d8:1:0x0b04]: Message send failure","code":0}
4968|[2023-06-02 22:41:59][DEBUG] : http://127.0.0.1:8089/device/attributes type : POST
4969|[2023-06-02 22:41:59][DEBUG] : {"ieee":"00:15:8d:00:05:d2:a9:0a","endpoint":1,"cluster":2820,"cluster_type":"in","attributes":[1295],"allowCache":0}
4970|[2023-06-02 22:41:59][DEBUG] : http://127.0.0.1:8089/device/attributes type : POST
4971|[2023-06-02 22:41:59][DEBUG] : {"ieee":"00:15:8d:00:05:d2:a9:0a","endpoint":1,"cluster":1794,"cluster_type":"in","attributes":[0,256,258,260,262,264,266],"allowCache":0}
4972|[2023-06-02 22:42:04][INFO] : [Maison][LiXee.ZLinky_TIC 00:15:8d:00:05:d2:a9:0a] Erreur lors de la requete : http://127.0.0.1:8089/device/attributes(POST), data : {"ieee":"00:15:8d:00:05:d2:a9:0a","endpoint":1,"cluster":2820,"cluster_type":"in","attributes":[1295],"allowCache":0} erreur : {"state":"error","result":"[0x54d8:1:0x0b04]: Message send failure","code":0}
4973|[2023-06-02 22:42:04][DEBUG] : http://127.0.0.1:8089/device/attributes type : POST
4974|[2023-06-02 22:42:04][DEBUG] : {"ieee":"00:15:8d:00:05:d2:a9:0a","endpoint":1,"cluster":65382,"cluster_type":"in","attributes":[1,2,4,5,6,7,8],"allowCache":0}
4975|[2023-06-02 22:42:08][INFO] : [Maison][LiXee.ZLinky_TIC 00:15:8d:00:05:d2:a9:0a] Erreur lors de la requete : http://127.0.0.1:8089/device/attributes(POST), data : {"ieee":"00:15:8d:00:05:d2:a9:0a","endpoint":1,"cluster":1794,"cluster_type":"in","attributes":[0,256,258,260,262,264,266],"allowCache":0} erreur : {"state":"error","result":"[0x54d8:1:0x0702]: Message send failure","code":0}
4976|[2023-06-02 22:42:08][DEBUG] : http://127.0.0.1:8089/device/attributes type : POST
4977|[2023-06-02 22:42:08][DEBUG] : {"ieee":"00:15:8d:00:05:d2:a9:0a","endpoint":1,"cluster":1794,"cluster_type":"in","attributes":[32],"allowCache":0}
4978|[2023-06-02 22:42:13][INFO] : [Maison][LiXee.ZLinky_TIC 00:15:8d:00:05:d2:a9:0a] Erreur lors de la requete : http://127.0.0.1:8089/device/attributes(POST), data : {"ieee":"00:15:8d:00:05:d2:a9:0a","endpoint":1,"cluster":65382,"cluster_type":"in","attributes":[1,2,4,5,6,7,8],"allowCache":0} erreur : {"state":"error","result":"[0x54d8:1:0xff66]: Message send failure","code":0}
4979|[2023-06-02 22:42:17][INFO] : [Maison][LiXee.ZLinky_TIC 00:15:8d:00:05:d2:a9:0a] Erreur lors de la requete : http://127.0.0.1:8089/device/attributes(POST), data : {"ieee":"00:15:8d:00:05:d2:a9:0a","endpoint":1,"cluster":1794,"cluster_type":"in","attributes":[32],"allowCache":0} erreur : {"state":"error","result":"[0x54d8:1:0x0702]: Message send failure","code":0}
4980|[2023-06-02 22:42:17][DEBUG] : http://127.0.0.1:8089/device/attributes type : POST
4981|[2023-06-02 22:42:17][DEBUG] : {"ieee":"00:15:8d:00:05:d2:a9:0a","endpoint":1,"cluster":2820,"cluster_type":"in","attributes":[1288,2312,2568,1290,2314,2570,1293],"allowCache":0}
4982|[2023-06-02 22:42:22][INFO] : [Maison][LiXee.ZLinky_TIC 00:15:8d:00:05:d2:a9:0a] Erreur lors de la requete : http://127.0.0.1:8089/device/attributes(POST), data : {"ieee":"00:15:8d:00:05:d2:a9:0a","endpoint":1,"cluster":2820,"cluster_type":"in","attributes":[1288,2312,2568,1290,2314,2570,1293],"allowCache":0} erreur : {"state":"error","result":"[0x54d8:1:0x0b04]: Message send failure","code":0}
4983|[2023-06-02 22:42:22][DEBUG] : http://127.0.0.1:8089/device/attributes type : POST
4984|[2023-06-02 22:42:22][DEBUG] : {"ieee":"00:15:8d:00:05:d2:a9:0a","endpoint":1,"cluster":2820,"cluster_type":"in","attributes":[1295],"allowCache":0}
4985|[2023-06-02 22:42:26][INFO] : [Maison][LiXee.ZLinky_TIC 00:15:8d:00:05:d2:a9:0a] Erreur lors de la requete : http://127.0.0.1:8089/device/attributes(POST), data : {"ieee":"00:15:8d:00:05:d2:a9:0a","endpoint":1,"cluster":2820,"cluster_type":"in","attributes":[1295],"allowCache":0} erreur : {"state":"error","result":"[0x54d8:1:0x0b04]: Message send failure","code":0}
4986|[2023-06-02 22:42:26][DEBUG] : http://127.0.0.1:8089/device/attributes type : POST
4987|[2023-06-02 22:42:26][DEBUG] : {"ieee":"00:15:8d:00:05:d2:a9:0a","endpoint":1,"cluster":65382,"cluster_type":"in","attributes":[1,2,4,5,6,7,8],"allowCache":0}
4988|[2023-06-02 22:42:31][INFO] : [Maison][LiXee.ZLinky_TIC 00:15:8d:00:05:d2:a9:0a] Erreur lors de la requete : http://127.0.0.1:8089/device/attributes(POST), data : {"ieee":"00:15:8d:00:05:d2:a9:0a","endpoint":1,"cluster":65382,"cluster_type":"in","attributes":[1,2,4,5,6,7,8],"allowCache":0} erreur : {"state":"error","result":"[0x54d8:1:0xff66]: Message send failure","code":0}
4989|[2023-06-02 22:42:55][DEBUG] : http://127.0.0.1:8089/device/info?ieee=00%3A15%3A8d%3A00%3A05%3Ad2%3Aa9%3A0a type : GET
4990|[2023-06-02 22:42:55][DEBUG] : {"ieee":"00:15:8d:00:05:d2:a9:0a"}
4991|[2023-06-02 22:45:05][DEBUG] : http://127.0.0.1:8089/device/attributes type : POST
4992|[2023-06-02 22:45:05][DEBUG] : {"ieee":"00:15:8d:00:05:d2:a9:0a","endpoint":1,"cluster":1794,"cluster_type":"in","attributes":[0,256,258,260,262,264,266],"allowCache":0}
4993|[2023-06-02 22:45:11][INFO] : [Maison][LiXee.ZLinky_TIC 00:15:8d:00:05:d2:a9:0a] Erreur lors de la requete : http://127.0.0.1:8089/device/attributes(POST), data : {"ieee":"00:15:8d:00:05:d2:a9:0a","endpoint":1,"cluster":1794,"cluster_type":"in","attributes":[0,256,258,260,262,264,266],"allowCache":0} erreur : {"state":"error","result":"[0x54d8:1:0x0702]: Message send failure","code":0}
4994|[2023-06-02 22:45:11][DEBUG] : http://127.0.0.1:8089/device/attributes type : POST
4995|[2023-06-02 22:45:11][DEBUG] : {"ieee":"00:15:8d:00:05:d2:a9:0a","endpoint":1,"cluster":1794,"cluster_type":"in","attributes":[32],"allowCache":0}
4996|[2023-06-02 22:45:17][INFO] : [Maison][LiXee.ZLinky_TIC 00:15:8d:00:05:d2:a9:0a] Erreur lors de la requete : http://127.0.0.1:8089/device/attributes(POST), data : {"ieee":"00:15:8d:00:05:d2:a9:0a","endpoint":1,"cluster":1794,"cluster_type":"in","attributes":[32],"allowCache":0} erreur : {"state":"error","result":"[0x54d8:1:0x0702]: Message send failure","code":0}
4997|[2023-06-02 22:45:17][DEBUG] : http://127.0.0.1:8089/device/attributes type : POST
4998|[2023-06-02 22:45:17][DEBUG] : {"ieee":"00:15:8d:00:05:d2:a9:0a","endpoint":1,"cluster":2820,"cluster_type":"in","attributes":[1288,2312,2568,1290,2314,2570,1293],"allowCache":0}
4999|[2023-06-02 22:45:18][ERROR] : Le module [Maison][LiXee.ZLinky_TIC 00:15:8d:00:05:d2:a9:0a] n\'a pas envoyé de message depuis plus de 1440 min`

fairecasoimeme, 2023-06-05:
Bonjour,

Si le ZLinky n'est pas accessible, c'est soit qu'il n'est pas appairé, soit qu'il y a des problèmes de portée dû à ma distance ou interférences

Iwhite67, 2023-06-05:
Bonjour, justement, il est accessible car il répond, j'ai juste pas les remontées

fairecasoimeme, 2023-06-05:
Sauf erreur, d'après les logs, il n'a pas l'air de répondre

Coldness00, 2024-04-14:
Bonjour,
Je @mattzeer il semblerait que j'ai un soucis similaire.
Suite a un changement de fournissseur j'ai quelques de remontees de valeurs (PMR, heure, Traf, message, etc), sauf ma consommation d'energie.
As-tu trouve une solution?
Merci

MilesTEG1, 2024-04-15:
Bonjour,
Une potentielle piste serait de vérifier les paramètres dans Z2M, qu'ils correspondent bien aux caractéristiques de l'abonnement : standard ou historique , tarif tempo ou autre , etc.
Dès qu'un paramètre est modifié , il faut redémarrer Z2M. Et être patient pour que les données remontent.
À mon passage de historique à standard , j'ai cru que j'avais un module défaillant, mais j'ai enfin eu les remontées quelques heures après le redémarrage de Z2M.

Coldness00, 2024-04-28:
@mattzeer
Regarde sur ce post. J ai réussi a solutionner mon soucis.
https://github.com/fairecasoimeme/Zlinky_TIC/issues/256

Thread 177 (2023-02-08):

Problème remontée valeur nulle BBRHPJR - Option Tempo

antoineguilbert, 2023-02-08:
Bonjour,

Je suis passé en début de semaine de l'abonnement HP/HC de Total Energies à l'abonnement Tempo chez EDF.
J'ai bien changé la configuration sur les paramétrage de Zlinky sur Zigbee2MQTT mais je reste toujours avec des "sans valeur" sur mes nouveaux index à savoir par exemple : BBRHPJR

En revanche, cela fonctionne bien pour BBRHCJB ou encore BBRHPJB. J'ai bien également le PTEC qui remonte avec "HPJR".

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

Voici ce que cela donne au niveau de mon relevé Linky. Note que jusqu'à aujourd'hui, ma valeur de BBRHPJR était à 0kWh commençant mon abonnement mais je viens de passer à 1kWh je pense donc que cela aurait du se mettre à jour ?

{
    "active_register_tier_delivered": "HPJR",
    "apparent_power": 400,
    "available_power": 30,
    "current_summ_delivered": 0,
    "current_tarif": "BBR(",
    "current_tier1_summ_delivered": 12175.8,
    "current_tier2_summ_delivered": 492.1,
    "linkquality": 255,
    "meter_serial_number": "XXXXXXXX",
    "rms_current": 2,
    "rms_current_max": 90,
    "schedule_h_p_h_c": 0,
    "update": {
        "installed_version": 12,
        "latest_version": 12,
        "state": "idle"
    },
    "update_available": false,
    "warn_d_p_s": 0,
    "current_tier3_summ_delivered": null,
    "current_tier4_summ_delivered": null,
    "current_tier5_summ_delivered": null,
    "current_tier6_summ_delivered": null,
    "start_notice_e_j_p": null,
    "tomorrow_color": null
}

Et la version de mon firmware : 4000-0012

Merci par avance 👍

pipiche38, 2023-02-08:
peut-etre faut-il attendre de passer en jour Blanc et Rouge pour que ca s'initialise

antoineguilbert, 2023-02-08:
Sachant que pour récap :

- Jour bleu : ça a bien fonctionné
- Jour blanc : pas encore eu
- Jour rouge : KO pour le moment

cmer81, 2023-02-10:
Bonjour @antoineguilbert,

J'ai eu le même problème aujourd'hui (Avec le tarif BBRHCJB et BBRHPJB ) suite à mon changement d'offre de BASE a Tempo effectuer hier.
Je voulais également partager avec vous que j'ai réussi à fixer le problème en supprimant complètement le ZLinky device de Zigbee2mqtt et également les ressources dans Home Assistant. Je sais que cela peut ne pas être la solution pour tout le monde, mais cela a fonctionné pour moi.

Maintenant, j'attends de voir si le problème sera le même lors de passage en jour blanc ou rouge. Je pense que la cause pourrait peut-être être due à un index de consommation à zéro. 🤔

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

J'espère que la solution sera trouvée rapidement.

antoineguilbert, 2023-02-11:
Je confirme la résolution de @cmer81, j'ai pour ma part redémarré plusieurs fois Zigbee2MQTT et il a fini par récupérer les nouvelles valeurs. C'est ok !

Merci

Closed 2023-02-11.

Thread 179 (2023-02-08):

Remontées figéees depuis 3 jours

Patoche781, 2023-02-08:
Bonjour.
Ma configuration :
HA 2023.2.3 + Sup 2023.01.1 +OS 9.5 + UI 20230202 + Z2M sous Proxmox sur Celeron 8Go de Ram + SSD 500Go
Clé USB Zigbee SonOff
Lixee V4000-06
Autres périphériques Zigbee: 15
Distance HA Z2M -> Lixee : 5m avec Lqi=30
Contrat EDF:
Monophasé avec abonnement depuis 2mois: HP + HC midi + soir + WE (Vert electrique Auto)

Depuis le 06/02/2023 plus de remontées de Lixee (tout fonctionnait bien depuis Aout 2022).
Les symptomes: les valeurs restent figées. Lixee ne veut pas prendre la mise à jour en OTA.
j'ai redémarré Z2M et Mosquito Broker plusieurs fois
Avez-vous le même problème sinon comment le résoudre ?
Voici mes paramètres
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

Merci pour votre retour.
Cdt.

fairecasoimeme, 2023-02-09:
Bonjour,

Pour l'erreur "MAC no ack", il y a eu un issue ici : https://github.com/Koenkk/zigbee2mqtt/issues/2789
Est-ce que ça ne correspondrait pas ?
Dans tous les cas, je vous recommande aussi quand ce sera possible de mettre à jour en v12

Patoche781, 2023-02-09:
Bonjour et merci pour le suivi.
Pour que le Lixee puisse être vu du coordinateur, dois-je faire la procédure suivante: supprimer l'objet Lixee de Z2M, le débrancher du Linky, le rebrancher puis tenter le réappairage ? Car n'étant plus vu de Z2M je ne peux pas faire la mise à jour OTA : c'est la solution ?

fairecasoimeme, 2023-02-09:
D'après l'erreur et de ce que je comprend, il semblerait qu'il y ait des problèmes d'interférences. Vous pouvez tenter de refaire un appairage pour voir s'il le coordinateur le re détecte. peut-être changer de canal zigbee aussi.

Patoche781, 2023-02-09:
Merci pour la rapidité du message!
Je vais tenter ce soir d'abord le refaire le réapparaierage ... Sinon: comment changer le canal zigbee ? Et question très importante: si je change le canal du zigbee vais-je devoir refaire la recoordination de tout mes autres périphériques zigbee ou vont-ils basculer d'eux même sur le nouveau canal ?

Patoche781, 2023-02-09:
Je ma réponds à moi-même pour la question du changement de canal du zigbee: la notice officielle stipule " ZHA préfère utiliser le canal Zigbee 15 par défaut. Vous pouvez modifier cela en utilisant la configuration YAML, mais cela ne fonctionne que s'il n'y a pas de réseau existant. Pour changer le canal d'un réseau existant, la radio doit être réinitialisée et un nouveau réseau doit être formé. Cela nécessite un réappariement de tous les appareils."
C'est ce que je craignais ! On va donc essayer le mode réappairage ...

pipiche38, 2023-02-10:
Bonjour, vous avez le meme problème que les utilisateurs d'un coordinateur non-Zigate. Il vous faut faire un reset du ZLinky;

Patoche781, 2023-02-10:
@pipeche38 Merci pour ton retour!
Je ne suis pas resté inactif hiers soir et essayé et réessayé et re-réessayé mais: choux-blanc! J'ai supprimé de Z2M l'objet "Lixee" puis relancé Z2M avec à la suite relance de Z2M + MQTT+ Redémarage de Poxmox+ HA. Retentative de réappairage de Lixee : appui long pour reset: le lixee s'éteint puis passe au bleu fixe (Linky Ok donc) mais invisible dans Z2M lors de la phase de reconnaissance déclenchée (avant ou après).
Le module Lixee a fonctionné de nombreux mois (car de nombreuses galères sur le github sur les versions qui ont succédées) mais la impossible de l'appairer lors de ces derniers avatars ! Je retente le coup ce soir après une nuit de dépose et de repos de Lixee et de moi même!
Pour info: tous mes autres périphs fonctionnent à merveille à des distances de plus de 15 m pour certains!  Le Lixee est à 3 m du coordinateur et n'est pas fichu de verrouiller la trame Zigbee !
Je sens que je vais renvoyer ce matos au vendeur et me le faire changer ou rembourser !
Ce matériel n'est pas fiable en tant que tel !
Ps: quand tu dis un reset du Zlinky tu veux dire quoi exactement ? @faicasoieme me dit de changer le canal Zigbee: hors de question de tout casser: j'ai pas envie de monter dans mes combles pour réinitialiser mon detecteur incendie Frient ou mes capteurs T° SonOff et inondations Xiaomi !
Dans l'attente de te lire ...

max5962, 2023-02-13:
Depuis hier.
plus aucune nouvelle du Zlinky ( pourtant je suis sous ZHA / home assistant ) et ça marche depuis 1 ans 1/2 sans broncher ...
Question très très très con, l'heure de déconnection, semble correspondre au moment ou j'ai changé la poignée de porte de mon placard qui contient le Linky ... J'espère que c'est pas semble autant à ce genre d'aléa ^^

Patoche781, 2023-02-13:
Bonjour. Aucune modification de prêt ou de loin sur mon installation !
J'essaie de joindre le SAV de Domadoo qui m'a vendu le produit et qui
manifestement prend son temps pour répondre ma demande. LE N° de téléphone
ne répond pas... Ils m'ont préconisés par mail de faire des mesures de
tension sur le Lixee comme tout préambule. Bon je patiente sur leur réponse
suite à mes mesures transmises après je vais escalader plus haut...

Le lun. 13 févr. 2023, 14:28, max5962 ***@***.***> a écrit :

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

fairecasoimeme, 2023-02-13:
Bonjour,

Vous indiquez que le ZLinky fonctionne correctement depuis aout 2022, vous avez un LQI de 30 (faible). Dans les logs vous avez un message d'erreur "MAC no ack" qui signifie que votre coordinateur n'a pas reçu d'acquittement a une demande d'information.
La led du ZLinky est-elle allumée ?
avez-vous débranché puis rebranché le ZLinky ? (j'imagine que oui)
Du coup, pour moi, c'est un problème de réception du ZLinky.

fairecasoimeme, 2023-02-13:
> Depuis hier. plus aucune nouvelle du Zlinky ( pourtant je suis sous ZHA / home assistant ) et ça marche depuis 1 ans 1/2 sans broncher ... Question très très très con, l'heure de déconnection, semble correspondre au moment ou j'ai changé la poignée de porte de mon placard qui contient le Linky ... J'espère que c'est pas semble autant à ce genre d'aléa ^^

Quelle version du firmware ? avez-vous le condensateur ? https://github.com/fairecasoimeme/Zlinky_TIC#errata-hardware
si vous n'avez pas la dernière version du ZLinky, il est possible qu'il soit planté. (essayez de débrancher/rebrancher puis mettre à jour). Sinon autre possibilité, vous êtes en limite de portée, le fait d'être resté devant la porte à fait changer le réseau de route pour le ZLinky et a mis la pagaille dans le réseau qui fait que maintenant le ZLinky n'est plus à portée du coordinateur.

max5962, 2023-02-13:
> > Depuis hier. plus aucune nouvelle du Zlinky ( pourtant je suis sous ZHA / home assistant ) et ça marche depuis 1 ans 1/2 sans broncher ... Question très très très con, l'heure de déconnection, semble correspondre au moment ou j'ai changé la poignée de porte de mon placard qui contient le Linky ... J'espère que c'est pas semble autant à ce genre d'aléa ^^
>
> Quelle version du firmware ? avez-vous le condensateur ? https://github.com/fairecasoimeme/Zlinky_TIC#errata-hardware si vous n'avez pas la dernière version du ZLinky, il est possible qu'il soit planté. (essayez de débrancher/rebrancher puis mettre à jour). Sinon autre possibilité, vous êtes en limite de portée, le fait d'être resté devant la porte à fait changer le réseau de route pour le ZLinky et a mis la pagaille dans le réseau qui fait que maintenant le ZLinky n'est plus à portée du coordinateur.

Version V5, je vais upgrade à la V12 (je pensais que c'était automatique).

J'ai la version sans le condensateur (acheté le jour la sortie 😁)

Un restart et c'est de nouveau opérationnel !

pipiche38, 2023-02-14:
le problème est equivalent au problème des Aqara qui disparaissent du réseau.
Le ZLinky quand il n'a pas de retour du coordinateur semble s'endormir et ne se reveille plus (jusqu’à un hard reset de celui-ci)

Quand vous utilisez une clef Texas Instrument avec Z2M ou une clef Silabs avec ZHA celle-ci ne remplie pas son role à 100% quand la partie Z2M ou ZHA est down (update, reboot ....) Si alors lors de cette fenêtre le ZLinky envoie un message de type Report ou autres et que le coordinateur de réponde pas (par exemple pas de retour de Default Response), alors le ZLinky semble se mettre en sommeil.

Peut-être ais-je tord, mais il me semble que les Aqara/Xiaomi qui disparaissent du réseau sont aussi sur un chip set NXP et la même stack que celle du ZLinky

J'ai reproduit ce problème à plusieurs reprise avec une clef Silabs. Ce problème n'arrive pas avec une ZIgate tant que celle-ci reste alimentée car elle gère ZCL et fait les Default Response (contrairement aux autres clefs qui travaille en Raw)

fairecasoimeme, 2023-02-14:
Désolé mais ce n'est pas le même problème que les aqara dans ce cas précis. Les aqara sont des ZED qui décident de sortir du réseau lorsqu'il ne communiquent pas pendant X temps. Le ZLinky est en mode routeur et il n'y a pas d'endormissement. les aqara et ZLinky utilisent la même marque NXP mais pas le même micro et pas la même stack. Le problème que rencontre @max5962 est connu et a été testé. Il est lié à un problème hardware et software. L'absence de condensateur implique un hardfault côté firmware. Pour régler le problème, il faut rajouter le condensateur et mettre à jour le firmware.

Ensuite sur les problèmes de mise à jour, il y a plusieurs choses. mais impossible de conclure sur la ZiGate puisque la mise à jour n'est pas possible au travers de Z2M ou ZHA. De mon côté et au travers de mes tests sur Z2M, j'ai remarqué un affolement et un flood de Z2M sur le ZLinky. Quand je fais les tests avec une ZiGate et un outil basique (avec bien entendu les binds et reports configurés), je n'arrive pas à reproduire les problèmes rencontrés.

pipiche38, 2023-02-14:
Comme tu veux, mais moi je confirme ce que j'ai observé, et que le ZLinky s'endort complétement. et que ce phénomène n'existe pas en Zigate mais avec les clefs non-zigate.
L'idée etait d'apportée une piste d'investigation
Oublie !

pipiche38, 2023-02-14:
qu'il plante ou qu'il s'endorme y-a pas beaucoup de différence pour moi. En tout les cas la root cause pour moi est qu'il est en attente de quelque chose du coordinateur (probablement le default response status) .
Dans mon cas le reset 10s est suffisant, par contre certain ont eu besoin du re-flash

fairecasoimeme, 2023-02-14:
s'endormir n'a rien à voir avec planter. Surtout quand le but est de trouver une solution
Dans le cas de @max5962, le problème est connu et a été testé et corrigé.
Dans ton cas, je crois savoir que tu as encore un prototype donc très probablement le même cas que @max5962
Pour le cas de @Patoche781, pour moi, il y a clairement un problème de portée, de firmware ou plantage. ça a fonctionné 8 mois ...

pipiche38, 2023-02-14:
comme tu veux . bonne continuation ...

fairecasoimeme, 2023-02-14:
de même

Patoche781, 2023-02-14:
Bonjour à tous.
Ma clé Zigbee est la SonOff USB 3.0 qui fonctionne parfaitement en
production (HA aux dernières M.A.J) avec une grande diversité de matériels
de plusieurs marques: SonOff (T°) , Frient (Incendie), Xiomi (humidité),
Lidl (lumière et détection de présence), Noos (prises électriques) entre
autres. Tous ont été facilement intégrés au réseau zigbee en production dès
leurs achat. A côté de cela j'ai le même matériel et sa configuration à
l'identique en plateforme de test qui fonctionne parfaitement bien mais
libre de tout périphérique (juste utilisée pour tester un nouveau matériel,
les M.A.J, les scripts, etc...). Cette plateforme de test est située à 1,5m
du Linky. La production est elle même à 3-5m soit dit en passant.
Le Lixee (avec condensateur) à fonctionné de longs mois avec tout ce petit
monde (primo appairage capricieux mais ok tout de même)) ! Du jour au
lendemain des pertes de données sont apparues puis silence total (aucun log
de tentative de connexion,)... Les resets + débranchements + rebranchements
les mises au repos n'y ont rien fait. La tentative d'appairage sur ma plate
forme de test distante d'un mètre n'a pas mieux fait alors qu'elle ne
possède que le concentrateur zigbee opérationnel (donc pas de perturbation
possible)!
Conclusion ou le matériel est grillé ou particulièrement instable (mais pas
les autres)  !
Je ne vois pas d'autres solutions et vous ?
Cordialement d'un passionné.

Le mar. 14 févr. 2023 à 11:06, Pipiche ***@***.***> a écrit :

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

fairecasoimeme, 2023-02-14:
il faut faire attention car avec le ZLinky, dans votre version, quand on appuie 10 sec sur le bouton, cela peut déclencher sur les 2 coordinateurs une mise en mode "permit join" et du coup le zlinky peut s'appairer sur le mauvais coordinateur. C'est déjà arrivé chez certains.
Peut-être débrancher le coordinateur que vous ne voulez pas utiliser pour le ZLinky pour être sur et supprimer avec forçage les ZLinky "fantômes"

Patoche781, 2023-02-14:
Merci pour votre suivi et la recherche de solutions.
@fairecasoimeme  Je souligne que ma plate-forme de test ne fonctionne pas en permanence pour éviter tout interférence.
Par contre je vais éteindre mon HA en production, allumer celui de test uniquement et essayer en fin d'A.M de refaire un appairage du Lixee à 1m !
Question: Il faut appuyer combien de temps pour faire le reset ? Y'a t-il un ordre à respecter pour lancer un "Permit join" . Le faire avant ou après le reset? Débrancher le coordinateur non utilisé ? C à dire ? Supprimer avec forçage des ghosts: et si dans mon interface web Z2M je n'ai aucun périphérique c'est qu'il n'y en as pas ?
Merci de vous lire !

fairecasoimeme, 2023-02-14:
il faut rester appuyer 10 sec.
pas forcément d'ordre. vous pouvez lancer le permit join après le reset.
Si vous éteignez votre HA de production pas besoin de débrancher le coordinateur
Si vous n'avez aucun ZLinky dans l'interface web c'est ok

fairecasoimeme, 2023-02-14:
En ce moment, il y a des mises à jours de Linky qui semble mettre en sécurité l'alimentation du TIC. pour résoudre le problème, il faut laisser débrancher le ZLinky pdt 10 min puis rebrancher.

Patoche781, 2023-02-22:
Bonjour
Problème résolu: le TIC douteux à été renvoyé au vendeur (assez réactif sur le coup) qui m'en a envoyé un nouveau. Dès sa mise en place dans le Linky l'appairage s'est fait immédiatement du premier coup et dans la foulée la dernière MAJ en OTA V13 s'est lancée en 20mn sans défaut. J'ai un LQI de 100 environ. Les datas du Linky sont remontées dans le pannel "Energy" au bout d'une heure (en négatif d'abord ?) puis ce matin tout est OK. Petit problème j'ai perdu l'historique du Linky mais pas grave ! L'appli de mon fournisseur est là ...

tomav, 2023-07-13:
Voici mon expérience sur cette erreur.
J'ai eu le même souci aujourd'hui avec un Zlinky récent (acheté en 2023, upgradé tout de suite en version 13, et qui a bien fonctionné pendant des mois):
- aucun changement dans mon installation Z2M
- erreurs `MAC no ack' (233)` sur mon Zlinky seulement. Tout le reste fonctionne bien
- unplug/replug du Zlinky et retour à la normale

Closed 2023-02-22.

Thread 184 (2023-02-20):

Z2M mise a jour par OTA firmware Limited.

WarC0zes, 2023-02-20:
Bonjour,
je suis passer sous Z2M et je n'est jamais mis a jour sous Z2M mon Zlinky en firmware Limited.
Je suis en V12 Limited et voudrais mettre a jour en V13 Limited, mais es que Z2M va récupérer le firmware limited si je le met a jour a partir de Z2M ?
Ou va falloir que je le fasse manuellement ?
Si manuellement, quelqu'un peu expliquer la procédure.
Merci d'avance.

molusk, 2023-02-25:
Je suis dans le même cas que toi et je n’ai pas encore réussi a faire passer la maj.
Z2M va chercher la version complète même quand je lui force le json d’OTA en local avec le firmware à côté.
Je dois faire quelque chose mal mais je ne trouve pas quoi...

On en parle déjà sur le forum hacfr, je ne sais pas quel est le meilleur endroit pour poursuivre cette discussion et partager le résultat de nos tests.

fred-gb, 2023-02-26:
Bonjour,
Je viens de voir ce sujet juste quelques minutes après après posté sur le github de Z2M.
https://github.com/Koenkk/zigbee2mqtt/issues/16823

En espérant une réponse.

Bon après-midi

molusk, 2023-02-27:
Merci pour la piste ! Je vais me laisser tenter par un custom converter :+1:
Si ça se passe bien, je le partagerai ici même.

molusk, 2023-02-27:
Bon, j'ai tenté une solution TRÈS sale, modifier le fichier js qui définit comment faire des OTA pour le Zlinky pour pointer vers le fw limited :
https://github.com/Koenkk/zigbee-herdsman-converters/blob/master/lib/ota/lixee.js
changement de la ligne 21 pour trouver le fichier qui finit par limited.ota au lieu de .ota.

Ça m'avait l'air pas mal en théorie mais en pratique, ma modification n'est pas prise en compte alors qu'elle persiste après redémarrage du conteneur... Peut-être que je n'ai pas modifié la bonne copie du fichier... je ferai plus de tests dans les jours à venir.

molusk, 2023-02-28:
Une solution plus propre a été donnée sur le post de @fred-gb https://github.com/Koenkk/zigbee2mqtt/issues/16823
Je testerai dès que possible :)

En fait, le converter lixee utilise la fonction d'ota spécifique lixee (celle que j'ai tenté de modifier sans succès) où tout est en dur quand la fonction standard zigbeeOTA.js interprète correctement l'option pour écraser le chemin de l'index d'ota.

Bref, en forçant le converter y pointer sur zigbeeOTA, le chemin de l'index pourra être modifié pour pointer vers le firmware limited et la mise à jour poussée.
Par contre, c'est du temporaire, très temporaire, aucune autre mise à jour ne pourra passer avec cette configuration et une fois l'index custom retiré, il faudra repasser sur le converter standard de lixee sans quoi tu n'auras ni mise à jour, ni notification de disponibilité de la mise à jour pour le zlinky.

Au final, c'est le fichier ota/lixee.js qu'il faudra modifier pour gérer les version limited et/ou les index custom.
Je connais rien à JS mais je vais peut-être tenter de bidouiller lors de ma prochaine soirée d'ennui :rofl:

molusk, 2023-02-28:
Mise à jour en cours avec la bidouille indiquée sur l’autre post 👍

Pour ce qui est de modifier le fichier OTA lixee, il va falloir attendre le prochain firmware pour le test/débogage mais je vais me pencher dessus en attendant (à moins qu’on puisse forcer un rollback sans risque ?)

WarC0zes, 2023-03-08:
Bonjour,
personne a de solution ?
étonnant qu'on soit que quelques utilisateurs a utiliser un firmware limited sous Z2M.
C'est mon seul regret d'être passer sous Z2M, pour mettre a jour le Zlinky. C'était bien plus simple sous ZHA...

PEGARifrouf, 2023-03-13:
Salut,
J'avais réussis downgrader vers un firmware limited grâce à [ce post en lien ici](https://github.com/fairecasoimeme/Zlinky_TIC/issues/89#issuecomment-1236422701)

J'étais ensuite passé au v12 limited avec la même procédure.

MilesTEG1, 2024-03-18:
Hello,
J'ai le même soucis que vous tous.
J'ai réussi à flasher le firwmare v13 limited ce WE (après pas mal de galères), et Z2M me dit qu'il n'est pas à jour et qu'il y a un firwmare v13 à flasher.
Sauf que ça ne fonctionnera pas, comme l'a souligné @WarC0zes puisque Z2M veut flasher un firmware legacy, et mon ZLinky est Limited.

WarC0zes, 2024-09-02:
Bonjour,
je relance le post, aucune avancé pour mettre à jour un firmware limited sous Z2M ?
En plus un V14 vient de sortir, ça serait cool de pouvoir l'installer.

MilesTEG1, 2024-09-02:
> Bonjour, je relance le post, aucune avancée pour mettre à jour un firmware limited sous Z2M ? En plus une V14 vient de sortir, ça serait cool de pouvoir l'installer.

Je suis moi aussi preneur d'une solution de MAJ OTA de la version limited.
Ça doit bien être possible, vu qu'il y a un .ota... mais je ne connais pas la méthode.

J'envisage presque de reflasher une version router...

dinde, 2024-09-15:
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

Tout pareil. J'ai sans arrêt des propositions de maj OTA mais rien à faire pour mon zlinky en firmware limited.
La maj USB n'est clairement pas envisageable en production et cela fait assez longtemps que nous sommes dans l'attente d'une solution. 🙏🏻

molusk, 2024-09-19:
Honnêtement, je pense que je suis trop incompétent pour réussir à m'en sortir sur ce sujet... Si un gars calé en JS passe dans le coin, pleeeeeeeeeeeeeeeaaaaaaaaaaaaaase help !

WarC0zes, 2024-10-15:
@molusk , ça avance :D

https://github.com/Koenkk/zigbee-herdsman-converters/pull/8136

https://github.com/Koenkk/zigbee-OTA/pull/568

WarC0zes, 2024-10-16:
Les PR sont merge, plus cas attendre la prochaine release de Z2M, début novembre et on pourra mettre à jour en OTA le firmware limited .

WarC0zes, 2024-11-01:
Bonjour,
la nouvelle maj de Z2M est sorti 👍
MAJ par OTA pour le limited, est bon. Plus cas testé.

WarC0zes, 2024-11-03:
Bonjour,
mise a jour v14 limited sous Z2M OK.
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

molusk, 2024-12-03:
J'ai l'impression que mon compteur délivre pas assez de puissance au zlinky et qu'il échoue au milieu de l'OTA mais au moins, il n'est pas briqué !

WarC0zes, 2024-12-03:
> J'ai l'impression que mon compteur délivre pas assez de puissance au zlinky et qu'il échoue au milieu de l'OTA mais au moins, il n'est pas briqué !

Salut,
tu peut utiliser une alimentation externe , au lieu du linky.

https://github.com/fairecasoimeme/Zlinky_TIC/issues/290#issuecomment-2415070713

molusk, 2025-01-02:
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

Merci pour l'info mais le compteur est au bout du jardin, ça va être compliqué pour tirer une alim... autant tirer des fils pour la téléinfo et mettre le zlinky dans mon garage avec l'alim externe.
Bon, je viens de voir que suite à la dernière tentative d'OTA, il est offline... Il va falloir que j'aille essayer d'ouvrir le coffret à la serrure pétée pour le débrancher et rebrancher, ça m'enchante !
Ça ne serait peut-être pas une si mauvaise idée de tirer des câbles :smiley_cat:

Closed 2024-10-16.

Thread 185 (2023-02-20):

Acquisition Time and Power measurement

Karreg, 2023-02-20:
Hello,

I have set up my ZLinky successfully, but there's still a value I'm having an issue with : Power (in Watt).
The value is updated every 30 minutes, even though Acquisition Time is set to 10 seconds, and I have changed it to 7 seconds.
I don't have this issue with other measures.
Does it mean the value is updated by Linky only every 30 minutes?
If yes, is there a way to change that?
If no, is there any way to accurately measure instance power delivered?
My purpose is to instantely measure the gain, or added consumption of devices.

Thanks!

CladStriffe, 2023-03-02:
Bonjour
Ce que tu évoques ne dépend pas du zlinky, mais bien du compteur Linky directement qui ne donne qu'une valeur moyenne sur une période définie par le fournisseur d'énergie (de 10 à 30 minutes de ce que j'ai pu voir).
Regarde ici
#117

Karreg, 2023-03-03:
Merci pour le lien @CladStriffe ! Je n'arrivais pas à trouver l'information.
Les échanges autour des W et VA est intéressantes, et la connaissant j'ai pu la retrouver sur internet.
Et du coup j'ai comparé, et en effet le profil est comparable, mais je trouve quand même une sacré différence :

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

Alors ça pourrait être lié au fait qu'il y a des pics d'un côté, et une moyenne de l'autre, mais la différence est la même sur les plats, donc pas un effet de bord de la moyenne.

J'avais trouvé qu'il fallait, pour passer de l'un à l'autre, connaître le Power Factor, qui n'est pas remonté par le zlinky :

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

https://www.powerstream.com/VA-Watts.htm

> In other words, volt-amps x power factor = watts. Similarly, KVA*PF = KW

Se pourrait-il que ce power factor change selon le linky, la région, je sais pas quel autre critère ?

CladStriffe, 2023-03-03:
Le facteur de puissance n'est pas constant et dépend des équipements que tu as chez toi.
Pour les résistances pures (ampoules à incandescence, grille pain, bouilloire, chauffe eau, radiateur électrique, ...) le facteur de puissance vaut 1.
Ça se complique quand il y a des transformateurs ou moteurs électriques (frigo, pompe à chaleur, plaque à induction, alimentation pour PC, chargeurs de tel etc) et là le facteur de puissance est inférieur à 1. Ça veut dire que toute la puissance délivrée par le réseau (puissance apparente), nécessaire pour que l'équipement fonctionne, n'est en fait pas utilisée et une partie peut repartir sur le réseau (la puissance réactive).
Pour comprendre d'où ça vient, pense à un condensateur par exemple : en courant alternatif, il va se charger puis se décharger. Il faut lui fournir de la puissance, mais il la restitue après.

Au final:
- SINSTS est la puissance apparente, c'est bien ce que le Linky voit passer comme puissance sur ton réseau. Et c'est la seule valeur instantanée qu'on peut lire
- L'énergie qu'on paye en tant que particulier n'est que liée à la puissance active (donc on ne paye pas la puissance réactive. C'est par contre facturé dans l'industrie). C'est donc bien ce qui nous intéresse, malheureusement le Linky ne sait pas la donner en temps réel car il doit faire des moyennes pour regarder aussi ce qui "ressort" de ton réseau (je schématise, mais c'est l'idée de cette puissance reactive).
- pour calculer le facteur de puissance, tu peux en approximation regarder le rapport entre SINSTS et CCASN sur tes valeurs constantes la nuit. Ça donne une idée, mais ce ne sera pas complètement représentatif le reste de la journée. Par exemple, la nuit je suis autour de 0,6 ou 0,7. Mais quand mon chauffe eau se met en route, comme c'est une grosse puissance active et rien en réactif, mon facteur de puissance est proche de 1.
- c'est pour ça que je préfère quand même utiliser SINSTS pour suivre ma puissance.

Ça fait un gros pavé, je ne suis absolument pas expert du domaine, c'est juste le résultat de mes lectures après m'être posé les mêmes questions que toi.

Karreg, 2023-03-03:
Merci, c'est très clair.

J'en déduis qu'on peut peut pas vraiment suivre la puissance d'un appareil en suivant la puissance apparente à cause de ce facteur de puissance, et que rien ne peut remplacer un Wattmètre. C'était mon besoin initial, je comptais regarder le delta à l'allumage d'un appareil, dommage...

Par contre pour suivre la consommation globale, la puissante apparente est à la fois la valeur réellement facturée, et une approximation de la puissance instantanée plutôt proche de la réalité.

Merci beaucoup pour ces éclaircissements, du coup je ferme le ticket :)

T0ytoy, 2023-03-23:
Personnellement j'utilise la valeur en kwh remontée par le ZLinky et j'appliquer une dérivée dessus pour obtenir des watts en "temps réel" (à chaque remontée du ZLinky, donc toutes les quelques secondes. Ça semble fonctionner correctement et me donne l'info que je veux.

Closed 2023-03-03.

Thread 186 (2023-02-25):

Mise a jour usb sur PCB 1.4

gsemet, 2023-02-25:
Bonjour,

J'ai le PCB 1.4 que je souhaite mettre a jour pour voir si la remontée des valeurs d'énergie injectée sur le réseau marche mieux, mais je vois que je n'ai pas le connecteur:
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

Est-ce que les connections 5V/GND/TX/RX/DTR,3V sont bien les mêmes que sur vos photo du READE? C'est normal de ne pas avoir le connecteur?

Merci

fairecasoimeme, 2023-02-27:
Bonjour,
l'injection ne peut être remontée sur la TIC uniquement si vous avez un contrat avec EDF.
Quelle version du firmware avez-vous ?
Oui sur la v1.4, il n'y a pas de connecteur mais on peut mettre à jour en utilisant le module USB-TTL

gsemet, 2023-02-27:
Bonjour. J'ai réussi à faire la mise à jour et apparement j'ai le Linky en mode historique, je comprend donc pourquoi je n'ai pas de remontée de la production. Je demande a total énergie de faire le changement de mode :)

fairecasoimeme, 2023-02-27:
je pense que si vous étiez en mode historique, vous n'avez donc pas de contrat de production avec EDF. Donc ça ne suffira pas pour récupérer avec la TIC les données d'injection

gsemet, 2023-02-27:
Si j'ai bien un contrat de revente avec EDF OA depuis 2018.

fairecasoimeme, 2023-02-27:
Parfait, alors ça devrait être OK. Juste bizarre que lors du contrat, on vous ait pas passé d'office en mode standard.

gsemet, 2023-03-02:
Bonjour. Effectivement tout fonctionne maintenant. Je recommende néanmoins de rajouter quelques remarques dans votre readme car les gens ne connaissent pas ces histoires de mode standard/historique:
- le linky a 2 modes historiques et standard qui peuvent facilement etre lu dans l'un des affichages du linky
- certaines fonctions ne peuvent etre activee qu'en mode standard
- pour changer le mode d'historique a standard, il suffit de faire la demande au service client de votre fournisseur qui transmettrera la demande a enedis.
(j'ai fait la demande a TotalDirect Energie le lundi, le mode a ete change sur mon linky le mercredi)

Closed 2023-03-02.

Thread 189 (2023-03-27):

Recup Data depuis MQTT vers InfluxDB puis Grafana

steflp, 2023-03-27:
Hello
 je voudrais recuperer les data prvenant du Zlinky via le broker mqtt ( Z2M installé)  pour pousser le data dans InfluxDB puis Grafana
qqn aurait-il deja fait ca ?
qqn peut m'aider sur mqtt et la recup de data ?
 J'utilise MQTT Explorer pour lire les "topic" mais je suis un peu perdu
Merci

nicocha75, 2023-03-28:
Bonjour
Je fais exactement ça en utilisation un outils qui s'appelle telegraf
Voici la config pour MQTT, je te laisse cherché pour connecté telegraf à influxdb

```
 [[inputs.mqtt_consumer]]
   servers = ["tcp://192.168.1.8:1883"]
   topics = [
	  "zigbee2mqtt/linky/#",
	  "Energy/#",
   ]
   data_format = "json"
```

ensuite il n'y a pas plus simple dans grafana pour récupéré les données.

Nicolas

steflp, 2023-03-28:
Hello
Merci  pour  le fichier de configuration qui  m'aidera bcp
J'ai également Telegraf d'installler mais  coté connecteur  pas facile le paramétrage  !
( j'ia deja un mqtt pour une station meteo connectée)

L'autre souci du  moment ; reussir a RE-associer mon Zlinky avec ma clef USB SonOff  je l'ai supprimé de ma config et impossibe a la remettre  !

Des que ca tourne , je vous fait un feedback

Merci

steflp, 2023-04-20:
Bon et bien , j'ai reçu  le modele avec antenne et c'est toujours pareil  ... aucune connexion si ca continue je vais devoir deplacer mon compteur Linky et le coller a  ma clef SonOff .. je ne m'en sors pas !

fairecasoimeme, 2023-04-21:
Avez-vous un raspberry Pi avec disque SSD ?
https://www.youtube.com/watch?v=tHqZhNcFEvA

steflp, 2023-04-21:
Non PC dell 3020 micro avec un hub zigbee reseau + PA Dlink wifi à proximité

steflp, 2023-04-21:
Re, avec une rallonge USB2.0 "active"  c'est bon mon Zlinky est reconnu mais pas bcp de  puissance  ...
 je continue  mes tests ce we en deplacant mon "serveur" DELL pres du compteur Linky

steflp, 2023-04-21:
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
Bon je crois que l'on peut fermer cette demande
Merci  encore  :-)

steflp, 2023-04-28:
Bonjour @nicocha75
 j'ai  un petit souci  pour recupérer certaines data  :
`# Read metrics from MQTT topic(s)
[[inputs.mqtt_consumer]]
  servers = ["tcp://127.0.0.1:1883"]
  topics = [
  "zigbee2mqtt/Zlinky/#",
  ]
  data_format = "json"`

je n'arrive pas à récupérer cette valeur "active_register_tier_delivered"

De  plus  est-ce normal que la valeur   "tomorrow_color" reste toujours a cette valeur   "----" ?

Merci  !
Stef

fairecasoimeme, 2023-04-28:
La couleur du lendemain n'est disponible qu'à certaines heures
https://github.com/fairecasoimeme/Zlinky_TIC/issues/139#issuecomment-1344400845

Closed 2023-05-12.

Thread 192 (2023-04-26):

Couleur lendemain mode Standard tarif TEMPO

dcyou, 2023-04-26:
Bonjour,

j'essaye de retrouver la couleur du lendemain (elle n'est pas dans tomorrow color)

je suis bien en
```
NGTF
Supplier pricing schedule name
TEMPO
LTARF
Current supplier price label
HP BLANC
```
Ma valeur de registre est la suivante
```
STGE
Register of Statutes
423A4C01
```
Soit
```
0100 0010 0011 1010 0100 1100 0000 0001

0 Contact sec
100 Organe de coupure
0 État du cache-bornes distributeur
0 Non utilisé
1 Surtension sur une des phases
0 Dépassement de la puissance de référence
0 Fonctionnement producteur/consommateur
0 Sens de l’énergie active
1110 Tarif en cours sur le contrat fourniture
10 Tarif en cours sur le contrat distributeur
0   Mode dégradée de l’horloge (perte de l’horodate de l’horloge interne)
1 État de la sortie télé-information
0 Non utilisé
01 État de la sortie communication Euridis
10 Statut du CPL
0 Synchronisation CPL
00 Couleur du jour
00 Couleur du lendemain
00 Préavis pointes mobiles
01 Pointe mobile (PM)
```
or j'ai 00 pour couleur du jour et lendemain
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

Soit Enedis ne renvoit pas correctement soit quelque chose m'échappe ?
+ si vous avez une solution/piste pour retrouver cette information je suis preneur

peut être lié à ?
https://github.com/fairecasoimeme/Zlinky_TIC/issues/191

doc:
[Enedis-NOI-CPT_54E.pdf](https://github.com/fairecasoimeme/Zlinky_TIC/files/11331648/Enedis-NOI-CPT_54E.pdf)

fairecasoimeme, 2023-04-27:
Bonjour,

01000010001110100100110000000001 <--- il faut partir dans ce sens pour la numérotation des bits

1 Contact sec (bit 0)
000 Organe de coupure
0 État du cache-bornes distributeur
0 Non utilisé
0 Surtension sur une des phases
0 Dépassement de la puissance de référence
0 Fonctionnement producteur/consommateur
0 Sens de l’énergie active
0011 Tarif en cours sur le contrat fourniture
01 Tarif en cours sur le contrat distributeur
0   Mode dégradée de l’horloge (perte de l’horodate de l’horloge interne)
1 État de la sortie télé-information
0 Non utilisé
11 État de la sortie communication Euridis
01 Statut du CPL
0 Synchronisation CPL
10 Couleur du jour  --> **couleur du jour blanc**
00 Couleur du lendemain --> **pas d'annonce**
00 Préavis pointes mobiles
01 Pointe mobile (PM)

dcyou, 2023-04-27:
j'ai eu un doute en plus... merci ;)
je surpris de n'avoir pas d'annonce pour le lendemain
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

il est précisé "historique tempo" donc ce qui m'échappe c'est pourquoi j'ai bien la valeur actuelle mais celle du lendemain.

Si vous avez une piste ça m'aiderait ;) sinon je pensais voir avec ENEDIS

fairecasoimeme, 2023-04-27:
Il me semble que ya des heures précises pour les annonces du lendemain :
https://github.com/fairecasoimeme/Zlinky_TIC/issues/139#issuecomment-1344400845
Dans l'exemple c'est sur le mode historique mais je pense que c'est pareil pour le mode standard.

pipiche38, 2023-07-25:
le STGE renvoie bien le Registre des Status en mode standard?
Par contre la doc Enedis indique bien que les bits 26 et 27 "Couleur du Lendemain" sont à 0 hors contrat Historique Tempo.

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

fairecasoimeme, 2023-07-26:
Il ne faut pas confondre le mode de communication et l'abonnement (contrat).
Le registre des status STGE n'existe que dans le mode standard. (c'est le mode de communication)
Le contrat historique tempo correspond à un contrat spécifique au fournisseur EDF qui est le seul contrat qui gère les périodes de couleurs bleu blanc rouge.
Donc c'est tout à fait normal que hors contrat tempo (contrat historique edf), la valeur est à 0

Closed 2023-04-28.

Thread 193 (2023-04-30):

ZLinky_TIC non alimenté

uncle-buzz, 2023-04-30:
Bonjour,
J'ai un ZLinky_TIC  v1.1 firmware 4000-0012 du 20221121 (information zigbee2mqtt) que j'ai testé sur un linky en appartement : RAS, tout fonctionne bien
Je vais déménager dans une maison, j'emmène mon serveur zigbee2mqtt avec mes capteurs et le ZLinky_TIC  que j'installe sur le linky de la maison, sauf qu'avant de pouvoir tester l'appairage avec un répéteur zigbee (le compteur est en limite de terrain) je constate que la led du ZLinky_TIC  ne s'allume pas... Le linky est bien en mode TIC historique (comme à l'appartement)
Vérification du fusible du module TIC du linky : RAS, il n'est pas coupé
Que dois-je faire pour vérifier que les sorties TIC du linky fonctionnent ? je compte retester le ZLinky_TIC  sur le linky de mon appartement pour vérifier qu'il n'a subi aucun dommage entre le moment où il fonctionnait dans l'appartement et la tentative à la maison, mais côté linky comment détecté un problème ?
Merci

fairecasoimeme, 2023-05-03:
Vous pouvez utiliser un multimètre configuré sur voltmètre alternatif VAC. Côté Linky, vous placez une première sonde sur la borne A et l'autre sonde sur I1. la tension à vide doit être de 13VAC

uncle-buzz, 2023-05-03:
Bonjour,
Merci pour votre réponse, je testerai ce weekend quand je serai de nouveau à la maison, ici à l'appartement le ZLinky_TIC s'est bien allumé, il n'est donc pas en cause, y a-t-il une configuration de mon compte linky qui pourrait ne pas avoir activé la sortie TIC et qu'il faudrait vérifier ou bien s'agit-il forcément d'une défaillance ? J'avais déjà regardé la tension entre A et I1 mais je n'ai pas relevé la valeur, ne sachant pas ce que je devais trouver à ce moment là.
En fonction du résultat, une idée de quoi contrôler ensuite ?
Merci

fairecasoimeme, 2023-05-03:
Malheureusement probablement une défaillance du Linky.

nicocha75, 2023-06-08:
Bonjour
Petit problème identique, en A et I1, je n'ai que 1,8V, donc le zlinky ne fonctionne pas. Ce qui est étrange c'est que j'ai deja eu le cas, et j'ai due débranché le module durant un certain temps pour que la tension revienne. Comme si la puissance était limité par le linky à un moment. ça arrive souvent?
MErci

uncle-buzz, 2023-06-08:
Petit retour pour le suivi, donc contrôle de la tension d'alimentation sur le linky où il était précédemment fonctionnel à 11.8VAC de mémoire
ZLinky_TIC hors de cause donc, retour à la maison, contrôle de la tension : 11.8VAC... Je rebranche le ZLinky_TIC et là ça fonctionne...
Cause inconnue donc, en espérant que ce soit un faux contact et non pas une panne récurrente pouvant survenir à nouveau.

fairecasoimeme, 2023-06-09:
> Bonjour Petit problème identique, en A et I1, je n'ai que 1,8V, donc le zlinky ne fonctionne pas. Ce qui est étrange c'est que j'ai deja eu le cas, et j'ai due débranché le module durant un certain temps pour que la tension revienne. Comme si la puissance était limité par le linky à un moment. ça arrive souvent? MErci

ça n'arrive pas souvent mais Enedis est au courant de ce genre de chose. Il semblerait que qu'un composant se mette en protection mais on ne connait pas encore la cause.

J'ai pu le reproduire il y a longtemps sur mon compteur lors de manipulations (mauvaises) sur le TIC mais impossible depuis à reproduire.

uncle-buzz, 2025-07-15:
Bonjour,
j'avais fait la mise à jour OTA vers la v16 depuis zigbee2mqtt, et peu après, plus de données (peu après, pas immédiatement, donc la v16 a fonctionné)
J'ai reflashé le zlinky manuellement avec la v16 sans option routeur, alimenté par le programmeur la led bleue flash correctement, en revanche sur mon linky, nada, aucune réaction quand je le branche.
J'ai toujours environ 11VAC entre les bornes A et I1 sur le linky pendant que le zlinky y est raccordé, mais aucun signe de vie du zlinky, une idée de quoi tester/vérifier ? Une demande à faire à ENEDIS pour vérifier le compteur ?
Ca fait quelques mois déjà, le zlinky a été débranché plusieurs jours, mais aucun changement quand je le reconnecte.
En cas d'erreur de communication il devrait y avoir un clignotement lent, mais pourquoi aucun clignotement alors qu'il y a une tension d 'alimentation ?

uncle-buzz, 2025-07-23:
Après avoir dessoudé puis ressoudé la puce que je pense être un [ME6214C50M5G](https://lcsc.com/product-detail/Voltage-Regulators-Linear-Low-Drop-Out-LDO-Regulators_MICRONE-ME6214C50M5G_C487908.html), ça semble refonctionner, j'ai 4.9V après le régulateur, et 3.3V après le 2nd, je verra ce week-end une fois remis sur le linky, mais si les schéma au moins pdf pouvais arriver sur le dépôt ça serait plus simple pour dépanner.
Pourquoi 2 ldo en série ?

fairecasoimeme, 2025-07-28:
Historiquement le premier régulateur 5V était destiné à un supercondensateur 5V. n'ayant pas besoin de celui ci, il a été remplacer par un autre condensateur.
Non pas possible d'avoir les schémas

Thread 199 (2023-07-14):

ZLinky semble non alimenté à certains moments

VianneyHENON, 2023-07-14:
Bonjour,
Après des mois de fonctionnement, dimanche dernier le Zlinky est apparu hors ligne dans HA, je l'ai débranché quelques heures, puis après rebranchement la LED a clignoté de nouveau et donc en ligne dans HA.

Aujourd'hui, le phénomène se reproduit, que faire ? Problème avec le Zlinky ou le Linky?

Merci d'avance.

VianneyHENON, 2023-07-18:
Bonjour,
La version est 4000-0012, je n'arrive pas a passer en 13 en OTA avec Home Assistant.
Mais je pense que j'ai eu le même souci que uncle-buzz, avec le souci de tension sur les bornes du tic.
https://github.com/fairecasoimeme/Zlinky_TIC/issues/193

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

fairecasoimeme, 2023-07-19:
Je remarque qu'en ce moment, il y a plus de cas de coupure de l'alimentation de la téléinformation des Linky que d'habitude. soit des mises à jours ou peut-être lié à la chaleur ... je vais remonter une liste de cas. pouvez-vous m'envoyer le modèle et la marque de votre linky ou une phot par mail ?

VianneyHENON, 2023-07-19:
Bonjour,
Linky de marque ITRON modèle T10716
Autre référence ITRON ITE411L3B

VianneyHENON, 2023-09-02:
Bonjour,
Le phénomène est de nouveau réapparu cette nuit.
Pour info.

louistrapadoux, 2023-11-23:
bonjour, il m'est arrivé aussi la même chose aujourd'hui, le zlinky ne semblait plus allimenté, après l'avoir deinstaller du compteur et attendu quelques heures comme suggeré, il s'est remi a fonctionner. la version du firmware est la dernière : 4000-0013

Closed 2023-07-19.

Thread 200 (2023-08-07):

Home Assistant - Discovered entities with a name that starts with the device name

kefrens, 2023-08-07:
Suite derniere mise a jour j'ai le warning suivant:

Some MQTT entities have an entity name that starts with the device name. This is not expected. To avoid a duplicate name the device name prefix is stripped of the entity name as a work-a-round. Please inform the maintainer of the software application that supplies the affected entities to fix this issue.

List of affected entities:
sensor.lixee_linky_fpm2
sensor.lixee_linky_east
sensor.lixee_linky_easd03
sensor.lixee_linky_easf06
sensor.lixee_linky_dpm2
...

Lien vers la nouvelle documentation : https://developers.home-assistant.io/blog/2023-057-21-change-naming-mqtt-entities/

JigSawFr, 2023-08-07:
Same on my side ;)

fairecasoimeme, 2023-08-07:
Ces alertes ne concernent pas le produit ni son firmware mais plutôt Z2M. De ce que j’ai pu lire, il faut attendre une mise à jour de Z2M.
https://community.home-assistant.io/t/psa-mqtt-name-changes-in-2023-8/598099

PEGARifrouf, 2023-08-16:
Pour info c'est un warning temporaire il y a des actions en cours qui vont le résoudre, aucune action des utilisateurs n'est requise.
J'en ai d'autres pour beaucoup de devices .

Thread 202 (2023-08-20):

Failed to deliver message: <EmberStatus.DELIVERY_FAILED: 102>

cyber-g, 2023-08-20:
Hi,
I try to read values using the `bellows` (zigpy) command line.

For information, I use a [Sonoff Zigbee 3.0 Dongle Plus-E](https://www.sonoff.be/a-69234890/accessoires/sonoff-zigbee-3-0-dongle-plus-e/#description) as coordinator (as shown in the table of this post: [ZBDongle-E](https://github.com/Koenkk/zigbee2mqtt/discussions/13373#discussion-4272840) , it is an EZSP ; hence the usage of `bellows`)

I base my command line on this post : [How to get values from a device?](https://github.com/zigpy/zigpy/issues/206#issuecomment-526828258)

Network forming and joining has been done with:
```
bellows -d /dev/ttyACM0 -b 115200 form
bellows -d /dev/ttyACM0 -b 115200 permit
```
Please note: the arguments ` -d /dev/ttyACM0 -b 115200` are required for my Sonoff Dongle ; and the lixee "link" button has been pushed to reset the link during the permit join command, the blue LED of the lixee turns stable as expected.

I use the following command in my case (node ID is obfuscated):
```
bellows -d /dev/ttyACM0 -b 115200 zcl '00:15:xx:xx:xx:xx:xx:xx' 1 1794 read-attribute 0
```

which asks for :
Endpoint : `1`
Cluster: `1794` (Metering)
Attribute: `0` (Index Base)

But the **command fails with the error**:
```
Failed to deliver message: <EmberStatus.DELIVERY_FAILED: 102>
```

fairecasoimeme, 2023-08-21:
Hi,
I don't know where is the issue but I confirm that ZLinky can respond to cluster 1794 and attribute 0

cyber-g, 2023-08-21:
Hi, thank you for your answer.

I ran the above command **several times and sometimes it works** providing the following output:
```
0=7464438
```

I feel that the command line bellows application async operation does not support the communication mode of ZLinky.

Just in case it would help for my further tests, is there any specific periodicity of the Zlinky transmission ?

fairecasoimeme, 2023-08-22:
hi, what does the error code mean ?
There is no specific periodicity for transmission.
This is normal that the number is every time larger than previous because this is an index.

Thread 206 (2023-09-14):

Flasher le firmware limited

adri123, 2023-09-14:
Bonjour,
Je rencontre des difficultés pour flasher le firmware limited.
J'utilise un USB-TTL avec lequel j'ai déjà réussi à flasher des ESP 32.
Je branche le USB en maintenant le bouton flash appuyé et je vois COM3 qui s'ajoute dans mes périphérique. Je relache le bonton après quelques secondes, puis je lancer la commane suivante :
`C:\NXP\DK6ProductionFlashProgrammer>DK6Programmer -s COM3 -P 115200 -Y -p .\ZLinky_router_v13_limited.bin`

Puis j'obtiens:
`┌───────────────────────────────────── NXP DK6 Device Programmer (Build 2282) ──────────────────────────────────────┐│COM3                                                                                                               ││                                                                                                                   ││Error opening connection: Read error                                                                               ││                                                                                                                   ││───────────────────────────────────────────────────────────────────────────────────────────────────────────────────││                                                                                                                   ││                                                                                                                   ││                                                                                                                   ││                                                                                                                   ││                                                                                                                   ││                                                                                                                   ││                 `

J'ai vérifié tous les branchements, je ne comprends pas où je me trompe...
Merci pour votre aide :)

fairecasoimeme, 2023-09-15:
Bonjour,
avez vous essayé d'inverser RX et TX ?

adri123, 2023-09-16:
Tout bêtement , ... Merci !

JigSawFr, 2023-11-19:
J'avais également le même souci,
Finalement résolu par une notion de "timing";
- Branchement du TTL avec appui sur le bouton flash
- Relâchement du bouton
- Lancement de la commande de flash (LED GND rouge)
Le passage entre l'étape 2 à 3 doit être assez rapide, sinon j'obtiens également l'erreur de lecture.

Sinon pour les drivers du TTL: https://www.silabs.com/developers/usb-to-uart-bridge-vcp-drivers?tab=downloads
Le lien sur le site mentionné par le README est HS.

Closed 2023-09-16.

Thread 207 (2023-09-22):

Missing entities

Kriss1670, 2023-09-22:
Zlinky updated with latest firmware (v13), deleted from ZHA list and re-appaired. Still missing many entities :
- Active power : 0 W
- Power Factor : Unknown
- RMS Voltage : 0 V

Only Apparent power, RMS current and summation delivered seems to work.
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

Kriss1670, 2023-09-25:
My mistake : Linky is in historic mode. I switch to standard mode.

Closed 2023-09-25.

Thread 208 (2023-09-25):

active_power toujours à 0 - Zigbee2mqtt

AntoineLemaire, 2023-09-25:
Bonjour,
J'ai installé ma clef Lixee Zlkiny fraîchement reçue, elle est en version 13. Je l'ai configurée sur Home Assistant via Zigbee2MQTT en mode historique HCHP (après avoir vérifié sur l'écran du Linky).

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

Je reçois bien les index HC/HP ainsi que quelques autres infos, cependant le `active_power` est lui toujours à 0

```
{
    "active_enerfy_out_d01": 0,
    "active_enerfy_out_d02": 0,
    "active_enerfy_out_d03": 0,
    "active_enerfy_out_d04": 0,
    "active_power": 0,
    "active_power_max": 0,
    "active_power_ph_b": 0,
    "active_register_tier_delivered": "HP..",
    "apparent_power": 550,
    "available_power": 30,
    "average_rms_voltage_meas_period": 0,
    "current_date": "",
    "current_index_tarif": 0,
    "current_price": "",
    "current_summ_delivered": 0,
    "current_tarif": "HC..",
    "current_tier10_summ_delivered": 0,
    "current_tier1_summ_delivered": 7828.158,
    "current_tier2_summ_delivered": 7452.224,
    "current_tier3_summ_delivered": 0,
    "current_tier4_summ_delivered": 0,
    "current_tier5_summ_delivered": 0,
    "current_tier6_summ_delivered": 0,
    "current_tier7_summ_delivered": 0,
    "current_tier8_summ_delivered": 0,
    "current_tier9_summ_delivered": 0,
    "days_number_current_calendar": 0,
    "days_number_next_calendar": 0,
    "days_profile_current_calendar": "",
    "days_profile_next_calendar": "",
    "drawn_v_a_max_n1": 0,
    "linkquality": 255,
    "message1": "",
    "message2": "",
    "meter_serial_number": "******************",
    "relais": 0,
    "rms_current": 2,
    "rms_current_max": 90,
    "rms_voltage": 0,
    "schedule_h_p_h_c": 0,
    "site_id": "",
    "start_mobile_point1": 0,
    "start_mobile_point2": 0,
    "start_mobile_point3": 0,
    "status_register": "",
    "stop_mobile_point1": 0,
    "stop_mobile_point2": 0,
    "stop_mobile_point3": 0,
    "update": {
        "installed_version": 13,
        "latest_version": 13,
        "state": "idle"
    },
    "warn_d_p_s": 0
}
```

J'ai tenté :
- De cliquer sur "reconfigure" dans la liste des appareils Zigbee2MQTT
- De redémarrer Zigbee2MQTT
- De tout mettre sur "auto"

Mais rien n'y fait, j'ai toujours le `active_power` sur zéro

Une idée de ce qui pourrait être mal configuré ?

Merci à vous

fairecasoimeme, 2023-09-25:
Bonjour,

si "active_power" représente la puissance active, elle n'existe pas dans le Linky. En mode historique, il n'y a que la puissance apparente qui est disponible sur le Linky.
pour la puissance active on peut (je crois la calculer), j'ai trouvé ceci : https://github.com/fairecasoimeme/Zlinky_TIC/issues/125#issuecomment-1486882150

AntoineLemaire, 2023-09-25:
Ah je pensais qu'il s'agissait de la consomation actuelle car le  `apparent_power` ne me semblait pas réaliste, et est toujours en dizaine

fairecasoimeme, 2023-09-25:
Apparent power, c'est la puissance en temps réel en VA. Du coup, le cos Phi n'est pas intégré et si certains appareils ont un mauvais rendement, le VA ne correspond pas au W. Malheureusement, c'est ce que donne le Linky.
D'autre part, si vous souhaitez avoir plus d'informations et un apparent power qui ne soit pas en dizaine, il faut faire la demande auprès de votre fournisseur d'énergie de passer le Linky en mode standard.

1.	Contacter votre fournisseur d'électricité ;
2.	Demander le passage de votre compteur Linky en mode standard en précisant qu’il s’agit de la prestation F185 auprès d'Enedis.
3.	Et c'est terminé !
Cette opération est gratuite et en général, le changement est effectué dans les 24 heures ouvrées. Les effectifs étant souvent sous l’eau, il n’est pas rare que cela prenne quelques jours supplémentaires.

Closed 2023-09-25.

Thread 209 (2023-10-04):

Écrire une documentation mise à jour pour ZHA

SeraphicRav, 2023-10-04:
Bonjour,

J'ai cliqué sur le "tutoriel" pour ZHA et ça m'a envoyé sur un commentaire d'une issue de plus d'un an que j'ai, je dois l'avouer, du mal à déchiffrer.

Je pense qu'il faudrait faire une documentation à jour, un peu plus pédagogique et illustrée pour un meilleur onboarding des utilisateurs.

fairecasoimeme, 2023-10-04:
Bonjour,
Si vous êtes à jour sur ZHA, vous n'avez rien à faire si vous avez un abonnement "classique".
Les entités les plus courantes vont se créer automatiquement.
Le lien du turoriel permet d'aborder de manière avancée l'exploitation du Zlinky en ajoutant de nouvelles entités personnalisées.
Je vais modifier le README pour spécifier que le lien concerne un paramétrage avancé.

jarthod, 2023-12-14:
Bonjour,

Petite question sur le même sujet, je viens d'installer mon Linxee hier avec ZHA, je suis en abonnement "base", et j'ai les info suivantes qui sont remontés:
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

J'ai remarqué que:
- Le courant remonte mais arrondi à 1A près (limitation du linky?)
- La Puissance Apparente semble aussi dépendre du courrant arrondi car elle saute entre quelques valeurs significatives uniquement.
- La puissance en W reste à 0
- La tension reste à 0
- Le total en kWh semble OK

Est-ce que c'est le comportement attendu ? Si oui pourquoi les attributs sont crées quand même mais à zero ?

Ce sont probablement des information interessante pour la documentation qui est (je suis d'accord avec @SeraphicRav) un peu légère pour le moment ^^. Du coup on ne sais pas vraiment si ce qu'on voit c'est normal ou c'est un bug ou encore une mauvaise version. On ne sais pas non plus ce qu'il est possible de faire ou non avec une configuration avancé et si on en a besoin ou pas. (et encore je suis développeur mais je n'imagine meme pas un néophite dans ce thread)

Merci pour ce chouette produit tout de même :clap:

fairecasoimeme, 2023-12-15:
Bonjour,

* Le courant arrondi à 1A près --> limitation du Linky
* la Puissance apparente est arrondi à 10 VA --> limitation du Linky en mode historique. Demandez le passage en mode standard à votre fournisseur d'électricité pour ne plus avoir cette limitation
* la puissance en W n'existe pas dans le Linky
* la tension reste à 0 parce que vous n'êtes pas en mode standard

Ce comportement est attendu car il existe  2 modes possibles (historique et standard) avec le Linky et au moins 10 abonnements différents. De ce fait, les développeurs du plugin ont créés  ce qui leur semblait utile mais sans pouvoir prendre en compte le mode dans lequel vous êtes ou votre abonnement. Libre à vous de sélectionner les entités qui vous sont disponibles et utile.

Il vous faut plutôt consulter la documentation de la téléinformation Linky si vous voulez comprendre les valeurs.

jarthod, 2023-12-15:
Ok merci beaucoup pour ces information !

Closed 2023-10-04.

Thread 214 (2023-10-28):

Pas d'appairage, LED fixe

bpi175, 2023-10-28:
Bonjour,

Je viens de tenter pendant une petite heure d'appairer le Zlinky avec antenne à mon installation (Jeedom+Conbee2+deCONZ à jour) et rien ne semble fonctionner.
Au branchement du Zlinky sur les broches de téléinfo, il s'allume en LED bleue fixe. J'ai fait une première tentative comme ça mais sans succès.
Ensuite j'ai réinitialisé le Zlinky en appuyant sur le bouton link pendant au moins 10 secondes mais pas mieux. J'ai ensuite essayé plus de 10 secondes, en relachant et là la LED s'éteint brièvement puis se rallume fixe.
En fait, je n'ai jamais vu la LED clignoter pour signifier qu'elle est en mode appairage comme indiqué dans le manuel.

Comment faire ?

Merci d'avance.

bpi175, 2023-10-28:
Update car il y a eu du progrès. Après plusieurs modifications dans les fichiers DDF et un redémarrage du serveur Jeedom le Zlinky est apparu dans Jeedom sans même avoir fait de nouvelle tentative d'appairage. Il semblerait donc que le Zlinky était déjà appairé mais n'avait pas le bon fichier DDF (enfin, je suppose que c'est ça) et une fois le tout relancé, il a pu prendre le bon DDF.

Ce que j'ai fait sur les DDF, si ça peut servir à quelqu'un :
je suis allé dans le dossier /usr/share/deCONZ/devices/lixee (le sous-dossier lixee y existait déjà) et j'ai constaté dedans la présence de plusieurs fichiers .json relatifs aux différents cas de figure selon l'abonnement ou le mode TIC du linky (historique ou standard). Selon plusieurs topics vus ici et là, il semblerait que deCONZ ait tendance à ne pas sélectionner le bon fichier DDF parmi ceux déjà présents, et ce même si l'un de ces fichiers est en Gold au lieu de Draft.
J'ai fait simple, j'ai supprimé tous les fichiers DDF qui ne concernaient pas mon abonnement et mon mode TIC. J'ai quand même passé le fichier restant en Gold.
Pour assurer le tout, je l'ai aussi copié dans le dossier /home/jeedom/.local/share/dresden-elektronik/deCONZ/devices/lixee qui est l'un des dossiers où deCONZ cherche des infos sur l'appareil qu'on appaire.
Après redémarrage du serveur, le Zlinky a été reconnu dans Jeedom.

Seul problème, j'ai très peu de commandes par rapport à ce que le Lixee semble capable de remonter, mais j'ai l'essentiel (index de consommation, puissance soutirée surtout)

Thread 216 (2023-11-04):

Zigbee2mqtt 1.33

algernon2607, 2023-11-04:
Bonjour

Depuis la mise à jour de zigbee2mqtt 1.33 , l'intervalle de réception des infos est trop élevé (10 mn pour certains éléments).
Le changement de tarif est remonte parfois avec 10 mn de retard . Les infos d’énergie sont trop parcellaires et j'ai une dérive par rapport à la réalité (alors qu'avant c’était nickel) . Quand aux mesures de puissance , c'est devenu inexploitable .

J'ai bien essayé de modifier les polls ainsi que les intervalles mais rien n'y fait . Le z_linky est devenu inutile.
Avez une solution autre que de restaurer zigbee2mqtt 1.32  ??

al

 Core 2023.11.0
Supervisor 2023.10.1
Operating System 11.1
Interface utilisateur 20231030.1

fairecasoimeme, 2023-11-06:
avez-vous lu cette issue : https://github.com/fairecasoimeme/Zlinky_TIC/issues/194 ?

algernon2607, 2023-11-06:
Bonjour
Oui j’ai lu cette issue et dans mon cas, j'y avais pallié avec la whitelist et avec le filtrage .
Mais bon tant pis ....!
Je vais trouver autre chose ...
Merci en tous cas de votre réponse ..

Closed 2023-11-06.

Thread 222 (2023-12-04):

Consommations Tempo Jour Rouge non remontées

adrienball, 2023-12-04:
J'utilise le zlinky_tic avec une passerelle Conbee II, j'ai récemment basculé sur l'option Tempo et autant les consommations des jours bleus et blancs (heures pleines et heures creuses) ne posent pas de soucis, autant les consommations des jours rouges ne sont pas correctement remontées.
Initialement je pensais que le problème provenait du plugin deCONZ (lié a la passerelle Conbee II), mais après avoir pas mal creusé et étant donné que la configuration (fichier DDF, etc) est identique pour les autres couleurs de jours, je commence à me demander si le problème n'est pas du côté du zlinky_tic.
Plus précisément, sur l'interface du plugin deCONZ, les attributs 0x0108 et 0x010A (HC jour rouge, HP jour rouge) sont correctement lus lorsqu'on demande une lecture manuelle des attributes, mais l'API REST exposée par le plugin ne renvoie pas de valeurs, et se comporte donc comme si elle ne recevait jamais de mise a jour pour ces attributs.

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

@fairecasoimeme est-il possible qu'il y ait une spécificité liée au jour rouge, côté zlinky_tic, qui pourrait expliquer ce problème ?
Est-il utile de reboot le zlinky_tic suite au passage en option tempo ? Etant donné que les autres jours fonctionnent correctement, j'en ai déduit que ce n'était pas nécessaire.
Je suis arrivé à bout de tous mes efforts de debugging, en vain, et c'est très frustrant d'avoir un dashboard grafana sur lequel il manque juste les jours rouges 😬
Merci pour votre aide!

fairecasoimeme, 2023-12-05:
Bonjour,
Si les valeur 0x0108 et 0x010A sont correctement remontée sur deConz, et que les valeurs ne le sont pas sur le plugin, c'est :
* Soit un problème de DDF ou de l'API ou du plugin
* soit le config report qui n'a pas été bien configuré.

adrienball, 2023-12-05:
Voici les bindings que j'ai défini dans mon fichier DDF pour l'option tempo:
```
{
  "bindings": [
    {
      "bind": "unicast",
      "cl": "0x0702",
      "report": [
        {
          "at": "0x0000",
          "change": "0x00000001",
          "dt": "0x23",
          "max": 300,
          "min": 60
        },
        {
          "at": "0x0001",
          "change": "0x00000001",
          "dt": "0x23",
          "max": 300,
          "min": 60
        },
        {
          "at": "0x0100",
          "change": "0x00000001",
          "dt": "0x23",
          "max": 300,
          "min": 60
        },
        {
          "at": "0x0102",
          "change": "0x00000001",
          "dt": "0x23",
          "max": 300,
          "min": 60
        },
        {
          "at": "0x0104",
          "change": "0x00000001",
          "dt": "0x23",
          "max": 300,
          "min": 60
        },
        {
          "at": "0x0106",
          "change": "0x00000001",
          "dt": "0x23",
          "max": 300,
          "min": 60
        },
        {
          "at": "0x0108",
          "change": "0x00000001",
          "dt": "0x23",
          "max": 300,
          "min": 60
        },
        {
          "at": "0x010A",
          "change": "0x00000001",
          "dt": "0x23",
          "max": 300,
          "min": 60
        }
      ],
      "src.ep": 1
    },
    {
      "bind": "unicast",
      "cl": "0x0B04",
      "report": [
        {
          "at": "0x0505",
          "change": "0x00000001",
          "dt": "0x21",
          "max": 300,
          "min": 60
        },
        {
          "at": "0x0508",
          "change": "0x00000001",
          "dt": "0x21",
          "max": 300,
          "min": 60
        },
        {
          "at": "0x050F",
          "change": "0x00000001",
          "dt": "0x21",
          "max": 300,
          "min": 60
        }
      ],
      "src.ep": 1
    },
    {
      "bind": "unicast",
      "cl": "0xFF66",
      "report": [
        {
          "at": "0x0005",
          "change": "0x00000001",
          "dt": "0x21",
          "max": 300,
          "min": 60
        }
      ],
      "src.ep": 1
    }
  ]
}
```

Cela se traduit de cette façon dans le plugin deCONZ (pour les deux derniers attributs correspondant a Tempo Rouge):

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

Ai-je raté quelque chose ?

adrienball, 2023-12-09:
> Pouvez-vous faire un config report manuel sur ces deux valeurs et avoir les statut de retour ?

Je ne suis pas sur de savoir ce que ça veut dire, et comment faire ça, pouvez-vous m'éclairer un peu ?
Merci!

adrienball, 2023-12-09:
J'ai modifié les bindings car le type spécifié pour les différents index était u32 alors que la doc du zlinkty_tic spécifie du u48, je ne suis pas sur que ça règle mon problème car les index de jours bleus et blancs fonctionnaient correctement malgré ça.
Par ailleurs, lorsque je lis la report configuration des attributs 0x0108 et 0x010A, tout semble normal:
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

adrienball, 2023-12-10:
Bon j'ai fini par désappairer / ré-appairer le zlinky_tic et tous les attributs sont désormais remontés correctement.
Merci pour votre aide en tout cas

Closed 2023-12-10.

Thread 232 (2024-01-04):

MAJ Non OTA sur nouvel hardware sans connecteur noir

tadikwa, 2024-01-04:
Hello,
je me permet d'ouvrir un ticket pour demander une précision par rapport à la mise à jour non ota sur le nouveau dongle.

En effet, depuis que je l'ai, il est bloqué en v1 (d'après mqtt sur home asssitant) je ne parviens pas à faire la maj en ota,
et je souhaitai le faire via le module usb ttl.

J'en ai maintenant un (même deux merci amazon).

Sauf que, j'ai pas vraiment envie de me lancer dans de la soudure, les connecteurs étant juste des trous, auriez vous une solution simple pour faire le contact provisoirement sans soudure pour faire la maj v13 ?

Un truc magique sur amazon pour connecter des trous en moins de deux ?

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

`    "update": {
        "installed_version": 1,
        "latest_version": 13,
        "state": "available"
    },`

JigSawFr, 2024-01-05:
Personnellement j'ai utilisé ça: Hailege 2pcs CP2102 USB 2.0 to TTL UART Serial Converter Module 5Pin STC PRGMR with Dupont Wire https://amzn.eu/d/2ySRu3R

Le tout en maintenant les broches dans les trous ;) sans soudures !

florianbelhomme, 2024-01-05:
Attention Z2M/MQTT peuvent être menteur sur la version du firmware si vous aviez déjà associé le Zlinky par le passé.
Si vous avez effectué la MAJ du firmware et que vous avez eu un message de succès sur le logiciel de MAJ, mais qu'après ré-association vous voyez toujours le numéro de firmware précédent dans HA, voici une manip que vous pouvez tester pour être sûr :

- une fois le Zlinky associé
- sélectionnez le dans la liste des appareils
- cliquez sur l'onglet "console dev"
- dans "groupe de fonctionnalités" sélectionnez "genBasic"
- puis dans "attribut" sélectionnez "swBuildId"
- enfin cliquez sur le bouton vert "lire"

Z2M va demander en direct le numéro de version au Zlinky, elle va s'afficher en JSON en dessous du bouton. Comparez avec ce que vous attendiez puis avec ce que Z2M affiche dans les pages "user friendly".

CF : https://github.com/fairecasoimeme/ZiPulses/issues/21#issuecomment-1793840520

tadikwa, 2024-01-05:
J'ai le même module. Cependant, c'est difficile d'obtenir un contact ok.
Je voyais sur l'autre ticket du ZiPulse, des gens galéré comme moi : https://github.com/fairecasoimeme/ZiPulses/issues/21

Je trouve compliqué d'arrivé à brancher la clef en tenant le module de travers pour faire contact tout en appuyant sur le bouton flash puis le relâchant en maintenant la clef et le module dans leur position.  J'ai juste le droit à un sapin de noël avec les voyants.

Savez qu'elle devrais être l'état des voyants du USBTTL au branchement ?

fairecasoimeme, 2024-01-05:
Il est très probable que votre ZLinky soit déjà à jour. le plugin Z2M ne va pas chercher la bonne valeur de version au bon endroit.
Pour avoir la bonne version de votre appareil, il faut interroger manuellement le cluster : 0x0000 attribut : 0x4000. Si la valeur retournée est 4000-0013 c'est que vous êtes à jour. (ce qui est surement le cas car ça va bientôt faire un an que cette version a été release)

tadikwa, 2024-01-05:
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

j'ai testé avec mes p'tites rallonges mais toujours pareil, soit read error ou rien.

Si je branche la clef avec le branchement et le bouton flash appuyer alors j'ai aucun voyant.

Si je branche la clef sans appuyer sur flash, alors j'ai le tx en fixe et le RX qui fini par clignoter au bout de 5 secondes et tjrs le mm résultat read error au flash

tadikwa, 2024-01-05:
Bon en effet si je lis via Z2M, le firmware semble déjà à jour.

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

JigSawFr, 2024-01-05:
J'avais du inverser le sens du branchement sur la mienne et j'ai utilisé du scotch pour maintenir les contacts 🤣

Dites33, 2024-01-05:
Hello

On pourrait ouvrir un ticket Z2M pour faire corriger le support et la lecture de la bonne valeur ? :)

tadikwa, 2024-01-05:
> J'avais du inverser le sens du branchement sur la mienne et j'ai utilisé du scotch pour maintenir les contacts 🤣

J'ai testé d'inverser le tx et le rx (on ne sait jamais) mais non pas de résultat.

Au final, j'ai rebrancher le dongle, z2m doit surement se tromper sur la valeur à remonter pour le firmware installé.

Tant que ça marche c'est ok :)

tadikwa, 2024-01-05:
> Hello
>
> On pourrait ouvrir un ticket Z2M pour faire corriger le support et la lecture de la bonne valeur ? :)

Bonne idée.
En plus sur la nouvelle version 1.35.0 y'a des trucs en + pour le lixee

fairecasoimeme, 2024-01-08:
D'après les captures d'écran (led bleu allumé sur le module TTL), je pense que vous avez grillé l'entrée RX du MCU (en faisant une mauvaise manip)
Vous pourrez mettre à jour OTA mais malheureusement, la mise à jour par USB ne pourra plus se faire.
Fred

tadikwa, 2024-01-10:
Ok, par contre j'ai testé avec deux modules USB TTL neuf et les deux ont le même comportement.

De toute façon j'abandonne la MAJ et j'ouvre un ticket chez Z2M pour l'histoire de remontée de version

Closed 2024-01-10.

Thread 233 (2024-01-05):

Zlinky_TIC do not pair when moving from ZHA to Zigbee2MQT

pouilld, 2024-01-05:
HAOS 11.3 CORE 2024.0
HW RPI 4
controller Zigbee 3.0 USB Dongle plus (E)

Using the ZHA Zigbee integration, the Zlinky TIC module has been recognized, and paired without problem.

I decided to move from the ZHA integration to zigbee2mqtt without changing anything the zigbee network(controller & devices).
As recommended, I first remove the ZHA integration before installing Zigbee2mqtt (all zigbee devices and entities were removed).
After install/configuration of Zigbee2mqtt, I was able to pair ALL my zigbee devices BUT the Zlink_TIC module (after resetting it), even after installing a additional router near of the module (this was not necessary when using the ZHA integration). The module led flash quickly (waiting pairing) but do not pair.
I am stuck at that point and help will be appreciated.

More info:
when stopping zbigbee2mqtt and starting the zigbee home assistant intégration the Zlinky_TIC pair immediately without problem.
This imply that the reason for not been able to pair the Zlinky_TIC is note related to the SONOFF controller or the zigbee network but in the linky integration into zigbee2mqtt.

nerthazrim, 2024-01-10:
I recently moved from a PiZigate+ on a RPI3 to the same Sonoff dongle on a virtualized server and also moved from ZHA to Z2M. I did not have any issue.

When you "Permit join" on Z2M, do you select the coordinator only? Or do you Permit Join (All)? Sometimes devices do not like to be routed and need direct link with the coordinator, have you tried that?

Also, have you tried disconnecting the ZLinky completely from the Linky, re-attaching it and retried the pairing?
Last idea: try to push the reset button for more than 15s, release, then Permit join on Z2M and reset Zlinky for 5s. That's what I did when I moved, without problem.

pouilld, 2024-01-19:
I have replaced my actual coordinator (SonOFF  Zigbee 3.0 USB Dongle plus (E)  EFR32MG21) by a ZIGATE V2 USB dongle (firmware  ZIgate2-3a0.
Now the Zlinky **pair with Z2M** (as well as all other devices).
So, the problem seems related to an incompatibility between Z2M  and this version of the Sonoff coordinator.
However, with the ZIgate coordinator, it is not possible to upgrade the Zlinky firmware using OTA and it s is a problem already known by the Zlinky manufacturer.

nerthazrim, 2024-01-19:
I seriously doubt incompatibility is the reason, as I've done pretty the same thing as you very recently and changed my coordinator from a PiZigate+ with ZHA to a SonOFF Zigbee 3.0 USB Dongle plus (E) with Z2M.
Worked like a charm without any problem for pairing.

pouilld, 2024-01-19:
In that case, I don't see  an explanation why by just replacing the Sonoff coordinator by the ZIgate, the Zlinky that was unable to pair with Z2M was now able to pair with Z2M.
Please note that in both case, the network was reinitialized by the coordinator on the same Zigbee channel (11).

pouilld, 2024-01-23:
After doing a "full reset" (re-initialization of the zigbee network, removing devices and entities in HA, uninstall of Z2M, deleting the Z2M configuration folder in ZHA, and installing Z2M again, I was able to successfully  pair the Zlinky with Z2M.
I also was able update thru OTA the Zlinky firmware to V13.
Unfortunately after the update, some information about my "HP-HC" were not anymore sent by the Zlinky.
Thanks for your help,
Daniel

pouilld, 2024-01-23:
subject closed, thanks

Closed 2024-01-23.

Thread 236 (2024-01-21):

Coupure de l'alimentation du zlinky par le Linky : que faire ?

jessycler, 2024-01-21:
Bonjour,
Je possède un zlinky depuis environ 9 mois, et j'étais ravi de son fonctionnement sous HA via Z2M.
Il y a 15j, je n'avais plus de remontée des infos zlinky dans HA. En allant voir le Linky, j'ai vu que le voyant bleu du zlinky était éteint...
Je l'ai donc débranché du Linky, puis rebranché, sans qu'il ne redémarre. Je l'ai laissé débranché, pensant qu'il était en panne. Le lendemain, par acquis de conscience,  je l'ai rebranché. Et là "miracle", la led bleue s'allume, et directement les infos remontent dans HA. Ouf !
Sauf qu'hier, bim, plus de remontée dans HA, je vais voir le zlinky, il est éteint...

J'ai lu par ailleurs sur un forum, que le Linky pouvait mettre en "protection" l'alimentation via les bornes TIC. Cela expliquerait que le zlinky s'éteigne. Est ce vrai ? Et si oui, pourquoi se met il en protection ? Est ce un défaut du Linky ou du zlinky ? Faut il que je fasse une demande de SAV pour mon zlinky ? Ou pour le Linky chez Enedis ?

Merci de partager avec moi vos connaissances sur le sujet ;-)

fairecasoimeme, 2024-01-22:
Bonjour,
Oui par expérience cela peut arriver sur un Linky qui se met à jour ou lors d'une mauvaise manipulation ou lors de microcoupure. C'est propre au Linky et Enedis investigue sur ce genre de phénomène.
Fred

jessycler, 2024-01-22:
Merci Fred pour la réponse,
Donc il faudrait que je demande à Enedis s'ils peuvent faire quelque chose ?
J'ai oublié de préciser que j'avais en parallèle 2 fils branchés sur le bornier TIC du Linky (bornes 1 et 2), en plus du zlinky, qui transmettent le signal TIC à une borne de recharge de VE (permet de faire du délestage).
Je pensais que ça ne poserait pas de problème (quand le zlinky ne s'éteignait pas, je n'avais pas ces deux fils), mais est ce que ça pourrait avoir un lien avec une "mise en protection" du Linky ?

nicolas-r, 2024-02-06:
Salut,
je pense que j'ai le même problème, mon zlinky ne s'allume plus et j'ai essayé avec un autre modele sans antenne et il ne s'allume pas non plus. Je penche donc pour un probleme coté Linkly mais je sens venir la galère avec Enedis...

Je vais tenter de les contacter et on verra bien

nicocha75, 2024-02-08:
bonjour, perso depuis 2 jours, plus de remonté, LED éteinte.
J'ai donc rapatrier à la maison pour alimenté via la pris de programmation., et ça fonctionne. Le problème vient donc du linky et certainement d'une mise a jours qui a coupé l'alimentation TIC.

nicolas-r, 2024-02-08:
J’ai envoyé un mail à Enedis il y a deux jours mais pas encore de réponse. Mais quand on voit que l’espace client est en rade depuis plusieurs jours, plus rien ne m’étonne.

Je vais les appeler demain pour tenter d’avancer

fairecasoimeme, 2024-02-08:
Essayez de rebrancher le ZLinky. Après une courte ou longue période de coupure, l'alimentation revient parfois.

nicolas-r, 2024-02-09:
Je l'ai rebranché ce matin et toujours rien. J'ai appelé Enedis qui m'a dit que cela arriver parfois en effet et m'a demander d'appeler mon fournisseur d'électricité afin qu'il fasse une demande F920.

J'ai donc appelé EDF qui a initié la demande et Enedis devrait m'appeler lundi pour convenir d'un rendez-vous

A suivre

nicolas-r, 2024-02-15:
Bonjour

toujours pas de nouvelles de la part d'Enedis et/ou d'EDF. Je vais le rebrancher dans la journée pour voir s'ils n'auraient pas fait un truc à distance au cas où

nicocha75, 2024-02-15:
Bonjour,
Si enedis 1 reseter le linky, et samedi matin, après un débranchement durant 2h, ça a refonctionné.
Ça n'a pas marché pour toi?
La classe, EDF m'a bien rappelé pour savoir si tous fonctionnait.

nicolas-r, 2024-02-16:
Toujours rien pour moi et pas de news d'EDF/Enedis

Je vais faire tirer un câble entre mon compteur en limite de propriété et l'intérieur de la maison pour ne plus dépendre de l'alimentation de la prise TIC

Allsimon, 2024-05-08:
est-ce que vous avez trouvé un fix ? mon linky est down depuis le 7 avril et ne s'est jamais rallumé depuis

nicocha75, 2024-05-19:
Salut, WE prolongé, et pas de chance certainement enedis qui à refait un update du linky, plus d'alimentation. Galère cette gestion à la noix du linky. Question, savez vous si on peut directement alimenté le module entre I1 et A avec une alimentation 5V, afin de ne plus dépendre de l'alimentation du linky?

nicolas-r, 2024-05-19:
Hello

je viens de tester mes deux ZLinky sur le compteur d'un ami et aucun ne s'allument. Il a un compteur Sagem et moi un Honeywell. On a testé avec un appareil de mesure et il y a bien du courant qui sort du port TIC.

Pour ma part, le câble a été tiré donc je n'ai plus besoin du Zlinky pour le moment

VianneyHENON, 2024-06-13:
> Essayez de rebrancher le ZLinky. Après une courte ou longue période de coupure, l'alimentation revient parfois.

Bonjour, est-ce que utilisé une [alimentation externe](https://github.com/fairecasoimeme/Zlinky_TIC/issues/262) avec un module 5V pourrait éviter ce désagrément ?

fairecasoimeme, 2024-06-17:
Bonjour, Oui si vous n'utilisez pas l'alimentation de la prise TIC du Linky, vous n'aurez pas ce type de problème.

Deejayfool, 2024-10-02:
Hello tout le monde,
J'ai exactement ce même soucis et j'avoue que débrancher/rebrancher le ZLinky est plutôt ennuyant. Le problème revient quasiment tous les 2 mois.
Est-ce que quelqu'un a des news de la part d'EDF/Enedis sur une correction de ce problème ?
Ou bien est-ce que quelqu'un a une solution de contournement simple ? (parce que la solution de l'alimentation externe semble hors de mes compétences 😅)

fairecasoimeme, 2024-10-03:
Contactez-moi sur le mail de lixee pour tenter avec un échange... sait-on jamais.

fairecasoimeme, 2024-10-07:
Bonjour,

Non pas encore de version plus récente (bientôt) mais si vous le souhaitez on peut tenter aussi de faire un échange aussi mais sans garanti de changement. (surtout si cela provient du Linky)

CyrilM81, 2025-01-15:
Bonjour à tous,

Ce qui vous arrive avec les modules tic qui stoppent de fonctionner m'est arrivé plusieurs fois . Je n'en connais pas la cause mais le resultat est l'arrêt total du fonctionnement du module installé sur le TIC.
De mon coté , J'ai résolu le problème de manière simple et efficace . Sur le coté de l'emplacement du TIC se trouve un fusible dans un morceau de plastique noir, dévissez le , sortez le , attendez 30 secondes, et replacez le fusible !
Dans mon cas , le fusible n'a jamais grillé , mais le fait de le sortir affectue un RESET de l'electronique qui gère la fonctionnalité TIC dans le Linky .

Pour moi cette technique a marché à chaque fois ....

J'espère que pour vous aussi ...

Deejayfool, 2025-06-19:
Bonjour,
J'ai envoyé un mail en octobre dernier comme demandé afin de tenter un échange mais je n'ai jamais eu de retour.
Du coup je voulais savoir si certaines personnes étaient passé au Lixee v2 et si le problème survenait encore avec cette nouvelle version ?

fairecasoimeme, 2025-06-19:
avez-vous envoyé un mail à contact[at]lixee.fr ? Retenter ce jour en mettant le lien ou votre pseudo dans le mail pour que je puisse faire le lien

Deejayfool, 2025-06-19:
Oui c'était bien à cette adresse que j'avais écrit. Je viens de vous renvoyer un mail à l'instant. Merci à vous 🙏.

Thread 238 (2024-02-06):

ZLinky ne s'allume pas

philuxe, 2024-02-06:
Bonjour,

Je viens de recevoir le module mais ce dernier ne s'allume pas:

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

que faut il faire ?

philuxe, 2024-02-06:
j'ai tenté la mesure avec un multimètre mais je pense que les sondes sont trop epaisses pour faire contact donc forcément 0 courant.

du coup j ai essayé de plugin le Zlinky dans un autre Linky et ca ne marche pas non plus, tjs pas de LED

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

ketourneau, 2024-02-09:
J'ai le même problème avec le ZLinky reçu hier. Il ne s'allume pas non plus.

ketourneau, 2024-02-09:
Je pense que c'est en lien avec #236

ketourneau, 2024-02-09:
J'ai contacté EDF qui va faire la demande à ENEDIS pour passer la prise TIC du Linky en mode "Standard" à voir si ça corrige le problème.

https://particuliers.engie.fr/aide-contact.html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

philuxe, 2024-02-16:
recu nouveau module, il s'allume correctement

ketourneau, 2024-02-16:
Après avoir vérifié avec un voltmètre j'ai bien une tension. Le boîtier zlinky est donc défectueux, quel est la procédure pour un échange ?

hichamC31300, 2024-08-29:
Bonjour
Je rencontre le même problème. Tension de 16V aux bornes du Linky. Mon zlinky reste quand même éteint. Pensez-vous qu'il est défectueux ?

Closed 2024-02-16.

Thread 243 (2024-03-14):

Z2T Cannot not able to receive attribute reporting after subscription

xav-git, 2024-03-14:
Hello,

I have integrated the Lixee dongle on a Sonoff ZBbridge Pro running Tasmota 13.4.0.2, using Z2T to push the Sensor information to MQTT broker.  Zigbee integration is successfull and I can `read` data:
```
20:16:14.302 CMD: ZbSend { "device":"0xCDAB", "endpoint":"0x01", "cluster":"0x0702", "read":["0x0000", "0x0100","0x0102"]}
20:16:14.317 MQT: stat/tasmota_lixee/RESULT = {"ZbSend":"Done"}
20:16:14.858 MQT: tele/tasmota_lixee/SENSOR = {"ZbReceived":{"0xCDAB":{"Device":"0xCDAB","Name":"Lixee","CurrentSummationDelivered":"0x000004A36C4D","0702/0100":"0x00000293D209","0702/0102":"0x0000020F9A44","Endpoint":1,"LinkQuality":29}}}

```

I am also able to bind to cluster `0x0702` :
```
21:45:32.948 CMD: Zbbind {"Device":"0xCDAB","Cluster":"0x0702","Endpoint":1}
21:45:32.958 MQT: stat/tasmota_lixee/RESULT = {"ZbBind":"Done"}
21:45:33.098 MQT: tele/tasmota_lixee/RESULT = {"ZbBind":{"Device":"0xCDAB","Name":"Lixee","Status":0,"StatusMessage":"SUCCESS"}}
```

And Verify bind is successful :
```
21:46:11.373 CMD: zbbindstate 0xCDAB
21:46:11.385 MQT: stat/tasmota_lixee/RESULT = {"ZbBindState":"Done"}
21:46:11.476 MQT: tele/tasmota_lixee/RESULT = {"ZbBindState":{"Device":"0xCDAB","Name":"Lixee","Status":0,"StatusMessage":"SUCCESS","Total":1,"Start":1,"Bindings":[{"Cluster":"0x0702","Endpoint":1,"ToDevice":"0x00124B002C400527","ToEndpoint":1}]}}
```

However the issue I have is that the lixee is not sending the reportable information availble in cluster `0x0702`

yes I am not sure if the problem comes from Tasmota or Lixee, but I would like to confirm that sensor reporting is supported and that the bind to cluster is the correct way to receive such reports.

Thanks.

fairecasoimeme, 2024-03-14:
Hi,
You need to do a "Configure Report" after a "Bind" to get reportable information.
Just a bind is not enough
Fred

xav-git, 2024-03-21:
This problem has been resolved in https://github.com/arendst/Tasmota/discussions/20952 with a fix in tasmota.
Tasmota now successfully receives sensor report from Lixee.

However it seems that `ReportableChange` is not taken into account by Lixee. Indeed the lixee will always report sensor values after `MaxInterval` is passed, although it can be verified that counters always changes.
Is this an expected behavior ?
Thanks.

fairecasoimeme, 2024-03-22:
Sorry but reportable change works with others systems

xav-git, 2024-03-22:
Thanks, for your answer.
From your comment I understand that you suspect that the coordinator (in this case Tasmoata Z2T) is the problem ?

So if if this is the case it should be the  report config of `ReportableChange` that is not  achieved correctly ?

Thread 245 (2024-03-17):

Problème avec abonnement HC et Week-End

anthonycorreia, 2024-03-17:
Bonjour,

J'ai un abonnement HC et Week-End sur un Linky en TIC mode standard et a chaque changement de tarif (HC, HP, WE) le module arête d'envoyer les infos.

Ma config :

Zlinky_TIC 13
Zigbee2MQTT 1.36.0-1
Mosquitto broker 6.4.0
Home Assistant Core 2024.3.1, Supervisor 2024.03.0, Operating System 12.1

Dispo pour tout autre info

fairecasoimeme, 2024-03-18:
Bonjour,
Le ZLinky n'a aucun traitement particulier lors d'un changement de tarif. Il n'y a aucune raison directe engendrant un arrêt d'envoi selon ce paramètre.
Je ne pense pas que le ZLinky arrête d'envoyer des données mais plutôt qu'une perturbation bloque la réception.
Il faut vérifier qu'un changement de tarif n'engendre pas le démarrage d'un moteur (qui peut entrainer des perturbations) ou qu'une prise connectée n'inonde pas le réseau etc ...

DolmensDude, 2024-03-25:
not certain, this is the same, but I have roughly the same config:

Core. 2024.3.3
Supervisor. 2024.03.0
Operating System. 12.1
Frontend. 20240307.0

Device info
Lixee ZLinky (ZLinky_TIC)
by LiXee
Connected via [Zigbee2MQTT Bridge]
Firmware: 4000-0013

Issue being that regardless of whether config'd via ZHA or zigbee2MQTT, the Zlinky is report all consumption on in the 1st rate, and also always shows the current tariff as BASE, even though on the Linky itself it shows my tariffs as HC, PH and Weekends...

I have no idea how to get the Zlinky to properly report parameters correctly.  The usage per hour is correct, it's just not well aligned with the Linky itself, with no idea who to look to for fixing this?

In ZHA, the quirk file is seemly not doing anything?, does this need to be an exact match firmware and quirk file?
in MQTT mode, which is the one recommended in the instructions here, again, doesn't match.
EDF & Moi app on the iPhone *does* split out by tarif, but is a day "late" in reporting.
Enedis, using the ConsoAPI via Linky integration is also correct, but again sees all consumption as one tariff.

Who do I look to to get this resolved?  Have gone back and forth twice now between ZHA and MQTT mode... only advantage to MQTT was that I could get the update via OTA as that's currently disabled in ZHA...

Sensors

ADSC
--------------
ADIR1
0 A

ADIR2
0 A

ADIR3
0 A

Energy
105,385 kWh

IINST1
1 A

IINST2
2 A

IINST3
1 A

IMAX1
60 A

IMAX2
60 A

IMAX3
60 A

ISOUSC
30 A

MOTDETAT
None

NGTF
BASE

PAPP
1,190 VA

PMAX
6,410 W

PPOT
None

PTEC
TH.

KanaChan06, 2024-04-27:
Bonjour,

J'ai le même problème que DolmensDude.
Je suis en EDF Zen Weekend (sans HC) et tout remonte sur la première ligne de BASE, même le weekend.
Savez-vous comment faire pour mapper le changement de tarification ?
Merci.

DolmensDude, 2024-04-27:
this problem is resolved for me as of 5 days ago.

You need to log into your EDF account online and change under your preferences (profile) that you want "standard" data, so no historical data.

***AND*** (this too is required)

EDF needs to request of Enedis, since they manage the Linky, that Enedis do a so-called "F185 prestation".

The next day, you will start to receive data, but this too will still be garbage, but once it's different garbage, you have only one more step to do.

**Last step**, disconnect HomeAssistant from the Linky (lose the bluetooth connection), and then reconnect (via bluetooth) to the Linky... It will then "know"...

You will receive separate data for tier 1, tier 2, and tier 3, tier 1 is lower rates during the week, tier 2 is normal rate, and tier 3 is the weekend, even if this is the same as your tier 1 rate.

It took weeks to get this fixed, mostly due to EDF saying that Enedis required proof that this data was wrong.  Waited 3 weeks and I sent a reminder email to the customer service folks, and the next evening it was all done.

It is that I do not write French, otherwise I would want to help write up the steps needed when using standard zigbee versus MQTT bluetooth.  I'm a retired technologist - this was not easy to do for "normal folks". These days, I'm trying to be more like a normal person instead of a technologist. :-)

At the end of the day, it *is* working here now and I can begin to do with this what I needed/wanted to do!

DolmensDude, 2024-04-27:
adding to help close this one - I switched to ZHA, and then went the steps above. It works.

There might be benefit to going the zigbee2MQTT route, but I really wanted to use "standard" ZHA. Ultimately, I got this to work and have been happy to see this data come into HA.  There is still work to be done, but at least consumption per hour data is good.

KanaChan06, 2024-05-02:
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

Hello,
Thanks for the help.
I have set the TIC up from the Website but, even if I have received an email from EDF to tell me I am in standard mode, then the Linky says I am in "historique" mode for the TIC onto its interface.
I have sent a demand from a form, I will see if it works better.

SeafireGit, 2024-09-14:
Issue can be closed, right ?

KanaChan06, 2024-09-14:
Hello,

Yes. It can be.

Thanks.

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

Closed 2024-09-14.

Thread 247 (2024-03-22):

[Question] Is it possible to have the value of each phase reported individually?

Emeraude998, 2024-03-22:
Hello,

I have integrated the zlinky_tic device on my Home assistant installation using ZHA and a Zigbee dongle on my server. The device shows up correctly and I have multiple sensors created with values on some of them and 0 on some others.
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
I was able to determine that the values of `Tier 1 summation delivered` and `Tier 2 summation delivered` corresponded respectively to off-peak hours and peak hours.

I saw on my electric meter that there are also values for each of the phases on my circuit and I would like to know if it would be possible to report those values as sensors in Home Assistant.

---
<details>
  <summary>En Français</summary>

Bonjour,

J'ai intégré le dispositif zlinky_tic dans mon installation Home Assistant en utilisant ZHA et un dongle Zigbee sur mon serveur. Le dispositif apparaît correctement et j'ai créé plusieurs capteurs avec des valeurs sur certains d'entre eux et 0 sur d'autres.
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
J'ai pu déterminer que les valeurs de `Tier 1 summation delivered` and `Tier 2 summation delivered` correspondent respectivement aux heures creuses et aux heures de pointe.

J'ai vu sur mon compteur électrique qu'il y a aussi des valeurs pour chacune des phases sur mon circuit et je voudrais savoir s'il serait possible de rapporter ces valeurs en tant que capteurs dans Home Assistant.

</details>

fairecasoimeme, 2024-03-25:
Bonjour,

Pour avoir plus d'informations de votre Linky, il faut que vous demandiez à votre fournisseur d'électricité de passer en mode standard.
Pour ajouter de nouveaux capteurs, il faut suivre le tuto : https://github.com/fairecasoimeme/Zlinky_TIC/#zha
Pour connaitre tous les éléments existants de votre Linky vous pouvez suivre le tableau de correspondance suivant : https://github.com/fairecasoimeme/Zlinky_TIC/#README
et lire le document technique de Enedis : https://www.enedis.fr/media/2035/download

Thread 249 (2024-03-27):

how can we get a complete quirk for ZHA implementation v12/13? I think there's promise here, but what a mess ;-)

DolmensDude, 2024-03-27:
before anyone say to use zigbee2mqtt, I tried that route 3 times already, and garbage/partial/incomplete data from ZLinky to HomeAssistant too, so I would have a slight preference for native ZHA, *if* we can (help) get the quirk to actually match all of the various parameters available.

I have EDF, HC/HP/Weekends. Have requested historical mode, without reporting per half hour from EDF.  No change yet, but still within the 72 hours they request to make such a change. We'll see... Debugging this is why I think we need a "full function" quirk, with everything exposed.

if a quirk cannot do this, then we should develop a sensors file to include in configuration file to expose everything.

Why request historical mode? 3-phase, seems according to docs seems to indicate I might need to stay with historical mode.

I have the external antenna version of the ZLinky.  It shipped to me one week ago with version v1 of the firmware. I updated to v13 using OTA functionality of the zigbee2mqtt integration.

What I think we need just to start is having a full quirk for the ZHA implementation, including the ability to *write* certain parameters, such as setting tri-phase mode.

Nice to have would be to put the useful/common sensors to also be defined, such as converting HA to kWh for at-the-moment current draw.

if getting the quirk to be complete is only a question of copy/pasting from the developer's documentation into some kind of table for the quirk, that's probably mundane work, but if we need someone to do it, I'll *help*, someone still needs to tell me exactly what to do, and receive that table or whatever it is back from me.

Oh, I speak and write English and Dutch, but not French - I'm having to machine translate everything to understand what I need to do. Am new to France, and therefore also ZLinky.

I'm not totally convinced my ZLinky is okay. It shipped with v1 firmware, even though lixee shop said it had to ship with v13... since I updated it, that issue is moot, but simple things like resetting... The docs say hold the reset button for 10 seconds and it will reset... Mine???  It doesn't matter at all how long I hold the button in (yes, I'm def hitting the button as the hole is slightly off)... It's when I *release* the button that it seemingly resets...

fairecasoimeme, 2024-03-28:
Sorry,

But the version 1 doesn’t exist. You can verify here : https://github.com/fairecasoimeme/Zlinky_TIC/releases
I have already tell you that HA don’t find the real version in the right location. HA verify the version in cluster / attribut corresponding to update version, not the release version. After OTA update the value is updated and you can get v13 but your device was already in v13. If when you paired the device, the blue LED blinked quickly, It was last version.

So … as I already said, if you want to get all of your indexs, you have to tell your electricity supplier to change your linky mode. By default, Linky is in historical mode (historical for historical subscription). Your subscription is not historical
So you have to ask standard mode with the Enedis F185 prestation.
After that you'll get all the subscription index.

Best regards,
Fred

DolmensDude, 2024-03-28:
Hi Fred.

“ So you have to ask standard mode with the Enedis F185 prestation.”

This should be front and center in the documentation. This means that changing the collection mode to standard in the EDF accounts preferences is not enough?

If… the z2m *also* reports the firmware incorrectly, out of the box, this too should be documented as today, OTA updates are not supported in the quirk file so no updates happen while using ZHA(since Feb of this year).

I literally sat there and watched the update happen under z2m to v13. If it was already v13, it would never have done yet. Pointless now, it’s on v13. If it was already v13, it would be in an update loop and it’s not.

Not in historical mode? Yes, it most certainly as is the other linkt integration in the HACS store, using historical data via Conso API must have that to work. I’m giving that up expecting this to work.

I used ZHA to retrieve values from the Zlinky yesterday. There is a mismatch. And values that should be filled are not, so yes, the ICT port and the Zkinky are not synced.

Will try to impress upon EDF to get that to present the correct data.

Switching to standard mode so that when I add solar panels, it will already be in standard mode, as that seemingly is required for “producers”.

Okay with everything if it eventually works, but both routes, ZHA and z2m, produce some non-sensical data with the exception of index 1, the total of HC and HP, only everything is in HC… even that is weird.

Will report back if it works or if there are remaining issues.

I found the actual quirks file source. Do you need help to get it to v13?

> On 28 Mar 2024, at 14:55, Fairesoimeme ***@***.***> wrote:
>
> So you have to ask standard mode with the Enedis F185 prestation.

Thread 252 (2024-04-02):

Mode producteur non vu

Fyr42, 2024-04-02:
Bonjour,

Enedis m'a passé en mode producteur le 30/03/2024 suite à ma demande d'auto-condo avec injection de surplus cédé à titre gratuit à Enedis (c'est les nouvelles options en plus des anciens CACSI et CAE)

Il y a bien un P sur la dernière ligne du bas de mon compteur. Toutefois la clé Lixee, après "remove" et "re assiciation" dans Home Assistant reste au même stade : les infos producteur ne sont pas vues en ZHA, sans que je comprenne vraiment ce que ZHA me donnerait.

Si je teste mon mode :

service: zha_toolkit.attr_read
data:
  ieee: 00-------------b3
    cluster: 65382  # 0xFF66
    attribute: 768  # 0x0300

zha_toolkit_version: v1.1.10
zigpy_version: 0.63.4
zigpy_rf_version: 0.38.1
ieee_org:
  - 179
  - 106
  - 210
  - 5
  - 0
  - 141
  - 21
  - 0
ieee: 00:-----------------b3
command: attr_read
command_data: null
start_time: "2024-04-02T15:10:08.270832+00:00"
errors: []
params:
  cluster_id: 65382
  attr_id: 768
  dir: 0
  tries: 1
  expect_reply: true
  args: []
  read_before_write: true
  read_after_write: true
  csvfile: zlinky
attr_type: "0x20"
write_is_equal: false
result_read:
  - "768": 1
  - {}
success: true

je suis en mode standard consommateur.

Mais si je pioche directement dans le EAIT j'ai bien les valeurs :

service: zha_toolkit.attr_read
data:
  ieee: 00:----------------:b3
  cluster: 1794  # 0x702
  attribute: 1  # 0x0001
  csvout: zlinky

zha_toolkit_version: v1.1.10
zigpy_version: 0.63.4
zigpy_rf_version: 0.38.1
ieee_org:
  - 179
  - 106
  - 210
  - 5
  - 0
  - 141
  - 21
  - 0
ieee: 00:-------------------:b3
command: attr_read
command_data: null
start_time: "2024-04-02T15:15:53.499644+00:00"
errors: []
params:
  cluster_id: 1794
  attr_id: 1
  dir: 0
  tries: 1
  expect_reply: true
  args: []
  read_before_write: true
  read_after_write: true
  csvfile: zlinky
attr_type: "0x25"
write_is_equal: false
result_read:
  - "1": 60177
  - {}
success: true

un peu plus de 60 kWh. Et ces valeurs change bien quand je suis en injection.

Y a un moyen de forcer en mode producteur ? Il me faut autre chose que ZHA ? J'automatise pour remplir un compteur avec ces valeurs ?

Merci

Fyr42, 2024-04-02:
En fait si ça passe très bien...

c'est reçu dans LiXee ZLinky_TIC Summation received  aka sensor.lixee_zlinky_tic_summation_received

Closed 2024-04-02.

Thread 256 (2024-04-14):

Changement de fournisseur - Perte des Consommations

Coldness00, 2024-04-14:
Bonjour,

Je suis passe de chez ENEDIS (Base) a EDF avec un tarif Tempo
Jamais eu le moindre soucis, en offre de base. Cependant depuis le passage chez EDF, je n'ai plus de remonte type Live comme la puissance ni l'Energie consommée, mais j ai le numero de mon PMR, la date et l'heure, la puissance souscrite ou encore le Tarif actuel (bleu).

Je fonctionne avec Z2M sur un Docker
Je suis passe du mode Historique a Standard (bien contrôle sur le Linky)
J'ai fait plusieurs resynchronisation
- soit en supprimant ou non le Linky du Mesh zigbee.
- j'ai débranché et rebranche le Lixee plus de 30min, mais sans succes.
- re configurtation du Lixee

Cependant, lorsque je vais dans le Dev Consol, que je sélectionne seMettering -> SumDelivered et autre information de consommation je recois bien l'information mais ne s'actualise pas apres.

Ci-joint screenshot de ma configuration ansi que de retour state:

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

State:
`{
    "available_power": 9,
    "current_date": "E240414183556",
    "current_index_tarif": 2,
    "current_price": "HP BLEU",
    "current_tarif": "TEMPO",
    "drawn_v_a_max_n1": 2615,
    "last_seen": "2024-04-14T16:35:56.361Z",
    "linkquality": 120,
    "message1": "PAS DE MESSAGE",
    "message2": "",
    "meter_serial_number": "VALEURCACHECONFIDENTIEL",
    "power_threshold": 9,
    "relais": 0,
    "relais_breakout": {
        "relais1": 0,
        "relais2": 0,
        "relais3": 0,
        "relais4": 0,
        "relais5": 0,
        "relais6": 0,
        "relais7": 0,
        "relais8": 0
    },
    "site_id": "VALEURCACHECONFIDENTIEL",
    "software_revision": 2,
    "status_register": "VALEURCACHECONFIDENTIEL",
    "status_register_breakout": {
        "cache_borne_dist": "ferme",
        "comm_euridis": "activee avec securite",
        "contact_sec": "ouvert",
        "depassement_ref_pow": 0,
        "etat_cpl": "nouveau_verrouille",
        "horloge": "correcte",
        "organe_coupure": "ferme",
        "pointe_mobile": "AUCUN",
        "preavis_pointe_mobile": "AUCUN",
        "producteur": 0,
        "sens_energie_active": "positive",
        "surtension_phase": 0,
        "sync_cpl": "non_synchronise",
        "tarif_dist": "index_2",
        "tarif_four": "index_2",
        "tempo_demain": "UNDEF",
        "tempo_jour": "BLEU",
        "type_tic": "standard"
    },
    "update": {
        "installed_version": 13,
        "latest_version": 13,
        "state": "idle"
    },
    "active_energy_out_d01": null,
    "active_energy_out_d02": null,
    "active_power": null,
    "active_power_max": null,
    "active_power_ph_b": null,
    "apparent_power": null,
    "average_rms_voltage_meas_period": null,
    "current_summ_delivered": null,
    "current_tier1_summ_delivered": null,
    "current_tier2_summ_delivered": null,
    "current_tier3_summ_delivered": null,
    "current_tier4_summ_delivered": null,
    "current_tier5_summ_delivered": null,
    "current_tier6_summ_delivered": null,
    "rms_current": null,
    "rms_voltage": null,
    "update_available": null
`}``

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

Coldness00, 2024-04-16:
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

Coldness00, 2024-04-23:
J'ai trouve la solution, qui en soit est ''bizarre''.
Il faut supprimer de Repporting toute les cluster/endpoints et magie, tout marche:
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

SBRK, 2024-09-13:
J'ai le même problème mais je ne peux rien supprimer dans "Reporting" :/

Thread 258 (2024-04-28):

Ré-association du ZLinky, perte des données Tempo

foux, 2024-04-28:
Bonjour,
J'ai ré-associé mon ZLinky à mon réseau ce matin (pour un changement de canal). Depuis je n'ai plus les données de consommation Tempo qui sont remontées par le Linky (`EASF01`, `EASF02`, ....). Voila les données que j'ai :
```
{
    "active_energy_out_d01": 29263.458,
    "active_energy_out_d02": 5147.985,
    "active_power": 578,
    "active_power_max": 3230,
    "active_power_ph_b": 566,
    "active_register_tier_delivered": "HCJB",
    "apparent_power": 704,
    "available_power": 6,
    "average_rms_voltage_meas_period": 237,
    "current_date": "E240428160735",
    "current_index_tarif": 2,
    "current_price": "HP BLEU",
    "current_summ_delivered": 39845.937,
    "current_tarif": "TEMPO",
    "current_tier1_summ_delivered": 35736.275,
    "current_tier2_summ_delivered": 4007.877,
    "current_tier3_summ_delivered": 44.662,
    "current_tier4_summ_delivered": 57.123,
    "current_tier5_summ_delivered": 0,
    "current_tier6_summ_delivered": 0,
    "drawn_v_a_max_n1": 3749,
    "linkquality": 129,
    "message1": "PAS DE MESSAGE",
    "message2": "",
    "meter_serial_number": "XXXXXXX",
    "power_threshold": 6,
    "relais": 0,
    "relais_breakout": {
        "relais1": 0,
        "relais2": 0,
        "relais3": 0,
        "relais4": 0,
        "relais5": 0,
        "relais6": 0,
        "relais7": 0,
        "relais8": 0
    },
    "rms_current": 3,
    "rms_current_max": 90,
    "rms_voltage": 238,
    "site_id": "XXXXXXXX",
    "software_revision": 2,
    "start_notice_e_j_p": 0,
    "status_register": "XXXXXXX",
    "status_register_breakout": {
        "cache_borne_dist": "ferme",
        "comm_euridis": "activee avec securite",
        "contact_sec": "ouvert",
        "depassement_ref_pow": 0,
        "etat_cpl": "nouveau_deverrouille",
        "horloge": "correcte",
        "organe_coupure": "ferme",
        "pointe_mobile": "AUCUN",
        "preavis_pointe_mobile": "AUCUN",
        "producteur": 0,
        "sens_energie_active": "positive",
        "surtension_phase": 0,
        "sync_cpl": "non_synchronise",
        "tarif_dist": "index_2",
        "tarif_four": "index_2",
        "tempo_demain": "UNDEF",
        "tempo_jour": "BLEU",
        "type_tic": "standard"
    },
    "tomorrow_color": "BLAN",
    "update": {
        "installed_version": 13,
        "latest_version": 13,
        "state": "idle"
    },
    "warn_d_p_s": 0,
    "update_available": null
}
```

Y'a t'il quelque chose de particulier à fair epour les récupérer? J'ai déjà essayé de le débranché/rebranché, mais rien n'est revenu. Je suis sous HomeAssitant avec Z2MQTT.

Merci d'avance.

foux, 2024-04-28:
Bon, elles sont revenues, désolé...

Closed 2024-04-28.

Thread 259 (2024-05-05):

Update vers Z2M 1.37.0 : "Failed to read zigbee attributes: Error: Cluster 'liXeePrivate' has no attribute 'motDEtat'"

meepmeep, 2024-05-05:
Hello

Depuis l'update en 1.37.0 de Zigbee2Mqtt, j'ai très régulièrement ce message qui apparait sur la console Z2M (en warning)

> Failed to read zigbee attributes: Error: Cluster 'liXeePrivate' has no attribute 'motDEtat'

Je ne comprends pas pourquoi ca apparait régulièrement sachant que j'ai ca dans state :

```
{
    "active_register_tier_delivered": "HP..",
    "apparent_power": 520,
    "available_power": 60,
    "current_tarif": "HC..",
    "current_tier1_summ_delivered": 18119.856,
    "current_tier2_summ_delivered": 19373.344,
    "linkquality": 112,
    "meter_serial_number": "0xxxxxxxxxxxxxxxx",
    "rms_current": 2,
    "rms_current_max": 90,
    "schedule_h_p_h_c": 0,
    "update": {
        "installed_version": 13,
        "latest_version": 13,
        "state": "idle"
    },
    "update_available": false,
    "warn_d_p_s": 0,
    "MOTDETAT": null
}
```

Mais dans l'onglet Reporting rien ne parle de "MotDetat".
Est ce gênant ? est ce corrigible ?

achlyss-8, 2024-05-05:
Même erreur ici, un warning toutes les minutes dans la dernière version de Z2M 😞

meepmeep, 2024-05-10:
En effet, fixé dans Z2M 1.37.1 (https://github.com/Koenkk/zigbee2mqtt/issues/21825)

Closed 2024-05-06.

Thread 265 (2024-05-31):

Plantage de Z2M suite à l'appairage du ZLinky

Xiaoh-123, 2024-05-31:
Bonjour,

J'ai récemment fait la migration du firmware de ma Sonoff Dongle Plus E vers le firmware 7.4.2 (désormais ember et plus ezsp) suite à la notification de Z2M 1.37-1.

Depuis, à chaque fois que j'appaire le ZLinky, j'ai de très nombreux messages d'erreur à l'appairage puis lors des envois de messages MQTT, souvent le point commun est le message "Not connected to MQTT server!"

J'ai mis le log après une fresh install de Z2M et l'appairage uniquement du ZLinky [ici](https://pastebin.com/0dJxcPJr).

J'ai l'impression que le fait d'appairer le ZLinky "corrompt" l'installation de Z2M car les problèmes semblent persister même après que je le supprime. L'appairage d'autres devices (Sonoff SNZB-02 et SNZB-04, Nous A1Z) se fait sans problème.

Est-ce que le problème viendrait du ZLinky ou plutôt de Z2M ou du nouveau firmware ?

gjaegy, 2024-06-14:
Bonjour,

Je pense avoir un problème assez proche, où Z2M plante de manière aléatoire, assez fréquemment.

J'avais contacté l'auteur de Z2M à ce sujet, celui-ci semble indiquer que le ZLinky bombarde de messages, cf. le thread suivant:

https://github.com/Koenkk/zigbee2mqtt/issues/23013

Une idée de la manière de fixer le problème ?

thomasGomes, 2024-06-14:
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

Même chose pour moi ;)

fairecasoimeme, 2024-06-17:
Attention ce n'est pas le ZLinky qui bombarde message de lui même. C'est selon comment on le configure.
Dans Z2M pour régler le problème, il faut limiter le poll en utilisant la whitelist. ou supprimer les rapports non utiles

gjaegy, 2024-06-17:
Merci pour le retour.
J'ai bien compris le système de whitelist, par contre qu'entendez vous par la suppression des rapports non utiles ? Je suppose que cela revient au même mais je ne vois pas comment procéder dans la pratique pour cette deuxième option ?

MilesTEG1, 2024-06-17:
Bonjour,
Pour faire une whitelist, c'est bien ici que ça se passe ?
```
Tic command whitelist
List of TIC commands to be exposed (separated by comma). Reconfigure device after change. Default: all
```
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

Qu'est-ce qu'on doit mettre comme `TIC commands` ?
Ce sont les éléments listés dans Expose ? EAST, EASF01, EASF02 etc...
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

Et dernière question : `Reconfigure device after change.` c'est utiliser ce bouton ?
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

fairecasoimeme, 2024-06-18:
Bonjour,
Oui, c'est exactement ça @MilesTEG1

fairecasoimeme, 2024-06-18:
> Merci pour le retour. J'ai bien compris le système de whitelist, par contre qu'entendez vous par la suppression des rapports non utiles ? Je suppose que cela revient au même mais je ne vois pas comment procéder dans la pratique pour cette deuxième option ?

Dans l'onglet "rapport", vous avez un groupe de fonction. il faut désactiver (si possible) les fonctions qui ne vous sont pas utiles pour limiter le trafic

MilesTEG1, 2024-06-18:
> Bonjour, Oui, c'est exactement ça @MilesTEG1

Bonjour,
Nickel, j'ai mis ceci :
`EAST,EASF01,EASF02,EASF03,EASF04,EASF05,EASF06,LTARF,URMS1,UMOY1,SINSTS,IRMS1,Linkquality`
Et j'ai reconfiguré le ZLinky.
Depuis, je n'ai plus les erreurs occasionnelles de récupération de valeurs que j'avais encore (voir une autre issue).

Xiaoh-123, 2024-06-18:
J'ai fait une whitelist aussi et cela semble résoudre pas mal de problèmes. Après j'ai toujours un souci avec le passage d'Historique à Standard, mais ça doit venir du Linky lui-même car il affiche Historique mais mon fournisseur m'a confirmé que je suis en Standard chez Enedis (?!).
Au moins cela fonctionne à nouveau et c'est le plus important, je trouve juste ça étonnant que tout ait commencé après la màj du firmware de ma Sonoff Dongle-E.

gjaegy, 2024-06-18:
Ça semble fonctionner pour moi aussi, merci 👍

Thread 266 (2024-06-03):

Erreur récurrente dans Z2M : `Failed to read zigbee attributes: Error: ZCL command 0x00158d0005d25e9d/1 liXeePrivate.read(["currentPrice","currentTarif","message1","message2"]`

MilesTEG1, 2024-06-03:
Bonjour,
J'ai depuis quelques temps ces erreurs dans Z2M :

```
Failed to read zigbee attributes: Error: ZCL command 0x00158d0005d25e9d/1 liXeePrivate.read(["currentPrice","currentTarif","message1","message2"], {"timeout":10000,"disableResponse":false,"disableRecovery":false,"disableDefaultResponse":true,"direction":0,"srcEndpoint":null,"reservedBits":0,"manufacturerCode":null,"transactionSequenceNumber":null,"writeUndiv":false}) failed ({"target":2695,"apsFrame":{"profileId":260,"clusterId":65382,"sourceEndpoint":1,"destinationEndpoint":1,"options":4416,"groupId":0,"sequence":30},"zclSequence":77,"commandIdentifier":1} timed out after 10000ms)

Failed to read zigbee attributes: Error: ZCL command 0x00158d0005d25e9d/1 liXeePrivate.read(["currentPrice","currentTarif","message1","message2"], {"timeout":10000,"disableResponse":false,"disableRecovery":false,"disableDefaultResponse":true,"direction":0,"srcEndpoint":null,"reservedBits":0,"manufacturerCode":null,"transactionSequenceNumber":null,"writeUndiv":false}) failed ({"target":2695,"apsFrame":{"profileId":260,"clusterId":65382,"sourceEndpoint":1,"destinationEndpoint":1,"options":4416,"groupId":0,"sequence":97},"zclSequence":14,"commandIdentifier":1} timed out after 10000ms)

Failed to read zigbee attributes: Error: ZCL command 0x00158d0005d25e9d/1 liXeePrivate.read(["currentPrice","currentTarif","message1","message2"], {"timeout":10000,"disableResponse":false,"disableRecovery":false,"disableDefaultResponse":true,"direction":0,"srcEndpoint":null,"reservedBits":0,"manufacturerCode":null,"transactionSequenceNumber":null,"writeUndiv":false}) failed ({"target":2695,"apsFrame":{"profileId":260,"clusterId":65382,"sourceEndpoint":1,"destinationEndpoint":1,"options":4416,"groupId":0,"sequence":21},"zclSequence":133,"commandIdentifier":1} timed out after 10000ms)
```

J'utilise l'add-on Zigbee2MQTT dans HAOS

### Zigbee2MQTT version

1.38.0

### Adapter firmware version

7.4.3 [GA]

Même chose avec la 7.4.1 [GA]

### Adapter

HA SkyConnect with ember driver

### Setup

Add-on dans Home Assistant OS sur un NUC à base d'Intel

Je ne suis pas le seul à avoir ces erreurs, mais personne n'arrive à dire qui est en cause : Z2M ou le ZLinky.

Peut-être aurais-je plus de chance ici.

PS : je précise que mon ZLinky est en firmware limited v13, et qu'il y a plusieurs prises connectées Zigbee pas loin.
Voilà un schéma de mon maillage:
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

Le ZLinky est bien connecté avec un LQI satisfaisant.

fairecasoimeme, 2024-06-04:
Bonjour,

Les messages d'erreurs semblent être des "timeout" sur une demande d'info.
Apparemment, le timeout est systématiquement sur "currentPrice","currentTarif","message1","message2"
Pour savoir si c'est un des attributs qui ne réponds pas, il faudrait utiliser la console et faire une requête sur chacun des attributs

MilesTEG1, 2024-06-04:
Bonjour @fairecasoimeme

Avec la console dev,
- currentPrice seul : pas de soucis
- currentPrice + currentTarif : pas de soucis
- currentPrice + currentTarif + message1 : problème (timeout)
- currentPrice + currentTarif + message2 : pas de soucis
- currentPrice + currentTarif + message1 + message2 : problème (timeout)
- message1 : pas de soucis
- message1 + message2 : pas de soucis

C'est bien l'ajout de message1 qui pose problème.

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

> Il faut peut-être jouer avec le Meausrement poll chunk pour limiter le nombre d'attribut à poll en même temps.

Comment je fais cela ? Je veux dire, je mets quoi comme valeur ?
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

fairecasoimeme, 2024-06-04:
je ne suis pas expert mais de ce que je comprends, c'est que le paramètre permet de faire des demandes d'attributs par paquet.
dans votre cas, je forcerais à 1. ce qui est étrange car, apparemment c'est la valeur par défaut mais on voit bien qu'il fait des demandes par 4

MilesTEG1, 2024-06-04:
> je ne suis pas expert mais de ce que je comprends, c'est que le paramètre permet de faire des demandes d'attributs par paquet. dans votre cas, je forcerais à 1. ce qui est étrange car, apparemment c'est la valeur par défaut mais on voit bien qu'il fait des demandes par 4

Oh ! Il ne semble plus y avoir ces erreurs-là !!
Top, merci :)

En revanche, l'erreur du timeout persiste dans la console dev comme précédemment :)

fairecasoimeme, 2024-06-04:
si dans le console dev, vous faites 4 demandes, le chunck n'intervient pas

MilesTEG1, 2024-06-04:
> si dans le console dev, vous faites 4 demandes, le chunck n'intervient pas

Ok, je comprends mieux, et je m'en doutais du coup ^^
Merci pour votre aide.

Closed 2024-06-04.

Thread 269 (2024-08-06):

PTEC erroné

RobinFrcd, 2024-08-06:
Bonjour,
J'ai installé mon ZLinky ce matin et il semblerait que le sensor `PTEC` remonte une info erronée pour la plage HC/HP. Que ce soit sur ma facture ou le site d'EDF, je vois la plage suivante :
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
En revanche, le capteur remonte :
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

D'où peut venir cette différence ? C'est directement un problème du Linky qui remonte le mauvais tarif ou j'ai mal configuré quelque chose ?

Merci !

ggrandou, 2024-08-07:
J'ai eu un probleme similaire il y a quelques années (pas avec le Zlinky, mais peu importe)
Le linky ne peut pas inventer les plages horaires, il retransmet celles qu'ils recoit d'Enedis.
Le probleme etait une désynchronisation de la base EDF (le fournisseur) avec celle d'Enedis. J'ai remonté le problème à EDF et quelques mois plus tard, j'ai recu un remboursement dcorrespondant a une consommation estimée entre la consommation durant les heures creuses techniques (du Linky) et les heures creuses commerciales (d'EDF)

En tout etat de cause, rien a voir avoir le Zlinky

RobinFrcd, 2024-08-07:
Okay, merci pour l'info, je vais les contacter aussi dans ce cas !
Ils ont fini par corriger le problème ou tu as juste eu une compensation ?

ggrandou, 2024-08-08:
> Okay, merci pour l'info, je vais les contacter aussi dans ce cas ! Ils ont fini par corriger le problème ou tu as juste eu une compensation ?

Ca a été corrigé

Closed 2024-08-07.

Thread 272 (2024-09-03):

MaJ firlware lixee zlinky tic

Sleinous, 2024-09-03:
Bonjour,
Ce post pour demander si d'autres ont l'astuce pour mettre à jour le firmware via OTA avec un taux de réussite élevé...
Depuis la v5 je galère a chaque monté de version pour passer la MAJ, en général au moins 20 essaie avant que ça passe... que je fasse la maj via Z2M, ZHA ou autre... rien y fait.
Le comportement : la maj via OTA se lance, et au bout de X% (variable) ça s'arrete et le module est hors ligne. (Il faut ensuite le débrancher rebrancher pour retenter la maj).
Je suis actuellement entrain de passer de la v13 a la v14 et comme a chaque fois je galère... J'en suis a mon 7eme essai.
Siquelqu'un a des lumieres je suis preneur :)

MilesTEG1, 2024-09-03:
@Sleinous salut 👋🏻
Est-ce que ton ZLinky est loin de ton coordinateur Zigbee ?
Si oui c'est peut être ça la cause des échecs de MAJ OTA.

Rentente plusieurs fois, car souvent ça reprend le chargement de la Maj à l'endroit où elle s'est arrêtée.

Si ça ne fonctionne pas mieux , il faudrait mettre un répéteur zigbee (pas sur du nom là) puissant entre le coordinateur et ton Zlinky.
Et/ou des routeurs pas loin comme des prises ou ampoules connectées.

Sinon il te reste la manière brutale : faire la Maj par usb via un adaptateur usb-uart.
J'ai fait une issue sur la Maj d'un firmware standard vers un limited où j'explique pas à pas comment flasher . Cette méthode fonctionne aussi pour mettre à jour une version standard vers une version plus haute standard elle aussi.

Sleinous, 2024-09-03:
Hello @MilesTEG1 Merci pour ton retour rapide :)
En effet mon coordinateur est a moins de 20cm du lixee, il s'agit d'un zigbee coordinator en PoE de chez Tubeszb : https://tubeszb.com/product/cc2652p2-based-zigbee-to-poe-coordinator-2023/

A priori quand ça plante et que je suis obligé de débrancher rebrancher ça n'a pas l'air de reprendre de la ou ça c'est arreté :( (en tout cas je l'ai laissé 30mn sans retenter un update juste pour voir)

Pour le flash via USB-TTL, impossible de mon coté, j'ai passé 2h dessus mais ça ne marche pas avec mon USB-TTL --> FT232 FTDI Mini USB

Sleinous, 2024-09-03:
C'est enfin passé au bout de 17 essai :)

sdk69, 2024-09-04:
bonjour, j'ai essayé de faire la dernière maj en OTA hier, elle a planté et depuis plus rien ne fonctionne.
J'ai essayé de débrancher 1h, de réappairer...rien n'y fait, j'ai une erreur "Not connected to MQTT server!" alors que mes autres périphériques fonctionnent, si je débranche le lixee, tout rentre dans l'ordre.

Merci pour votre aide !

Sleinous, 2024-09-04:
C'est curieux que meme apres debranchage rebranchage ça ne revient pas, ZHA ou Zigbee2MQTT?

sdk69, 2024-09-04:
j'ai réussi à refaire fonctionner le zlinky en forçant la suppression et débrancher/rebrancher, je suis sur Z2M, mais du coup j'ai perdu tout mon historique de prod solaire et conso réseau :( et impossible de faire la maj OTA le problème se reproduit systématiquement, tant pis je vais en rester là, merci !

Mookunicorn, 2024-09-05:
Salut a tous :)

Je tente également de mettre à jour le zlinky de 13 a 14 sur ZHA. (Première mise a jour que je fais)

Durant toute l'installation le zlinky clignote
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

Une fois arrivé a 100% l'appareil ne réponds plus sous ZHA je dois débrancher et rebrancher.
ZHA qui d'ailleurs m'envoie un message d'erreur
"Échec de l'exécution de l'action update/install. Update was not successful: <Status. TIMEOUT: 148>" et me rebalance la mise a jour dispo
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

Le zLinky est l'appareil le plus proche du coordinateur (skyconnect) je peux d'ailleurs difficilement faire plus proche)

bombaata, 2024-09-06:
Même problème ici, depuis la tentative de MAJ via ZHA le Zlkiny ne répond plus. Je suis à distance, je débrancherai/rebrancherai ce soir.

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

xabix, 2024-09-06:
J'ai également le même problème. Avant j'étais sous Jeedom avec Z2M et jamais de soucis sur les updates et depuis que je suis sous HA pourtant avec Z2M j'ai pas réussi à faire d'upgrade.

Par contre j'ai du passé à EMBER depuis et je me demande si cela n'est pas lié?

SeafireGit, 2024-09-09:
Pareil de mon coté, avec HomeAssistant + Z2M, en passage de 13 à 14. La MaJ freeze à un moment random et obligation de débrancher/rebrancher pour reprendre la main dessus.

SBRK, 2024-09-12:
Je suis dans le même cas mais j'ai l'impression d'avoir des problèmes plus profonds avec le ZLinky.

Depuis des mois je n'avais plus aucune remontée d'information. Je me suis remis sur le sujet il y a quelques jours, j'ai débranché/rebranché et réappairé dans Z2M. Tout semblait ok pendant quelques minutes. Puis à nouveau aucune remontée d'info, et des erreurs de timeout sur les commandes envoyées au ZLinky. La portée du signal n'est à priori pas en cause.

Le seul moyen pour que ça fonctionne à nouveau c'est de débrancher et rebrancher le ZLinky, mais ça ne refonctionne pas si je rebranche immédiatement. La lumière bleue ne s'allume pas et je dois attendre une quinzaine de minutes avant de rebrancher. Puis au bout de quelques minutes rebelote dans Z2M, des timeouts.

Au milieu de tout ça, impossible de mettre à jour en v14, j'ai réussi à monter à 33% puis pouf, timeout à nouveau.

Mookunicorn, 2024-09-12:
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

Finalement, c'est passé pour moi, quand j'ai fait la mises a jour une fois a 100% la led c'est éteinte, via ZHA j'ai refais installer (sans débrancher/rebrancher) ce qui a eu pour effet de passer en 14

r0m1CH, 2024-09-13:
Bonjour je galère pas mal à mettre à jour ce device... Comme vous ça bloque de manière random mais je ne peux pas simplement débrancher / rebrancher mon device car il ne redémarre jamais comme ça. je dois attendre X heures avant qu'il reparte. Une idée de ce que je loupe ? Merci d'avance.

SBRK, 2024-09-13:
@r0m1CH c'est le même comportement que j'observe. Le Linky se met en sécurité (cf la doc sur ce repo). J'ai l'impression que ça se produit quand je rebranche trop rapidement après avoir débranché le ZLinky. Maintenant j'attends toujours une vingtaine de secondes avant de rebrancher, et ça semble aider à ce qu'il se rallume bien.

En revanche, après moultes essais, toujours pas réussi à faire la MAJ. Par dépit j'ai commandé un adaptateur série USB pour faire la mise à jour comme ça.

r0m1CH, 2024-10-10:
@SBRK as-tu reussi à mettre à jour avec l'USB du coup ? Moi je galère toujours et je ne trouve aucun moyen de le faire correctement.

SBRK, 2024-10-10:
> @SBRK as-tu reussi à mettre à jour avec l'USB du coup ? Moi je galère toujours et je ne trouve aucun moyen de le faire correctement.

Oui et non. J'ai branché en USB mais je n'ai pas réussi à faire l'updste comme ça, en revanche j'ai pu update en OTA avec l'USB branché, ça a assuré l'alimentation et éviter que ça ne coupe.

r0m1CH, 2024-10-10:
ok ok. Bon aucune méthode bien fiable dommage. Merci pour le feedback.

Shasdo, 2024-10-14:
Même problème avec z2m, obligé de débrancher et rebrancher après chaque tentative échoué (j'en suis à 5) sinon il n'y a plus de remonté

J'ai en plus de ça des erreurs d'attributs en boucle et pour essayer d'éliminer les problèmes de réception, comme mon zLinky est à l’extérieur (4m), j'ai sortie une prise connecté sur un enrouleur servant de relais à mi chemin.

Si la maj va dans ce cas plus loin, progresse rapidement au début sans problème jusqu'à 20%,  je vois ensuite apparaitre des erreurs d'attributs à mesure que la maj ralentie.
Et plus les erreurs deviennent rapprochés, plus la maj stagne et fini par échouer.

Thread 274 (2024-09-03):

Plus de remonté après MAJ v14

Sapherys, 2024-09-03:
Bonjour,

j'ai fait la MAJ OTA avec Z2M vers la version 14 aujourd'hui.
Depuis, j'ai plus de remonté d'information. Actuellement j'ai en Whitelist seulement la donnée EAIT, ce qui me suffisait jusqe-là pour le suivi.
Est-ce que quelque chose à changé par rapport à ça pour que je n'ai plus de remonté dans HAOS?

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

Un grand merci à vous si vous avez des pistes! :)

Coldness00, 2024-09-03:
Salut, regarde la solution que j ai trouve sur le post:
https://github.com/fairecasoimeme/Zlinky_TIC/issues/256

Sapherys, 2024-09-03:
> Salut, regarde la solution que j ai trouve sur le post: #256

Merci pour ta réponse. Quand tu dit "supprimer" tu veux dire disable? Parce que j'en ai une vraie tonne de lignes dans les rapports (et ca va encore plus bas):

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

Coldness00, 2024-09-03:
Oui, exactement.
Si ca ne marche pas, tu peux faire un re-appareillage et tout reviendra comme sur le screenshot

graelo, 2024-09-03:
@Sapherys n'oublie pas stp de nous dire si ça marche pour toi, merci bcp.

MilesTEG1, 2024-09-03:
Je referais un appairage et ensuite un reboot de Z2M.

Sapherys, 2024-09-03:
> Oui, exactement. Si ca ne marche pas, tu peux faire un re-appareillage et tout reviendra comme sur le screenshot

Malheureusement ça n'a pas fonctionné chez moi, même avec un redémarrage Z2M. Je vais faire un ré appareillage en rentrant  pour voir si ça change quelque chose.
Mais déjà si d'autres ont le souci, c'est que ça ne vient pas de mon zlinky, c'est rassurant. J'en ai perdu 1 il y a 2 jours, plus de led, plus rien 😅

Coldness00, 2024-09-03:
Je te recommande d'attendre au moins quelques heures avant d'etre sur.
Et il faut generalement le laisser debrancher 30min avant de le reconnecter suite a un changement.
Assures toi d'etre aussi dans le bon mode Historique / Standards ?

Sapherys, 2024-09-04:
MAJ du jour: Pas de nouvelles remontés, même avec un appareillage pour l'instant.

graelo, 2024-09-04:
Ok, merci pour ton retour d'exp (et navré).

Sapherys, 2024-09-04:
> Je referais un appairage et ensuite un reboot de Z2M.

Ca a fonctionné chez toi?

MilesTEG1, 2024-09-04:
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

Je ne suis pas confronté à ce souci avec la v14.
C'était une suggestion 😊
Mais en général si tu modifies une options de paramètres spécifique dans Z2M, il faut le redémarrer.

Sapherys, 2024-09-04:
De mon coté il a fallu faire une suppression du Zlinky dans Z2M puis un réapareillage. EN le renommant à l'identique, j'ai pas eu à reconfigurer le panneau des énergies. Ca fonctionne maintenant de nouveau et j'ai beaucoup moins de choses dans "Rapport" qu'avant.

SBRK, 2024-09-13:
Chez moi, j'ai du refaire interview + reconfigure du device dans Z2M et ça a ajouté plein de trucs dans Reporting et depuis ça marche

Closed 2024-09-04.

Thread 284 (2024-09-23):

lixee: Failed to read zigbee attributes

OUARZA, 2024-09-23:
Bonjour à tous,
Depuis toujours, j'ai ces erreurs.
Cela ne semble pas poser problème dans la remontée d'information sauf peut-être une surcharge de z2m.
Comment faire pour remédier au problème ?
Merci par avance :)

`2024-09-23 20:57:50zhc:lixee: Failed to read zigbee attributes: Error: ZCL command 0x00158d0005ce76da/1 haMeterIdentification.read(["availablePower"], {"timeout":10000,"disableResponse":false,"disableRecovery":false,"disableDefaultResponse":true,"direction":0,"reservedBits":0,"manufacturerCode":null,"writeUndiv":false}) failed (no response received (160) waiting for response TIMEOUT)
2024-09-23 20:59:01zhc:lixee: Failed to read zigbee attributes: Error: ZCL command 0x00158d0005ce76da/1 haElectricalMeasurement.read(["rmsCurrentMax"], {"timeout":10000,"disableResponse":false,"disableRecovery":false,"disableDefaultResponse":true,"direction":0,"reservedBits":0,"manufacturerCode":null,"writeUndiv":false}) failed (no response received (162) waiting for response TIMEOUT)
2024-09-23 20:59:11zhc:lixee: Failed to read zigbee attributes: Error: ZCL command 0x00158d0005ce76da/1 seMetering.read(["activeRegisterTierDelivered","meterSerialNumber"], {"timeout":10000,"disableResponse":false,"disableRecovery":false,"disableDefaultResponse":true,"direction":0,"reservedBits":0,"manufacturerCode":null,"writeUndiv":false}) failed (no response received (163) waiting for response TIMEOUT)
2024-09-23 20:59:22zhc:lixee: Failed to read zigbee attributes: Error: ZCL command 0x00158d0005ce76da/1 haMeterIdentification.read(["availablePower"], {"timeout":10000,"disableResponse":false,"disableRecovery":false,"disableDefaultResponse":true,"direction":0,"reservedBits":0,"manufacturerCode":null,"writeUndiv":false}) failed (no response received (164) waiting for response TIMEOUT)`

Firmware : 4001-0013 (mise à jour en cours vers v14).
Je suis sous z2m via Jeedom.
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

fairecasoimeme, 2024-09-24:
Bonjour,

S'il y a quelques timeout, ça peut venir de perturbations, d'une qualité de réception moyenne ou d'un défaut de traitement côté serveur (Z2M)
pour remédier à ce dernier, il faut essayer d'utiliser la whitelist (dans paramètres spécifiques de Z2M) et de mettre que les étiquettes essentielles que vous utilisez.

OUARZA, 2024-09-24:
Bonjour,
Je ne pense pas que ça vienne de la qualité de réception.
Entre les timeout, j'ai les infos qui passent.
Je vais regarder un peu plus en détail les logs.
Mathieu

OUARZA, 2024-09-24:
`info 2024-09-24 19:48:46z2m:mqtt: MQTT publish: topic 'zigbee2mqtt/0x00158d0005ce76da', payload '{"active_enerfy_out_d01":5126,"active_energy_out_d01":5624.11,"active_power":568,"active_power_max":1061,"active_power_ph_b":352,"active_register_tier_delivered":"","apparent_power":557,"available_power":6,"average_rms_voltage_meas_period":234,"current_date":"","current_index_tarif":0,"current_price":"","current_summ_delivered":16023.12,"current_tarif":"BASE","current_tier1_summ_delivered":0,"current_tier2_summ_delivered":0,"device":{"applicationVersion":12,"dateCode":"20240422","friendlyName":"0x00158d0005ce76da","hardwareVersion":1,"ieeeAddr":"0x00158d0005ce76da","manufacturerID":4151,"manufacturerName":"LiXee","model":"ZLinky_TIC","networkAddress":61512,"powerSource":"Mains (single phase)","softwareBuildID":"4000-0014","stackVersion":2,"type":"Router","zclVersion":3},"drawn_v_a_max_n1":0,"last_seen":"2024-09-24T17:48:42.559Z","linkquality":255,"message1":"","message2":"","meter_serial_number":"041964502262","mot_d_etat":"000000","power_threshold":6,"relais":0,"relais_breakout":{"relais1":0,"relais2":0,"relais3":0,"relais4":0,"relais5":0,"relais6":0,"relais7":0,"relais8":0},"rms_current":2,"rms_current_max":0,"rms_voltage":235,"site_id":"","software_revision":2,"status_register":"003A4001","status_register_breakout":{"cache_borne_dist":"ferme","comm_euridis":"activee avec securite","contact_sec":"ouvert","depassement_ref_pow":0,"etat_cpl":"nouveau_verrouille","horloge":"correcte","organe_coupure":"ferme","pointe_mobile":"AUCUN","preavis_pointe_mobile":"AUCUN","producteur":0,"sens_energie_active":"positive","surtension_phase":0,"sync_cpl":"non_synchronise","tarif_dist":"index_2","tarif_four":"index_1","tempo_demain":"UNDEF","tempo_jour":"UNDEF","type_tic":"standard"},"update":{"installed_version":1,"latest_version":14,"state":"available"},"update_available":true,"warn_d_p_s":0}'

warning 2024-09-24 19:48:52zhc:lixee: Failed to read zigbee attributes: Error: ZCL command 0x00158d0005ce76da/1 haElectricalMeasurement.read(["rmsCurrentMax"], {"timeout":10000,"disableResponse":false,"disableRecovery":false,"disableDefaultResponse":true,"direction":0,"reservedBits":0,"manufacturerCode":null,"writeUndiv":false}) failed (no response received (113) waiting for response TIMEOUT)

info 2024-09-24 19:49:01z2m:mqtt: MQTT publish: topic 'zigbee2mqtt/0x00158d0005ce76da', payload '{"active_enerfy_out_d01":5126,"active_energy_out_d01":5624.11,"active_power":568,"active_power_max":1061,"active_power_ph_b":352,"active_register_tier_delivered":"","apparent_power":557,"available_power":6,"average_rms_voltage_meas_period":234,"current_date":"","current_index_tarif":0,"current_price":"","current_summ_delivered":16023.13,"current_tarif":"BASE","current_tier1_summ_delivered":0,"current_tier2_summ_delivered":0,"device":{"applicationVersion":12,"dateCode":"20240422","friendlyName":"0x00158d0005ce76da","hardwareVersion":1,"ieeeAddr":"0x00158d0005ce76da","manufacturerID":4151,"manufacturerName":"LiXee","model":"ZLinky_TIC","networkAddress":61512,"powerSource":"Mains (single phase)","softwareBuildID":"4000-0014","stackVersion":2,"type":"Router","zclVersion":3},"drawn_v_a_max_n1":0,"last_seen":"2024-09-24T17:49:01.596Z","linkquality":255,"message1":"","message2":"","meter_serial_number":"041964502262","mot_d_etat":"000000","power_threshold":6,"relais":0,"relais_breakout":{"relais1":0,"relais2":0,"relais3":0,"relais4":0,"relais5":0,"relais6":0,"relais7":0,"relais8":0},"rms_current":2,"rms_current_max":0,"rms_voltage":235,"site_id":"","software_revision":2,"status_register":"003A4001","status_register_breakout":{"cache_borne_dist":"ferme","comm_euridis":"activee avec securite","contact_sec":"ouvert","depassement_ref_pow":0,"etat_cpl":"nouveau_verrouille","horloge":"correcte","organe_coupure":"ferme","pointe_mobile":"AUCUN","preavis_pointe_mobile":"AUCUN","producteur":0,"sens_energie_active":"positive","surtension_phase":0,"sync_cpl":"non_synchronise","tarif_dist":"index_2","tarif_four":"index_1","tempo_demain":"UNDEF","tempo_jour":"UNDEF","type_tic":"standard"},"update":{"installed_version":1,"latest_version":14,"state":"available"},"update_available":true,"warn_d_p_s":0}'

warning 2024-09-24 19:49:03zhc:lixee: Failed to read zigbee attributes: Error: ZCL command 0x00158d0005ce76da/1 seMetering.read(["activeRegisterTierDelivered","meterSerialNumber"], {"timeout":10000,"disableResponse":false,"disableRecovery":false,"disableDefaultResponse":true,"direction":0,"reservedBits":0,"manufacturerCode":null,"writeUndiv":false}) failed (no response received (114) waiting for response TIMEOUT)

info 2024-09-24 19:49:09z2m:mqtt: MQTT publish: topic 'zigbee2mqtt/0x00158d0005ce76da', payload '{"active_enerfy_out_d01":5126,"active_energy_out_d01":5624.11,"active_power":568,"active_power_max":1061,"active_power_ph_b":352,"active_register_tier_delivered":"","apparent_power":557,"available_power":6,"average_rms_voltage_meas_period":234,"current_date":"","current_index_tarif":0,"current_price":"","current_summ_delivered":16023.13,"current_tarif":"BASE","current_tier1_summ_delivered":0,"current_tier2_summ_delivered":0,"device":{"applicationVersion":12,"dateCode":"20240422","friendlyName":"0x00158d0005ce76da","hardwareVersion":1,"ieeeAddr":"0x00158d0005ce76da","manufacturerID":4151,"manufacturerName":"LiXee","model":"ZLinky_TIC","networkAddress":61512,"powerSource":"Mains (single phase)","softwareBuildID":"4000-0014","stackVersion":2,"type":"Router","zclVersion":3},"drawn_v_a_max_n1":0,"last_seen":"2024-09-24T17:49:09.605Z","linkquality":255,"message1":"","message2":"","meter_serial_number":"041964502262","mot_d_etat":"000000","power_threshold":6,"relais":0,"relais_breakout":{"relais1":0,"relais2":0,"relais3":0,"relais4":0,"relais5":0,"relais6":0,"relais7":0,"relais8":0},"rms_current":10,"rms_current_max":0,"rms_voltage":235,"site_id":"","software_revision":2,"status_register":"003A4001","status_register_breakout":{"cache_borne_dist":"ferme","comm_euridis":"activee avec securite","contact_sec":"ouvert","depassement_ref_pow":0,"etat_cpl":"nouveau_verrouille","horloge":"correcte","organe_coupure":"ferme","pointe_mobile":"AUCUN","preavis_pointe_mobile":"AUCUN","producteur":0,"sens_energie_active":"positive","surtension_phase":0,"sync_cpl":"non_synchronise","tarif_dist":"index_2","tarif_four":"index_1","tempo_demain":"UNDEF","tempo_jour":"UNDEF","type_tic":"standard"},"update":{"installed_version":1,"latest_version":14,"state":"available"},"update_available":true,"warn_d_p_s":0}'

warning 2024-09-24 19:49:14zhc:lixee: Failed to read zigbee attributes: Error: ZCL command 0x00158d0005ce76da/1 haMeterIdentification.read(["availablePower"], {"timeout":10000,"disableResponse":false,"disableRecovery":false,"disableDefaultResponse":true,"direction":0,"reservedBits":0,"manufacturerCode":null,"writeUndiv":false}) failed (no response received (115) waiting for response TIMEOUT)

info 2024-09-24 19:49:15z2m:mqtt: MQTT publish: topic 'zigbee2mqtt/0x00158d0005ce76da', payload '{"active_enerfy_out_d01":5126,"active_energy_out_d01":5624.11,"active_power":568,"active_power_max":1061,"active_power_ph_b":352,"active_register_tier_delivered":"","apparent_power":2447,"available_power":6,"average_rms_voltage_meas_period":234,"current_date":"","current_index_tarif":0,"current_price":"","current_summ_delivered":16023.13,"current_tarif":"BASE","current_tier1_summ_delivered":0,"current_tier2_summ_delivered":0,"device":{"applicationVersion":12,"dateCode":"20240422","friendlyName":"0x00158d0005ce76da","hardwareVersion":1,"ieeeAddr":"0x00158d0005ce76da","manufacturerID":4151,"manufacturerName":"LiXee","model":"ZLinky_TIC","networkAddress":61512,"powerSource":"Mains (single phase)","softwareBuildID":"4000-0014","stackVersion":2,"type":"Router","zclVersion":3},"drawn_v_a_max_n1":0,"last_seen":"2024-09-24T17:49:15.596Z","linkquality":255,"message1":"","message2":"","meter_serial_number":"041964502262","mot_d_etat":"000000","power_threshold":6,"relais":0,"relais_breakout":{"relais1":0,"relais2":0,"relais3":0,"relais4":0,"relais5":0,"relais6":0,"relais7":0,"relais8":0},"rms_current":10,"rms_current_max":0,"rms_voltage":235,"site_id":"","software_revision":2,"status_register":"003A4001","status_register_breakout":{"cache_borne_dist":"ferme","comm_euridis":"activee avec securite","contact_sec":"ouvert","depassement_ref_pow":0,"etat_cpl":"nouveau_verrouille","horloge":"correcte","organe_coupure":"ferme","pointe_mobile":"AUCUN","preavis_pointe_mobile":"AUCUN","producteur":0,"sens_energie_active":"positive","surtension_phase":0,"sync_cpl":"non_synchronise","tarif_dist":"index_2","tarif_four":"index_1","tempo_demain":"UNDEF","tempo_jour":"UNDEF","type_tic":"standard"},"update":{"installed_version":1,"latest_version":14,"state":"available"},"update_available":true,"warn_d_p_s":0}'`

fairecasoimeme, 2024-09-26:
Vous êtes en mode historique. Pour avoir plus de données, il faut passer votre Linky en mode standard.
Pour cela, il faut suivre la procédure suivante :

Pour passer son compteur Linky du mode historique au mode standard :

    si vous êtes chez EDF, vous pouvez effectuer la demande à travers ce [formulaire](https://particulier.edf.fr/fr/accueil/espace-client/contact/demande/formulaire/decret-conso.html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) de votre espace en ligne, en choisissant ensuite "Modifier le statut de la Télé Information Client (TIC)" puis en précisant que vous souhaitez passer en mode standard dans le champ commentaire.
    si vous n'êtes pas chez EDF, il faut appeler votre Fournisseur d'Electricité, et demander le passage de votre compteur Linky en mode standard, en précisant qu’il s’agit de la prestation F185 auprès d'Enedis.

Cette opération est gratuite et en général, le changement est effectué dans les 24 heures ouvrées.

OUARZA, 2024-09-26:
Merci, je suis en standard côté Enedis et côté z2m.
J'ai mis que ces paramètres : EAST,IRMS1,URMS1,Linkquality
Ces 4 données remontent bien mais je continue à recevoir des erreurs.
Que faire ?
Merci :)

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

```
2024-09-26 21:05:55zhc:lixee: Failed to read zigbee attributes: Error: ZCL command 0x00158d0005ce76da/1 haElectricalMeasurement.read(["rmsCurrentMax"], {"timeout":10000,"disableResponse":false,"disableRecovery":false,"disableDefaultResponse":true,"direction":0,"reservedBits":0,"manufacturerCode":null,"writeUndiv":false}) failed (no response received (198) waiting for response TIMEOUT)
```

fairecasoimeme, 2024-09-27:
Bizarre qu'il demande rmsCurrentMax alors que vous ne l'avait pas dans la whitelist non ?

KipK, 2024-10-11:
Alors ja'i eu ce soucis de timeout, ca m'a pris un bon momenet avant d'en trouver la cause.
Z2M a changé le paramètre par défaut **Measurement poll chunk** sur 4 au lieu de 1 précedemment.
On ne le voit pas car le champs de  config est vide par défaut.
Et le module Lixee n'a pas l'air d'apprécier.
Depuis que je l'ai forcé sur 1 plus d'erreur.

OUARZA, 2024-10-16:
Bonsoir @KipK ,
Je suis à 60.

Mathieu

KipK, 2024-10-16:
@OUARZA tu confond ave cle paramètre Measurement poll interval qui est à 60

c'est Measurement poll chunk qu'il faut changer. Cela dit je l'ai repaassé à 3 et ça a l'air d'etre correct pour l'instant.

MilesTEG1, 2024-10-16:
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

Salut 👋🏻
Moi je l'ai mis à 1.
Est-ce que ça peut causer des soucis d'avoir une valeur de 1 au lieu de 3 ?

KipK, 2024-10-16:
ca cause un peu plus. j'étais à 1 aussi comme évoqué plus haut pour résoudre le soucis de ce topic. Puis remonté à 3 et pas d'erreur ( sauf quand le réseau est chargé avec une ota en cours )

Thread 286 (2024-09-29):

Appliquer un diviseur au metering

pierreprinetti, 2024-09-29:
Bonjour,

J'ai connecté le Zlinky_TIC en ZHA sur mon Home Assistant (Core v2024.9.3) qui se trouve à moins de deux mètres du capteur. Les données remontent bien, et je reçois certains attributes normalement (par example dans le cluster Basic: app_version `14`, date_code `20240422`, sw_build_id `4000-0014`).

Comme Home Assistant s'attend à recevoir des kWh et le Zlinky_TIC remonte des Wh, je voudrais enregistrer un diviseur de `1000` comme attribute `divisor (id: 0x0302)` dans le cluster `Metering (Endpoint id: 1, Id: 0x0702, Type: in)`.

Cependant: j'entre `1000` dans "Value", je tape "Write attribute", j'ai un joli check blanc sur fond vert, et rien ne se passe. L'enregistrement est toujours en Wh et si je tape "Read attribute", le champ Value prend la valeur `None`.

Est-ce que j'ai mal compris comment enregistrer un diviseur?

pierreprinetti, 2024-10-03:
En attendant une solution pour régler le problème à la base, voici comment j'ai finalement ajouté un senseur "template" dans ma configuration HomeAsssistant:

```yaml
# dans configuration.yaml

# [...]

template:
  - sensor:
    - name: "Linky"
      unique_id: "lixee_zlinky_tic_summation_delivered_millesime"
      unit_of_measurement: "Wh"
      device_class: energy
      state_class: total_increasing
      state: "{{ states('sensor.lixee_zlinky_tic_summation_delivered') | float }}"
```

J'ai ensuite ajouté ce nouveau senseur virtuel au volet "Energie" pour visualiser ma consommation en électricité.

Nbird67, 2024-10-06:
Bonjour,
J’ai exactement le même problème de diviseur
Pour moi suite à Maj firmware 14 en 13 c’était bon.

Si quelqu’un a une solution je suis preneur, j’ai du également passer par des templates

je suis ravi de ne pas être le seul.

https://github.com/fairecasoimeme/Zlinky_TIC/issues/18

https://github.com/zigpy/zha-device-handlers/issues/3365

ced30fr, 2024-10-08:
Je confirme avoir récemment acheté un module en version 14 et rencontrer le même problème. Existe-t-il une solution pour effectuer un downgrade en attendant une correction ?

Nbird67, 2024-10-08:
Le créateur @fairecasoimeme a indiqué que ce n'est pas lié au firmware à priori, mais à quoi alors ???

uowis, 2024-10-13:
I have this issue
J'ai cette issue

yomgui1, 2024-10-15:
Même chose, je suis passé de Z2M à ZHA, j'était en firmare 14, et toutes les valeurs de puissances sont multipliées par 1000.

fairecasoimeme, 2024-10-18:
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

Bin ZHA

blauret, 2024-10-18:
ok, desole je n'a pas trouve le commentaire....

`
class ZLinkyTICMetering(CustomCluster, Metering):
    """ZLinky_TIC custom metring cluster."""

    # ZLinky_TIC reports current_summ_delivered in Wh
    # Home Assistant expects kWh (1kWh = 1000 Wh)
    MULTIPLIER = 0x0301
    DIVISOR = 0x0302
    _CONSTANT_ATTRIBUTES = {MULTIPLIER: 1, DIVISOR: 1000}
`

On dirait que le code est deja la pour la division.

blauret, 2024-10-21:
L'origine du probleme dans ZHA est que le Zlinky_TIC n'est plus correctement reconnue par homeassistant, selon moi, a cause d'un changement dans la signature du Zlinky_TIC

```
2024-10-21 11:16:08.645 DEBUG (MainThread) [zigpy.quirks.registry] Checking quirks for LiXee ZLinky_TIC (00:15:8d:00:05:be:83:47)
2024-10-21 11:16:08.645 DEBUG (MainThread) [zigpy.quirks.registry] Considering <class 'zhaquirks.lixee.zlinky.ZLinkyTICFWV12'>
2024-10-21 11:16:08.646 DEBUG (MainThread) [zigpy.quirks] Fail because input cluster mismatch on at least one endpoint
2024-10-21 11:16:08.646 DEBUG (MainThread) [zigpy.quirks.registry] Considering <class 'zhaquirks.lixee.zlinky.ZLinkyTIC'>
2024-10-21 11:16:08.646 DEBUG (MainThread) [zigpy.quirks] Fail because input cluster mismatch on at least one endpoint
```

Le resultat est que le divisor qui est dans le quirk n'est plus applique.

Apres une modification du quirk:

```

2024-10-21 11:20:43.017 DEBUG (MainThread) [zigpy.quirks.registry] Checking quirks for LiXee ZLinky_TIC (00:15:8d:00:05:be:83:47)
2024-10-21 11:20:43.017 DEBUG (MainThread) [zigpy.quirks.registry] Considering <class 'zhaquirks.lixee.zlinky.ZLinkyTICFWV12'>
2024-10-21 11:20:43.017 DEBUG (MainThread) [zigpy.quirks] Device matches filter signature - device ieee[00:15:8d:00:05:be:83:47]: filter signature[{'models_info': [('LiXee', 'ZLinky_TIC')], 'endpoints': {1: {'profile_id': 260, 'device_type': <DeviceType.METER_INTERFACE: 83>, 'input_clusters': [0, 1, 1, 3, 10, 1794, 2817, 2820, 61184, 65382], 'output_clusters': [25, 61184]}, 242: {'profile_id': 41440, 'device_type': <DeviceType.PROXY_BASIC: 97>, 'input_clusters': [33], 'output_clusters': [33]}}}]
2024-10-21 11:20:43.017 DEBUG (MainThread) [zigpy.quirks.registry] Found custom device replacement for 00:15:8d:00:05:be:83:47: <class 'zhaquirks.lixee.zlinky.ZLinkyTICFWV12'>
```

Le changement

```diff
diff --git a/zhaquirks/lixee/zlinky.py b/zhaquirks/lixee/zlinky.py
index 3891fe0..57c7a0d 100644
--- a/zhaquirks/lixee/zlinky.py
+++ b/zhaquirks/lixee/zlinky.py
@@ -11,6 +11,7 @@ from zigpy.zcl.clusters.general import (
     Identify,
     Ota,
     PowerConfiguration,
+    Time,
 )
 from zigpy.zcl.clusters.homeautomation import ElectricalMeasurement, MeterIdentification
 from zigpy.zcl.clusters.smartenergy import Metering
@@ -157,13 +158,16 @@ class ZLinkyTIC(CustomDevice):
                 DEVICE_TYPE: zha.DeviceType.METER_INTERFACE,
                 INPUT_CLUSTERS: [
                     Basic.cluster_id,
+                    PowerConfiguration.cluster_id,
                     Identify.cluster_id,
+                    Time.cluster_id,
                     Metering.cluster_id,
                     MeterIdentification.cluster_id,
                     ElectricalMeasurement.cluster_id,
+                    0xef00,
                     ZLinkyTICManufacturerCluster.cluster_id,
                 ],
-                OUTPUT_CLUSTERS: [Ota.cluster_id],
+                OUTPUT_CLUSTERS: [Ota.cluster_id, 0xef00],
             },
             242: {
                 PROFILE_ID: zgp.PROFILE_ID,
@@ -182,6 +186,7 @@ class ZLinkyTIC(CustomDevice):
                     Basic.cluster_id,
                     PowerConfiguration.cluster_id,
                     Identify.cluster_id,
+                    Time.cluster_id,
                     ZLinkyTICMetering,
                     MeterIdentification.cluster_id,
                     ElectricalMeasurement.cluster_id,

``

La question pour @fairecasoimeme, est-ce que le cluster 0xFE00 est documenté quelque part? Je n'ai pas vu dans le README du projet.

fairecasoimeme, 2024-10-21:
Ok je comprends mieux.
Le fait d'avoir rajouté des clusters provoque un défaut de signature.
Les clusters rajoutés sont pour la compatibilité avec les plateformes Tuya. Le cLuster 0xEF00 n'est pas utile pour ZHA.
Je pense alors qu'il faut alors rajouter une signature correspondant au dernier firmware.

blauret, 2024-10-21:
@fairecasoimeme, j'ai mis in commentaire sur zigpy/zha-device-handlers#336 a propos de la nouvelle signature. Est-ce qu'il est possible que le cluster input 1 soit deux fois dans la base?

fairecasoimeme, 2024-10-21:
Pouvez-vous essayer ce fichier zlinky.py et me dire si la signature est détectée ?

[zlinky.py.zip](https://github.com/user-attachments/files/17461284/zlinky.py.zip)

blauret, 2024-10-21:
Je n'ai pas essayer mais j'ai cree une PR avec quariment le meme contenu zigpy/zha-device-handlers#3448

fairecasoimeme, 2024-10-21:
Ok parfait alors !

Bahanix, 2024-10-30:
Bonjour, je me suis initié à HA / ZLinky il y a quelques jours et j'ai le même souci que décrit ici, et je vois que la solution discutée plus haut a été merged. Comment procéder pour récupérer ce correctif sur mon HA / ZHA ? À moins qu'il faille juste être patient pour que l'update soit proposée du HA ?

blauret, 2024-10-31:
> Bonjour, je me suis initié à HA / ZLinky il y a quelques jours et j'ai le même souci que décrit ici, et je vois que la solution discutée plus haut a été merged. Comment procéder pour récupérer ce correctif sur mon HA / ZHA ? À moins qu'il faille juste être patient pour que l'update soit proposée du HA ?

IL faut juste etre patient et attendre une nouvelle release de homeassistant. L'autre solution est d'utilise le quirks avec le patch localement. Les instructions sont ici:

https://community.home-assistant.io/t/zigbee-guide-how-to-add-setup-local-custom-zha-device-handlers-also-known-as-quirks-in-the-zha-integration/683473

blauret, 2024-10-31:
@fairecasoimeme , a mon avis on peux cloturer ce ticket.

fairecasoimeme, 2024-10-31:
thank you for all

Closed 2024-10-31.

Thread 288 (2024-10-03):

Lixee, blocage de certaines mesures

jacquot68, 2024-10-03:
Bonjour,
Depuis 1 mois, j'essaie de résoudre le problème suivant :
Mon linky est en mode Standard, triphasé et sans production. Connecté via Z2M. Sa version est "Version du firmware  4000-0014"
Les infos remontent correctement pour une durée variable puis j'ai quatre grandeurs (concernant la phase 2 et 3) qui restent bloquées sur une valeur fixe alors que le reste remonte normalement.
J'ai mis en place un white list

"EASF01,EASF02,EASF03,EASF04,EASF05,EASF06,SINSTS1,SINSTS2,SINSTS3,URMS1,URMS2,URMS3,CCASN,SINSTS,HHPHC"

Mais cela ne change rien, le blocage des informations concernant la phase 2 et 3 est toujours présent.

Un redémarrage de Z2M permet d'obtenir à nouveau toutes les informations pour une durée aléatoire.

Ci-dessous payload infos `bloquées:
`z2m:mqtt: MQTT publish: topic 'zigbee2mqtt/Linky', payload '{"active_energy_out_d01":3937.9,"active_energy_out_d02":8057.3,"active_power":276,"active_power_max":20,"active_power_max_ph_b":1040,"active_power_max_ph_c":3170,"active_power_ph_b":219,"apparent_power":19,"apparent_power_ph_b":42,"apparent_power_ph_c":451,"available_power":12,"average_rms_voltage_meas_period":238,"average_rms_voltage_meas_period_ph_c":241,"average_rms_voltage_measure_period_ph_b":235,"current_date":"E240924162219","current_index_tarif":2,"current_price":"HP BLEU","current_summ_delivered":13940.1,"current_tarif":"TEMPO","current_tier1_summ_delivered":10392.8,"current_tier2_summ_delivered":2827,"current_tier3_summ_delivered":89.4,"current_tier4_summ_delivered":403.8,"current_tier5_summ_delivered":50.7,"current_tier6_summ_delivered":176.3,"drawn_v_a_max_n1":430,"drawn_v_a_max_n1_p2":4440,"drawn_v_a_max_n1_p3":2190,"linkquality":152,"message1":"PAS DE MESSAGE","message2":"","meter_serial_number":"022176056507","power_threshold":12,"relais":0,"relais_breakout":{"relais1":0,"relais2":0,"relais3":0,"relais4":0,"relais5":0,"relais6":0,"relais7":0,"relais8":0},"rms_current":0,"rms_current_ph_b":0,"rms_current_ph_c":5,"rms_voltage":239,"rms_voltage_ph_b":232,"rms_voltage_ph_c":234,"site_id":"06390882722955","software_revision":2,"status_register":"013A4401","status_register_breakout":{"cache_borne_dist":"ferme","comm_euridis":"activee avec securite","contact_sec":"ouvert","depassement_ref_pow":0,"etat_cpl":"nouveau_verrouille","horloge":"correcte","organe_coupure":"ferme","pointe_mobile":"AUCUN","preavis_pointe_mobile":"AUCUN","producteur":0,"sens_energie_active":"positive","surtension_phase":0,"sync_cpl":"non_synchronise","tarif_dist":"index_2","tarif_four":"index_2","tempo_demain":"UNDEF","tempo_jour":"BLEU","type_tic":"standard"},"total_apparent_power":389,"update":{"installed_version":14,"latest_version":14,"state":"idle"},"update_available":null}'`

Payload après re-demarrage Z2M:
`2024-10-03 08:35:25z2m:mqtt: MQTT publish: topic 'zigbee2mqtt/Linky', payload '{"active_energy_out_d01":3937.9,"active_energy_out_d02":8058.1,"active_power":307,"active_power_max":20,"active_power_max_ph_b":1040,"active_power_max_ph_c":3170,"active_power_ph_b":327,"apparent_power":18,"apparent_power_ph_b":42,"apparent_power_ph_c":453,"available_power":12,"average_rms_voltage_meas_period":236,"average_rms_voltage_meas_period_ph_c":241,"average_rms_voltage_measure_period_ph_b":235,"current_date":"E240924162219","current_index_tarif":2,"current_price":"HP BLEU","current_summ_delivered":13940.8,"current_tarif":"TEMPO","current_tier1_summ_delivered":10392.8,"current_tier2_summ_delivered":2827.8,"current_tier3_summ_delivered":89.4,"current_tier4_summ_delivered":403.8,"current_tier5_summ_delivered":50.7,"current_tier6_summ_delivered":176.3,"drawn_v_a_max_n1":430,"drawn_v_a_max_n1_p2":4440,"drawn_v_a_max_n1_p3":2190,"linkquality":148,"message1":"PAS DE MESSAGE","message2":"","meter_serial_number":"022176056507","power_threshold":12,"relais":0,"relais_breakout":{"relais1":0,"relais2":0,"relais3":0,"relais4":0,"relais5":0,"relais6":0,"relais7":0,"relais8":0},"rms_current":0,"rms_current_ph_b":0,"rms_current_ph_c":5,"rms_voltage":236,"rms_voltage_ph_b":230,"rms_voltage_ph_c":240,"site_id":"06390882722955","software_revision":2,"status_register":"013A4401","status_register_breakout":{"cache_borne_dist":"ferme","comm_euridis":"activee avec securite","contact_sec":"ouvert","depassement_ref_pow":0,"etat_cpl":"nouveau_verrouille","horloge":"correcte","organe_coupure":"ferme","pointe_mobile":"AUCUN","preavis_pointe_mobile":"AUCUN","producteur":0,"sens_energie_active":"positive","surtension_phase":0,"sync_cpl":"non_synchronise","tarif_dist":"index_2","tarif_four":"index_2","tempo_demain":"UNDEF","tempo_jour":"BLEU","type_tic":"standard"},"total_apparent_power":473,"update":{"installed_version":14,"latest_version":14,"state":"idle"},"update_available":null}'`

Je constate que malgré la white list toutes les informations du Lixee remontent vers Z2M! par contre sur le tableau de board de Z2M seul la white list est affichée.

Merci de m'éclairer sur le sujet afin de trouver une solution à ce désagrément.
Cdt
Jacquot

jacquot68, 2024-10-09:
Bonjour
J'ai remarqué que les mesurent qui bloquaient ne figuraient pas dans le rapport de z2m du linky. Le fait de les avoir rajoutés semble avoir résolu le blocage.

Cdt
Jacquot

Kistrof, 2025-01-13:
Bonjour, j'ai le même problème : certaines valeurs ne sont plus mises à jour, mais je suis en mode historique et j'utilise ZHA (et non Z2M).
Les index de conso (tempo) sont figés alors que la puissance apparente et l'intensité sont bien mises à jour plusieurs fois par minute.
Si je recharge ZHA, les index remontent mais une seule fois et sont de nouveau bloqués.

fairecasoimeme, 2025-01-14:
Bonjour,

La seule chose qui peut expliquer cela, c'est que lors de l'appairage, les requêtes de BIND ou config report ne passe pas. La seule manière de corriger est de cliquer sur le bouton orange de reconfiguration pour Z2M et pour ZHA de relancer l'appairage.

Kistrof, 2025-01-14:
Effectivement j'ai corrigé en supprimant le device de ZHA et j'ai ensuite refait l'appairage, mais je ne m'explique pas ce qui a cause le soucis car ça a bien fonctionné pendant plusieurs jours (upgrade ou restart de HA ?)

Kistrof, 2025-01-24:
Update: un restart de HA peut engendrer le soucis, mais si le soucis est déjà présent, un rechargement de ZHA met à jour les valeurs, mais juste une fois (cf. screenshot, j'ai rechargé ZHA il y a 27 minutes) mais je ne comprends pas le journal d'évènements du device qui indique au moment du problème qu'il semble perdre les infos du device, jusqu'à indiquer qu'il a été éteint, alors que la valeur de courant et de puissance apparente continuent de remonter en temps réel.

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

Si je peux déjà éviter d'avoir à le supprimer et aller débrancher et rebrancher le zlinky ...

fairecasoimeme, 2025-01-24:
Bonjour,

Pourtant un redémarrage de HA n'a pas de lien avec le ZLinky mais plutôt votre coordinateur zigbee.
Je pense qu'il faut plutôt regarder de ce côté. Quel coordinateur utilisez-vous ?

Kistrof, 2025-01-27:
C'est un Sonoff Zigbee 3.0 USB Dongle Plus V2 (EFR32MG21)

fairecasoimeme, 2025-01-28:
Peut-être essayer de passer en mode firmware limited si vous avez un réseau zigbee avec beaucoup d'appareils qui passent par le ZLinky

Kistrof, 2025-01-28:
Je n'ai que 9 appareils Zigbee : 5 endpoints, 3 dongles Sonoff (1 coordinateur et 2 routeurs) et le ZLinky.
A priori, le ZLinky ne capte que les 3 dongles, mais je crois que parfois il capte 2 ou 3 des 5 appareils.
Je peux essayer de le passer en mode limited (pas sûr de la marche à suivre en OTA), vu son emplacement il n'a aucun intérêt à faire routeur, c'est lui l'appareil le plus éloigné de tout !

Kistrof, 2025-01-28:
Update: j'ai lu la version du firmware du ZLinky via ZHA, ça a fait planter la collecte ... comment je peux voir si le problème vient du ZLinky, du coordinateur ou de ZHA ? (logs de débuts de ZHA ?)

Thread 300 (2024-11-26):

Intégration LIxee V2 sur HA

Jrbebel, 2024-11-26:
Bonjour,
J'aurai besoin d'aide pour connecter mon Lixee V2.
Aussitôt reçu,je l'ai connecté sur mon linky, Je n'ai reçu aucune valeur du module.
J'ai demandé à mon fournisseur de passer en mode standard en même temps.
Actuellement je suis en TIC en mode standard et en firmware 14 mais j'ai toujours des valeurs null qui me sont retourné.
Pouvez vous m'aider sur mon problème

Voici mes l'etat :

`{
    "active_register_tier_delivered": "",
    "apparent_power": 0,
    "current_summ_delivered": 0,
    "current_tarif": "BASE",
    "current_tier1_summ_delivered": 0,
    "current_tier2_summ_delivered": 0,
    "current_tier3_summ_delivered": 0,
    "current_tier4_summ_delivered": 0,
    "current_tier5_summ_delivered": 0,
    "current_tier6_summ_delivered": 0,
    "linkquality": 98,
    "meter_serial_number": "",
    "mot_d_etat": "000000",
    "rms_current": 0,
    "rms_current_max": 0,
    "schedule_h_p_h_c": 0,
    "start_notice_e_j_p": 0,
    "tomorrow_color": "",
    "update": {
        "installed_version": 14,
        "latest_version": 14,
        "state": "idle"
    },
    "warn_d_p_s": 0,
    "MOTDETAT": null,
    "available_power": null,
    "device": {
        "applicationVersion": 14,
        "dateCode": "20240422",
        "friendlyName": "0x00158d0006203af9",
        "hardwareVersion": 1,
        "ieeeAddr": "0x00158d0006203af9",
        "manufacturerID": 4151,
        "manufacturerName": "LiXee",
        "model": "ZLinky_TIC",
        "networkAddress": 52809,
        "powerSource": "Mains (single phase)",
        "softwareBuildID": "4000-0014",
        "stackVersion": 2,
        "type": "Router",
        "zclVersion": 3
    },
    "update_available": null,
    "active_energy_out_d01": null,
    "active_energy_out_d02": null,
    "active_power": null,
    "active_power_max": null,
    "active_power_ph_b": null,
    "average_rms_voltage_meas_period": null,
    "current_date": null,
    "current_index_tarif": null,
    "current_price": null,
    "drawn_v_a_max_n1": null,
    "message1": null,
    "message2": null,
    "power_threshold": null,
    "relais": null,
    "rms_voltage": null,
    "site_id": null,
    "software_revision": null,
    "status_register": null
}`

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

fairecasoimeme, 2024-11-27:
La led clignote-t-elle toutes les secondes ou toutes les 3 secondes ?

Jrbebel, 2024-11-27:
Elle clignote toutes les secondes

fairecasoimeme, 2024-11-27:
ok dans ce cas, il faut contacter le SAV sur contact[at]lixee.fr

Closed 2024-11-27.

Thread 302 (2024-11-30):

Possibilité de régler le reporting max sous les 60 secondes

KipK, 2024-11-30:
Salut @fairecasoimeme

J'aimerais pouvoir régler le reporting max de Sinst sous les 60 secondes qui est la limite  logicielle pour l'instant.

Depuis quelques mois j'ai mon sinst réglé en reporting min sur 10s avec un changement minimum sur 1.
Cela fonctionne bien sur mon linky, j'ai bien sinst toutes les 10s.

Aujourd'hui je voudrais changer un truc pour avoir plus de reactivité sur les gros changements, et je me rend compte que la valeur reporting max est bloquée à 60 sec minium.

Je voudrais pouvoir regler le min reporting sur 1s, et le max sur 20s, avec une valeur de changement minimum de 500 pour que seules les changements de puissance > 500VA soient mis à jours immediatement et le reste à 20.
Au final ca ferait moins de messages à envoyer, avec le confort d'avoir bien les changements importants en quasi temps réél.
J'ai testé déjà avec la limite actuelle, donc le max sur 61sec, le min sur 1sec, et changement min sur 1 et ca fonctionne impec.

Possible d'avoir ça pour la prochaine maj ?

Merci à toi

fairecasoimeme, 2024-12-02:
Bonjour,

Oui, je peux créer une version spécifique pour commencer avec cette modification et que tu puisses la tester.
De mémoire tu utilises une version limited ?

KipK, 2024-12-02:
Top merci.
Je suis en version standard maintenant.

fairecasoimeme, 2024-12-03:
ok je compile une version asap

fairecasoimeme, 2024-12-04:
J'ai pas pu tester mais normalement c'est ok

[ZLinky_router_v14_MAX_Report.zip](https://github.com/user-attachments/files/18009852/ZLinky_router_v14_MAX_Report.zip)

KipK, 2024-12-04:
Merci d'avoir pris le temps pour ça.

Apperement ca ne passe pas, si je mets une valeur inférieure à 61 pour "Max rep Interval" sur SINST, il renvoie toujours la même erreur:

`z2m: Request 'zigbee2mqtt/bridge/request/device/configure_reporting' failed with error: 'ZCL command 0x00158d000638e0dc/1 haElectricalMeasurement.configReport([{"attribute":"apparentPower","minimumReportInterval":1,"maximumReportInterval":20,"reportableChange":500}], {"timeout":10000,"disableResponse":false,"disableRecovery":false,"disableDefaultResponse":true,"direction":0,"reservedBits":0,"writeUndiv":false}) failed (Status 'INVALID_VALUE')'`

fairecasoimeme, 2024-12-06:
erf OK
Je vais faire plus de tests ASAP alors

fairecasoimeme, 2024-12-07:
oui c'est exactement ce que j'ai fait en modification mais apparemment ça ne suffit pas. Il faut que j'investigue plus

KipK, 2024-12-07:
> oui c'est exactement ce que j'ai fait en modification mais apparemment ça ne suffit pas. Il faut que j'investigue plus

Et tu avais définis aussi

`ZCL_ATTRIBUTE_REPORTING_SERVER_SUPPORTED`
?

fairecasoimeme, 2024-12-07:
Oui, c'est plus un problème (je pense) de timer. je cherche actuellement, mais je pense qu'il doit y avoir un timer à 60 sec quelque part qui bloque. je cherche par rapport à l'erreur retournée : E_ZCL_ERR_INVALID_VALUE

fairecasoimeme, 2024-12-07:
Normalement c'est ok.
[ZLinky_router_v14_MAX_Report2.zip](https://github.com/user-attachments/files/18048016/ZLinky_router_v14_MAX_Report2.zip)

KipK, 2024-12-07:
C'est tout bon 👍 Merci

fairecasoimeme, 2024-12-13:
C'était juste la compilation qui ne prenait pas en charge mon fichier .h :)
As-tu un retour sur le fonctionnement de ton nouveau reporting ?

KipK, 2024-12-13:
oui ca fonctionne impec. J'ai bien la remontée SINST en instantané pour ce qui est superieur à 500VA et un refresh toutes les 20s dans tout les cas.
Ca change pas mal la donne, je n,'arrive plus à faire sauter le compteur avec la borne de recharge maintenant :)

fairecasoimeme, 2024-12-13:
👍

Closed 2024-12-13.

Thread 313 (2025-01-03):

Erreur paramétrage rapport table_full

ritonls, 2025-01-03:
Bonjour,

Je ne peux pas modifier les rapports de mon zlink yvia l'onglet Rapport de Z2M.
J'ai supprimé mon zlinky et reset via le bouton, reboot Z2M & Homeassistant et enfin réassocié le Zlinky et Z2M

Quand je clique sur le bouton reconfigurer, j'obtiens cette erreur:
`error 2025-01-03 17:10:26z2m: Failed to configure 'ZLinky_TIC', attempt 5 (Error: ZCL command 0x00158d00062034a1/1 haElectricalMeasurement.configReport([{"attribute":"totalReactivePower","minimumReportInterval":60,"maximumReportInterval":900,"reportableChange":1}], {"timeout":10000,"disableResponse":false,"disableRecovery":false,"disableDefaultResponse":true,"direction":0,"reservedBits":0,"manufacturerCode":null,"writeUndiv":false}) failed ({"target":41197,"apsFrame":{"profileId":260,"clusterId":2820,"sourceEndpoint":1,"destinationEndpoint":1,"options":4416,"groupId":0,"sequence":163},"zclSequence":178,"commandIdentifier":7} timed out after 10000ms) at Object.start (/app/node_modules/zigbee-herdsman/src/adapter/ember/adapter/oneWaitress.ts:195:23) at EmberOneWaitress.startWaitingFor (/app/node_modules/zigbee-herdsman/src/adapter/ember/adapter/oneWaitress.ts:219:50) at /app/node_modules/zigbee-herdsman/src/adapter/ember/adapter/emberAdapter.ts:2131:55 at Queue.execute (/app/node_modules/zigbee-herdsman/src/utils/queue.ts:36:20) at EmberAdapter.sendZclFrameToEndpoint (/app/node_modules/zigbee-herdsman/src/adapter/ember/adapter/emberAdapter.ts:2070:16) at Request.send (/app/node_modules/zigbee-herdsman/src/controller/helpers/request.ts:82:20) at Endpoint.sendRequest (/app/node_modules/zigbee-herdsman/src/controller/model/endpoint.ts:325:20) at Endpoint.zclCommand (/app/node_modules/zigbee-herdsman/src/controller/model/endpoint.ts:951:28) at Endpoint.configureReporting (/app/node_modules/zigbee-herdsman/src/controller/model/endpoint.ts:688:9) at async Promise.allSettled (index 11))`

Et lors de mes tentatives, j'obtenais également une erreur table_full

Est il possible de reinitialiser les rapports dans le zlinky ? ou de le remettre en configuration usine?

Zlinky en version 14limited
Home assistant avec Z2M:
Version de Zigbee2MQTT
[1.42.0]
Type de coordinateur
EmberZNet
Révision du coordinateur
7.4.5 [GA]
Adresse IEEE du Coordinateur
0x8c65a3fffeb09af4
Version de l'interface
0.7.6
Version Zigbee-herdsman-converters
20.58.0
Version Zigbee-herdsman
2.1.9

ritonls, 2025-01-03:
J'ai retrouvé le log d'erreur avec la TABLE_FULL
`error 2025-01-03 18:59:05z2m: Request 'zigbee2mqtt/bridge/request/device/configure_reporting' failed with error: 'Bind 0x00158d00062034a1/1 genIdentify from '0x8c65a3fffeb09af4/1' failed (Status 'TABLE_FULL')'`

fairecasoimeme, 2025-01-06:
Quand il y a ce type d'erreur, c'est qu'il y a un bind qui s'est mal passé ou avec un cluster de trop.
Le seul moyen est de reset et refaire l'appairage

ritonls, 2025-01-08:
> Quand il y a ce type d'erreur, c'est qu'il y a un bind qui s'est mal passé ou avec un cluster de trop.
> Le seul moyen est de reset et refaire l'appairage

J'ai déjà effectué ces manipulation:
- Suppression du device dans Z2M
- reset du zlinky-V2
- re appairage

Mais pas mieux :(, Existe T'il une possibilité de faire un reset usine du ZLinky ?

ritonls, 2025-01-11:
@fairecasoimeme
Je viens a nouveau de faire l'essai et ca ne fonctionne toujours pas.
Est il possible de faire un reset usine SVP?

fairecasoimeme, 2025-01-13:
Pour faire un reset, il faut appuyer plus de 10 secondes sur le bouton. Le ZLinky redémarre avec la led qui clignote rapidement. les données de BIND sont alors remis à zéro.
Normalement, il n'y a pas de raisons d'avoir l'erreur de Bind. Cette erreur ne peut arriver que si un Bind a été mal enregistré.
Je n'ai pas de retour d'autres personnes avec cette erreur qui n'a pas été résolu avec le reset.

ritonls, 2025-01-14:
Ok et bien meme après plusieurs reset et reassociation, c'est pareil.
J'ai meme rebasculer le firmware de limited vers normal, puis suppression et reasso

fairecasoimeme, 2025-01-15:
vous avez systématiquement l'erreur de TABLE FULL a chaque remise à zéro ?

Closed 2025-01-06.

Thread 314 (2025-01-04):

Reporting impossible avec injectedVA

sdalu, 2025-01-04:
Bonjour

J'eassaye de configurer Zlinky pour avoir une remonté d'info toutes les minutes pour la puissance injectée (panneau solaire),
pour cela je veux configurer le cluster privé correspondant a injectedVA, mais j'obtient l'erreur suivante avec zigbee2mqtt

~~~
z2m: Request 'zigbee2mqtt/bridge/request/device/configure_reporting' failed with error: 'ZCL command 0x00158d0005d2977d/1 liXeePrivate.configReport([{"attribute":"injectedVA","minimumReportInterval":60,"maximumReportInterval":600,"reportableChange":0}], {"timeout":10000,"disableResponse":false,"disableRecovery":false,"disableDefaultResponse":true,"direction":0,"reservedBits":0,"manufacturerCode":4151,"writeUndiv":false}) failed (Timeout - 14245 - 1 - 133 - 65382 - 7 after 10000ms)'
~~~

Est-ce que c'est quelque chose de prevu par le périférique ?
Je n'ai pas de probleme pour ajouter par example pour ajouter `seMetering` .`currentSummReceived`

ritonls, 2025-01-04:
Bonjour,
Pour les données d'injection, je regarde le paramètre seMetering currentSumDelivered, ca me donne l'injection en W par contre et pas en VA, mais ca marche plutôt bien.

Thread 316 (2025-01-21):

erreurs d'acquisition avec un SAGEMCOM - TEMPO

bwallrich, 2025-01-21:
Bonjour,

Je tente de connecter mon ZLinky_TIC à mon Linky SAGEMCOM (avec abonnement TEMPO).
Si coté  zigbee tout semble bien se passer, le voyant lumineux persiste à clignoter 1x par seconde, signe qu'il rencontre des erreurs lors de l'acquisition des données du Linky.

Les messages recu sur coté zigbee (renvoyé sur ma passerelle MQTT) arrivent bien mais les valeurs sont à 0.

Je n'arrive pas à trouver ce qui ne colle pas.

`
MQTT publish: topic 'home/linky', payload {
    "active_enerfy_out_d01": 0,
    "active_power": 0,
    "active_power_max": 0,
    "active_power_ph_b": 0,
    "apparent_power": 0,
    "average_rms_voltage_meas_period": 0,
    "current_date": "",
    "current_index_tarif": 0,
    "current_price": "",
    "current_summ_delivered": 0,
    "current_tarif": "BASE",
    "current_tier1_summ_delivered": 0,
    "current_tier2_summ_delivered": 0,
    "drawn_v_a_max_n1": 0,
    "linkquality": 132,
    "message1": "",
    "message2": "",
    "meter_serial_number": "",
    "relais": 0,
    "rms_current": 0,
    "rms_voltage": 0,
    "site_id": "",
    "status_register": "",
    "update": {
        "installed_version": 1,
        "latest_version": 14,
        "state": "available"
    }
}
`

fairecasoimeme, 2025-01-22:
Bonjour,
Si le ZLinky clignote toutes les seconde et que vous êtes en mode standard, il est possible que votre ZLinky ait un problème matériel.
veuillez contacter par mail contact[at]lixee.fr

bwallrich, 2025-01-22:
merci ! je fais ca.

Closed 2025-01-22.

Thread 319 (2025-02-03):

Le sensor LTARF indique "HP BLEU" alors que NTARF a la valeur 6 (HP ROUGE)

cperrier, 2025-02-03:
Bonjour,

Je viens de constater, pour la première fois, un comportement curieux de mon ZLinky. Depuis 2 jours, le sensor LTARF indique "HP BLEU" alors que le Linky indique "HP ROUGE" (dernier jour rouge 2024/2025 aujourd'hui!).

J'ai cru à un moment que le ZLinky était planté, mais tous les autres sensors sont correctement mis à jour. C'est la première fois que je constate ce comportement.

La version de firmware est 4001-0014 (version 14 en mode "limited").

Je n'ai pas encore totalement réinitialisé le ZLinky, j'ai juste essayé de le déconnecter quelques secondes et le reconnecter, mais cela n'a rien résolu.

Je suis bien sûr en tarif EDF TEMPO et le Linky est en mode Standard.

Au besoin je peux faire d'autre investigations si cela peut aider à trouver l'origine du problème. J'ai adapté mes automatisations (j'utilise HA) afin qu'elles se basent sur NTARF en plus de LTARF.

jpouyaud-perso, 2025-02-03:
J’ai le même problème
Tempo également

J’ai upgrade en v15 et depuis j’ai carrément plus rien

cperrier, 2025-02-03:
Plus rien dans quel sens ? Plus de problème ou bien plus de retour sur la période tarifaire ?

Pour ma part, je n'ai pas vu arriver de version 15 "limited" du firmware en OTA sur Z2M, d'ailleurs. Peut-être cette version est-elle en fait assez récente ?

Après le très gros travail de KipK (https://github.com/fairecasoimeme/Zlinky_TIC/issues/290) qui a fait en sorte qu'on pouisse avoir une méthode pour faire une MAJ de firmware "normal-->limited" en OTA dans Z2M, j'attendais de voir si les MAJ de firmware arrivaient "automatiquement" dans Z2M pour ceux d'entre nous qui sont passés en firmware "limited" pour éviter les "plantages" qui se produisent quand des capteurs Zigbee s'appairent avec le ZLinky. Mais, bon, c'est peut-être plus compliqué à faire pour @fairecasoimeme ou bien il n'a pas le temps non plus (ce que je comprendrais tout à fait).

fairecasoimeme, 2025-02-04:
Bonjour,

Oui après la mise à jour, il faut :

* Supprimer le ZLinky de Z2M
* Réappairer

Pour je ne sais quelle raison sur Z2M, après la mise à jour, le ZLinky ne fait plus l'acquisition de données du Linky

Je vais regarder pour la prochaine mise à jour pour corriger ce point

Concernant LTARF, c'est une donnée qui est en read only et qui ne peut pas remonter sans qu'on le poll. Du coup, il peut y avoir un décalage par rapport à la réalité.
Normalement le meilleur moyen de récupérer les couleurs du jour et du lendemain est d'utiliser le registre de statut STGE (en mode standard) qui lui remonte à Z2M sur chaque changement de valeur.

La valeur STGE est brute mais il faudra faire des modifs dans le plugin pour décomposer les valeurs

Dans la nouvelle version v15 du ZLinky, il y a aussi un nouvel attribut : "tariffPeriod" qui remontera sur chaque changement de valeur et plus facile à gérer côté plugin mais pour le moment, il y a un problème

cperrier, 2025-02-04:
Bonjour et un grand merci pour la réponse détaillée...

Actuellement mon contournement pour utiliser NTARF fonctionne bien (par exemple, cet index est 4 à l'instant même alors qu'on est en HP BLANC, ce qui est logique : 1=HC BLEU, 2=HP BLEU, 3=HC BLANC, etc.)

STGE me semble affectivement bien cryptique à comprendre (je vois actuellement "423ACC01"), je vais donc plutôt m'en tenir là pour l'instant.

Concernant la MAJ firmware, je vois justement que Z2M me propose une mise à jour en version 15. Par contre je me demande si ce sera alors une version 15 "limited" ou "normal" si je la fais (je suis en 14 "limited" actuellement grâce aux échanges de #290 ).

Dans l'issue 290, KipK mentionnait la possibilité que ces montées de version de firmware deviennent possibles en OTA mais je ne sais pas si cela a pu être fait pour la version 15 du firmware. AU pire, je peux le faire manuellement à nouveau avec la bidouille décrite dans #290 ce qui me permettrait au moins de voir apparaître ce nouvel attribut tariffPeriod (même s'il n'est pas encore utilisable à ce que je comprends).

cperrier, 2025-02-05:
Effectivement, j'ai fait la MAJ de Z2M récemment (je suppose qu'il doit y avoir moyen de retrouver quand et confirmer si c'est au même moment que le ZLinky a cessé de mettre à jour LTARF.

Merci pour l'info. En passant si quelqu'un connaît un moyen de retrouver le moment où la MAJ d'un module complémentaire (ou d'une itnégration, d'ailleurs) a été réalisée.

En regardant le journal de Z2M, je vois apparaître ceci très régulièrement :
[2025-02-05 08:09:14] warning:  zhc:lixee: Failed to read zigbee attributes: Error: Cluster 'liXeePrivate' has no attribute 'tariffPeriod'

Ces messages ne sont dans le journal de Z2M que depuis le dernier redémarrage du module, qui semble avoir eu lieu le 2/2 à 18h52, ce qui est probablement le moment où j'ai du faire la mise à jour (Z2M recrée un nouveau répertoire dans "log" dès qu'on le redémarre).

Or, la dernière fois où LTARF a changé correctement, c'est le 2/2/2025 à 6h du matin, donc au changement de tarification de ce jour là (HC BLANC --> HP BLEU)

Il semble donc très probable que le problème vienne de la MAJ de Z2M, oui.

jessycler, 2025-02-07:
Bonne nouvelle !
Z2M a été mis à jour en version 2.1.1 à l'instant.
Grâce à cette mise à jour, mon zlinky affiche à nouveau LTARF 👍 (je suis toujours en V15 sur le zlinky).

cperrier, 2025-02-07:
Même chose pour moi. Je pense donc qu'on peut clôturer ce ticket.

Merci pour les réponses des uns et des autres et merci pour son travail, à @fairecasoimeme

AURELB87, 2025-02-07:
Bonsoir,

Pour ma part, je suis passé en V2.1.0 pour Z2M, pas de problème.
J'ai eu des problèmes avec la màj OTA V15.
Ce soir, je suis passé en V2.1.1, j'ai désappairé le Zlinku, refais l'appairage: aucune donnée ne remonte et pire, cela me fait planter Z2M (erreur '130').

Si quelqu'un a une idée, je suis preneur.

Closed 2025-02-07.

Thread 320 (2025-02-03):

Plus de remontée

95JOE210, 2025-02-03:
Bonjour,

Je n'ai plus de remonter de mon ZLinky_TIC v2 depuis la mise à jour vers la version V15. Y a t-il quelque chose a modifié après la maj?

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

fairecasoimeme, 2025-02-03:
En général sur Z2M après une mise à jour, il faut redémarrer Z2M

95JOE210, 2025-02-03:
Le redémarrage n'a pas suffit il a fallu que je supprime le ZLinky_TIC v2 et que je le réadopte. Le problème est résolu.
Merci

Mr-PoPoP, 2025-02-03:
Bonjour,

J'ai le même problème depuis la MàJ v15, mes compteurs sont vides (sauf certains), j'ai essayé aussi de réappairer (en utilisant le petit bouton de reset sur le  Zlinky) et aussi supprimer le Zlinky de la liste d'appareils, redémarrage Z2M, mais rien y fait, les compteurs sont toujours vides et j'ai des erreurs Z2M "Failed to read..."

Si quelqu'un a une idée, je suis preneur :)

`warning 2025-02-03 18:22:13zhc:lixee: Failed to read zigbee attributes: Error: ZCL command 0x00158d0006205710/1 liXeePrivate.read(["currentTarif","message1"], {"timeout":10000,"disableResponse":false,"disableRecovery":false,"disableDefaultResponse":true,"direction":0,"reservedBits":0,"manufacturerCode":null,"writeUndiv":false}) failed (Delivery failed for '34330'.)
warning 2025-02-03 18:22:13zhc:lixee: Failed to read zigbee attributes: Error: ZCL command 0x00158d0006205710/1 haMeterIdentification.read(["softwareRevision"], {"timeout":10000,"disableResponse":false,"disableRecovery":false,"disableDefaultResponse":true,"direction":0,"reservedBits":0,"manufacturerCode":null,"writeUndiv":false}) failed (Delivery failed for '17738'.)
warning 2025-02-03 18:22:18zhc:lixee: Failed to read zigbee attributes: Error: ZCL command 0x00158d0006205710/1 liXeePrivate.read(["message2","relais"], {"timeout":10000,"disableResponse":false,"disableRecovery":false,"disableDefaultResponse":true,"direction":0,"reservedBits":0,"manufacturerCode":null,"writeUndiv":false}) failed (Delivery failed for '34330'.)
warning 2025-02-03 18:22:22zhc:lixee: Failed to read zigbee attributes: Error: ZCL command 0x00158d0006205710/1 liXeePrivate.read(["statusRegister","drawnVAMaxN1"], {"timeout":10000,"disableResponse":false,"disableRecovery":false,"disableDefaultResponse":true,"direction":0,"reservedBits":0,"manufacturerCode":null,"writeUndiv":false}) failed (Delivery failed for '34330'.)
warning 2025-02-03 18:22:27zhc:lixee: Failed to read zigbee attributes: Error: ZCL command 0x00158d0006205710/1 haElectricalMeasurement.read(["activePower","activePowerPhB"], {"timeout":10000,"disableResponse":false,"disableRecovery":false,"disableDefaultResponse":true,"direction":0,"reservedBits":0,"manufacturerCode":null,"writeUndiv":false}) failed (Delivery failed for '34330'.)
warning 2025-02-03 18:22:32zhc:lixee: Failed to read zigbee attributes: Error: ZCL command 0x00158d0006205710/1 haElectricalMeasurement.read(["averageRmsVoltageMeasPeriod","rmsVoltage"], {"timeout":10000,"disableResponse":false,"disableRecovery":false,"disableDefaultResponse":true,"direction":0,"reservedBits":0,"manufacturerCode":null,"writeUndiv":false}) failed (Delivery failed for '34330'.)
warning 2025-02-03 18:22:37zhc:lixee: Failed to read zigbee attributes: Error: ZCL command 0x00158d0006205710/1 haElectricalMeasurement.read(["activePowerMax"], {"timeout":10000,"disableResponse":false,"disableRecovery":false,"disableDefaultResponse":true,"direction":0,"reservedBits":0,"manufacturerCode":null,"writeUndiv":false}) failed (Delivery failed for '34330'.)`

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

Lesuperlolo, 2025-02-03:
Même problème ici.
Forcer la suppression sous Z2M et appairer à nouveau a été sans effet, le ZLinky ayant même le statut indisponible au bout de plusieurs tentatives.
Seule issue trouvée : faire un retour à une sauvegarde plus ancienne, où le Zlinky est reconnu et discute en mqtt et remonte les informations.
Mais chose étrange, il est affiché en firmware 14, et ne propose pas de mise à jour, alors que je suis certain d'avoir fait une mise à jour en v15 avec succès...

fairecasoimeme, 2025-02-04:
Bonjour,

Oui après la mise à jour, il faut :

* Supprimer le ZLinky de Z2M
* Réappairer

Pour je ne sais quelle raison sur Z2M, après la mise à jour, le ZLinky ne fait plus l'acquisition de données du Linky

Je vais regarder pour la prochaine mise à jour pour corriger ce point

Mr-PoPoP, 2025-02-04:
Pour ma part le problème est résolu. Il fallait juste un peu de patience à priori... les données sont remontées une demi-heure après la MaJ.

ghostsam45, 2025-02-04:
Même soucis pour moi ce matin, suite à la mise à jour j'ai du supprimer le Zlinky de Z2M et réappairer comme la souligner @fairecasoimeme.
Et ça prends bien 30mn environ à remonter tous les données.

NeWoKiKi, 2025-02-05:
Du coup, juste pour information, le "Measurement poll chunk" par défaut est à combien ?
Dans l'interface c'est indiqué "Default: 2", c'est toujours le cas ?
Si non, c'est recommandé de le mettre à combien ?

Je n'ai plus confiance aux champs vides maintenant donc je vais le remplir aussi xD

PierrickP, 2025-02-05:
Un peu pareil.

Il faut essayer plusieurs fois.
+ Débrancher
+ Supprimer
+ Rebrancher / Appairer
+ Forcer les paramètres (poll / précision)

Attendre 20/30mins.
Refaire si ca marche pas.
Redemarrer zigbee2mqtt

Thread 322 (2025-02-05):

Mauvais affichage de la conso suite à maj v14 -> v15

tdm-fr, 2025-02-05:
Bonjour,

J'ai un Zlinky depuis mai 2024 et j'avais directement fait la mise à jour vers la v13 avant toute utilisation.
J'avais fait la maj vers la v14 sans problème en septembre dernier.
Par contre j'ai réalisé la maj vers la v15 hier et le zlinky ne remontait plus rien, j'ai été obligé de le supprimer de Z2M et le ré-appairer.
Il a fallu du temps mais ce matin vers 8h l'envoi de données vers HA a repris mais avec une reprise étonnante, avec plus de 21k Kwh d'un seul coup.
C'est étrange car j'ai du consommer 6k KwH maximum depuis l'installation du Zlinky.

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

On ne voit rien après 8h mais il y a bien des données qui remontent, c'est juste qu'avec l'échelle ce n'est pas visible.

Cet état fait que mon historique va être totalement pollué et je ne pourrais pas m'y fier : y a t-il un moyen de supprimer cette entrée ?

adriannung, 2025-02-05:
J'ai eu la meme chose.. Il faut modifier manuellement dans Outils de développment>statistiques
Puis il faut trouver le sensor avec la mauvaise valeur dans la liste et tu devrais avoir une icone au bout de la ligne pour ajuster les valeurs.
Ensuite tu cherches la date et l’heure de la mauvaise valeur… et tu corriges.

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

tdm-fr, 2025-02-05:
Excellent, merci @adriannung !

Je n'étais jamais allé dans cet onglet statistiques, comme quoi on en apprend tous les jours :)

Closed 2025-02-05.

Thread 324 (2025-02-07):

tariffPeriod v16

Cadkey, 2025-02-07:
J'ai installé la v16, le ZLinky fonctionne, je n'ai pas d'erreur.
Je fonctionne sous deCONZ
sous l'application DeConz, je ne vois pas l'attribut 0x10 dans le cluster 0xFF66, est-ce bien 0x10 et non 0x0010?
Je ne vois pas de nouvel attribut créé dans le cluster 0xFF66 par rapport à la v14. C'est identique.
Je suis bien en v16: "swversion": "4000-0016",

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

Je n'ai pas vu de procédure particulière après avoir mis à jour le ZLinky.
Dois-je faire une opération spécifique?

fairecasoimeme, 2025-02-07:
Bonjour, oui c'est normal car Deconz doit mettre à jour de son côté le cluster
N'y a-t-il pas moyen avec les fichiers DDF de le faire ? je ne connais pas bien Deconz et si on peut faire du spécifique.

Cadkey, 2025-02-07:
Si on peut modifier le DDF et faire du spécifique, c'est ce que j'ai fait pour le ZLinky. Dans mon DDF je n'utilise pas tous les cluser/attribut, et dans l'image que je montre au-dessus, ce sont tous les cluster/attributs que detecte deCONZ.
Je vois que deCONZ ne detecte pas non plus MOTDETAT bizarrement dans la liste de tout ce que detecte l'app deCONZ.
Alors sur le module, je suis passé de v8 à V14 il y a un mois environ, puis V16. et je ne vois que ce qui est posterieur à V8 si je ne me trompe pas. C'est ce qui m'interpelle.

fairecasoimeme, 2025-02-07:
il faut alors rajouter dans le cluster 0xff66 l'attribut 0x0010 pour qu'il apparaisse dans Deconz
MOTDETAT est apparu en v13

Cadkey, 2025-02-07:
Merci. Je vais vérifier si je n'ai pas oublié de valider quelque part.

Cadkey, 2025-02-08:
Je suis en tests pour les remontées de PTEC et tariffPeriod sur decONZ.
Ce matin, les deux sont remontés en même temps 06:08.
Je n'ai aucun gain, je ne comprends pas.

fairecasoimeme, 2025-02-08:
PTEC est une valeur que l'on peut "poll" uniquement
TariffPeriod est une valeur qui remonte automatiquement dès changement de la valeur sur le Linky
sur deconz si le poll est à la minute vous aurez la meme heure:minute que tariffPeriod
Si vous avez les secondes, normallement tariffPeriod remontera avant

sur Z2M, s'il y a trop de trafic, il est possible que le Poll, même configuré à la minute prenne du retard. Avec tariffPeriod ce ne sera pas le cas.

PS : au cas où vous vous posiez la question, le changement de tarif sur le Linky ne se fait pas à heure fixe

Cadkey, 2025-02-08:
D'accord, je sais que le changement de tarif ne se fait pas à heure fixe. Je peux comparer avec le teleinfo usb, le claquement du contacteur chauffe-eau aussi. Ce matin, plusieurs minutes de retard, pas important sur PTEC, je vais me fier à tariffPeriod, mais mon essai n'a pas été concluant. Je n'exclue pas un problème decONZ, je regarde.
Je n'utilise pas Z2M, uniquement decONZ et son API avec des commandes curl.
Que veut dire 'poll' exactement? et quelles sont les valeurs qui remontent automatiquement? par exemple comment remonte ADPS?
Je compare avec un teleinfo usb, qui lit la trame à 1/2h fixe.

fairecasoimeme, 2025-02-08:
"poll" veut dire que pour obtenir la valeur PTEC, il faut qu'il ait une demande read attribute sur cette valeur pour qu'elle soit retournée.

alors que pour tariffPeriod, la valeur sera envoyée automatiquement par le ZLinky
ADPS remonte aussi automatiquement

Mais pour que ces valeurs remontent automatiquement, il faut qu'elles soient marquées RP dans le tableau https://github.com/fairecasoimeme/Zlinky_TIC?tab=readme-ov-file#mode-historique

ET

Faire un Bind sur le cluster + Config report. Je ne sais pas comment c'est paramétrable sur Deconz

Sur Z2M, c'est fait automatiquement à l'appairage

ScratMan, 2025-02-09:
Je n'ai pas le paramètre LTARF dans les remontées sur Z2M 2.1.1, je suis en FW 16, mode historique. Je vois que LTARF n'est pas listé dans leq paramètres du mode historique, mais mon PTEC ne se met plus à jour sur mon Zlinky depuis vendredi, il reste bloqué sur HPJW.
Mes indexes sont pourtant bien incrementés correctement en heures creuses et heures pleines, en jours blanc vendredi et samedi et bleu aujourd'hui (dimanche).

Comment débloquer le PTEC ? Merci.

Cadkey, 2025-02-09:
Il est possible d'utiliser le cluster pxff66 attribut 0x0010 tariffPeriod, créé depuis la V15 qui remonte les valeurs PTEC/LTARF.

Cadkey, 2025-02-11:
Bonjour,
Un petit retour pour confirmer que tariffPeriod remonte très vite la valeur de PTEC. C'est parfait.
Merci 👍

Closed 2025-02-11.

Thread 328 (2025-02-11):

Changement relevé EAST depuis la MAJ 15

Nivalam, 2025-02-11:
Bonjour,

J'utilise la fonction dérivée de HA pour approximer la puissance instantané du Linky comme décrit ici : https://rdr-it.com/domotique/home-assistant-afficher-sa-consommation-electrique-en-temps-reel-avec-zlinky/

Depuis la MAJ 15 (et 16) sur z2m, ce n'est plus fonctionnel. J'ai l'impression que l'EAST n'est plus remonté toute les minutes et du coup il la dérivée ne marche plus.

Est ce qu'il y a eu une modif qui peut expliquer ça ?

starox, 2025-02-11:
Je suis juste un utilisateur de zlinky. Je me demandais quelle est la différence entre votre solution et le champs SINSTI ?

SckyzO, 2025-03-04:
Tu as bien une data dans EAST ?

Dans la release note il est écrit :

⚠️ Attention sur Z2M, après chaque nouveau appairage, il faut relancer la reconfiguration image plusieurs fois pour que tous les rapports soient pris en compte

SckyzO, 2025-03-04:
> Je suis juste un utilisateur de zlinky. Je me demandais quelle est la différence entre votre solution et le champs SINSTI ?

- EAST (Énergie Active Soutirée Totale) : C'est l'index d'énergie totale consommée par le compteur en Wh (Watt-heures). Cette valeur est cumulative, c'est-à-dire qu'elle augmente continuellement avec le temps au fur et à mesure de la consommation.

- SINSTI (Puissance Apparente Instantanée) : C'est la puissance instantanée consommée à un moment donné, exprimée en VA (Volt-Ampères). Contrairement à EAST, cette valeur est mise à jour en temps réel et donne une indication immédiate de la puissance en cours de consommation.

Différence clé :
- EAST représente une énergie cumulée (en Wh).
- SINSTI représente une puissance instantanée (en VA).

SckyzO, 2025-03-04:
Ouais après je suis d'accord, pourquoi utiliser EAST plutôt que SINSTI ... Bonne question.

Je viens de tester avec SINSTI j'arrive à avoir pareil que le lien que tu mets :

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

Et tu peux même faire un truc mieux c'est avoir la valeur en Kw si tu veux en faisant un truc style, créer un nouveau sensor basé sur sinsti :

Je pense que c'est même mieux, après je me trompe peut etre je débute aussi 😁

```
sensor:
  - platform: template
    sensors:
      consommation_kw:
        friendly_name: "Consommation instantanée (kW)"
        unit_of_measurement: "kW"
        value_template: "{{ (states('sensor.zlinky_sinsti') | int / 1000) | round(2) }}"
```

Gnomuz, 2025-03-26:
Transformer une valeur exprimée en VA en kW par une division par 1000 néglige le facteur de puissance. Si les charges sont très majoritairement résistives, l'approximation sera correcte, mais il y a généralement  un écart de 10-15% dans uns installation résidentielle.

max3163, 2025-03-29:
Mis à part le débat stérile sur la différence entre les Watt et les VA sur de l'alternatif, le problème d'origine a t il une solution.
Je suis également passé au firmware 16 et j'ai une remontée de la valeur EAST ( current_summ_delivered ) qui est mis a jours de manière totalement sporadique… Avec la version 14, c'était très régulièrement ( environ 10 ou 15 seconde ) et je pouvais donc en déduire une conso en Watt assez réaliste.

Pouvez-vous me dire comment rétablir la remontée régulière des informations ? voir comment remettre le firmware 14 ?

SckyzO, 2025-03-30:
> Transformer une valeur exprimée en VA en kW par une division par 1000 néglige le facteur de puissance. Si les charges sont très majoritairement résistives, l'approximation sera correcte, mais il y a généralement  un écart de 10-15% dans uns installation résidentielle.
>

SINSTI te donne la puissance apparente en VA (Volt-Ampères).

kW correspond à la puissance active, celle réellement consommée, et dépend du facteur de puissance (cos φ).

La relation réelle est :

```
P (kW) = S (kVA) × cos(φ)
```

Mais comme on n’a pas le cos φ avec ZLinky, on ne peut pas calculer précisément les kW.

Tu as raison, le facteur de puissance n’est pas pris en compte et ça donne une approximation de la puissance active. Mais pour du suivi visuel simple dans Home Assistant, ça me suffit. Si ZLinky expose un jour le cos φ, je corrigerai.

SckyzO, 2025-03-30:
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

Alors debar stérile je ne suis pas d'accord. Non on est plus intelligent que ça

😁

Moi vu les retours je ne suis pas passé en 16 encore je suis tres bien avec le 14
Je pense qu'en utilisant la fonction de mise a jour local offline de z2m tu dois pouvoir y arriver ?

https://www.zigbee2mqtt.io/guide/usage/ota_updates.html#local-ota-index-and-firmware-files

Nico04, 2025-04-27:
Moi aussi j'utilise Zlinky principalement pour avoir une consommation (presque) instantanée, en utilisant EAST (plus précis). C'était régulier (environ toutes les minutes) sur la 14, et depuis ma mise à jour 16 c'est effectivement irrégulier, toutes les 5 minutes à tous les 15min, voir plus. J'ai déjà fait 3 reset physique du Zlinky, reboot HA plusieurs fois, refait l'appairage, débranche le Zlinky pendant 1 jour... 😭
Une idée ?

Jmi91, 2025-05-04:
Même problème pour moi, j'ai une mise à jour de l'EAST toutes les 3/4 minutes. J'ai essayé en downgradant en v14 mais pas mieux... Il y a t-il une solution ?
Merci

Jmi91, 2025-05-05:
Bon après avoir modifié comme cela ce paramètre:

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

Cela fonctionne toutes les minutes.

Nico04, 2025-05-07:
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

It worked for me, awesome, thanks !

Thread 329 (2025-02-11):

Measurement poll chunk=1 provoque des erreurs de lecture sur FW v16

ScratMan, 2025-02-11:
Bonjour, depuis la mise à jour en v15 puis en v16 j'ai des problèmes de remontée d'infos sur le Zlinky_TIC, le PTEC ne se met plus à jour, sauf à demander la reconfiguration du Zlinky dans Z2M et faire un reset/pairage.
Une fois le PTEC remis à jour sur la valeur, il ne change plus et reste là dessus indéfiniment.

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

Je constate que j'ai beaucoup de warnings sur le Lixee dans les logs de Z2M, indiquant des erreurs de lecture d'attributs (dont le activeRegisterTierDelivered correspondant au PTEC):

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

Que se passe-t-il ?

Merci

ScratMan, 2025-02-12:
J'ai poursuivi mes essais, et il semble que le problème vienne  du paramètre `Measurement poll chunk` qui était à 1, la valeur par défaut. J'ai mis 4, après avoir trouvé l'info dans un autre fil de discussion qu'il semble que ça puisse provoquer des erreurs de lecture.
Depuis les warning sur Lixee ont disparus et le PETC est bien remonté en HPJW ce matin à 6h.
Je vais vérifier ce soir que ça continue bien.

Question : lorsque l'on fait un reset du Zlinky et un nouvel appairage, sans avoir supprimé l'appareil de Z2M ou HA au préalable, est-ce que les paramètres sont remis à leurs valeurs par défaut dans le Zlinky et dans Z2M ? Et d'où le système tire-t-il ses valeurs par défaut ? Du convertisseur Z2M ou du firmware du Zlinky ?

N'y aurait-il pas un mismatch entre les les réglages par défaut de Z2M et du Zlinky qui provoquerait ces problèmes de remontées ?
Je n'avais jamais eu à toucher aux paramètres du Zlinky dans Z2M à part pour choisir le nombre de décimales sur les indexes, et depuis la v15 j'ai l'impression que si je ne fais pas des réécritures des paramètres dans le Zlinky après un pairage, ça ne fonctionne pas correctement.

fairecasoimeme, 2025-02-12:
dans le plugin il y a une coquille car dans le text le measurement poll chunk est à 1 alors que dans le réel il est à 4 par défaut

voir le [Lixee.ts](https://github.com/Koenkk/zigbee-herdsman-converters/blob/master/src/devices/lixee.ts)

ScratMan, 2025-02-12:
Lorsque j'avais mis à jour en v15 et que j'ai rencontré les problèmes de remontées, j'avais regardé dans les paramètres spécifiques dans Z2M et ils étaient vides, j'avais alors remis les valeurs qui étaient indiquées comme étant celles par défaut. C'est peut-être pour ça que c'est resté à 1 par la suite et que ça a continué à dysfonctionner en v16.

Là le PETC est bien passé à HCJW à 22h. Le problème semble résolu.

Closed 2025-02-12.

Thread 336 (2025-03-01):

Zlinky HS après mise à jour v16 ?

looloo06, 2025-03-01:
Bonjour,

J'ai effectué une mise à jour OTA de mon Zlinky (v1) depuis la version 12 vers la version 16 depuis Home Assistant (Z2M).
Une fois la mise à jour terminée, plus de communication avec le Zlinky.
En allant voir ce dernier, la led bleue clignotte régulièrement.
J'ai testé :
- débrancher puis rebrancher le Zlinky
- Retrait ZLinky de Z2M et Reset ZLinky pour réappairage : le Zlinky continue à clignotter après le reset, il est vu et réappairé dans Z2M puis j'ai des erreurs et aucune communication avec le Zlinky.

Y'aurait-il un moyen de réparer cela ?

Merci !

looloo06, 2025-03-01:
Pour compléter, voici l'état dans Z2M après plusieurs tentatives d'interview suivant le reset et réinclusion dans Z2M (et redémarrage de Z2M également) :

{
    "current_tarif": "TEMPO",
    "linkquality": 255,
    "update": {
        "installed_version": 16,
        "latest_version": 16,
        "state": "idle"
    },
    "MOTDETAT": null,
    "active_energy_out_d01": null,
    "active_energy_out_d02": null,
    "active_power": null,
    "active_power_max": null,
    "active_power_ph_b": null,
    "active_register_tier_delivered": null,
    "apparent_power": null,
    "available_power": null,
    "average_rms_voltage_meas_period": null,
    "current_date": null,
    "current_index_tarif": null,
    "current_price": null,
    "current_summ_delivered": null,
    "current_tier1_summ_delivered": null,
    "current_tier2_summ_delivered": null,
    "current_tier3_summ_delivered": null,
    "current_tier4_summ_delivered": null,
    "current_tier5_summ_delivered": null,
    "current_tier6_summ_delivered": null,
    "drawn_v_a_max_n1": null,
    "message1": null,
    "message2": null,
    "meter_serial_number": null,
    "power_threshold": null,
    "relais": null,
    "rms_current": null,
    "rms_current_max": null,
    "rms_voltage": null,
    "schedule_h_p_h_c": null,
    "site_id": null,
    "software_revision": null,
    "status_register": null,
    "tomorrow_color": null,
    "warn_d_p_s": null
}

fairecasoimeme, 2025-03-03:
Depuis la version 14, le principe de clignotement de led a changé.
https://github.com/fairecasoimeme/Zlinky_TIC?tab=readme-ov-file#voyant-lumineux

Closed 2025-03-03.

Thread 342 (2025-04-05):

Remontée triphasée a la place de monophasée

foenyx-dev, 2025-04-05:
Bonjour,

J'ai un problème bizarre avec la remontée d'informations du ZLinky. J'ai déménagé il y a peu et, avant, tout semblait correct dans les informations remontées, c'est-à-dire que je n'avais pas ces informations complémentaires sur les phases A/B/C.

Sur le Linky de mon nouveau logement, j'ai l'impression qu'il détecte le compteur comme étant en triphasé plutôt qu'en monophasé.

J'ai bien vérifié au cas où, mais je suis bien en monophasé. En arrivant dans ce nouveau logement, j'ai demandé le passage au mode standard, ce qui a été fait et vérifié sur l'écran du Linky.

Je viens de mettre à jour le firmware du ZLinky de la v1 à la v16 pour être sûr que cela ne soit pas dû à un bug, mais cela n'y change rien.

Je suis sur ZHA dans Home Assistant.
Le Linky est en monophasé et en mode TIC standard.
La version du ZLinky sur le circuit imprimé est la v2.1.

Voici les métriques remontées par le ZLinky.

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

Que puis-je faire ?

foenyx-dev, 2025-04-12:
J'ai un peu creusé aujourd'hui,
Je suis bien en linky_mode 1 qui correspond au standard monophasé.
Le mystère s'épaissit...

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

foenyx-dev, 2025-04-16:
J'ai acheté la v2 en me disant que peut-être le hardware était défectueux et en fait, même souci.

Soit c'est mon Linky et sa prise TIC qui déconnent sot le soft du ZLinky.

Ou moi qui comprend peut-être rien et que cette phase B soit normale, mais ça paraît étrange.

@fairecasoimeme avez vous un avis ?

fairecasoimeme, 2025-04-16:
Bonjour, Je pense qu'il faut plutôt regarder du côté de ZHA. le Linky ne remonte pas de W mais de VA. Le ZLinky ne remonte pas de puissance autre que la puissance apparente. Vérifiez du côté de vos scripts ZHA ou plug-in

foenyx-dev, 2025-04-17:
Merci pour la réponse, je vais essayer d'aller creuser par là-bas. Je n'utilise pas de script ou de plugin custom, simplement ZHA out of the box.

foenyx-dev, 2025-04-17:
Après quelques recherches j'ai l'impression que c'est effectivement l'intégration [ZHA mise a jour il y a 3 mois](https://github.com/home-assistant/core/blame/cadbb623c75d2af831dbc14de5213da25870da82/homeassistant/components/zha/sensor.py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) qui ajoute cette phase B/C etc...

De ce que je comprend de votre retour ZHA n'a de ce fait jamais fonctionné correctement chez moi car j'avais bien des W sur le sensor puissance.

Du coup, le mapping des sensors sous ZHA est farfelu si je comprend bien.

Si je récapitule :

ZLinky (v1.2 PCB, v16 firmware ou v2 PCB, v16 firmware) ✅ ----> [ZHA quirks](https://github.com/zigpy/zha-device-handlers/blob/dev/zhaquirks/lixee/zlinky.py) (Quirk: zhaquirks.lixee.zlinky.ZLinkyTICFWV15) ✅ ----> [ZHA Sensor](https://github.com/home-assistant/core/blob/dev/homeassistant/components/zha/sensor.py) mapping ❌

Je sais pas trop comment je vais m'en sortir, je vais surement essayer zigbee2mqtt pour comparer, mais j'aimerais que ZHA fonctionne out of the box.

Sinon j'imagine qu'a l'aide du quirk je peux faire mes prorpes sensor ? J'avoue n'avoir encore jamais essayé, je vais explorer cette piste.

Thread 343 (2025-04-15):

ZLinky HS après tentative d'OTA v13 -> v16

Zoddo, 2025-04-15:
J'ai tenté de mettre à jour le firmware de mon ZLinky, actuellement en 4000-0013 vers la v16, via la fonction OTA proposé par Zigbee2MQTT.

Celle-ci a tournée pendant environ 20 minutes, avant d'échouer avec l'erreur suivante :
```
Update of 'Linky' failed (Timeout: device did not request any image blocks)
```

Le device ne remonte alors plus d'info. Après vérification, la LED est bleu fixe (pas de mini-clignotement comme en fonctionnement normal). Je tente alors de débrancher puis rebrancher le ZLinky -> Plus de LED, aucun signe de vie.

J'ai tenté un reset en restant appuyé 10-15 secondes sur le bouton, sans succès.

Je l'ai laissée débranché pendant 24h (j'ai vu dans d'autres issues que le laisser débrancher plusieurs heures avait aidé), sans succès. En le rebranchant, je n'ai toujours aucun signe de vie.

Juste pour être sur que ça ne vient pas de mon Linky, j'ai essayé de le brancher sur le Linky d'un de mes voisins => pas mieux, aucune LED...)

Questions :
* Est-il possible que j'ai brické le ZLinky ? (après coup, je me rend compte que je l'ai rebooté alors que le nouveau firmware doit être moitié écrit...)
* L'OTA fonctionne comment ? Le firmware est réécrit au fur et à mesure qu'il reçoit les données, ou il y a-t-il un système de slots qui permet d'éviter de le bricker en cas d'interruption de l'update ?
* En cas d'échec d'une mise à jour et absence de communications, il y a-t-il d'autres actions à tenter avant de le débrancher/rebrancher ?
* Ai-je une chance de le sauver ? Est-ce que ça vaut le coup que j'achète un module USB TTL pour tenter de le reflasher ?
  - Question subsidière : quelqu'un a déjà testé un flash depuis un PC sous Linux ? (sinon je vais me débrouiller pour mettre la main sur un Windows pour pouvoir lancer l'outil de flash)

vincele, 2025-05-25:
Salut @Zoddo,

je viens de faire la MaJ 13 -> 16, et apparement cela s'est bien passé.

Je l'ai faite via OTA Zigbee2MQTT (dans un conteneur podman), clé usb Sonoff.
Pas de débranchage, ni re-appairage du ZLinky (je ne sais pas si c'est nécessaire)

Je vois dans la page du device:
Firmware version 4000-0016

Thread 345 (2025-06-06):

Mise à jour OTA du firmware de 1 à 16 échoue vers 25%

ygrenzinger, 2025-06-06:
Bonjour,

2nd fois que je fais la tentative de mise à jour du firmware du zlinky_tic v2 de la v1 à v16 et 2nd fois que ça échoue avec zigbee2mqtt qui crash avec l'erreur suivante:
[2025-06-06 06:37:28] error: 	zh:ember:ezsp: ERROR Transaction failure; status=ASH_ERROR_TIMEOUTS. Last Frame: [FRAME: ID=52:"SEND_UNICAST" Seq=68 Len=7].

Je suis nouveau sur Home Assistant donc je ne sais pas si c'est lié à la mise à jour ou à une erreur plus courante qui apparaîtrait au mauvais moment.
Cependant 2 essais et 2 fois au même niveau de progression.

Je tenterais bien une 3ème fois mais j'ai peur de "brick" le device :/

Mon setup:
- Minipc
- Sonoff Z-Dongle E
   - Firmware: 2.4.0
   - Hardware: EmberZNet 7.4.5 [GA]
Le tout sous Proxmox avec VM + HA avec zigbee2mqtt

Si quelqu'un a une idée :)

ygrenzinger, 2025-06-08:
Closing the issue. Updating the firmware to sonoff_zbdonglee_zigbee_ncp_8.0.2.0_115200_sw_flow.gbl fixed everything
