fairecasoimeme/Zlinky_TIC/(commit log)

2021-09-27 add LED doc
2021-10-06 Add timer for blinking LED
2021-10-06 Fix LED IO & Invert HCHP / HPHC
    [App_Linky.c]
2021-10-22 final device
2021-11-02 Add identify led blinking
2021-11-03 changement de version
2022-01-04 Fix LED bug
2022-01-04 Fix linky data structure
    date: char* 10 -> 13
    LinkyMIAvailablePower : uint16 -> uint8
    au8LinkyMISoftwareRevision : uint16 -> uint8
    HHPHC : -> char
    [App_Linky.c]
2022-01-04 Fix meter_identification data type
    [meter_identification.c, meter_identification.h]
2022-01-04 fix index data type
    uint32(0x23) -> uint48(0x25)
    [App_Linky.c]
2022-01-10 Fix DATE value issue
    [app_uartlinky.c]
2022-01-11 Fix RAZ ADPS and ADD alarm for STGE update
    [App_Linky.c]
2022-02-17 fix ADPS RAZ bug
    [App_Linky.c]
2022-08-30 Fix data type for PJOUR+1 and PPOINTE
    [LixeeCluster.c, LixeeCluster.h]
2022-08-30 Fix size to max as possible
    [App_Linky.c]
2022-09-16 Add linky timer acquisition parameter
    Add new parameter
    Add function to save and load parameter
2022-09-16 Add new attribut for Linky acquisition timer
2022-09-16 Add write attributes function
    Add function to save Linky acquisition timer to flash for Write attribute command
    Change versionning
2022-09-16 Add blinking led for permit join state
2022-09-20 Fix blocking timer
    when there is Linky acquisition, the serial loop blocked the timer interrupt. Add ZTIMER_vTask() in the loop fix the issue
    [App_Linky.c]
2022-10-24 Update LED management
    Update LED management to reduce consumption when all is ok (LED ON)
2022-11-21 Add main voltage infos
    Clusters 0x0001 :
    - Attribut 0x0000 (mains voltage)
    - Attribut 0x0011 (mains voltage min treshold)
    - Attribut 0x0012 (mains voltage max treshold)
2022-11-21 Add power configuration
2022-11-21 Add voltage driver
    add ADC management
2022-11-21 Add voltage driver to Makefile
2022-11-22 fix duplicate voltage acquisition
    [App_Linky.c]
2023-02-14 fix MOTDETAT
    This reverts commit d0c37bc5a6b3f8955c602464bd32e4655f422b46.
    [LixeeCluster.c]
2024-04-24 Add Tuya partial compatibility
    the device is view as PC321-Z-TY device on Tuya platform
2024-04-24 Desactive led at startup
2024-04-24 Change UART LINKY decoding to work with ENEDIS labellisation
2024-04-24 Change LED Blink to work with ENEDIS Labellisation
    * Slow blinking LED (3 sec) --> Linky OK
    * Fast blinking LED (1 sec) --> Linky NOK
    * No LED --> Linky NOK
2024-04-24 change LED timer
2024-04-24 change default periodic acquisition timer
2024-08-07 fix magic number error
    [App_Linky.c, app_zcl_task.c]
2024-08-07 Fix datas calculation error
    [TuyaSpecific.c]
2025-01-25 Add LIDL compatibility device ID
2025-01-25 fix Tuya total apparent power
    [TuyaSpecific.c]
2025-01-25 add networkState info
    no linky acquisition if device is not in network
2025-02-06 fix acquisition after update
    [App_Linky.c]
2025-02-06 fix datatype for tuya
    [TuyaSpecific.c]
2025-09-23 Add Alarm and new values for tuya + Fix mode stability
    [App_Linky.c, App_Linky.h, TuyaSpecific.c, TuyaSpecific.h, TuyaSpecificCommandHandler.c]
2025-09-23 Fix type for some attributes
    * SINSTI
    * SMAXIN
    * SMAXIN_1
    * CCAIN
    * CCAIN_1
    [LixeeCluster.c, LixeeCluster.h]
2025-09-23 LED on on startup & fix bug
    [app_router_node.c]
